swaroopsahoo4908/GTR70E-WYVERN/3D parts/assembly/FIT_REPORT.md

# Fit check report

_Generated by `3D parts/_generator/gen_fit_assembly.py`. Assembly: `GTR70E_WYVERN_fit_assembly.step`. Render: `Documentation/diagrams/D6_fit_check.png`._

50 components: every printed part, plus vendor STEP models where a public one exists and datasheet-built models where it does not.

## Interference

No interference faults.

Designed contacts (glands, seats): none

## Tightest radial clearance to the bore (radius 27.4 mm)

| part | outermost radius (mm) | clearance (mm) |
|---|---|---|
| arm_button_6mm | 28.75 | -1.35 |
| arm_led_3mm | 28.54 | -1.14 |
| pololu_2810_switch | 27.30 | 0.10 |
| lipo_2S_450 | 26.22 | 1.18 |
| servo_horn_az0 | 25.87 | 1.53 |
| servo_horn_az90 | 25.87 | 1.53 |
| servo_horn_az180 | 25.87 | 1.53 |
| servo_horn_az270 | 25.87 | 1.53 |
| EMAX_ES9251II_az0 | 24.93 | 2.47 |
| EMAX_ES9251II_az90 | 24.93 | 2.47 |

## Control fins swept about the hinge

| deflection | overlap with tube / stabilizers |
|---|---|
| -15° | 0.0 mm³ |
| -10° | 0.0 mm³ |
| -5° | 0.0 mm³ |
| +5° | 0.0 mm³ |
| +10° | 0.0 mm³ |
| +15° | 0.0 mm³ |

## Print bed (256 x 256 x 256 mm)

| part | bounding box (mm) | fits |
|---|---|---|
| 01_nose_tangent_ogive_150_ASAAero | 185.0 x 58.0 x 58.0 | yes |
| 02_recovery_bay_tube_ASAAero | 250.0 x 58.0 x 58.0 | yes |
| 03_rb_floor_coupler_PCFR | 54.4 x 54.4 x 40.0 | yes |
| 04_control_tube_servo_ring_ASAAero | 174.0 x 58.0 x 58.0 | yes |
| 05_spine_deck_PETGCF | 54.4 x 54.4 x 5.5 | yes |
| 05b_avionics_spine_PETGCF | 97.0 x 54.4 x 54.4 | yes |
| 06_servo_hub_PETGCF_x4 | 13.0 x 13.0 x 10.2 | yes |
| 07_motor_bay_tube_ASAAero | 139.0 x 58.0 x 58.0 | yes |
| 08_plenum_bulkhead_PCFR | 54.4 x 54.4 x 26.0 | yes |
| 09_motor_mount_tube_aft_ring_PCFR | 87.0 x 54.4 x 54.4 | yes |
| 10_motor_retainer_cap_PCFR | 62.4 x 62.4 x 11.0 | yes |
| 12_rect_fin_PETGCF_x4 | 81.0 x 24.5 x 24.5 | yes |
| 13_rail_button_1010_printed_PETGCF_x2 | 14.9 x 14.0 x 12.7 | yes |
| 14_bypass_tube_PCFR | 200.0 x 9.5 x 9.5 | yes |
| WTA_calibration_pulley_bracket_PETG | 70.0 x 40.0 x 30.0 | yes |
| WTA_calibration_pulley_wheel_PETG | 30.0 x 30.0 x 6.0 | yes |
| WTA_diffuser_100sq_to_6in_round_PETG | 190.0 x 158.4 x 158.4 | yes |
| WTA_hub_gear40_m1_PETGCF | 42.0 x 42.0 x 22.6 | yes |
| WTA_inclined_manometer_lid_PETG | 44.0 x 44.0 x 16.0 | yes |
| WTA_inclined_manometer_ramp_PETG | 242.0 x 44.0 x 32.0 | yes |
| WTA_reflection_plane_wall_panel_PETG | 175.0 x 100.0 x 4.0 | yes |
| WTA_sensor_gear20_m1_PETGCF | 21.8 x 21.8 x 9.0 | yes |
| WTA_servo_balance_cradle_PETG | 90.0 x 59.1 x 33.3 | yes |
| WTB_slot_plug_x8_PETG | 30.0 x 5.6 x 2.4 | yes |
| WTB_stabilizer_blade_span20_PETGCF_x4 | 81.0 x 22.0 x 2.4 | yes |
| WTB_stabilizer_blade_span30_PETGCF_x4 | 81.0 x 32.0 x 2.4 | yes |
| WTB_stabilizer_blade_span40_PETGCF_x4 | 81.0 x 42.0 x 2.4 | yes |
| WTB_stabilizer_tail_section_ASA | 142.0 x 58.0 x 58.0 | yes |
| WT_adapter_228sq_to_200sq_x2_PETG | 228.0 x 228.0 x 12.0 | yes |
| WT_diffuser_200sq_to_8in_round_PETG | 213.0 x 213.0 x 150.0 | yes |
| WT_nose_fairing_ogive100_ASA | 120.0 x 58.0 x 58.0 | yes |
| WT_strut_fairing_ASA | 110.0 x 40.0 x 7.4 | yes |
| WT_tail_fairing_sting_socket_ASA | 100.0 x 58.0 x 58.0 | yes |
| cfin_NACA0006_H20_PETGCF | 60.0 x 18.6 x 10.0 | yes |
| cfin_NACA0006_H25_PETGCF | 60.0 x 23.3 x 10.0 | yes |
| cfin_NACA0006_H30_PETGCF | 60.0 x 27.9 x 10.0 | yes |
| cfin_NACA0006_H35_PETGCF | 60.0 x 32.6 x 10.0 | yes |
| cfin_NACA0006_H40_PETGCF | 60.0 x 37.2 x 10.0 | yes |
| cfin_NACA0006_H45_PETGCF | 60.0 x 41.9 x 10.0 | yes |

## Where each bought-part model came from

| component | source |
|---|---|
| control_fin_az0 | printed |
| control_fin_az90 | printed |
| control_fin_az180 | printed |
| control_fin_az270 | printed |
| EMAX_ES9251II_az0 | datasheet-built (18.02 x 7.91 x 16.8, ears 25.4, VERIFY) |
| servo_horn_az0 | datasheet-built (single-arm horn, in hub pocket) |
| EMAX_ES9251II_az90 | datasheet-built (18.02 x 7.91 x 16.8, ears 25.4, VERIFY) |
| servo_horn_az90 | datasheet-built (single-arm horn, in hub pocket) |
| EMAX_ES9251II_az180 | datasheet-built (18.02 x 7.91 x 16.8, ears 25.4, VERIFY) |
| servo_horn_az180 | datasheet-built (single-arm horn, in hub pocket) |
| EMAX_ES9251II_az270 | datasheet-built (18.02 x 7.91 x 16.8, ears 25.4, VERIFY) |
| servo_horn_az270 | datasheet-built (single-arm horn, in hub pocket) |
| bno085 | vendor STEP adafruit_4754_bno085.step |
| pico2w | datasheet-built 51 x 21 mm Pico 2 W (Raspberry Pi datasheet) |
| bme688 | vendor STEP adafruit_5046_bme688.step |
| bmp388 | vendor STEP adafruit_5046_bme688.step (same outline as the 3966) |
| microsd | vendor STEP adafruit_4682_microsd.step |
| lipo_2S_450 | datasheet-built 57 x 30 x 14 (VERIFY on the owned pack) |
| perfboard_16x62 | datasheet-built FR4 0.1 in perf |
| adafruit_MPM3610_buck | vendor STEP adafruit_4739 (Adafruit_CAD_Parts), logic rail |
| adafruit_MPM3610_buck_servo | vendor STEP adafruit_4739, servo rail (rev 3f) |
| cap_470uF_under_board | datasheet-built 6.3 x 11 mm, under the perfboard |
| pololu_2810_switch | vendor STEP pololu_2810, in the CT wall cradle under the slot |
| arm_button_6mm | datasheet-built 6 x 6 tactile (Adafruit 367), plunger 0.3 mm under the skin |
| arm_led_3mm | datasheet-built 3 mm LED (SparkFun COM-00533) |
| AeroTech_F42-4T | datasheet-built 29 x 83 mm (thrustcurve.org) |
| chute_24in_packed | datasheet-built (Estes 24 in rip-stop, packed 46 x 95, VERIFY) |
| shock_cord_bundle | datasheet-built 19 ft aramid, z-folded |
| nose_ballast_pour | 253 g steel shot + epoxy, fills 66 mm of the tip |

Nose ballast (253 g steel shot + epoxy at ~5 g/cm³) fills the first 66 mm of the tip cavity.
