swaroopsahoo4908/GTR70E-WYVERN/Documentation/CANONICAL_NUMBERS.md

# GTR70E WYVERN fin-control — canonical numbers

_Generated by `Documentation/gen_canonical_md.py` from the simulation outputs. Do not edit by hand; re-run the cascade (root README)._

## Vehicle

| | value |
|---|---|
| Overall length / OD | 693 mm / 58 mm |
| Sections | nose 150 · recovery bay 250 · control tube 174 · motor bay 119 mm |
| Liftoff / burnout (F42-4T) | 785 g / 758 g |
| Printed parts / ballast | 289 g / 253 g |
| CG liftoff / burnout | 338 / 327 mm |
| CP (interference counted) | 422 mm |
| Static margin liftoff / burnout | 1.44 / 1.63 cal (no interference: 1.63) |
| Pitch inertia | 0.0501 kg m² |
| Control hinge A / B (station) | 534 / 534 mm; arm aft of CG 196 / 196 mm |
| Control fins | triangular, root 60 mm, hinge 45 % chord, H* = 45 mm, ±15° |
| Stabilizers (fixed fins) | 4 x 81 x 20 x 2.4 mm at 45° |
| Servo | EMAX ES9251 II, base r = 5.0 mm, spline tip r = 24.8 mm |
| Bypass tube | 9.5 x 7.5 mm printed PC-FR, 200 mm, 6.4 g, on the vehicle centreline |

## Flight (F42-4T, 4 m/s wind + 4 m/s gust)

| | control on | fins locked |
|---|---|---|
| Rail exit speed (6 ft) | 15.0 m/s | 15.0 m/s |
| Burnout speed | 53 m/s | 53 m/s |
| Max q | 1808 Pa | 1824 Pa |
| Apogee | 176 m | 174 m |
| Time to apogee | 6.34 s | 6.32 s |
| RMS tilt rail exit → burnout+2 s | 0.6° | 10.8° |
| Max tilt | 1.3° | 16.0° |
| Drift at apogee | 19 m | -15 m |
| Peak hinge moment | 0.002 N m | 0.004 N m |

T/W 4.68 avg / 8.45 peak · ideal delay 4.87 s → pick 4 s · gains {'kp': 4.5, 'ki': 1.0, 'kd': 0.8, 'q_ref': 1500.0, 'k_min': 0.15, 'k_max': 4.0}

## Motor options (all 29 x 83 mm single-use, no certification)

| motor | impulse (N s) | liftoff (g) | rail exit (m/s) | apogee (m) | RMS tilt on / locked | delay pick | cost note |
|---|---|---|---|---|---|---|---|
| F67-6W | 61.1 | 789 | 17.9 | 232 | 0.7° / 7.9° | 6 s | $49.49 per 2-pack (eRockets, mailable, no hazmat) -> 4 motors $98.98 |
| F42-4T | 52.9 | 785 | 15.0 | 176 | 0.6° / 10.8° | 4 s | New Century $43.99 was sold out) -> 4 motors $98.98 |
| G74-6W | 82.8 | 796 | 17.2 | 370 | 0.8° / 7.3° | 9 s | price not found online (reference only) |

## Control authority (NACA 0006, pessimistic interference)

| H (mm) | interference | Cmδ isolated | Cmδ installed A | Cmδ installed B | RMS tilt (sim) |
|---|---|---|---|---|---|
| 15 | -0.188 | 1.88 | 1.38 | 1.38 | 0.1° |
| 20 | -0.168 | 3.23 | 2.46 | 2.46 | 0.3° |
| 25 | -0.150 | 4.81 | 3.78 | 3.78 | 0.4° |
| 30 | -0.135 | 6.57 | 5.30 | 5.30 | 0.5° |
| 35 | -0.121 | 8.47 | 6.99 | 6.99 | 0.5° |
| 40 | -0.109 | 10.48 | 8.83 | 8.83 | 0.5° |
| 45 | -0.099 | 12.58 | 10.79 | 10.79 | 0.5° |
| 50 | -0.089 | 14.74 | 12.84 | 12.84 | 0.5° |

Selection: {'H_star_open_loop': 40.0, 'H_star_closed_loop': 20.0, 'flight_heights': [35.0, 40.0, 45.0], 'monotonic': True}

## Electronics

| | |
|---|---|
| Pad idle / flight current | 73 mA / 306 mA |
| Mission charge / derated requirement / pack | 35.4 / 65 / 450 mAh (6.9x) |
| Telemetry | none in flight (rev 4): microSD (Adafruit 4682 on the Pico 2 W) is the only record; USB CSV on the pad |

## Ejection (chosen tube)

0.3 g BP: bay 178 kPa → 419 N push vs 235 N release; plenum 1413 kPa, kick-out 933 N

0.5 g BP: bay 337 kPa → 796 N push vs 235 N release; plenum 2443 kPa, kick-out 1613 N

## SQ1: stabilizer span and azimuth (H = 40, F42-4T, pessimistic interference)

| offset | span (mm) | margin liftoff (cal) | interference | installed / isolated | RMS tilt active / locked |
|---|---|---|---|---|---|
| 0° | 20 | 1.10 | -0.245 | 0.65 | 0.5° / 10.8° |
| 22.5° | 20 | 1.34 | -0.144 | 0.79 | 0.5° / 11.2° |
| 45° | 0 | 0.98 | 0.000 | 1.00 | 0.2° / 9.5° |
| 45° | 20 | 1.44 | -0.099 | 0.86 | 0.5° / 11.3° |
| 45° | 30 | 1.88 | -0.176 | 0.74 | 1.0° / 12.9° |
| 45° | 40 | 2.32 | -0.246 | 0.64 | 4.3° / 13.6° |
| 45° | 45 | 2.52 | -0.275 | 0.60 | 6.9° / 13.8° |
| 45° | 50 | 2.69 | -0.299 | 0.56 | 9.1° / 14.2° |
| 45° | 55 | 2.85 | -0.320 | 0.53 | 11.0° / 14.6° |
| 45° | 60 | 2.98 | -0.338 | 0.50 | 12.6° / 15.1° |

Tunnel Phase B prediction (one pair at 10°, 7 m/s): H35 off 37.1 mN, span20 32.6 mN, span30 29.3 mN, span40 26.6 mN; H40 off 45.1 mN, span20 40.1 mN, span30 36.4 mN, span40 33.2 mN; H45 off 53.4 mN, span20 48.1 mN, span30 43.9 mN, span40 40.2 mN
