swaroopsahoo4908/GTR70E-WYVERN/TVC ARCHIVED/Past Iterations/WYVERN-E 1.0/Wind Tunnel/WYVERN_wind_tunnel_spec.html.pdf.md

---
source_file: "WYVERN_wind_tunnel_spec.html.pdf"
source_type: "PDF"
updated_at: 2026-05-26
---
# WYVERN_wind_tunnel_spec.html

*Extracted from [[WYVERN_wind_tunnel_spec.html.pdf]]*

---

S K Y L I G H T I N D U S T R I E S L LC · C O N F I D E N T I A L · P R O P R I E TA RY · N O T F O R D I S T R I B U T I O N

    XRIM-117 WYVERN PTD — Dedicated Aerodynamic Ground Test
    Facility
    Open-return low-speed wind tunnel · Full 3D-printed · Designed for 1:3 scale PTD PDR-002 Rev A test articles

    Programme: PDR-002 Rev A                 Test scale: 1:3 geometric             Fan: AC Infinity Cloudline T8             Contraction: 9:1

    Test section: 150 × 150 × 500 mm                 OAL: 2,468 mm

        Overview             Module specs               Aerodynamics                Contraction profile                Print plan         BOM & cost

    C R ITI C A L D I M E N S I O N S

       Test section (H × W × L)                               Test section area                                       Contraction ratio

       150 × 150 × 500 mm                                     225 cm²                                                 9 : 1

       Settling chamber                                       Test section velocity                                   Dynamic pressure q

       450 × 450 mm                                           7.3 m/s (24 ft/s)                                       33.0 Pa

       Fan                                                    Flow rate (loaded est.)                                 Contraction cone length

       AC Infinity T8 (200 mm)                                350 CFM / 0.165 m³·s⁻¹                                  900 mm

       Diffuser length                                        Full tunnel OAL                                         Wall thickness (all modules)

       220 mm (4° half-angle)                                 2,468 mm (2.47 m)                                       3.0 mm PETG-CF

       Module OD                                              Junction ring OD                                        Honeycomb cell

       156 × 156 mm                                           176 mm                                                  4 mm hex, L/d = 7

       Screen set                                             Smoke ports                                             Bell-mouth lip radius

       20-mesh + 80-mesh                                      3 × 3 grid, 50 mm pitch                                 180 mm
       stainless

       Est. turbulence intensity                              Total print mass                                        Estimated filament cost

       ~0.21 %                                                ~4,109 g (4.1 kg)                                       ~$115 USD

    T U N N E L L AYO U T — S I D E E L EVATI O N

             Bell   Cond.
                        Contraction 900mm Test section 500mm Diff.Fan

                                                                                                                                                     exhaust

          100 mm

Explore our developer-friendly HTML to PDF API                                                                       Printed using PDFCrowd            HTML to PDF

    B LO C K AG E S U M M A RY ( 1 : 3 S C A L E M O D E L , 1 5 0 × 1 5 0 M M T E ST S E C TI O N )

      TEST ARTICLE                                                  FRONTAL AREA                BLOCKAGE         STATUS

      Nose cone on sting (body only)                                4.28 cm²                    1.9 %              No correction

      Single fin panel — half-span wall mount                       5.44 cm²                    2.4 %              No correction

      Ring 2 assembly + body stub                                   6.97 cm²                    3.1 %              No correction

      Ring 1 assembly + body stub                                   15.17 cm²                   6.7 %              Maskell correction

      Full rocket, 0° AoA (both rings)                              17.82 cm²                   7.9 %              Maskell correction

      Full rocket, 45° roll                                         ~23.6 cm²                   ~10.5 %            Visualization only

       The 150 × 150 mm test section resolves the primary limitation of the source STEM tunnel (80 × 130 mm, 37%
       blockage at 1:1). The full-rocket at 0° AoA now sits at 7.9% — within the Maskell-correctable range. At 1:3 scale,
       body OD = 23.3 mm, Ring 1 fin span = 23.3 mm, OAL = 390 mm.

Explore our developer-friendly HTML to PDF API                                                         Printed using PDFCrowd           HTML to PDF
