swaroopsahoo4908/GTR70E-WYVERN/TVC ARCHIVED/Flight Computer/02_RRC3_Telemetry_Logging.md

# GTR70E WYVERN, Recovery Telemetry

Recovery runs entirely on the F15-4 motor's own ejection charge, separating the two body tubes at
the bulkhead joint — see `Documentation/WYVERN_E4_Recovery.md`. There is no altimeter, no e-match,
no black-powder charge of our own, and no CO2 system. The flight computer does not actuate recovery
at all; it only logs baro/IMU through the event and streams WiFi telemetry.

*(This file is retained as a redirect; the storage mount blocks deletion from the tool sandbox.)*
