swaroopsahoo4908/GTR70E-WYVERN/TVC ARCHIVED/Flight Computer/_All Files.md

---
updated_at: 2026-08-02
---
# Flight Computer, All Files

*Auto-generated index, every file and subfolder linked for vault graph connectivity.*

---

## Subfolders

- [[Projects/Skylight/WYVERN/GTR70E WYVERN/WYVERN Project/Flight Computer/BOM/_All Files.md|BOM/]]
- [[Projects/Skylight/WYVERN/GTR70E WYVERN/WYVERN Project/Flight Computer/firmware/_All Files.md|firmware/]]
- [[Projects/Skylight/WYVERN/GTR70E WYVERN/WYVERN Project/Flight Computer/flowcharts/_All Files.md|flowcharts/]]
- [[Projects/Skylight/WYVERN/GTR70E WYVERN/WYVERN Project/Flight Computer/ground_test_rigs/_All Files.md|ground_test_rigs/]]
- [[Projects/Skylight/WYVERN/GTR70E WYVERN/WYVERN Project/Flight Computer/test_code/_All Files.md|test_code/]]
- [[Projects/Skylight/WYVERN/GTR70E WYVERN/WYVERN Project/Flight Computer/wiring/_All Files.md|wiring/]]

## Files

- [[Projects/Skylight/WYVERN/GTR70E WYVERN/WYVERN Project/Flight Computer/01_FlightComputer_Spec.md]]
- [[Projects/Skylight/WYVERN/GTR70E WYVERN/WYVERN Project/Flight Computer/02_RRC3_Telemetry_Logging.md]]
- [[Projects/Skylight/WYVERN/GTR70E WYVERN/WYVERN Project/Flight Computer/README.md]]
