swaroopsahoo4908/GTR70E-WYVERN/TVC ARCHIVED/Flight Computer/flowcharts/_All Files.md

---
updated_at: 2026-08-02
---
# flowcharts, All Files

*Auto-generated index, every file and subfolder linked for vault graph connectivity.*

---

## Files

- [[Projects/Skylight/WYVERN/GTR70E WYVERN/WYVERN Project/Flight Computer/flowcharts/01_flight_state_machine.mermaid]]
- [[Projects/Skylight/WYVERN/GTR70E WYVERN/WYVERN Project/Flight Computer/flowcharts/02_tvc_control_loop.mermaid]]
- [[Projects/Skylight/WYVERN/GTR70E WYVERN/WYVERN Project/Flight Computer/flowcharts/03_recovery_logic.mermaid]]
- [[Projects/Skylight/WYVERN/GTR70E WYVERN/WYVERN Project/Flight Computer/flowcharts/04_power_tree.mermaid]]
