swaroopsahoo4908/GTR70E-WYVERN/TVC ARCHIVED/Past Iterations/WYVERN-E 1.0/_All Files.md

---
updated_at: 2026-07-30
---
# WYVERN-E 1.0 — All Files

*Auto-generated index — every file in this folder linked for vault graph connectivity (re-index pass, 2026-07-30).*

---

## Linked Items (auto-added)

- [[Projects/Skylight/WYVERN/Past Iterations/WYVERN-E 1.0/CAD:Models:PCB/_All Files.md]]
- [[Projects/Skylight/WYVERN/Past Iterations/WYVERN-E 1.0/Docs:Decks/_All Files.md]]
- [[Projects/Skylight/WYVERN/Past Iterations/WYVERN-E 1.0/README.md]]
- [[Projects/Skylight/WYVERN/Past Iterations/WYVERN-E 1.0/Simulations/_All Files.md]]
- [[Projects/Skylight/WYVERN/Past Iterations/WYVERN-E 1.0/Wind Tunnel/_All Files.md]]
- [[Projects/Skylight/WYVERN/Past Iterations/WYVERN-E 1.0/_OLD FILES/_All Files.md]]
