swaroopsahoo4908/GTR70E-WYVERN/TVC ARCHIVED/Past Iterations/WYVERN-E-Old PCB/Info_PCB_PCB1_2026-08-08.txt

Project Title: 		WYVERN-E
Borard Title: 		Board1
PCB Title: 		PCB1
Time: 		2026-08-08 22:19:53

Borard Size: 		90mm x 90mm
Layers: 		Total 24, Copper 4

Devices: 		55
Footprints: 		38
Components: 		Total 107,Top Layer 107,Bottom Layer 0
Pads: 		Total 595, Top Side Table Stick 526,Bottom Side Table Stick 0,Metallized Hole 69, Nonmetallic Hole 0
Nets: 		Total 108, Unrouted 0
Test Point: 		Nets Total 108, Has Testpoint Nets 0, Testpoint Coverage 0%
 		Total 0, Top Side Testpoints 0, Bottom Side Testpoints 0

Slot Region: 		5
Vias: 		Total 260, Through Vias 260, Blind Or Buried Vais 0
CopperAreas: 		0
Length of Tracks: 		5405.554mm
