swaroopsahoo4908/GTR70E-WYVERN/TVC ARCHIVED/Past Iterations/WYVERN-E-Old PCB/Info_PCB_PCB1_2026-08-09.txt

Project Title: 		WYVERN-E 1.0
Borard Title: 		Board1
PCB Title: 		PCB1
Time: 		2026-08-09 11:48:04

Borard Size: 		60mm x 60mm
Layers: 		Total 22, Copper 2

Devices: 		29
Footprints: 		23
Components: 		Total 39,Top Layer 39,Bottom Layer 0
Pads: 		Total 266, Top Side Table Stick 227,Bottom Side Table Stick 0,Metallized Hole 39, Nonmetallic Hole 0
Nets: 		Total 38, Unrouted 0
Test Point: 		Nets Total 38, Has Testpoint Nets 0, Testpoint Coverage 0%
 		Total 0, Top Side Testpoints 0, Bottom Side Testpoints 0

Slot Region: 		4
Vias: 		Total 86, Through Vias 86, Blind Or Buried Vais 0
CopperAreas: 		0
Length of Tracks: 		1452.842mm
