swaroopsahoo4908/GTR70E-WYVERN/TVC ARCHIVED/Past Iterations/WYVERN-E-Old PCB/Info_PCB_PCB1_2026-08-11.txt

Project Title: 		GTR70E WYVERN 1.0
Borard Title: 		Board1
PCB Title: 		PCB1
Time: 		2026-08-11 23:46:51

Borard Size: 		61mm x 61mm
Layers: 		Total 22, Copper 2

Devices: 		33
Footprints: 		26
Components: 		Total 61,Top Layer 61,Bottom Layer 0
Pads: 		Total 315, Top Side Table Stick 277,Bottom Side Table Stick 0,Metallized Hole 38, Nonmetallic Hole 0
Nets: 		Total 49, Unrouted 0
Test Point: 		Nets Total 49, Has Testpoint Nets 0, Testpoint Coverage 0%
 		Total 0, Top Side Testpoints 0, Bottom Side Testpoints 0

Slot Region: 		8
Vias: 		Total 150, Through Vias 150, Blind Or Buried Vais 0
CopperAreas: 		0
Length of Tracks: 		2254.998mm
