swaroopsahoo4908/GTR70E-WYVERN/TVC ARCHIVED/Past Iterations/WYVERN-E 1.0/CAD:Models:PCB/_All Files.md

---
updated_at: 2026-05-27
---
# CAD:Models:PCB — All Files

*Complete index of all files in `Projects/WYVERN-E/CAD:Models:PCB/`. Auto-generated — every file [[wikilinked]] for Obsidian graph connectivity.*

---

**Total files: 11**

## PDF Documents (2)

- [[WYVERN_Engineering_Analysis.pdf]] → [[WYVERN_Engineering_Analysis.pdf.md]]
- [[XRIM117_PCB_Layouts_html.pdf]] → [[XRIM117_PCB_Layouts_html.pdf.md]]

## Markdown Notes (3)

- [[WYVERN_Engineering_Analysis.pdf.md]]
- [[WYVERN_Simulator.md]]
- [[XRIM117_PCB_Layouts_html.pdf.md]]

## HTML Files (1)

- [[XRIM117_PCB_Layouts.html]]

## SVG Images (2)

- [[xrim117_avionics_v4.svg]]
- [[xrim117_jetavane_tvc.svg]]

## ZIP Archives (1)

- [[XRIM117_all_parts.zip]]

## ORK Files (1)

- [[XRIM117_PTD_PDR002_70mm.ork]]

## STL Files (1)

- [[XRIM117_PTD_PDR002_70mm.stl]]

## Linked Items (auto-added)

- [[Projects/Skylight/WYVERN/Past Iterations/WYVERN-E 1.0/CAD:Models:PCB/CCM_KiCAD/_All Files.md]]
- [[Projects/Skylight/WYVERN/Past Iterations/WYVERN-E 1.0/CAD:Models:PCB/XRIM117E_KiCAD_RevC/_All Files.md]]
- [[Projects/Skylight/WYVERN/Past Iterations/WYVERN-E 1.0/CAD:Models:PCB/XRIM117E_PDR003_127mm.ork]]
- [[Projects/Skylight/WYVERN/Past Iterations/WYVERN-E 1.0/CAD:Models:PCB/XRIM117E_PDR003_127mm_F15.ork]]
- [[Projects/Skylight/WYVERN/Past Iterations/WYVERN-E 1.0/CAD:Models:PCB/XRIM117E_PDR003_127mm_FLIGHT.ork]]
- [[Projects/Skylight/WYVERN/Past Iterations/WYVERN-E 1.0/CAD:Models:PCB/XRIM117E_PDR004_FULL.ork]]
- [[Projects/Skylight/WYVERN/Past Iterations/WYVERN-E 1.0/CAD:Models:PCB/XRIM117E_PDR004_TVC_ONLY.ork]]
- [[Projects/Skylight/WYVERN/Past Iterations/WYVERN-E 1.0/CAD:Models:PCB/XRIM117E_booster_cluster_ring_3x29mm.stl]]
- [[Projects/Skylight/WYVERN/Past Iterations/WYVERN-E 1.0/CAD:Models:PCB/XRIM117E_camera_pod_fairing.stl]]
- [[Projects/Skylight/WYVERN/Past Iterations/WYVERN-E 1.0/CAD:Models:PCB/XRIM117_EasyEDA_v3/_All Files.md]]
- [[Projects/Skylight/WYVERN/Past Iterations/WYVERN-E 1.0/CAD:Models:PCB/XRIM117_KiCAD_RevB/_All Files.md]]
- [[Projects/Skylight/WYVERN/Past Iterations/WYVERN-E 1.0/CAD:Models:PCB/XRIM117_PCB_Layouts.html]]
- [[Projects/Skylight/WYVERN/Past Iterations/WYVERN-E 1.0/CAD:Models:PCB/XRIM117_PTD_PDR002_70mm.ork]]
- [[Projects/Skylight/WYVERN/Past Iterations/WYVERN-E 1.0/CAD:Models:PCB/XRIM117_PTD_PDR002_70mm.stl]]
- [[Projects/Skylight/WYVERN/Past Iterations/WYVERN-E 1.0/CAD:Models:PCB/XRIM117_all_parts.zip]]
- [[Projects/Skylight/WYVERN/Past Iterations/WYVERN-E 1.0/CAD:Models:PCB/XRIM117_all_parts/_All Files.md]]
- [[Projects/Skylight/WYVERN/Past Iterations/WYVERN-E 1.0/CAD:Models:PCB/_All Files.md]]
