swaroopsahoo4908/GTR70E-WYVERN/TVC ARCHIVED/Past Iterations/WYVERN-E 1.0/Docs:Decks/XRIM117_PTD_PDR002_RevA_70mm.docx.md

---
source_file: "XRIM117_PTD_PDR002_RevA_70mm.docx"
source_type: "DOCX"
updated_at: 2026-05-26
---
# XRIM117_PTD_PDR002_RevA_70mm

*Extracted from [[XRIM117_PTD_PDR002_RevA_70mm.docx]]*

---

**XRIM-117 WYVERN**

EXTENDED CALIBER PROTOTYPE TECHNOLOGY DEMONSTRATOR

**PDR-002 \| Revision A**

*70mm Rail-Launch Guided Demonstrator*

TVC + Active Mid Fins + Passive Aft Stabilizers + 3-PCB Distributed Avionics + 915MHz Datalink

**Skylight Industries LLC**

**CONFIDENTIAL --- PROPRIETARY --- NOT FOR DISTRIBUTION**

1\. Overview & Design Philosophy

The XRIM-117 WYVERN Extended Caliber Prototype Technology Demonstrator (PDR-002 Rev A) is a 70mm-diameter, rail-launch experimental rocket developed by Skylight Industries LLC to validate the core aeromechanical and guidance architecture of the full-scale XRIM-117 WYVERN interceptor at a scale larger and more capable than the 56mm PDR-001 platform.

The vehicle is designed exclusively for 1010/80-20 aluminum extrusion rail launch in near-vertical orientation. Rail launch provides controlled guidance through the low-speed boost phase and eliminates the complexity of pod integration, keeping the initial development program focused on the avionics, TVC, and active fin control objectives.

In lieu of a warhead section the demonstrator carries a parachute recovery bay in the forward fuselage. The flight profile demonstrates: rail launch, boost, controlled ascent to target altitude, loiter on a sustainer motor, and a powered vertical-descent landing --- guided by TVC and an active mid fin ring, with a passive aft stabilizer ring providing baseline aerodynamic stability.

1.1 Key Demonstrator Specifications
-----------------------------------

  ---------------------------- ---------------------------------------------------------------------------------------------------------------------------------------------
  **Designation**              XRIM-117 PTD PDR-002 Rev A
  **Organization**             Skylight Industries LLC
  **Scale Factor**             1:2.14 from 150mm full-scale (70mm OD body tube)
  **Body Tube**                70mm OD / 68mm ID phenolic or fiberglass, Cesseroni-compatible diameter
  **OAL**                      \~1,170mm
  **Fin Configuration**        2× rings of 4 fins (Ring 2 all-moving, Ring 1 fixed) --- Ring 2 mid active fins (4, all-moving) + Ring 1 aft passive stabilizers (4, fixed)
  **Propulsion**               2-stage: 29mm booster (ejected) + 38mm sustainer (TVC-gimballed)
  **TVC Authority**            [±]{dir="rtl"}8° nozzle deflection, 2-axis cross-flexure gimbal
  **Active Fin Deflection**    [±]{dir="rtl"}25° per Ring 2 mid fin, individually servo-actuated on 7.4V HV (4 active fins). Ring 1 aft fins are passive (0° fixed).
  **Launch Mode**              1010/80-20 aluminum extrusion rail, 1.83m (6ft), near-vertical (85--90°)
  **Primary Structure**        PETG-CF 20% CF FDM printed, 3--4 perimeter walls
  **Avionics**                 3× custom 62mm circular PCBs: CCM (central) + ASAM-1 (mid fins) + ASAM-2 (TVC + sustainer relay; aft fins are passive)
  **Servo Spec (all)**         KST X08 Plus HV --- 7 total (4 mid fins + 2 TVC jetavane axes + 1 ceramic insert slide). Ring 1 aft fins are passive --- no servos.
  **Antenna**                  915MHz quarter-wave monopole on CCM, SMA pigtail, routed through tube wall
  **Recovery**                 Computer-triggered ejection charge, nose cone separation, 24in main chute
  **Datalink**                 915MHz LoRa --- Ebyte E22-900M22S, 22dBm, \~2km LoS
  **Target Altitude**          \~90--150m AGL (field-dependent)
  **Landing Mode**             Powered vertical descent, TVC + active fins
  **Total Mass (est.)**        \~620--680g all-up weight
  **Unit Build Cost (est.)**   \~\$525 USD (incl. PCB fab + SMT assembly; reduced from \$577 after removing 4 aft fin servos)
  ---------------------------- ---------------------------------------------------------------------------------------------------------------------------------------------

1.2 Dimensional Scaling Rationale
---------------------------------

Scale factor k = 150mm / 70mm OD = 2.14. Scaled OAL = 2,500mm / 2.14 = 1,168mm (\~1,170mm with rail button standoffs). Scaled fin root chord aft ring = 200mm / 2.14 = 93mm. Scaled fin span aft ring = 150mm / 2.14 = 70mm. Scaled mid fin root chord = 100mm / 2.14 = 47mm.
-----------------------------------------------------------------------------------------------------------------------------------------------------------------------------------------------------------------------------------------------------------------------------

⚑ *All fin dimensions rounded to nearest 1mm for printability. Airfoil profile is a double-wedge at 4% t/c ratio. The 70mm body tube\'s internal 68mm ID gives 15mm radial clearance around the 38mm sustainer motor mount --- this annular space is the servo and gimbal bay.*
-------------------------------------------------------------------------------------------------------------------------------------------------------------------------------------------------------------------------------------------------------------------------------

2\. Airframe & Structure

2.1 Body Tube
-------------

  ------------------------ ---------------------------------------------------------------------------------------------------------------------------------------------------------------------------------------------------------------------------------------------------------------
  **Body Tube Material**   PETG-CF 20% CF printed outer shell (2.4mm wall, 4 perimeter walls) bonded over 70mm OD / 68mm ID phenolic liner for structural backbone. Fin cans, centering rings, nose cone, TVC frame: all PETG-CF. Avionics sled, nose bay: PLA where heat not a concern.
  **Wall Thickness**       \~1.6mm nominal
  **OD**                   70.0mm
  **OAL (3 sections)**     \~1,170mm total
  **Forward Section**      \~270mm --- Nose cone bay + chute bay
  **Mid Section**          \~490mm --- CCM avionics sled + ASAM-1 + mid fin ring
  **Aft Section**          \~410mm --- ASAM-2 + sustainer motor + TVC gimbal + aft fin ring + booster
  **Section Coupling**     PETG-CF centering rings + 4× M3 nylon-tipped set screws per joint
  **Rail Interface**       2× 1010-profile rail buttons on aft section, 70mm OD compatible
  ------------------------ ---------------------------------------------------------------------------------------------------------------------------------------------------------------------------------------------------------------------------------------------------------------

2.2 Nose Cone
-------------

  ------------------------ --------------------------------------------------------------------
  **Profile**              Von Karman ogive (Haack LV series)
  **Length**               234mm (500mm / 2.14)
  **Base Diameter**        70.0mm (flush with body tube OD)
  **Shoulder Length**      35mm slip-fit into forward section
  **Retention**            2× 3mm HDPE shear pins at 180° --- shear at 55--70N
  **Ejection Interface**   Aft face sealed; ejection charge vents into chute bay
  **Material**             PETG-CF 20% CF, 0.25mm layer height, 40% gyroid infill, 2.4mm wall
  ------------------------ --------------------------------------------------------------------

2.3 Fin Assemblies
------------------

### 2.3.1 Aft Stabilizer Ring --- Ring 1 (Passive, Fixed)

### Four fixed fins at the aft end of the aft section provide baseline aerodynamic stability in the yaw/pitch plane. Each fin is bonded directly into a radial slot in the PETG-CF aft fin can --- no servo, no hinge, no pivot pin. The fin roots are captured at 90° spacing around the motor tube by an epoxy bond line plus mechanical interlock geometry, freeing the annular space that previously held servo pockets for use by the TVC gimbal and wiring harness. Roll and primary pitch/yaw authority move entirely to Ring 2 and the jetavane TVC.

  ------------------------- ----------------------------------------------------------------------------
  **Quantity**              4, equally spaced at 90°
  **Root Chord**            93mm
  **Tip Chord**             47mm (tapered)
  **Span (from body)**      70mm
  **Leading Edge Sweep**    45°
  **Profile**               Double-wedge, 4% t/c, PETG-CF
  **Servo**                 None --- fixed bonded root (no actuator)
  **Servo Supply**          N/A --- fins are passive
  **Pivot Axis**            None --- fin root epoxy-bonded + mechanical interlock into PETG-CF fin can
  **Max Deflection**        0° (fixed)
  **Fin-Servo Clearance**   N/A --- annular bay freed; now used for TVC gimbal + harness routing
  **Thermal Shield**        0.2mm aluminum foil tape on PETG-CF fin can facing nozzle exit (unchanged)
  ------------------------- ----------------------------------------------------------------------------

### 

### 2.3.2 Mid Control Ring --- Ring 2 (Canard Position)

### Four all-moving fins positioned \~400mm forward of the aft fin ring provide primary pitch/yaw control authority at speed. Clocked 45° to Ring 1. Each fin is individually driven by a KST X08 Plus HV servo in the PETG-CF fin root housing in the mid-section body tube.

  ------------------------ -------------------------------------------------
  **Quantity**             4, equally spaced at 90°, clocked 45° to Ring 1
  **Root Chord**           47mm
  **Tip Chord**            23mm
  **Span (from body)**     35mm
  **Leading Edge Sweep**   40°
  **Servo**                KST X08 Plus HV --- 8g, ≥3.85 kg·cm @ 6V ×4
  **Servo Supply**         7.4V HV rail from ASAM-1 MT3608 boost converter
  **Pivot Axis**           50% chord
  **Max Deflection**       [±]{dir="rtl"}25°
  ------------------------ -------------------------------------------------

### 

### ⚑ *All 4 Ring 2 fin servos use identical KST X08 Plus HV units on a 7.4V rail. At this supply voltage each servo produces \~4.5 kg·cm stall torque --- well above the estimated 2.5--3.0 kg·cm peak aerodynamic hinge loads during boost transients at Mach 0.25--0.35.*

2.4 Structural Analysis (Simplified)
------------------------------------

  ---------------------------------------- -----------------------------------------------------------------------
  **Tensile Strength (PETG-CF printed)**   \~48 MPa XY plane, \~32 MPa Z
  **Flexural Modulus**                     \~3.8 GPa
  **Max Service Temp**                     75--85°C continuous (adequate for hobby motor plume proximity)
  **Motor Throat Mitigation**              Phenolic/aluminum motor retainer at nozzle exit; foil tape on fin can
  **Factor of Safety (launch shock)**      \>3.0 estimated at 18g peak axial acceleration
  **Fin flutter onset (est.)**             \>Mach 0.7 for Ring 1 full span --- safe in operational envelope
  ---------------------------------------- -----------------------------------------------------------------------

3\. Propulsion System

Two-stage propulsion. Stage 1 (29mm booster) accelerates the vehicle off the rail. At booster burnout, a delay element fires, the ejection ring ejects the booster casing rearward with a streamer, and the flight computer ignites the Stage 2 sustainer. Stage 2 (38mm sustainer) powers altitude hold, loiter, and the landing burn.

3.1 Stage 1 --- Booster Motor (29mm)
------------------------------------

  ------------------------------------ ------------------------------------------------------------------------------------------
  **Candidate Motor (Nominal)**        Cesaroni F39-6T (29mm, F class, \~6s delay, \~57N peak)
  **Candidate Motor (Conservative)**   Cesaroni F36-7T (29mm, F class, \~7s delay, \~40N peak)
  **Candidate Motor (High Alt.)**      AeroTech F52-5T (29mm, F class, \~5s delay)
  **Total Impulse Range**              80--120 N·s
  **Ejection Charge**                  Actuates booster ejection ring --- fractures HDPE shear pins, spring-ejects motor casing
  **Motor Retention**                  38/29mm reducer + friction fit + forward thrust ring --- no aft retainer (eject design)
  **Casing Recovery**                  900mm Kevlar cord + 500mm × 90mm nylon streamer
  ------------------------------------ ------------------------------------------------------------------------------------------

3.2 Stage 2 --- Sustainer Motor (38mm)
--------------------------------------

  ------------------------------ ------------------------------------------------------------------------
  **Motor Diameter**             38mm
  **Candidate (Nominal)**        AeroTech G76-10G (38mm, G class, \~10s burn, avg 76N, 637 N·s total)
  **Candidate (Conservative)**   AeroTech G54-10W (38mm, \~10s, avg 54N) --- lower T/W, easier TVC loop
  **Candidate (High Alt.)**      AeroTech G79-7W or Cesaroni G88-7 --- shorter burn, higher apogee
  **Avg Thrust to Weight**       \~8--11× vehicle weight --- manageable for TVC stabilization loop
  **Burn Time**                  \~7--10s --- covers loiter and landing burn initiation
  **Motor Retention**            Aeropack 38mm retainer ring threaded into aft PETG-CF motor mount
  **Ignition**                   E-match via ASAM-2 sustainer relay MOSFET, 1.5A firing current
  **Fire Timing**                CCM command at booster ejection + 0.2s
  ------------------------------ ------------------------------------------------------------------------

3.3 TVC Mount Design & Servo Integration
----------------------------------------

The TVC gimbal is the mechanical heart of the aft section. It must simultaneously: (1) gimbal the 38mm sustainer motor [±]{dir="rtl"}8° in pitch and yaw, (2) provide structural support for the motor through boost and loiter, and (3) co-exist in the aft section annulus with the fixed Ring 1 fin roots (bonded into the fin can; no servos). The following describes the physical arrangement.
----------------------------------------------------------------------------------------------------------------------------------------------------------------------------------------------------------------------------------------------------------------------------------------------------------------------------------------------------------------------------------------------------

### 3.3.1 Aft Section Annular Layout
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
