swaroopsahoo4908/GTR70E-WYVERN/TVC ARCHIVED/Past Iterations/WYVERN-E 1.0/Docs:Decks/XRIM117_WYVERN_PitchDeck.pptx.md

---
source_file: "XRIM117_WYVERN_PitchDeck.pptx"
source_type: "PPTX"
updated_at: 2026-05-26
---
# XRIM117_WYVERN_PitchDeck

*Extracted from [[XRIM117_WYVERN_PitchDeck.pptx]]*

---

### Slide 1

PROTOTYPE TECHNOLOGY DEMONSTRATOR

XRIM-117 WYVERN

Autonomous Guided Demonstrator Platform

70mm · Active mid fins + passive aft stabilizers · Ceramic jetavane TVC · 3-board distributed avionics · 915MHz datalink

Skylight Industries LLC  ·  PDR-002 Rev A  ·  CONFIDENTIAL

### Slide 2

MISSION

Why WYVERN?

A hardware-first approach to validating guided autonomous flight control in a subscale, recoverable, repeatably-flyable platform.

70mm

OD

body diameter

10

srvs

total actuators

915

MHz

datalink range

3

PCBs

avionics stack

OBJECTIVES

Programme Objectives

Validate hybrid control architecture

Demonstrate coordinated aerodynamic fin + ceramic jetavane TVC authority across boost, loiter, and landing burn phases.

Prove distributed avionics concept

Three-board redundant-sensor architecture with independent power domains and fault detection.

Demonstrate powered vertical recovery

Full-profile autonomous flight: rail launch → guided ascent → altitude loiter → propulsive landing.

Generate quantitative flight data

Log 100Hz sensor fusion data via 915MHz LoRa for post-flight control law validation.

### Slide 3

VEHICLE

Vehicle Configuration

Chute bay

ASAM-1 · mid fins

CCM · avionics · LoRa

ASAM-2 · jetavane · sustainer

Booster · eject ring

SCALE

1:2.14 of full system

DIAMETER

70mm OD

LENGTH

~1,170mm

MASS (EST.)

~640g all-up

STRUCTURE

PETG-CF printed

FIN RINGS

1× active + 1× passive

TVC

Ceramic jetavane

PROPULSION

2-stage solid motor

RECOVERY

Computer-triggered chute

DATALINK

915MHz LoRa · ~2km LoS

### Slide 4

CONTROL

Hybrid Control Architecture

WYVERN employs a cascaded PID control system that blends aerodynamic authority from an active mid fin ring (Ring 2) with thrust-vector control from ceramic jetavanes. Passive aft fins (Ring 1) provide baseline stability. Authority allocation shifts with dynamic pressure.

Outer loop — altitude

PID on altitude error → pitch/yaw setpoint

Inner loop — attitude

PID on quaternion error → fin + jetavane commands

TVC mixing

Pitch: jetavane A  ·  Yaw: jetavane B  ·  decoupled

Fin mixing

Pitch ±: top/bottom  ·  Yaw ±: left/right  ·  Roll: Ring 2 collective cant (45° clocking)

Control authority by phase

Boost

85%

Rail clear

60%

Loiter

30%

Descent

50%

Landing burn

80%

Jetavane TVC

Aerodynamic fins

### Slide 5

AVIONICS

3-Board Distributed Avionics Stack

ASAM-1

Mid Ring Controller

STM32F411 · Cortex-M4 100MHz

ICM-42688-P IMU · MS5611 baro

4× servo PWM · 7.4V HV rail

1S 1000mAh independent LiPo

CCM

Central Command Module

RP2040 · dual-core 133MHz

Primary IMU + barometer

3× pyrotechnic MOSFET channels

LoRa 915MHz · ~2km datalink

ASAM-2

TVC + Sustainer Controller

STM32F411 · Cortex-M4 100MHz

ICM-42688-P IMU · MS5611 baro

3× servo PWM (jetavane + slide)

Sustainer ignition relay

All boards: 62mm circular · 2-layer FR4 · ENIG · EasyEDA design · JLCPCB fabrication + SMT assembly  ·  Power fully independent per board  ·  JST-GH 8-pin inter-board ribbon
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
