swaroopsahoo4908/GTR70E-WYVERN/TVC ARCHIVED/Past Iterations/WYVERN-E 3.0/Documentation/WYVERN_E2_Mathematics.md

# WYVERN-E 2.0 — Mathematics & Performance Calculations

### A Skylight Rocketry Venture
##### 84 mm 2-Stage Magnetic-TVC 3D-Printed Research Vehicle
##### Companion to *WYVERN-E 2.0 Technical Document*. Figures reproduced by `Sims/run_sims.py`.

## 1. Propulsion Data (manufacturer / ThrustCurve)
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
