swaroopsahoo4908/GTR70E-WYVERN/_to_delete/stale_rev4/Simulations_plots_link/link_budget.png

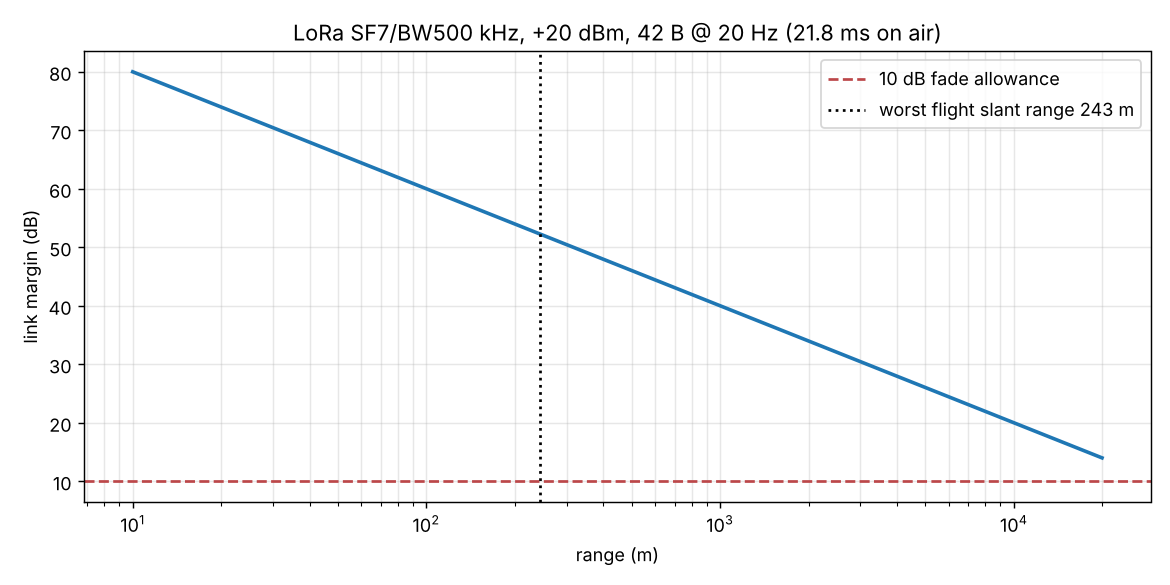
_to_delete/stale_rev4/Simulations_plots_link/link_budget.png
