swaroopsahoo4908/GTR70E-WYVERN/Documentation/diagrams/D1_vehicle_layout.png

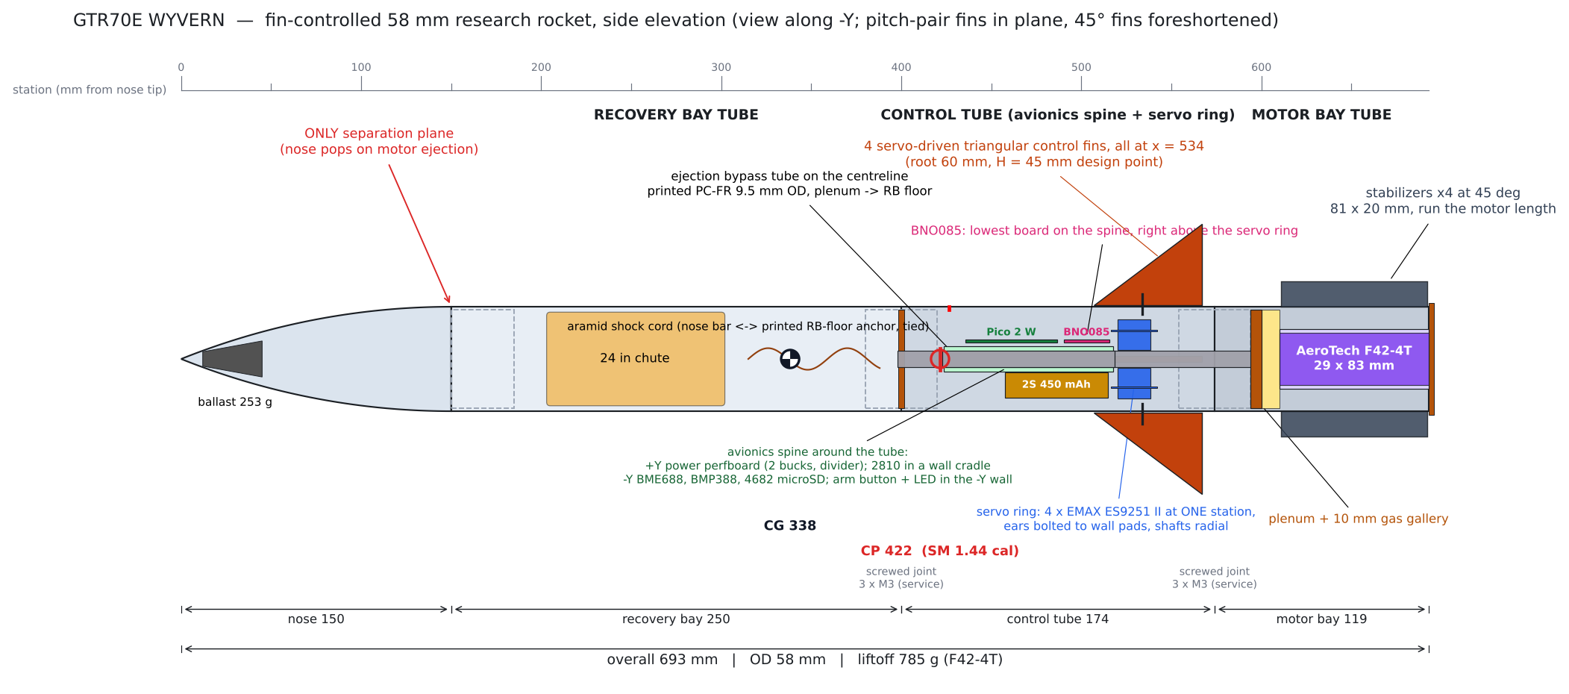
Documentation/diagrams/D1_vehicle_layout.png
