swaroopsahoo4908/GTR70E-WYVERN/Documentation/diagrams/D2_cross_sections.png

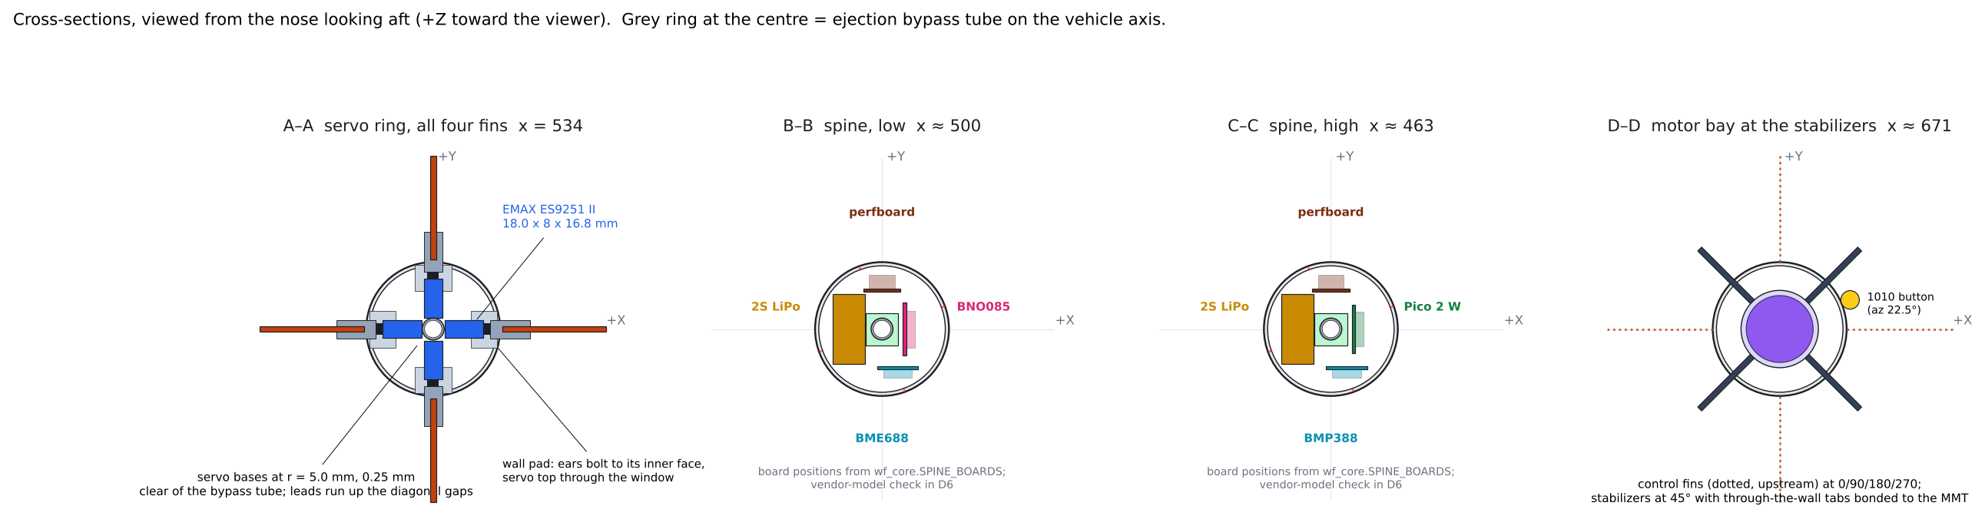
Documentation/diagrams/D2_cross_sections.png
