swaroopsahoo4908/GTR70E-WYVERN/Documentation/diagrams/D4_wind_tunnel_adaptation.png

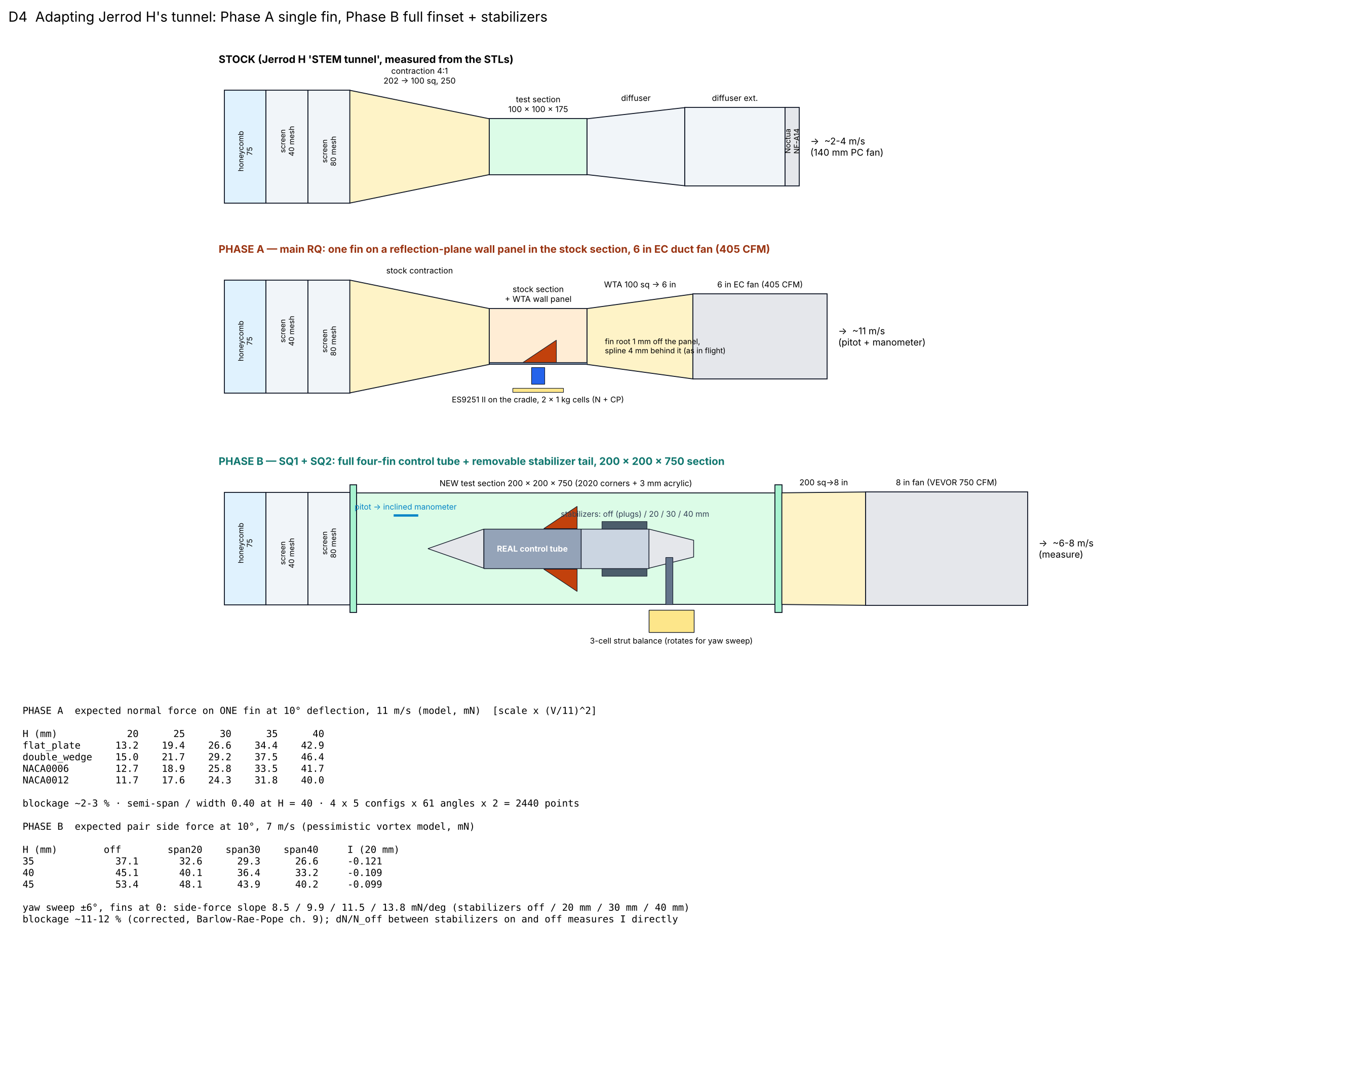
Documentation/diagrams/D4_wind_tunnel_adaptation.png
