swaroopsahoo4908/GTR70E-WYVERN/Documentation/diagrams/D5_research_plan.png

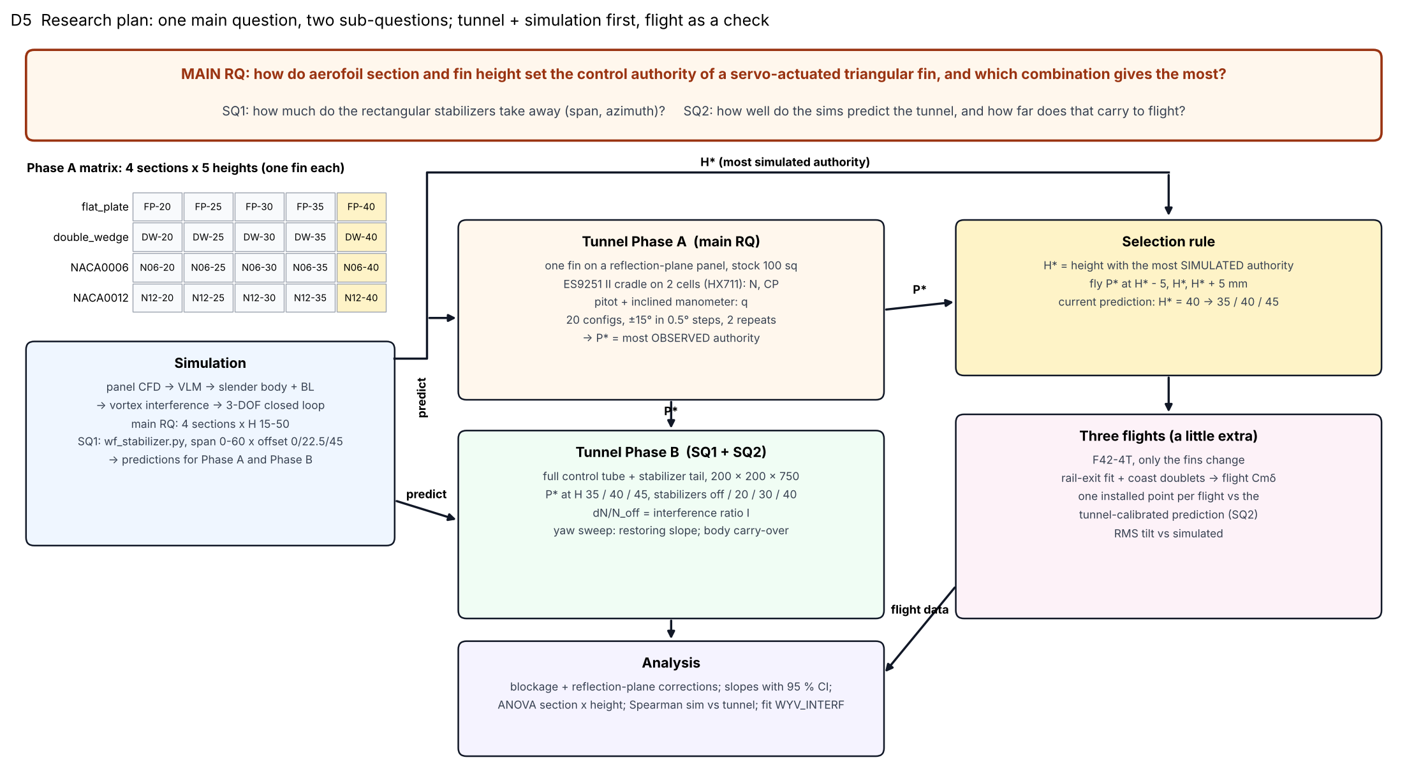
Documentation/diagrams/D5_research_plan.png
