swaroopsahoo4908/GTR70E-WYVERN/Documentation/diagrams/D6_fit_check.png

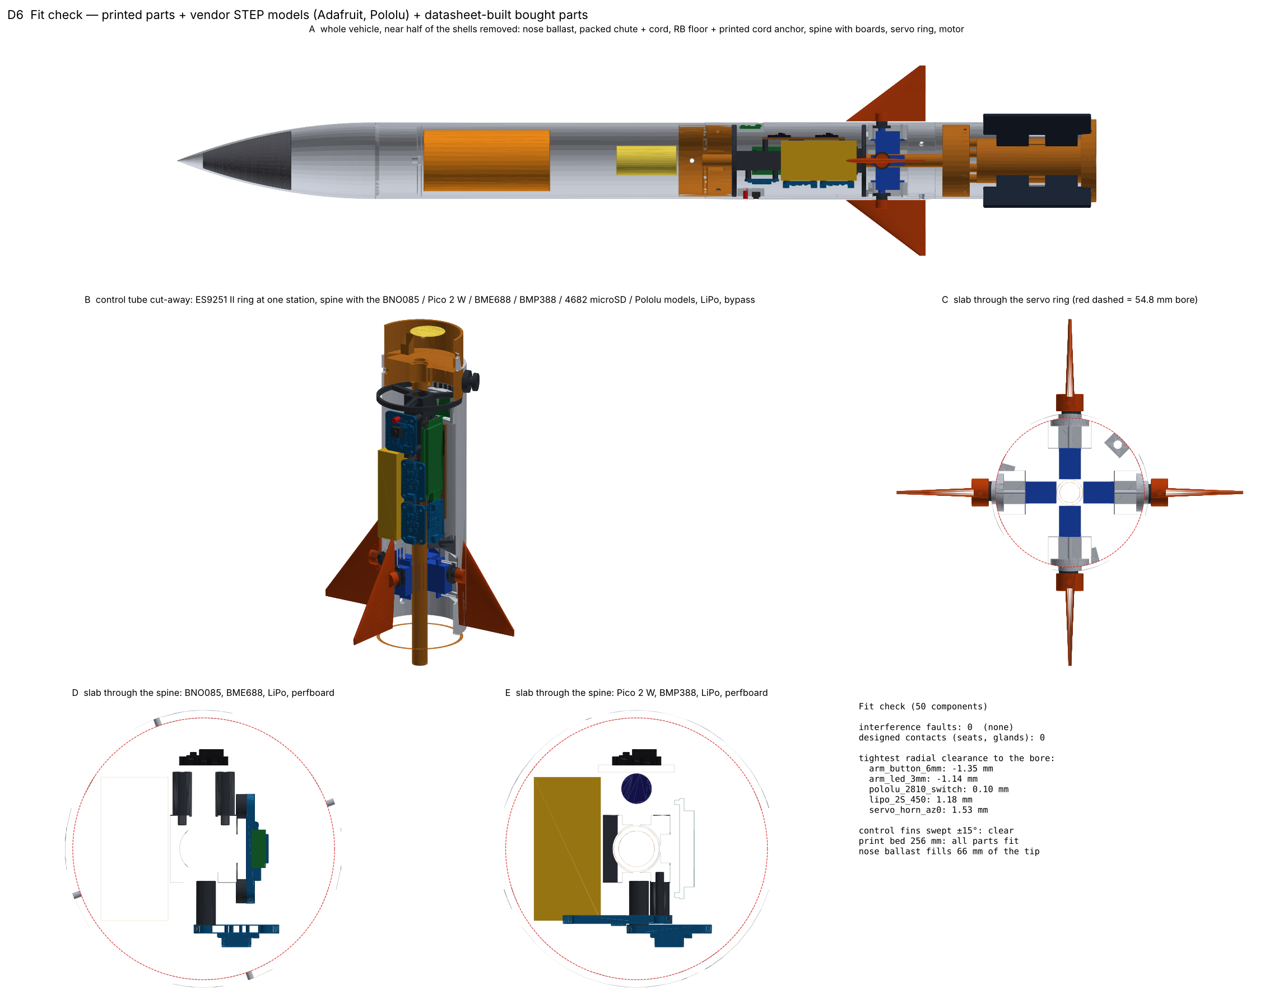
Documentation/diagrams/D6_fit_check.png
