swaroopsahoo4908/GTR70E-WYVERN/Documentation/diagrams/D10_wt_angle_sensor.png

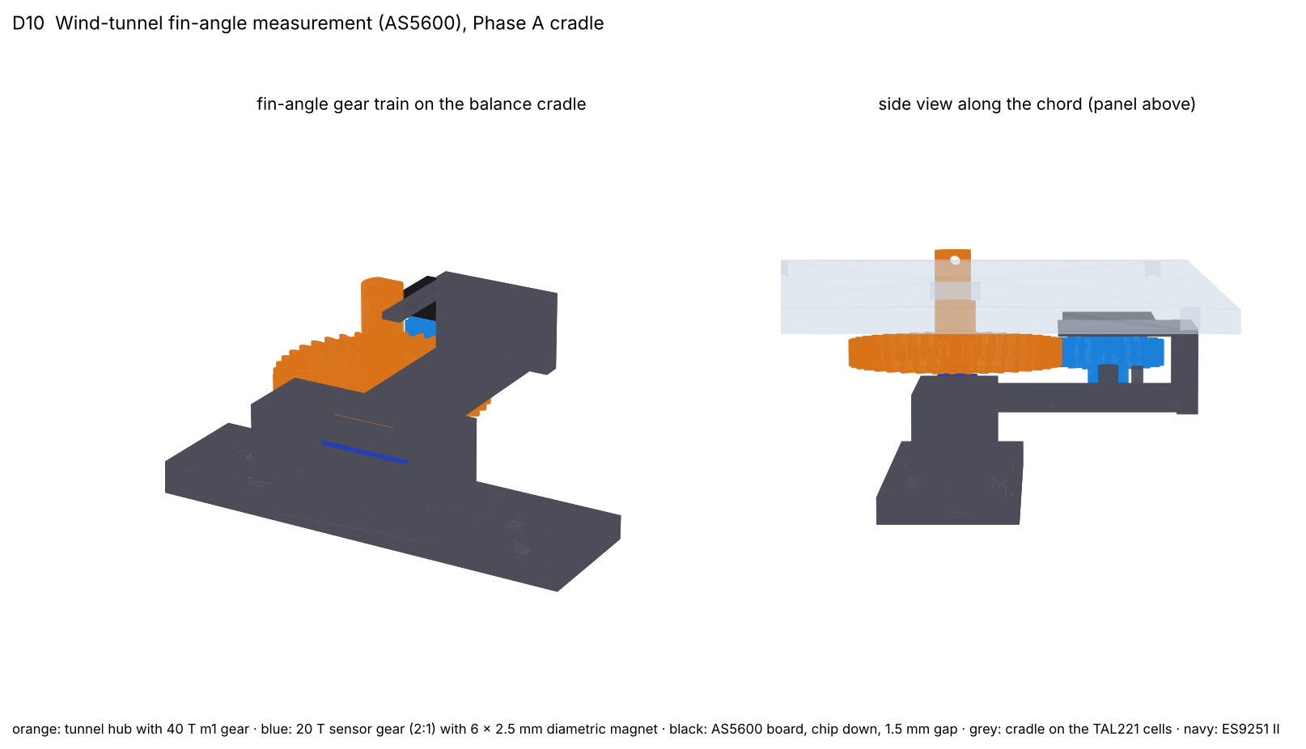
Documentation/diagrams/D10_wt_angle_sensor.png
