swaroopsahoo4908/GTR70E-WYVERN/Past Iterations/WYVERN-E KiCad/FC70/renders/WYVERN-E_FC70_3d_bottom.png

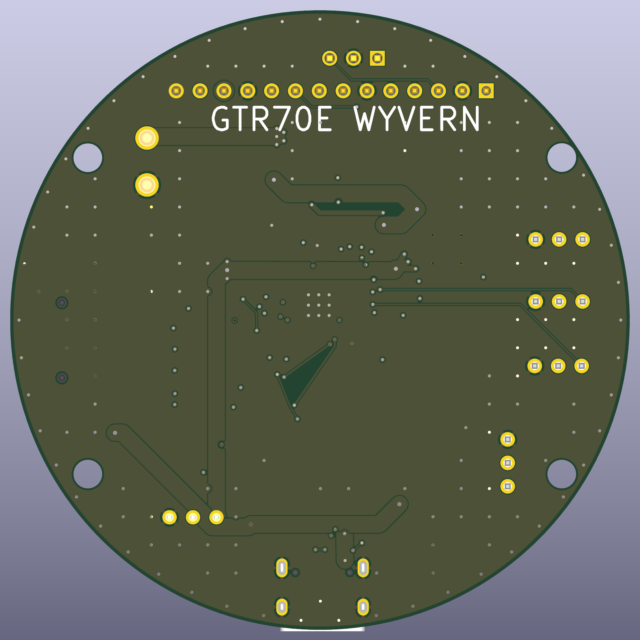
Past Iterations/WYVERN-E KiCad/FC70/renders/WYVERN-E_FC70_3d_bottom.png
