swaroopsahoo4908/GTR70E-WYVERN/Past Iterations/WYVERN-E KiCad/FC100/renders/WYVERN-E_FC100_3d_top.png

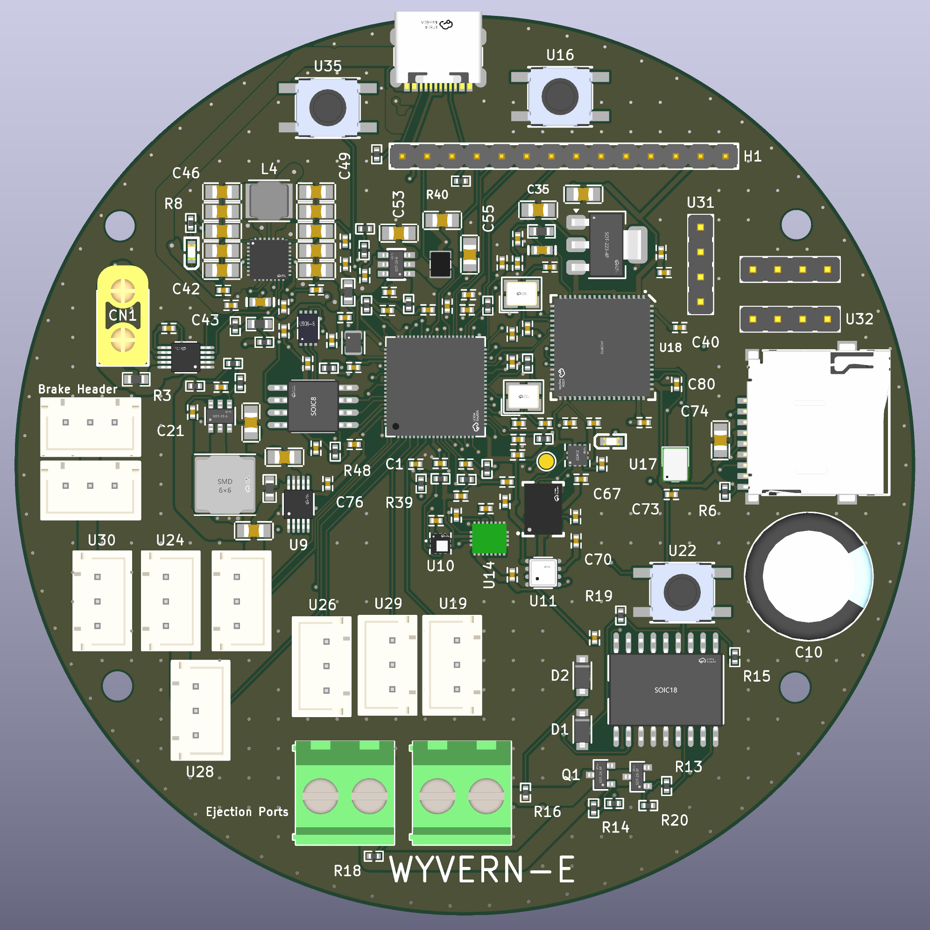
Past Iterations/WYVERN-E KiCad/FC100/renders/WYVERN-E_FC100_3d_top.png
