swaroopsahoo4908/GTR70E-WYVERN/Simulations/CFD/cl_alpha.png

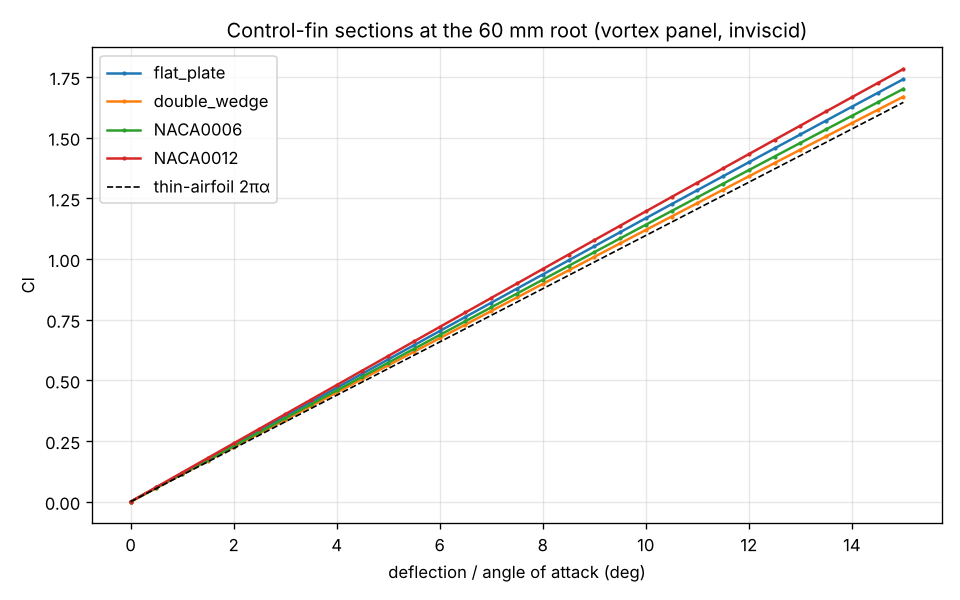
Simulations/CFD/cl_alpha.png
