swaroopsahoo4908/GTR70E-WYVERN/Simulations/CFD/cp_distribution.png

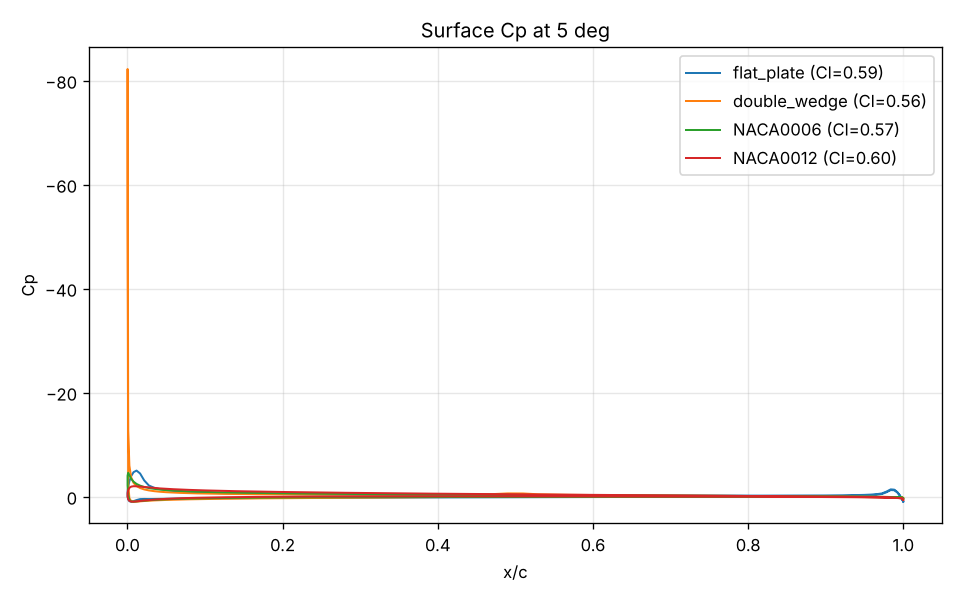
Simulations/CFD/cp_distribution.png
