swaroopsahoo4908/GTR70E-WYVERN/Simulations/plots_authority/A_isolated_vs_H.png

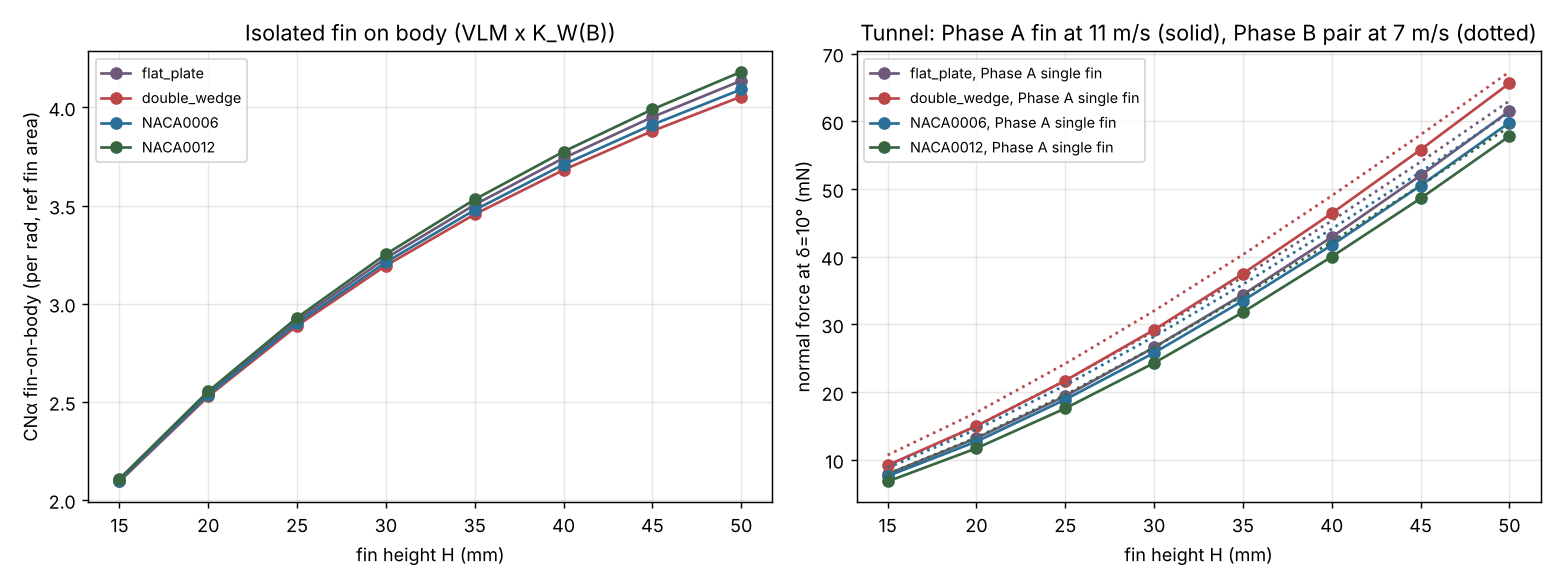
Simulations/plots_authority/A_isolated_vs_H.png
