swaroopsahoo4908/GTR70E-WYVERN/Simulations/plots_authority/B_net_authority_vs_H.png

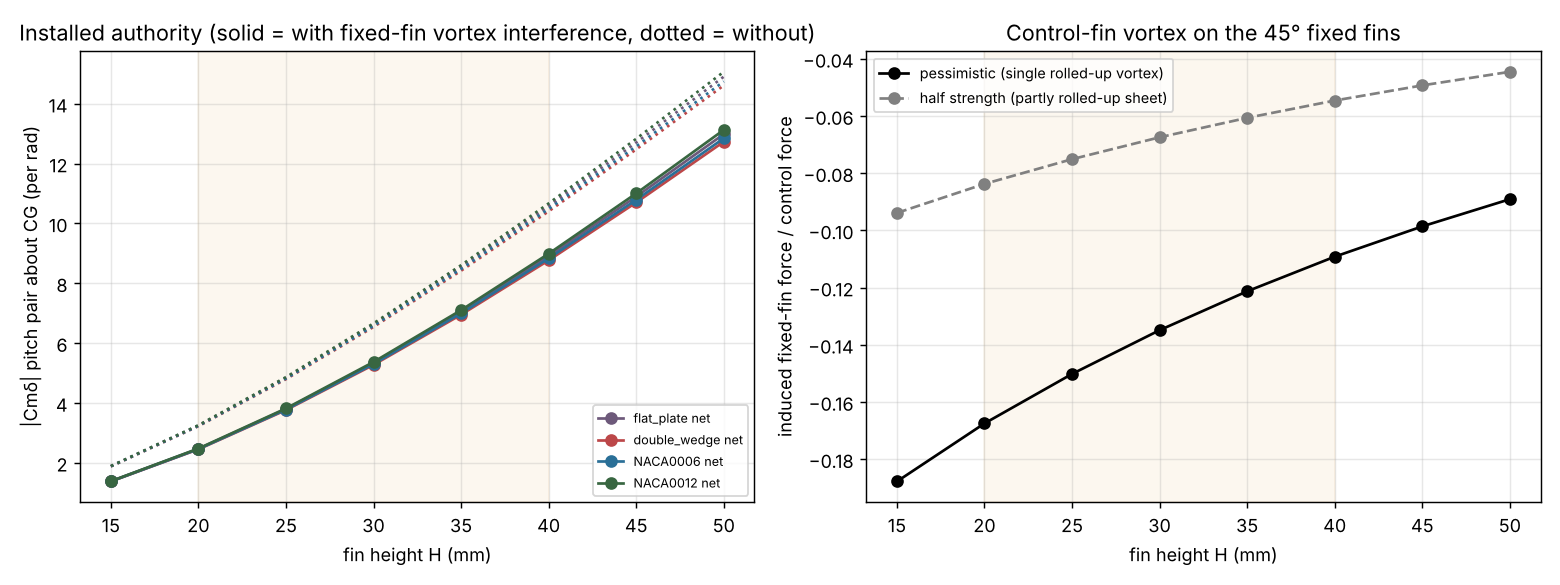
Simulations/plots_authority/B_net_authority_vs_H.png
