swaroopsahoo4908/GTR70E-WYVERN/Simulations/plots_authority/C_closed_loop_vs_H.png

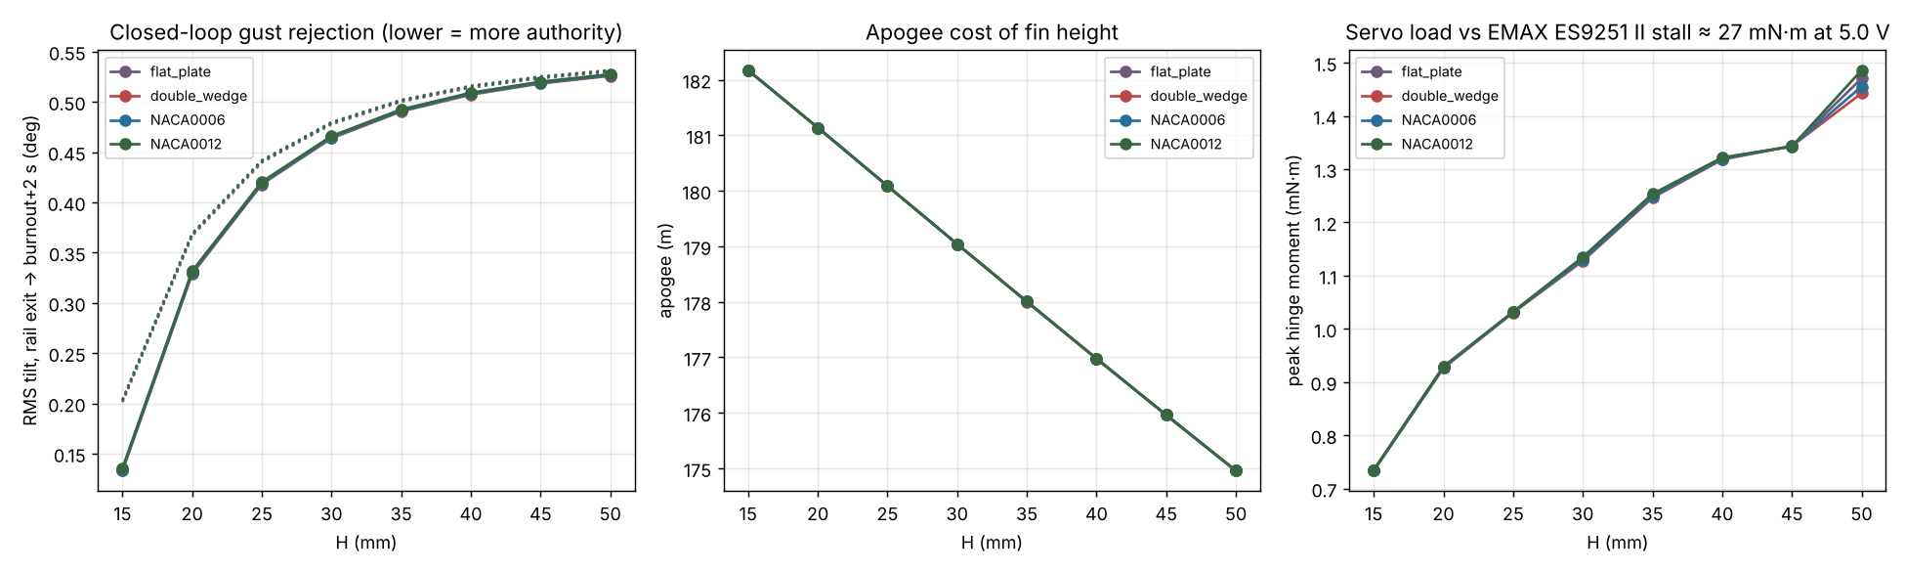
Simulations/plots_authority/C_closed_loop_vs_H.png
