swaroopsahoo4908/GTR70E-WYVERN/Simulations/plots_bypass/A_bay_pressure_vs_d.png

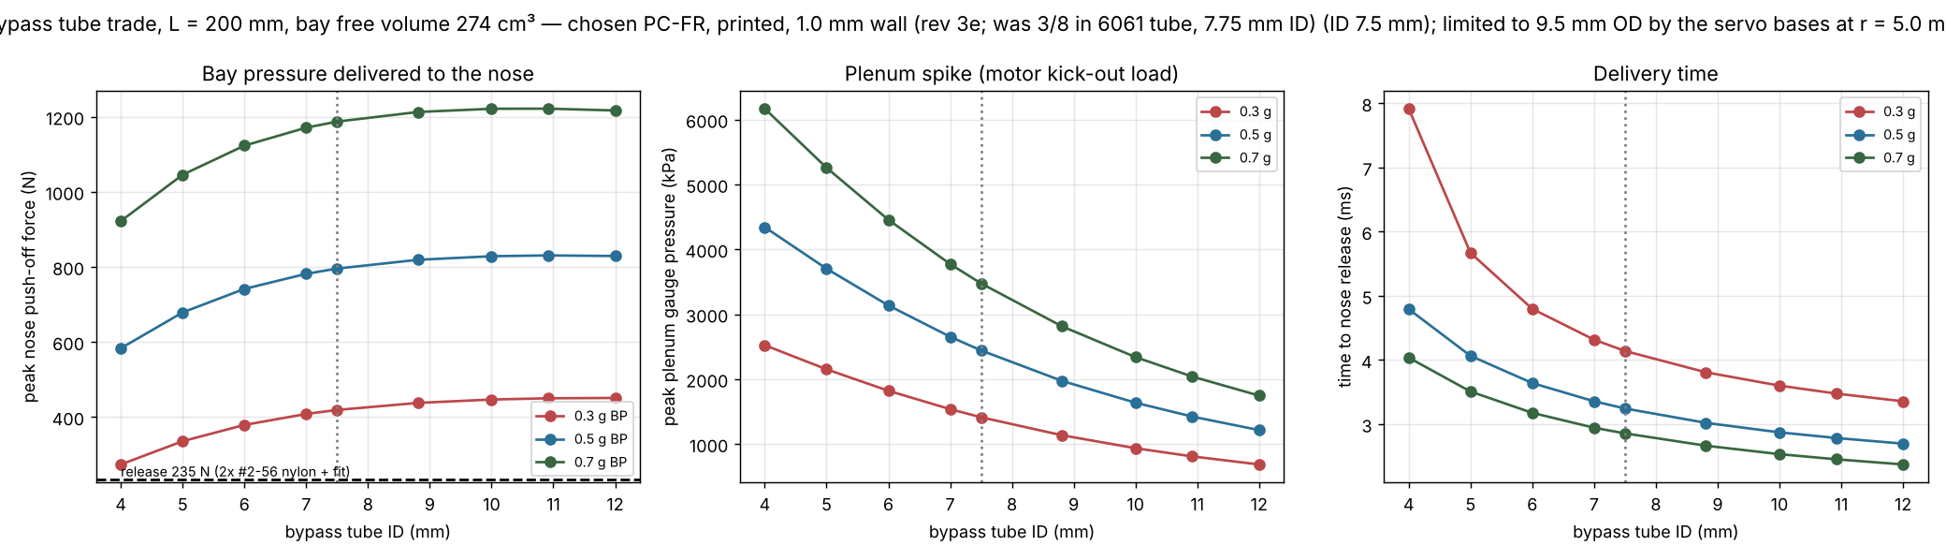
Simulations/plots_bypass/A_bay_pressure_vs_d.png
