swaroopsahoo4908/GTR70E-WYVERN/Simulations/plots_bypass/B_traces.png

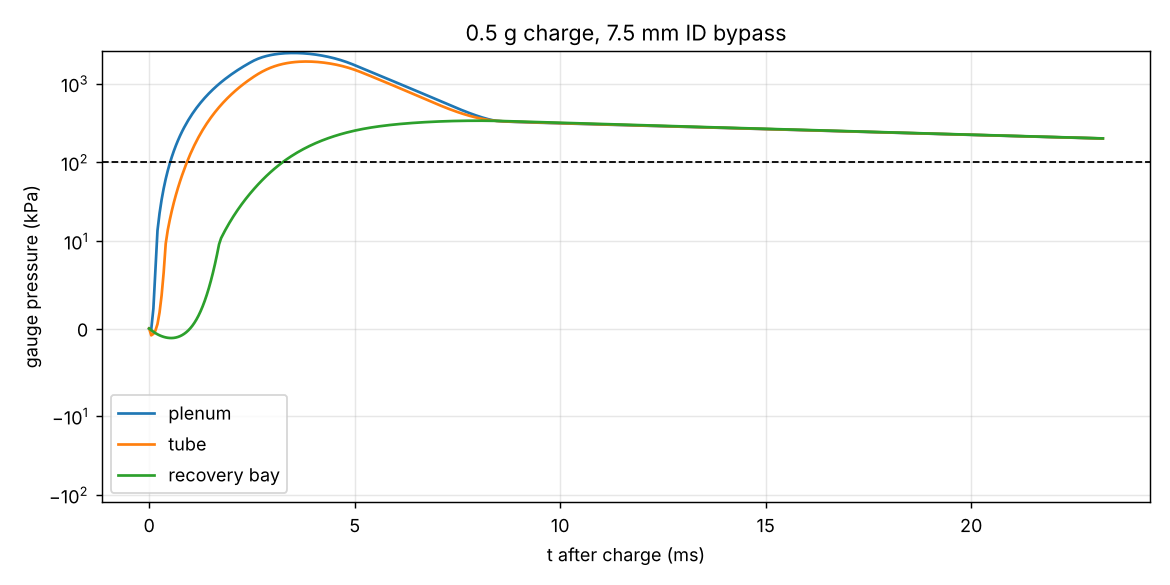
Simulations/plots_bypass/B_traces.png
