swaroopsahoo4908/GTR70E-WYVERN/Simulations/plots_flight/A_motor_trade.png

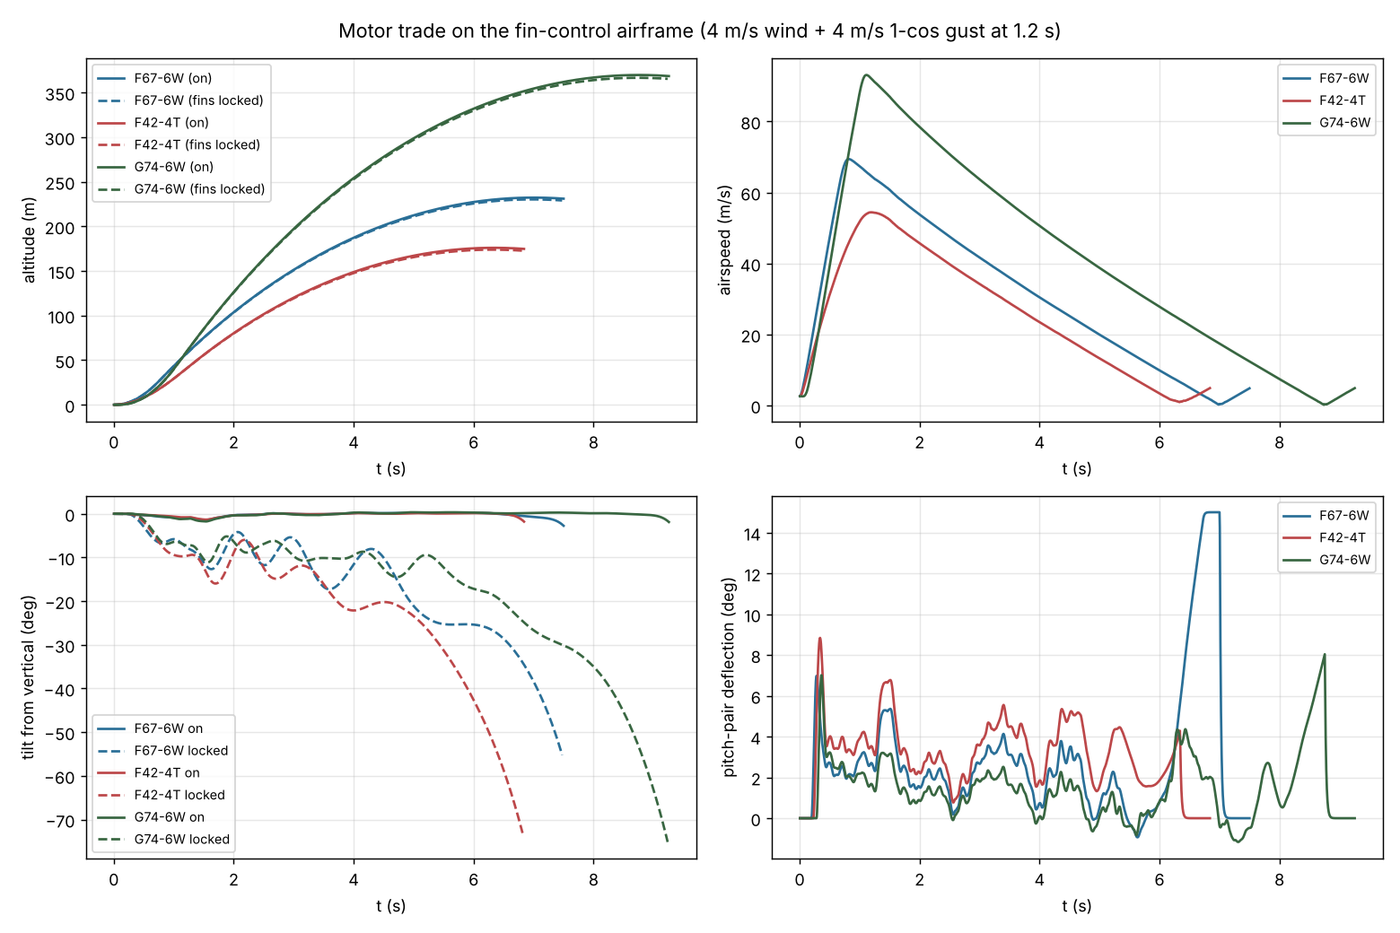
Simulations/plots_flight/A_motor_trade.png
