swaroopsahoo4908/GTR70E-WYVERN/Simulations/plots_flight/B_authority_maneuver.png

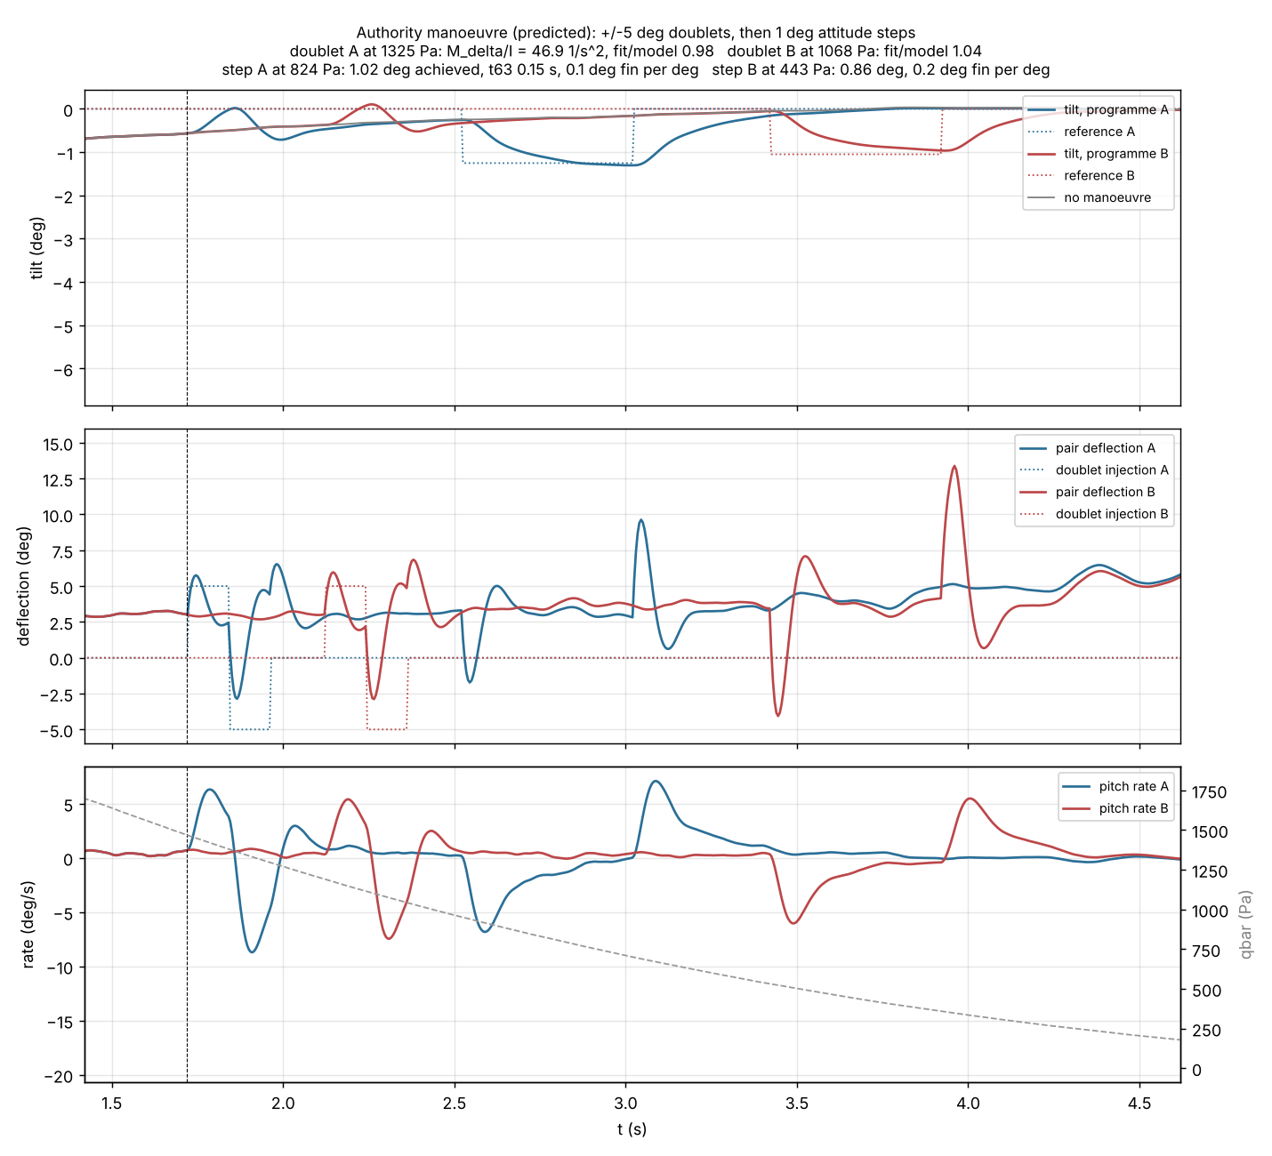
Simulations/plots_flight/B_authority_maneuver.png
