swaroopsahoo4908/GTR70E-WYVERN/Simulations/plots_flight/C_apogee_cap_trade.png

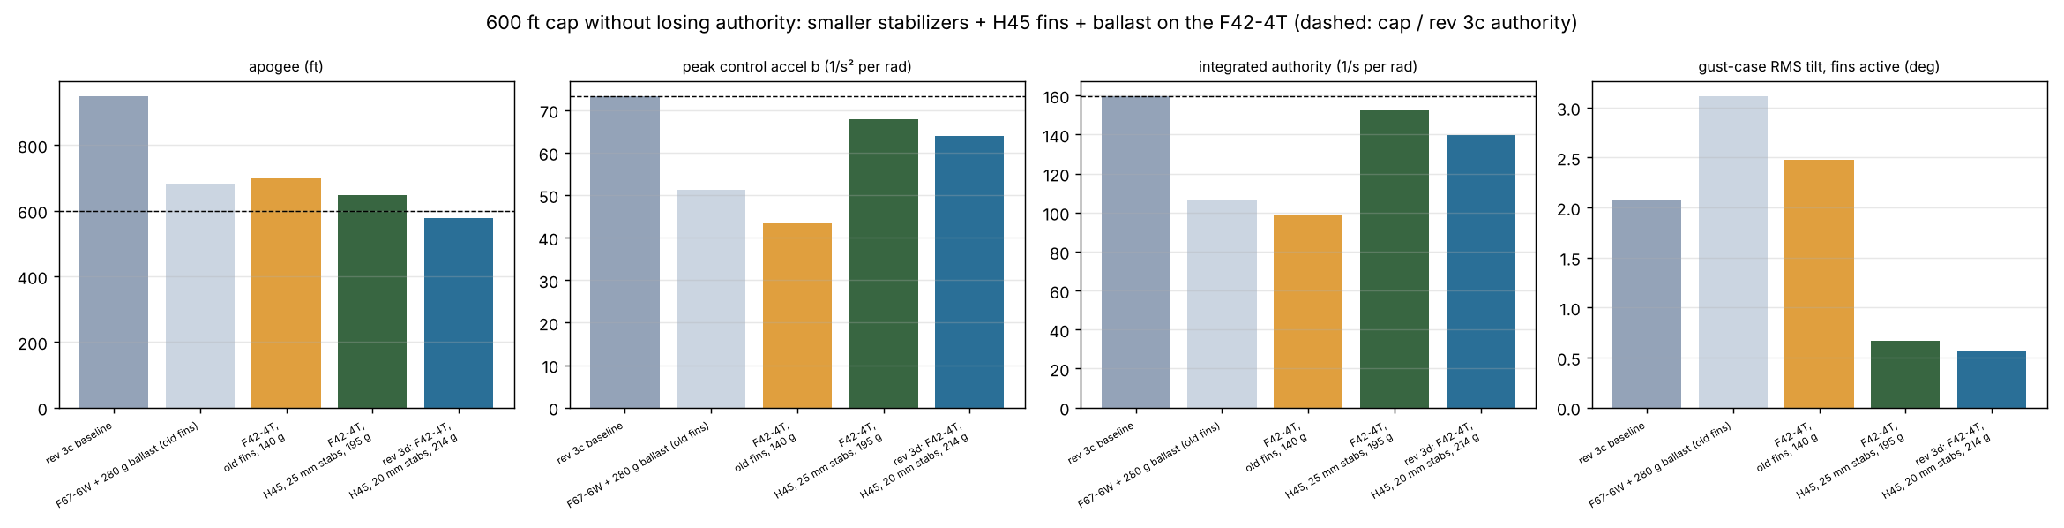
Simulations/plots_flight/C_apogee_cap_trade.png
