swaroopsahoo4908/GTR70E-WYVERN/Simulations/plots_flight/D_motor_study.png

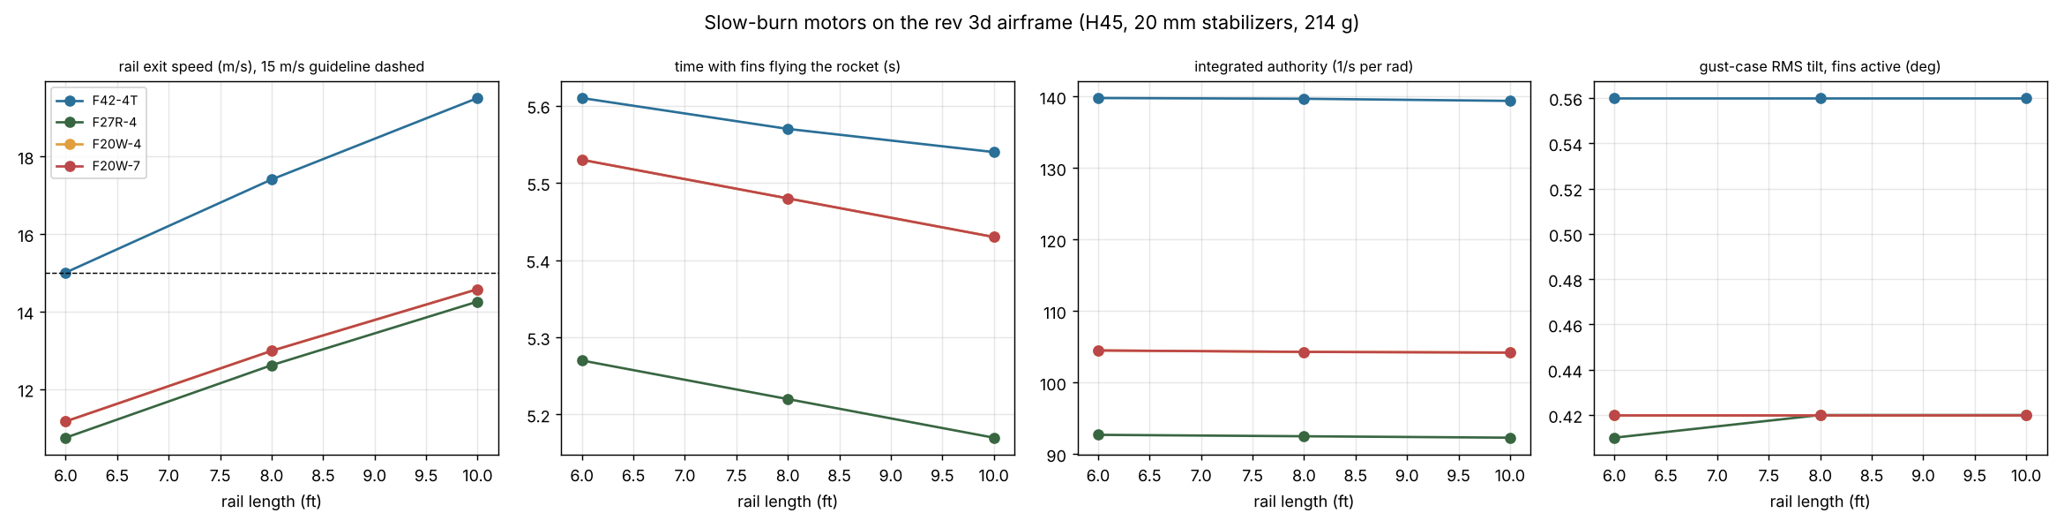
Simulations/plots_flight/D_motor_study.png
