swaroopsahoo4908/GTR70E-WYVERN/Simulations/plots_power/battery_budget.png

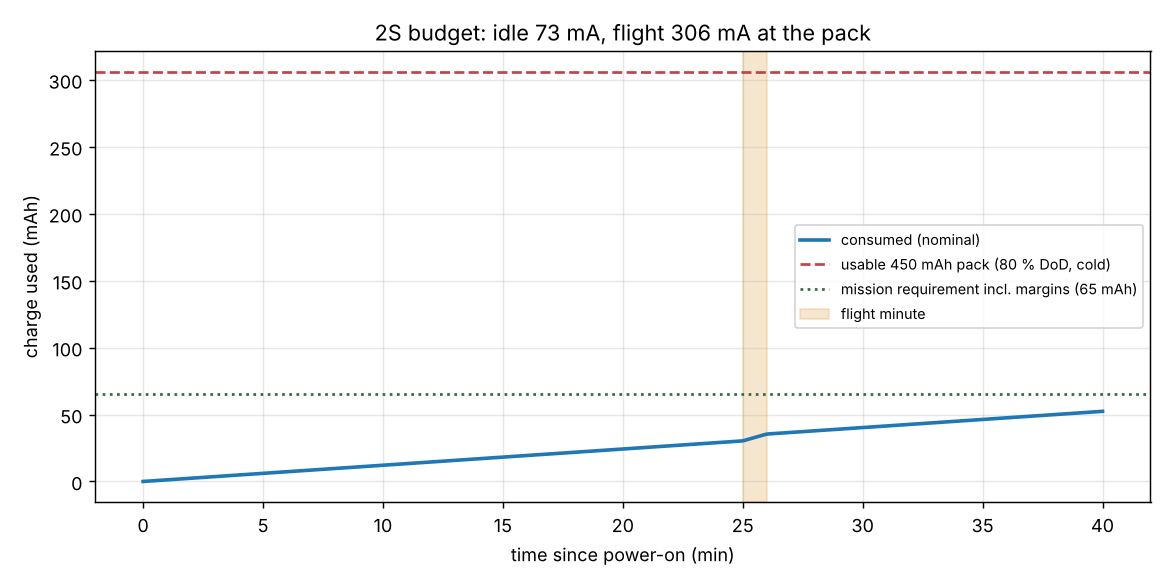
Simulations/plots_power/battery_budget.png
