swaroopsahoo4908/GTR70E-WYVERN/Simulations/plots_stabilizer/S1_margin_interference.png

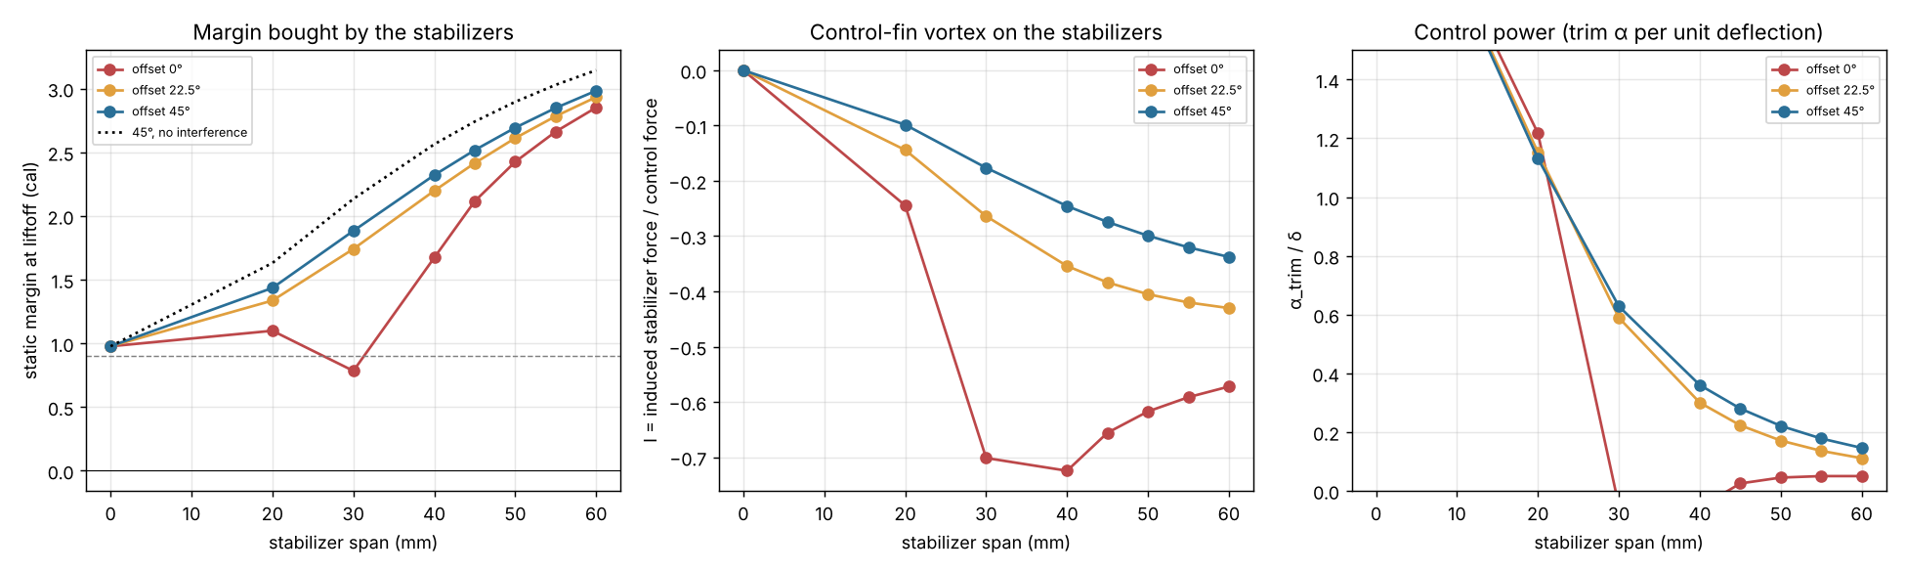
Simulations/plots_stabilizer/S1_margin_interference.png
