swaroopsahoo4908/GTR70E-WYVERN/Simulations/plots_stabilizer/S2_closed_loop.png

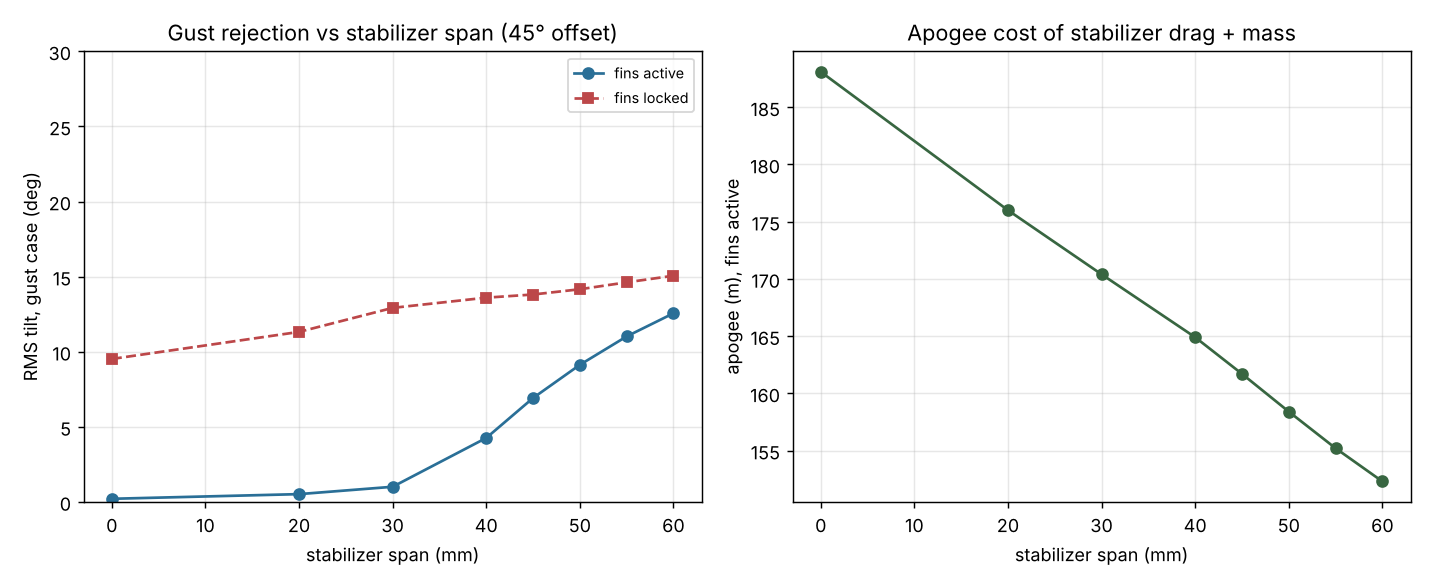
Simulations/plots_stabilizer/S2_closed_loop.png
