swaroopsahoo4908/GTR70E-WYVERN/Simulations/plots_stabilizer/S3_tunnel_phaseB.png

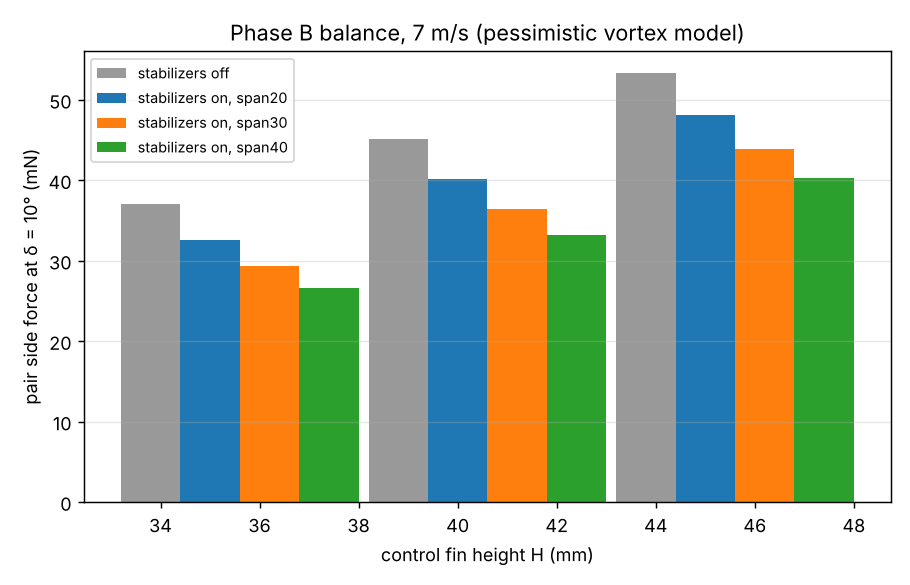
Simulations/plots_stabilizer/S3_tunnel_phaseB.png
