swaroopsahoo4908/GTR70E-WYVERN/Simulations/plots_stabilizer/S4_planform_trade.png

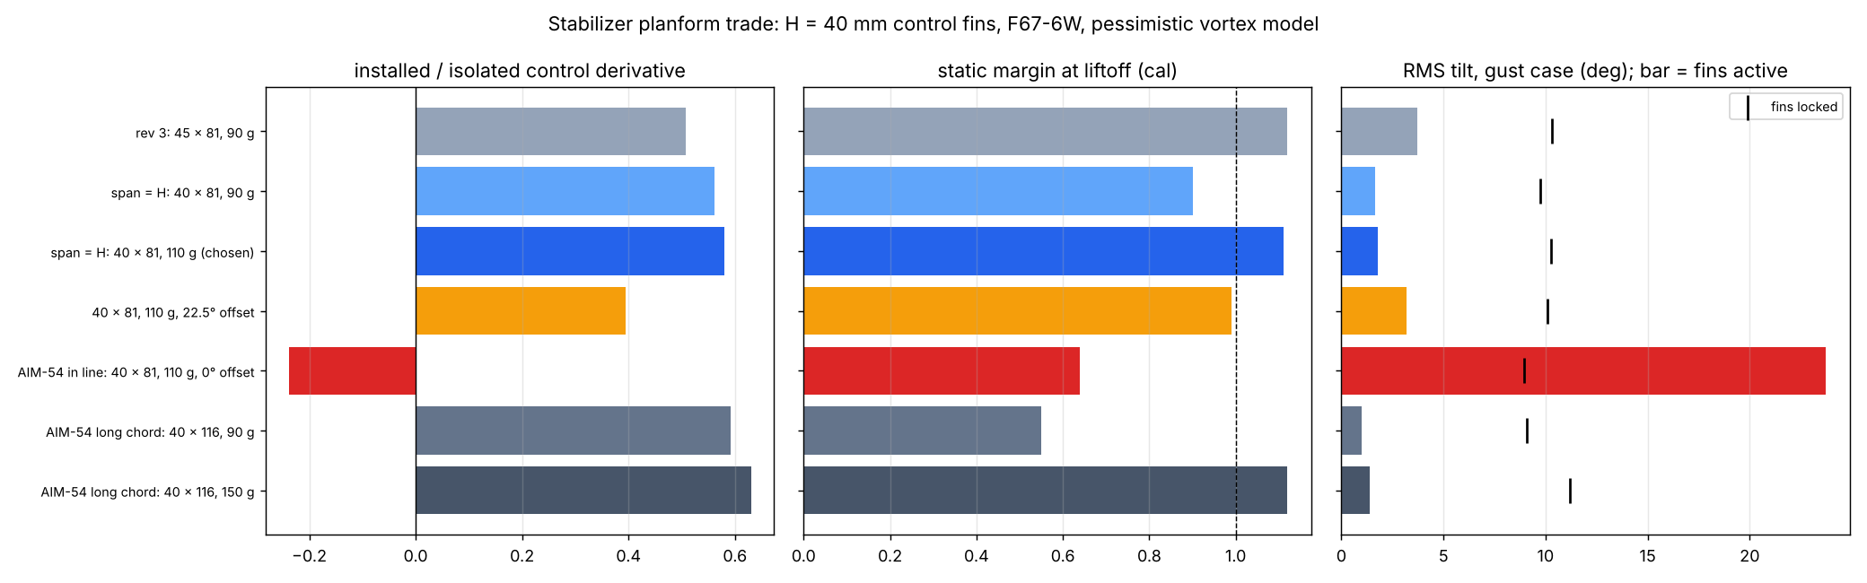
Simulations/plots_stabilizer/S4_planform_trade.png
