swaroopsahoo4908/GTR70E-WYVERN/_to_delete/stale_bom/WYVERN_FIN_BOM.xlsx

Sheet: Summary
Spend summary
Flight vehicle (to buy) | $320.18
Wind tunnel, Phase A (to buy) | $220.70
TOTAL new spend | $540.88
Optional smoke / laser visualisation (not in the total) | $229.48
Stores: Adafruit, SparkFun and Amazon except the 2810 switch (Pololu) and the motors (eRockets). Links and prices checked 2026-10-22 (tunnel, XT30, servo and buck rows 2026-11-01/02). Nose ballast (239 g) comes from whatever dense material you have; it is no longer on the list.

Sheet: To Buy - Flight
GTR70E WYVERN fin-control — flight vehicle, to buy
Built by Documentation/build_bom.py · numbers trace to Simulations/canonical_numbers.json
Item | Vendor | Part # / Spec | Link | Why / where used | Qty | Unit ($) | Line ($) | Price source
Avionics
Teensy 4.1 (no headers) | SparkFun | DEV-16771 | https://www.sparkfun.com/teensy-4-1.html | Rev 4 flight computer: 600 MHz M7, built-in microSD socket = flight log, ~100 mA. Leads soldered straight in (no header kit). 1 flight + 1 spare | 2 | $31.50 | $63.00 | vendor 2026-11-02, in stock
Adafruit BMP388 barometric pressure / altimeter, STEMMA QT | Adafruit | PID 3966 | https://www.adafruit.com/product/3966 | Rev 4 primary altimeter (50 Hz, Wire1) on the spine's -Y face; the owned BME688 stays for temperature / humidity | 1 | $9.95 | $9.95 | vendor 2026-11-02, in stock
STEMMA QT to male header cable 150 mm | Adafruit | PID 4209 | https://www.adafruit.com/product/4209 | BNO085, BMP388 and BME688 each onto their own Teensy I2C bus (header pins soldered into the board) + 1 spare | 4 | $0.95 | $3.80 | vendor 2026-10-16, in stock
Tactile button switch 6 mm, 20-pack | Adafruit | PID 367 | https://www.adafruit.com/product/367 | Rev 4 arm button in the -Y wall cradle (hold 2 s); the rest are spares | 1 | $2.50 | $2.50 | vendor 2026-11-02, in stock
LED - Basic Red 3 mm | SparkFun | COM-00533 | https://www.sparkfun.com/led-basic-red-3mm.html | Arm / state LED next to the button, through a 3.2 mm wall hole (220 ohm from your resistor stock); 1 + spare | 2 | $0.50 | $1.00 | vendor 2026-11-02, in stock
SparkFun Solder-able Breadboard (full) | SparkFun | PRT-12070 | https://www.sparkfun.com/sparkfun-solder-able-breadboard.html | Power board cut to 16 x 62 mm on the spine's +Y face (buck, divider, 470 uF) | 1 | $6.95 | $6.95 | vendor 2026-10-16, in stock
 |  |  |  |  |  | Subtotal | $87.20
Actuation
EMAX ES9251 II digital micro servo, 4-pack | Amazon | B0DLKJ3MJJ | https://www.amazon.com/dp/B0DLKJ3MJJ | Rev 3f: 18.0 x 7.9 x 16.8 mm, 4 g, 4.5-6.0 V on its own 5 V rail. 4 control fins + 1 for the tunnel cradle + 3 spares (plastic gears: expect to replace after a hard landing). Was the KST X08 Plus at $45 each | 2 | $28.60 | $57.20 | vendor 2026-11-02, only 5 left
GemRed DAG-V1 digital angle gauge | Amazon | B00WQLHG2G | https://www.amazon.com/dp/B00WQLHG2G | Servo trim + us/deg calibration (t2) and tunnel deflection check; +/-0.2 deg accuracy, 0.1 deg resolution, magnetic base | 1 | $19.99 | $19.99 | vendor 2026-10-22, in stock
 |  |  |  |  |  | Subtotal | $77.19
Power
Adafruit MPM3610 5 V buck, 6-21 V in, 1.2 A | Adafruit | PID 4739 | https://www.adafruit.com/product/4739 | 2S -> 5 V: one for the Teensy VIN, one for the servo rail (rev 3f), + 1 spare; 10.2 x 17.1 mm, vendor model in the fit check | 3 | $6.95 | $20.85 | vendor 2026-10-22, in stock
Pololu Mini MOSFET slide switch LV | Pololu | #2810 | https://www.pololu.com/product/2810 | Main power switch in the CT-wall cradle, slide flipped through a 4 x 12 mm slot. 1 + spare. Pololu only: no Adafruit / SparkFun part carries the 3 A servo current with reverse protection in this size | 2 | $4.49 | $8.98 | vendor 2026-10-16
Amass XT30 male + female pigtails, 16 AWG, 100 mm | Amazon | B0F44KMCWT | https://www.amazon.com/dp/B0F44KMCWT | Battery lead to the 2810; spares power the tunnel servo from the owned 2S pack. 470 uF cap is owned | 1 | $8.99 | $8.99 | vendor 2026-11-01, in stock
 |  |  |  |  |  | Subtotal | $38.82
Propulsion
AeroTech Econojet F42-4T single-use 29 x 83 mm Blue Thunder, 2-pack | eRockets | AER 64204, 4 s delay | https://www.erockets.biz/aerotech-29mm-composite-model-rocket-motor-single-use-f42-4t-2pk-aer-64204-required-to-pay-for-ups-ground-shipping/ | 3 research flights + 1 spare. Motors are not sold by Adafruit / SparkFun / Amazon. UPS ground, continental US only | 2 | $49.49 | $98.98 | vendor 2026-10-16, stock 4
 |  |  |  |  |  | Subtotal | $98.98
Hardware + material
Mywish M2-M5 304 stainless screw kit, 1290 pcs (button + socket head, nuts, washers) | Amazon | B0CQWYFTXC | https://www.amazon.com/dp/B0CQWYFTXC | Board screws into the owned M2 heat-set inserts, servo ears, joints, retainer, hubs, M4 rail-button screws; M5 for the tunnel junction rings | 1 | $17.99 | $17.99 | vendor 2026-10-22, in stock
Bambu Lab ASA-Aero 1.75 mm 1 kg (only if your roll runs low) | Amazon | B0HD6ZT4HZ | https://www.amazon.com/dp/B0HD6ZT4HZ | Tubes + nose (~200 g). Qty 0: you have a roll; buy only if it runs out (third-party seller on Amazon) | 0 | $58.99 | $0.00 | vendor 2026-10-22, in stock
 |  |  |  |  |  | Subtotal | $17.99
 |  |  |  |  |  | TOTAL | $320.18
Blue = inputs (qty, unit price). Line and totals are formulas. 'est.' prices: confirm at checkout.

Sheet: To Buy - Wind Tunnel
Wind tunnel, Phase A — to buy (nothing bought yet)
Fin force + airspeed + flow quality for the main RQ. See Documentation/Wind_Tunnel_Adaptation.md
Item | Vendor | Part # / Spec | Link | Why / where used | Qty | Unit ($) | Line ($) | Price source
Airflow
6 in inline duct fan, 405 CFM, EC motor, 0-100 % speed controller | Amazon | B08JZM1KHX | https://www.amazon.com/dp/B08JZM1KHX | Tunnel drive on the printed 100 sq -> 6 in transition (rev 3f; replaces the 8 in VEVOR). Standalone tunnel list: WYVERN_WindTunnel_BOM.xlsx | 1 | $64.99 | $64.99 | vendor 2026-11-01, only 3 left
AC Infinity stainless duct clamps 6 in (2 pack) | Amazon | B07L4S62Q6 | https://www.amazon.com/dp/B07L4S62Q6 | Clamps the printed transition socket onto the fan collar | 1 | $7.99 | $7.99 | vendor 2026-11-01
40 mesh 304 stainless mesh, 2 rolls 31 x 115 cm | Amazon | B0BBMTDK88 | https://www.amazon.com/dp/B0BBMTDK88 | Coarse turbulence screen (Jerrod's screen module) | 1 | $15.99 | $15.99 | vendor 2026-10-22
80 mesh 304 stainless mesh, 5 sheets 20 x 30 cm | Amazon | B09VNKDS9R | https://www.amazon.com/dp/B09VNKDS9R | Fine turbulence screen | 1 | $7.99 | $7.99 | vendor 2026-10-22, in stock
 |  |  |  |  |  | Subtotal | $96.96
Balance (fin force)
Mini load cell 100 g, straight bar (TAL221) | SparkFun | SEN-14727 | https://www.sparkfun.com/mini-load-cell-100g-straight-bar-tal221.html | Two under the servo cradle, 60 mm apart along the chord: normal force (sum) and chordwise CP (difference). Read by two of your owned HX711 boards | 2 | $14.50 | $29.00 | vendor 2026-10-22, in stock
 |  |  |  |  |  | Subtotal | $29.00
Controller and wiring
Adafruit Metro M4 feat. Microchip ATSAMD51 | Adafruit | PID 3382 | https://www.adafruit.com/product/3382 | The one tunnel controller (wt_balance_daq v3.0, Arduino IDE): servo, both HX711s, BME688 | 1 | $27.50 | $27.50 | vendor 2026-11-01, 17 in stock
STEMMA QT to male header cable 150 mm | Adafruit | PID 4209 | https://www.adafruit.com/product/4209 | BME688 to the Metro's SDA/SCL header | 1 | $0.95 | $0.95 | vendor 2026-10-16, in stock
JR servo extension leads 30 cm (10 pack) | Amazon | B07NJB58XC | https://www.amazon.com/dp/B07NJB58XC | Cradle servo to the Metro; one cut to break out servo power to the XT30 | 1 | $8.99 | $8.99 | vendor 2026-11-01
ELEGOO Dupont jumper wires (120) | Amazon | B01EV70C78 | https://www.amazon.com/dp/B01EV70C78 | HX711s and BME688 to the Metro headers | 1 | $6.98 | $6.98 | vendor 2026-11-01
5 V 3 A wall power supply, 5.5 x 2.1 mm plug, UL listed | Amazon | B09JW38H3X | https://www.amazon.com/dp/B09JW38H3X | Tunnel servo power (rev 3f: the ES9251 II is a 4.5-6 V servo, so no 2S pack in the tunnel) | 1 | $8.95 | $8.95 | vendor 2026-11-02
Female DC power adapter, 2.1 mm jack to screw terminal | Adafruit | PID 368 | https://www.adafruit.com/product/368 | Breaks the 5 V supply out to the servo lead and the Metro GND | 1 | $2.00 | $2.00 | vendor 2026-11-02, in stock
 |  |  |  |  |  | Subtotal | $55.37
Airspeed (pitot + inclined manometer)
Differential (pitot-static) tube with silicone hose | Amazon | B07Q6126B6 | https://www.amazon.com/dp/B07Q6126B6 | Total + static ports upstream of the fin, at the section centre | 1 | $10.39 | $10.39 | vendor 2026-10-22, 14 left
Clear PVC tubing 1/8 in ID x 1/4 in OD, 25 ft | Amazon | B0D2CR3322 | https://www.amazon.com/dp/B0D2CR3322 | Inclined water manometer leg on the printed 1:10 ramp (WTA_inclined_manometer) + pitot lines | 1 | $9.99 | $9.99 | vendor 2026-10-22, in stock
 |  |  |  |  |  | Subtotal | $20.38
Test section
Clear acrylic sheet 3 mm, 12 x 12 in (5 pack) | Amazon | B0GY1GB12W | https://www.amazon.com/dp/B0GY1GB12W | Top-wall window (80 x 130 mm) to film the fin and its tufts; spares for the other walls. A picture-frame pane works too | 1 | $18.99 | $18.99 | vendor 2026-10-22, in stock
 |  |  |  |  |  | Subtotal | $18.99
 |  |  |  |  |  | TOTAL | $220.70
Blue = inputs (qty, unit price). Line and totals are formulas. 'est.' prices: confirm at checkout.

Sheet: Wind Tunnel - Full List
Wind tunnel, Phase A — full materials list
To buy + owned. Printed parts: Jerrod's STLs (less the Noctua diffuser, extension and guard) + 3D parts/wind_tunnel/WTA_*
Item | Vendor | Part # / Spec | Link | Why / where used | Qty | Unit ($) | Line ($) | Price source
Airflow
6 in inline duct fan, 405 CFM, EC motor, 0-100 % speed controller | Amazon | B08JZM1KHX | https://www.amazon.com/dp/B08JZM1KHX | Tunnel drive on the printed 100 sq -> 6 in transition (rev 3f; replaces the 8 in VEVOR). Standalone tunnel list: WYVERN_WindTunnel_BOM.xlsx | 1 | $64.99 | $64.99 | vendor 2026-11-01, only 3 left
AC Infinity stainless duct clamps 6 in (2 pack) | Amazon | B07L4S62Q6 | https://www.amazon.com/dp/B07L4S62Q6 | Clamps the printed transition socket onto the fan collar | 1 | $7.99 | $7.99 | vendor 2026-11-01
40 mesh 304 stainless mesh, 2 rolls 31 x 115 cm | Amazon | B0BBMTDK88 | https://www.amazon.com/dp/B0BBMTDK88 | Coarse turbulence screen (Jerrod's screen module) | 1 | $15.99 | $15.99 | vendor 2026-10-22
80 mesh 304 stainless mesh, 5 sheets 20 x 30 cm | Amazon | B09VNKDS9R | https://www.amazon.com/dp/B09VNKDS9R | Fine turbulence screen | 1 | $7.99 | $7.99 | vendor 2026-10-22, in stock
 |  |  |  |  |  | Subtotal | $96.96
Balance (fin force)
Mini load cell 100 g, straight bar (TAL221) | SparkFun | SEN-14727 | https://www.sparkfun.com/mini-load-cell-100g-straight-bar-tal221.html | Two under the servo cradle, 60 mm apart along the chord: normal force (sum) and chordwise CP (difference). Read by two of your owned HX711 boards | 2 | $14.50 | $29.00 | vendor 2026-10-22, in stock
 |  |  |  |  |  | Subtotal | $29.00
Controller and wiring
Adafruit Metro M4 feat. Microchip ATSAMD51 | Adafruit | PID 3382 | https://www.adafruit.com/product/3382 | The one tunnel controller (wt_balance_daq v3.0, Arduino IDE): servo, both HX711s, BME688 | 1 | $27.50 | $27.50 | vendor 2026-11-01, 17 in stock
STEMMA QT to male header cable 150 mm | Adafruit | PID 4209 | https://www.adafruit.com/product/4209 | BME688 to the Metro's SDA/SCL header | 1 | $0.95 | $0.95 | vendor 2026-10-16, in stock
JR servo extension leads 30 cm (10 pack) | Amazon | B07NJB58XC | https://www.amazon.com/dp/B07NJB58XC | Cradle servo to the Metro; one cut to break out servo power to the XT30 | 1 | $8.99 | $8.99 | vendor 2026-11-01
ELEGOO Dupont jumper wires (120) | Amazon | B01EV70C78 | https://www.amazon.com/dp/B01EV70C78 | HX711s and BME688 to the Metro headers | 1 | $6.98 | $6.98 | vendor 2026-11-01
5 V 3 A wall power supply, 5.5 x 2.1 mm plug, UL listed | Amazon | B09JW38H3X | https://www.amazon.com/dp/B09JW38H3X | Tunnel servo power (rev 3f: the ES9251 II is a 4.5-6 V servo, so no 2S pack in the tunnel) | 1 | $8.95 | $8.95 | vendor 2026-11-02
Female DC power adapter, 2.1 mm jack to screw terminal | Adafruit | PID 368 | https://www.adafruit.com/product/368 | Breaks the 5 V supply out to the servo lead and the Metro GND | 1 | $2.00 | $2.00 | vendor 2026-11-02, in stock
 |  |  |  |  |  | Subtotal | $55.37
Airspeed (pitot + inclined manometer)
Differential (pitot-static) tube with silicone hose | Amazon | B07Q6126B6 | https://www.amazon.com/dp/B07Q6126B6 | Total + static ports upstream of the fin, at the section centre | 1 | $10.39 | $10.39 | vendor 2026-10-22, 14 left
Clear PVC tubing 1/8 in ID x 1/4 in OD, 25 ft | Amazon | B0D2CR3322 | https://www.amazon.com/dp/B0D2CR3322 | Inclined water manometer leg on the printed 1:10 ramp (WTA_inclined_manometer) + pitot lines | 1 | $9.99 | $9.99 | vendor 2026-10-22, in stock
 |  |  |  |  |  | Subtotal | $20.38
Test section
Clear acrylic sheet 3 mm, 12 x 12 in (5 pack) | Amazon | B0GY1GB12W | https://www.amazon.com/dp/B0GY1GB12W | Top-wall window (80 x 130 mm) to film the fin and its tufts; spares for the other walls. A picture-frame pane works too | 1 | $18.99 | $18.99 | vendor 2026-10-22, in stock
 |  |  |  |  |  | Subtotal | $18.99
Owned or already on the flight list (no spend)
HX711 load-cell ADC boards (2 of your 4) | owned |  |  | One per TAL221; run at 3.3 V from the Metro | 2 | $0.00 | $0.00 | owned
Adafruit BME688 (the spare) | owned |  |  | Room temperature / pressure / humidity -> air density for q | 1 | $0.00 | $0.00 | owned
EMAX ES9251 II (one from the flight 4-packs) | flight list |  |  | Drives the half-model fin in the cradle, so the flight hub and fins fit unchanged | 1 | $0.00 | $0.00 | flight list
Calibration weights, MR105 bearing, thread | owned |  |  | Thread-and-pulley calibration of the balance; printed pulley WTA_calibration_pulley_wheel + bracket | 1 | $0.00 | $0.00 | owned
Heat-set insert kit M2-M6 + the flight screw kit | owned / flight list |  |  | M5 junction rings, M2.5 window tabs, M3 panel / cradle / cells | 1 | $0.00 | $0.00 | owned
Filament (PETG / PLA) | owned |  |  | Jerrod's tunnel (~5 kg) + WTA parts (~0.5 kg); off the buy list per your call | 1 | $0.00 | $0.00 | owned
Sewing thread | owned |  |  | 20-30 mm tufts taped on the fin: shows attached / separated flow (hypothesis H2) without smoke | 1 | $0.00 | $0.00 | owned
 |  |  |  |  |  | Subtotal | $0.00
 |  |  |  |  |  | TOTAL | $220.70
Blue = inputs (qty, unit price). Line and totals are formulas. 'est.' prices: confirm at checkout.

Sheet: Optional - Flow Vis
Optional: smoke and laser-sheet flow visualisation
Not needed for the RQ data (tufts cover hypothesis H2). Buy only if you want the smoke pictures
Item | Vendor | Part # / Spec | Link | Why / where used | Qty | Unit ($) | Line ($) | Price source
Smoke + laser-sheet visualisation (not needed for the RQ data)
COLBOR CF3 30 W portable fog machine | Amazon | B0FW4VQ72H | https://www.amazon.com/dp/B0FW4VQ72H | Smoke source for Jerrod's rake | 1 | $89.00 | $89.00 | your link, 2026-10-21
COLBOR fog fluid for CF3 / CF5 (2 fl oz x 4) | Arts Cameras | COLBOR CF fluid | https://artscameras.com/products/colbor-fluid-for-cf3-cf5-fog-machine-2-fl-oz-4-pack | Only if the CF3 box has none | 1 | $25.90 | $25.90 | vendor 2026-10-21
520 nm focusable green line laser module | Amazon | B0CKP4SYL7 | https://www.amazon.com/dp/B0CKP4SYL7 | Laser sheet on the X/Y gantry | 1 | $39.00 | $39.00 | your link
SmallRig P96L RGB video light | Amazon | B09G98NRQZ | https://www.amazon.com/dp/B09G98NRQZ | LED ceiling module; any lamp works for tufts | 1 | $30.60 | $30.60 | your link
Loc-Line 40413 hose sample kit (1/4 in) | Amazon | B0GZL8N636 | https://www.amazon.com/dp/B0GZL8N636 | Smoke wand plumbing | 1 | $25.00 | $25.00 | your link
Magnets 6 x 2 mm (250) and 10 x 3 mm (50) | Amazon | B0DBVJF1G2 / B0BVY5VYQY | https://www.amazon.com/dp/B0DBVJF1G2 | Only Jerrod's smoke-rake ports and Gridfinity floor use them; Phase A uses the wall panel | 2 | $9.99 | $19.98 | your links
 |  |  |  |  |  | Subtotal | $229.48
 |  |  |  |  |  | TOTAL | $229.48
Blue = inputs (qty, unit price). Line and totals are formulas. 'est.' prices: confirm at checkout.

Sheet: On Hand (reuse)
Already owned and reused (verify counts on the shelf)
Item | Qty | Role in the fin-control build
Raspberry Pi Pico 2 W | 2 | Spares (the tunnel now runs on a Metro M4)
Adafruit BNO085 (4754) | 4 | 1 flight IMU on the spine's +X face; spares
Adafruit BME688 (5046) | 2 | Flight baro + the spare logs air density in the tunnel
microSD 32 GB cards (+ the 254 breakout, now spare) | 1 | Rev 4: the card goes in the Teensy 4.1's own socket; soak-test it with t3_arm_log before flying
OVONIC 2S 450 mAh LiPo (XT30) | 2 | Flight battery (4.2x margin on the 26-min mission with the Teensy, rev 4; 2.3 h pad hold)
2S/3S balance charger | 1 | Charging
470 uF low-ESR + 100 nF; 100k/47k 1 % and 220 ohm resistors | 1 | Servo bulk cap, Vbat divider, arm-LED resistor
Adafruit PCA9548 I2C mux (5626) | 1 | Spare (the tunnel now reads HX711s, which need no mux)
STEMMA QT 300 mm cables (5384) | 6 | Spares (rev 4 has no QT-to-QT runs)
Estes Pro Series II launch rail (6 ft) + controller | 1 | Launch system (stated on hand)
Adafruit load cells 1 kg x2, 5 kg x2; HX711 x4; calibration weights | 1 | 2 HX711 + the weights run the tunnel balance (with 2 new 100 g TAL221s; the 1 kg cells are too coarse for 1-5 g fin loads)
Filament: PC-FR, PETG-CF, ASA (black), ASA-Aero, PLA | 1 | Plenum/MMT/retainer (PC-FR), fins/hubs/deck (PETG-CF), tubes (ASA-Aero)
Heat-set insert kit M2-M6, J-B Weld, Kapton, 24 AWG silicone wire, heat-shrink, headers | 1 | Assembly
Nomex chute protector 12x12 in | 1 | Recovery bay
Estes 24 in rip-stop chute, aramid shock cord 19 ft | 1 | VERIFY these arrived (they were on the TVC cart)
Jerrod H tunnel STLs (Wind Tunnel/STEM+Tunnel+Promo+-+0.4n_stls) | 1 | Tunnel hardware is listed on the Wind Tunnel sheets
Mechatronics MS1238 120 mm fan | 1 | Spare; not used (the 8 in duct fan replaces it)

Sheet: Retired TVC stock
Owned but not used by the fin-control vehicle (resell / keep for other projects)
Item | Was used for
Feather RP2040 RFM95 x3, ADXL375, ground-station Feather, 915 MHz whips | Rev 3 avionics; rev 4 runs on a Teensy 4.1 with no radio and no high-g accelerometer (never bought)
EMAX ES08MA II servos | TVC gimbal; too tall for the single servo ring (needs <= 17 mm body height around the central bypass)
MR105-2RS bearings, M2 rod-end ball links | TVC gimbal linkage
Electromagnets (TOMSHIELE, AIRTAK), N52 magnets, IRF520, 1N4007, 12 V PSU | Magnetic TVC stand
TMAG5273 Hall sensor, Arduino Nano | Magnetic-gimbal sensing / solenoid DAQ
VL53L4CD ToF x6 | Unused in both revisions
301 SS foil | TVC balance flexures
