swaroopsahoo4908/GTR70E-WYVERN/_to_delete/wyv_md5_bom2.txt

6b4559ddfe0b692eb47dad66345bab88  ./Documentation/WYVERN_BOM.xlsx
b8b9cc1de2500d8ead7d304c94207598  ./Documentation/build_bom.py
72bc75662bb15ea529b56fc2a3cb0a28  ./Documentation/Wind_Tunnel_Adaptation.md
a3a385e114749217a3ef025b8282c329  ./Documentation/Electronics_Telemetry.md
f0bd5499fa46fa77c54c393be90a1c1e  ./Documentation/Design_Overview.md
