swaroopsahoo4908/GTR70E-WYVERN/Past Iterations/WYVERN-E KiCad/FC100/jlcpcb/WYVERN-E_FC100_BOM.csv

Comment | Designator | Footprint | LCSC Part # | Manufacturer Part | Quantity
100nF | C1,C11,C12,C13,C14,C16,C19,C20,C21,C22,C24,C25,C26,C27,C28,C29,C30,C31,C32,C33,C37,C38,C39,C40,C43,C50,C63,C64,C65,C66,C67,C68,C69,C70,C71,C72,C73,C75,C76,C77,C78,C79,C80,C81,C82 | C0402 | C1525 | CL05B104KO5NNNC | 45
15pF | C2,C3 | C0402 | C1548 | 0402CG150J500NT | 2
18pF | C4,C5 | C0402 | C1549 | 0402CG180J500NT | 2
1nF 50V | C6 | C0402 | C1523 | 0402B102K500NT | 1
4.7uF 16V | C7 | C0603 | C19666 | CL10A475KO8NNNC | 1
150pF NP0 | C8 | C0603 | C107038 | CC0603JRNPO9BN151 | 1
5.6nF | C9 | C0402 | C281760 | CC0402KRX7R9BB562 | 1
2200uF 25V | C10 | CAP-TH_BD13.0-P5.00-D1.2-FD | C44598 | KM228M025J20RR0VH2FP0 | 1
47nF 50V | C17,C18 | C0402 | C82219 | 0402B473K500NT | 2
10nF | C23 | C0402 | C15195 | CL05B103KB5NNNC | 1
22uF | C35,C55,C56,C57,C58 | C0805 | C45783 | CL21A226MAQNNNE | 5
10uF | C36,C41,C42,C44,C45,C46,C47,C48,C49,C51,C52,C53,C54,C74 | C0805 | C15850 | CL21A106KAYNNNE | 14
75pF | C59 | C0402 | C107010 | CC0402JRNPO9BN750 | 1
4.7uF | C60,C61,C62 | C0402 | C23733 | CL05A475MP5NRNC | 3
TF-01A | CARD1 | TF-SMD_TF-01A | C91145 | TF-01A | 1
XT30UPB-M | CN1 | CONN-TH_XT30UPB-M | C428721 | XT30UPB-M | 1
BZT52C3V3 | D1,D2 | SOD-123_L2.7-W1.6-LS3.7-RD | C173413 | BZT52C3V3 | 2
2011-1X14G00SB | H1 | HDR-TH_14P-P2.54-V-M_4 | C49569637 | 2011-1X14G00SB | 1
3.3uH | L1 | L_Wuerth_PMFI-201610 | C42411119 | AOTA-B201610S3R3-101-T | 1
2.2uH | L2 | IND-SMD_L2.5-W2.0_MHCHL2520 | C5832372 | FTC252012S2R2MBCA | 1
10uH | L3 | L_Sunlord_SWPA6045S | C79272 | SWPA6045S100MT | 1
2.2uH | L4 | IND-SMD_L4.0-W4.0 | C602029 | FHD4020S-2R2MT | 1
KT-0603R | LED1,LED2 | LED-SMD_L1.6-W0.8-R-RD | C2286 | KT-0603R | 2
AO3400A | Q1,Q2 | SOT-23-3_L2.9-W1.3-P1.90-LS2.4-BR | C20917 | AO3400A | 2
10k NTC | R1 | R0603 | C13564 | NCP18XH103F03RB | 1
33k | R2,R16,R18 | R0402 | C25779 | 0402WGF3302TCE | 3
10mΩ | R3,R7 | R0603 | C158899 | RTT03R010FTP | 2
47k | R4 | R0402 | C25792 | 0402WGF4702TCE | 1
27k | R5 | R0402 | C25771 | 0402WGF2702TCE | 1
20k | R6 | R0402 | C25765 | 0402WGF2002TCE | 1
2.2k | R8 | R0402 | C25879 | 0402WGF2201TCE | 1
330 | R9 | R0402 | C25104 | 0402WGF3300TCE | 1
4.3k | R10 | R0603 | C23159 | 0603WAF4301T5E | 1
1k | R11,R13,R47,R48 | R0402 | C11702 | 0402WGF1001TCE | 4
8.2k | R12 | R0603 | C25981 | 0603WAF8201T5E | 1
10k | R14,R15,R17,R19,R20,R31,R32 | R0402 | C25744 | 0402WGF1002TCE | 7
4.7k | R36,R37,R38,R39 | R0402 | C25900 | 0402WGF4701TCE | 4
5.1k | R40,R41,R44 | R0402 | C25905 | 0402WGF5101TCE | 3
27 | R42,R43 | R0402 | C25156 | 0402WGJ0270TCE | 2
30k | R45 | R0402 | C138008 | RC0402FR-0730KL | 1
33 | R46 | R0402 | C25105 | 0402WGF330JTCE | 1
RP2350B | U1 | QFN-80_L10.0-W10.0-P0.40-TL-EP3.4 | C42415655 | RP2350B | 1
BQ25798RQMR | U3 | QFN-29_L4.0-W4.0-P0.40-TL-BQ25792RQMR | C2876593 | BQ25798RQMR | 1
TPS563201DDCR | U4 | SOT-23-6_L2.9-W1.6-P0.95-LS2.8-BR | C116592 | TPS563201DDCR | 1
TPS54202DDCR | U5 | SOT-23-6_L2.9-W1.6-P0.95-LS2.8-BL | C191884 | TPS54202DDCR | 1
W25Q128JVSIQ | U6 | SOIC-8_L5.3-W5.3-P1.27-LS8.0-BL | C97521 | W25Q128JVSIQ | 1
APS6404L-3SQR-ZR | U7 | USON-8_L3.0-W2.0-P0.50-BL-EP | C3040877 | APS6404L-3SQR-ZR | 1
INA226AIDGSR | U8,U9 | MSOP-10_L3.0-W3.0-P0.50-LS5.0-BL | C49851 | INA226AIDGSR | 2
LPS22HBTR | U10 | HLGA-10L_LPS22HBTR | C94049 | LPS22HBTR | 1
BME680 | U11 | LGA-8_L3.0-W3.0-P0.80-TR | C125972 | BME680 | 1
MCP23008-E/SO | U12 | SOIC-18_L11.6-W7.5-P1.27-LS10.3-BL | C92253 | MCP23008-E/SO | 1
LIS3MDLTR | U13 | LGA-12_L2.0-W2.0-P0.50-BL | C478483 | LIS3MDLTR | 1
LSM9DS1TR | U14 | LGA-24_L3.5-W3.0-P0.43-TL | C2655096 | LSM9DS1TR | 1
BNO055 | U15 | LGA-28_L5.2-W3.8-P0.50-BL | C93216 | BNO055 | 1
EVQ-Q2P02W | U16,U22,U35 | SW-SMD_4P-L6.5-W6.0-P4.00-LS6.6-TL | C2680625 | EVQ-Q2P02W | 3
IM63D135AXTMA1 | U17 | MIC-SMD_5P-L3.5-W2.7_IM66D130AXTMA1 | C41574995 | IM63D135AXTMA1 | 1
ADAU1450WBCPZ-RL | U18 | LFCSP-72_L10.0-W9.8-P0.50-LS10.2-TL-EP5.5 | C654399 | ADAU1450WBCPZ-RL | 1
B3B-XH-A(LF)(SN) | U19,U23,U24,U25,U26,U27,U28,U29,U30 | CONN-TH_3P-P2.50_A2501WV2-3P | C144394 | B3B-XH-A(LF)(SN) | 9
2.54-1*4 | U20,U31,U32 | HDR-TH_4P-P2.54-V-M-1 | C5116483 | 2.54-1*4 | 3
KF128-5.0-2P | U21,U33 | CONN-TH_P5.00_KF128-5.0-2P | C474950 | KF128-5.0-2P | 2
AMS1117-1.2 | U34 | SOT-223-3_TabPin2 | C347218 | AMS1117-1.2 | 1
TYPE-C-31-M-12 | USBC1 | USB-C_SMD-TYPE-C-31-M-12_1 | C165948 | TYPE-C-31-M-12 | 1
12MHz | X1 | CRYSTAL-SMD_4P-L3.2-W2.5-BL | C20625731 | ABM8-272-T3 | 1
12.288MHz | X2 | CRYSTAL-SMD_4P-L3.2-W2.5-BL | C519811 | NX3225GA-12.288MHz-STD-CRG-2 | 1
