swaroopsahoo4908/GTR70E-WYVERN/TVC ARCHIVED/3D parts/_All Files.md

---
updated_at: 2026-08-11
---
# 3D parts, All Files

- [[Projects/Skylight/WYVERN/GTR70E WYVERN/WYVERN Project/3D parts/00_full_assembly.step]]
- [[Projects/Skylight/WYVERN/GTR70E WYVERN/WYVERN Project/3D parts/00_full_assembly.stl]]
- [[Projects/Skylight/WYVERN/GTR70E WYVERN/WYVERN Project/3D parts/01_nose_cone_ellipsoid_ASAAero.step]]
- [[Projects/Skylight/WYVERN/GTR70E WYVERN/WYVERN Project/3D parts/01_nose_cone_ellipsoid_ASAAero.stl]]
- [[Projects/Skylight/WYVERN/GTR70E WYVERN/WYVERN Project/3D parts/02_upper_bt_avionics_ASAAero.step]]
- [[Projects/Skylight/WYVERN/GTR70E WYVERN/WYVERN Project/3D parts/02_upper_bt_avionics_ASAAero.stl]]
- [[Projects/Skylight/WYVERN/GTR70E WYVERN/WYVERN Project/3D parts/03_lower_bt_chute_tvc_PETGCF.step]]
- [[Projects/Skylight/WYVERN/GTR70E WYVERN/WYVERN Project/3D parts/03_lower_bt_chute_tvc_PETGCF.stl]]
- [[Projects/Skylight/WYVERN/GTR70E WYVERN/WYVERN Project/3D parts/04_bulkhead_joint_PETGCF.step]]
- [[Projects/Skylight/WYVERN/GTR70E WYVERN/WYVERN Project/3D parts/04_bulkhead_joint_PETGCF.stl]]
- [[Projects/Skylight/WYVERN/GTR70E WYVERN/WYVERN Project/3D parts/05_motor_mount_29mm_PCFR.step]]
- [[Projects/Skylight/WYVERN/GTR70E WYVERN/WYVERN Project/3D parts/05_motor_mount_29mm_PCFR.stl]]
- [[Projects/Skylight/WYVERN/GTR70E WYVERN/WYVERN Project/3D parts/06_tvc_gimbal_2axis_PCFR.step]]
- [[Projects/Skylight/WYVERN/GTR70E WYVERN/WYVERN Project/3D parts/06_tvc_gimbal_2axis_PCFR.stl]]
- [[Projects/Skylight/WYVERN/GTR70E WYVERN/WYVERN Project/3D parts/07_fin_single_PETGCF.step]]
- [[Projects/Skylight/WYVERN/GTR70E WYVERN/WYVERN Project/3D parts/07_fin_single_PETGCF.stl]]
- [[Projects/Skylight/WYVERN/GTR70E WYVERN/WYVERN Project/3D parts/08_rail_button_1010_x2.step]]
- [[Projects/Skylight/WYVERN/GTR70E WYVERN/WYVERN Project/3D parts/08_rail_button_1010_x2.stl]]
