swaroopsahoo4908/GTR70E-WYVERN/TVC ARCHIVED/3D parts/_superseded/_All Files.md

---
updated_at: 2026-08-02
---
# _superseded, All Files

*Auto-generated index, every file and subfolder linked for vault graph connectivity.*

---

## Files

- [[Projects/Skylight/WYVERN/GTR70E WYVERN/WYVERN Project/3D parts/_superseded/01_nose_cone_PCFR.step]]
- [[Projects/Skylight/WYVERN/GTR70E WYVERN/WYVERN Project/3D parts/_superseded/01_nose_cone_PCFR.stl]]
- [[Projects/Skylight/WYVERN/GTR70E WYVERN/WYVERN Project/3D parts/_superseded/01_nose_cone_ellipsoid_PCFR.step]]
- [[Projects/Skylight/WYVERN/GTR70E WYVERN/WYVERN Project/3D parts/_superseded/01_nose_cone_ellipsoid_PCFR.stl]]
- [[Projects/Skylight/WYVERN/GTR70E WYVERN/WYVERN Project/3D parts/_superseded/05b_bulkhead_B_ASA.step]]
- [[Projects/Skylight/WYVERN/GTR70E WYVERN/WYVERN Project/3D parts/_superseded/05b_bulkhead_B_ASA.stl]]
- [[Projects/Skylight/WYVERN/GTR70E WYVERN/WYVERN Project/3D parts/_superseded/08b_fin_single_PCFR.step]]
- [[Projects/Skylight/WYVERN/GTR70E WYVERN/WYVERN Project/3D parts/_superseded/08b_fin_single_PCFR.stl]]
- [[Projects/Skylight/WYVERN/GTR70E WYVERN/WYVERN Project/3D parts/_superseded/README.md]]
