swaroopsahoo4908/GTR70E-WYVERN/TVC ARCHIVED/3D parts/MTVC/_All Files.md

---
updated_at: 2026-08-02
---
# MTVC, All Files

*Auto-generated index, every file and subfolder linked for vault graph connectivity.*

---

## Files

- [[Projects/Skylight/WYVERN/GTR70E WYVERN/WYVERN Project/3D parts/MTVC/MTVC Assembly - Casing V2 WHITE.gcode.3mf]]
- [[Projects/Skylight/WYVERN/GTR70E WYVERN/WYVERN Project/3D parts/MTVC/MTVC Assembly - Casing V3.stl]]
- [[Projects/Skylight/WYVERN/GTR70E WYVERN/WYVERN Project/3D parts/MTVC/MTVC Assembly - Casing.gcode.3mf]]
- [[Projects/Skylight/WYVERN/GTR70E WYVERN/WYVERN Project/3D parts/MTVC/MTVC Assembly - Solenoid Frame V3.stl]]
- [[Projects/Skylight/WYVERN/GTR70E WYVERN/WYVERN Project/3D parts/MTVC/MTVC Assembly - Solenoid Frame V4.stl]]
- [[Projects/Skylight/WYVERN/GTR70E WYVERN/WYVERN Project/3D parts/MTVC/MTVC Assembly - Testing Stand V3.stl]]
- [[Projects/Skylight/WYVERN/GTR70E WYVERN/WYVERN Project/3D parts/MTVC/MTVC Assembly - Tube.gcode.3mf]]
- [[Projects/Skylight/WYVERN/GTR70E WYVERN/WYVERN Project/3D parts/MTVC/MTVC Assembly - Upper V3.stl]]
- [[Projects/Skylight/WYVERN/GTR70E WYVERN/WYVERN Project/3D parts/MTVC/MTVC Assembly V2 BLACK.gcode.3mf]]
