swaroopsahoo4908/GTR70E-WYVERN/TVC ARCHIVED/Past Iterations/WYVERN-E 3.0/3D parts/_All Files.md

---
updated_at: 2026-07-30
---
# 3D parts — All Files

*Auto-generated index — every file in this folder linked for vault graph connectivity (re-index pass, 2026-07-30).*

---

## Linked Items (auto-added)

- [[Projects/Skylight/WYVERN/Past Iterations/WYVERN-E 3.0/3D parts/00_full_assembly.step]]
- [[Projects/Skylight/WYVERN/Past Iterations/WYVERN-E 3.0/3D parts/00_full_assembly.stl]]
- [[Projects/Skylight/WYVERN/Past Iterations/WYVERN-E 3.0/3D parts/01_nose_cone.step]]
- [[Projects/Skylight/WYVERN/Past Iterations/WYVERN-E 3.0/3D parts/01_nose_cone.stl]]
- [[Projects/Skylight/WYVERN/Past Iterations/WYVERN-E 3.0/3D parts/02_recovery_bay.step]]
- [[Projects/Skylight/WYVERN/Past Iterations/WYVERN-E 3.0/3D parts/02_recovery_bay.stl]]
- [[Projects/Skylight/WYVERN/Past Iterations/WYVERN-E 3.0/3D parts/03_avionics_bay.step]]
- [[Projects/Skylight/WYVERN/Past Iterations/WYVERN-E 3.0/3D parts/03_avionics_bay.stl]]
- [[Projects/Skylight/WYVERN/Past Iterations/WYVERN-E 3.0/3D parts/04_fc_pi5_mount.step]]
- [[Projects/Skylight/WYVERN/Past Iterations/WYVERN-E 3.0/3D parts/04_fc_pi5_mount.stl]]
- [[Projects/Skylight/WYVERN/Past Iterations/WYVERN-E 3.0/3D parts/04_pcb_internal_mount.step]]
- [[Projects/Skylight/WYVERN/Past Iterations/WYVERN-E 3.0/3D parts/04_pcb_internal_mount.stl]]
- [[Projects/Skylight/WYVERN/Past Iterations/WYVERN-E 3.0/3D parts/04b_fc_tvc_bulkhead.step]]
- [[Projects/Skylight/WYVERN/Past Iterations/WYVERN-E 3.0/3D parts/04b_fc_tvc_bulkhead.stl]]
- [[Projects/Skylight/WYVERN/Past Iterations/WYVERN-E 3.0/3D parts/05_stage2_tvc_bay.step]]
- [[Projects/Skylight/WYVERN/Past Iterations/WYVERN-E 3.0/3D parts/05_stage2_tvc_bay.stl]]
- [[Projects/Skylight/WYVERN/Past Iterations/WYVERN-E 3.0/3D parts/06_tvc_gimbal_mech.step]]
- [[Projects/Skylight/WYVERN/Past Iterations/WYVERN-E 3.0/3D parts/06_tvc_gimbal_mech.stl]]
- [[Projects/Skylight/WYVERN/Past Iterations/WYVERN-E 3.0/3D parts/07_interstage_coupler.step]]
- [[Projects/Skylight/WYVERN/Past Iterations/WYVERN-E 3.0/3D parts/07_interstage_coupler.stl]]
- [[Projects/Skylight/WYVERN/Past Iterations/WYVERN-E 3.0/3D parts/08_fin_single.step]]
- [[Projects/Skylight/WYVERN/Past Iterations/WYVERN-E 3.0/3D parts/08_fin_single.stl]]
- [[Projects/Skylight/WYVERN/Past Iterations/WYVERN-E 3.0/3D parts/09_stage1_booster_body.step]]
- [[Projects/Skylight/WYVERN/Past Iterations/WYVERN-E 3.0/3D parts/09_stage1_booster_body.stl]]
- [[Projects/Skylight/WYVERN/Past Iterations/WYVERN-E 3.0/3D parts/10_camera_pod_fairing.step]]
- [[Projects/Skylight/WYVERN/Past Iterations/WYVERN-E 3.0/3D parts/10_camera_pod_fairing.stl]]
- [[Projects/Skylight/WYVERN/Past Iterations/WYVERN-E 3.0/3D parts/11_outer_shell_full.step]]
- [[Projects/Skylight/WYVERN/Past Iterations/WYVERN-E 3.0/3D parts/11_outer_shell_full.stl]]
- [[Projects/Skylight/WYVERN/Past Iterations/WYVERN-E 3.0/3D parts/README.md]]
- [[Projects/Skylight/WYVERN/Past Iterations/WYVERN-E 3.0/3D parts/_generator/_All Files.md]]
