swaroopsahoo4908/GTR70E-WYVERN/TVC ARCHIVED/Past Iterations/WYVERN-E 1.0/CAD:Models:PCB/XRIM117_all_parts/_All Files.md

---
updated_at: 2026-05-27
---
# XRIM117_all_parts — All Files

*Complete index of all files in `Projects/WYVERN-E/CAD:Models:PCB/XRIM117_all_parts/`. Auto-generated — every file [[wikilinked]] for Obsidian graph connectivity.*

---

**Total files: 19**

## STL Files (19)

- [[01_nose_cone.stl]]
- [[02_bt1_chute_bay.stl]]
- [[03_bt2_mid_section.stl]]
- [[04_bt3_aft_section.stl]]
- [[05_bt4_booster_bay.stl]]
- [[06_fin_ring1_aft.stl]]
- [[07_fin_ring2_mid.stl]]
- [[08_motor_tube_38mm.stl]]
- [[09_motor_tube_29mm.stl]]
- [[10_cr_bt3_fwd.stl]]
- [[11_cr_bt3_mid.stl]]
- [[12_cr_bt3_aft.stl]]
- [[13_cr_bt4_fwd.stl]]
- [[14_cr_bt4_aft.stl]]
- [[15_tvc_outer_ring.stl]]
- [[16_tvc_inner_cradle.stl]]
- [[17_pcb_ccm.stl]]
- [[18_pcb_asam1.stl]]
- [[19_pcb_asam2.stl]]

## Linked Items (auto-added)

- [[Projects/Skylight/WYVERN/Past Iterations/WYVERN-E 1.0/CAD:Models:PCB/XRIM117_all_parts/01_nose_cone.stl]]
- [[Projects/Skylight/WYVERN/Past Iterations/WYVERN-E 1.0/CAD:Models:PCB/XRIM117_all_parts/02_bt1_chute_bay.stl]]
- [[Projects/Skylight/WYVERN/Past Iterations/WYVERN-E 1.0/CAD:Models:PCB/XRIM117_all_parts/03_bt2_mid_section.stl]]
- [[Projects/Skylight/WYVERN/Past Iterations/WYVERN-E 1.0/CAD:Models:PCB/XRIM117_all_parts/04_bt3_aft_section.stl]]
- [[Projects/Skylight/WYVERN/Past Iterations/WYVERN-E 1.0/CAD:Models:PCB/XRIM117_all_parts/05_bt4_booster_bay.stl]]
- [[Projects/Skylight/WYVERN/Past Iterations/WYVERN-E 1.0/CAD:Models:PCB/XRIM117_all_parts/06_fin_ring1_aft.stl]]
- [[Projects/Skylight/WYVERN/Past Iterations/WYVERN-E 1.0/CAD:Models:PCB/XRIM117_all_parts/07_fin_ring2_mid.stl]]
- [[Projects/Skylight/WYVERN/Past Iterations/WYVERN-E 1.0/CAD:Models:PCB/XRIM117_all_parts/08_motor_tube_38mm.stl]]
- [[Projects/Skylight/WYVERN/Past Iterations/WYVERN-E 1.0/CAD:Models:PCB/XRIM117_all_parts/09_motor_tube_29mm.stl]]
- [[Projects/Skylight/WYVERN/Past Iterations/WYVERN-E 1.0/CAD:Models:PCB/XRIM117_all_parts/10_cr_bt3_fwd.stl]]
- [[Projects/Skylight/WYVERN/Past Iterations/WYVERN-E 1.0/CAD:Models:PCB/XRIM117_all_parts/11_cr_bt3_mid.stl]]
- [[Projects/Skylight/WYVERN/Past Iterations/WYVERN-E 1.0/CAD:Models:PCB/XRIM117_all_parts/12_cr_bt3_aft.stl]]
- [[Projects/Skylight/WYVERN/Past Iterations/WYVERN-E 1.0/CAD:Models:PCB/XRIM117_all_parts/13_cr_bt4_fwd.stl]]
- [[Projects/Skylight/WYVERN/Past Iterations/WYVERN-E 1.0/CAD:Models:PCB/XRIM117_all_parts/14_cr_bt4_aft.stl]]
- [[Projects/Skylight/WYVERN/Past Iterations/WYVERN-E 1.0/CAD:Models:PCB/XRIM117_all_parts/15_tvc_outer_ring.stl]]
- [[Projects/Skylight/WYVERN/Past Iterations/WYVERN-E 1.0/CAD:Models:PCB/XRIM117_all_parts/16_tvc_inner_cradle.stl]]
- [[Projects/Skylight/WYVERN/Past Iterations/WYVERN-E 1.0/CAD:Models:PCB/XRIM117_all_parts/17_pcb_ccm.stl]]
- [[Projects/Skylight/WYVERN/Past Iterations/WYVERN-E 1.0/CAD:Models:PCB/XRIM117_all_parts/18_pcb_asam1.stl]]
- [[Projects/Skylight/WYVERN/Past Iterations/WYVERN-E 1.0/CAD:Models:PCB/XRIM117_all_parts/19_pcb_asam2.stl]]
- [[Projects/Skylight/WYVERN/Past Iterations/WYVERN-E 1.0/CAD:Models:PCB/XRIM117_all_parts/_All Files.md]]
- [[Projects/Skylight/WYVERN/Past Iterations/WYVERN-E 1.0/CAD:Models:PCB/XRIM117_all_parts/_RevC_RETIRED_FINS.md]]
