swaroopsahoo4908/GTR70E-WYVERN/TVC ARCHIVED/Past Iterations/WYVERN-E 1.0/Wind Tunnel/WindTunnel_all_parts/_All Files.md

---
updated_at: 2026-05-27
---
# WindTunnel_all_parts — All Files

*Complete index of all files in `Projects/WYVERN-E/Wind Tunnel/WindTunnel_all_parts/`. Auto-generated — every file [[wikilinked]] for Obsidian graph connectivity.*

---

**Total files: 23**

## Text Files (1)

- [[README.txt]]

## STL Files (22)

- [[01_bellmouth_inlet_120mm.stl]]
- [[02_settling_chamber_150mm.stl]]
- [[03_honeycomb_frame_50mm.stl]]
- [[04_screen_frame_40mm.stl]]
- [[05_smoke_strut_section_100mm.stl]]
- [[06A_contraction_cone_seg1_z0-150mm.stl]]
- [[06B_contraction_cone_seg2_z150-300mm.stl]]
- [[06C_contraction_cone_seg3_z300-450mm.stl]]
- [[06D_contraction_cone_seg4_z450-600mm.stl]]
- [[06E_contraction_cone_seg5_z600-750mm.stl]]
- [[06F_contraction_cone_seg6_z750-900mm.stl]]
- [[07A_test_section_167mm.stl]]
- [[07B_test_section_167mm.stl]]
- [[07C_test_section_166mm.stl]]
- [[08_diffuser_sq_to_circle_220mm.stl]]
- [[09_fan_housing_200mm_dia.stl]]
- [[10_fan_assembly_7blade.stl]]
- [[11_junction_ring_large_156sq_30mm.stl]]
- [[12_junction_ring_small_156sq_20mm.stl]]
- [[13_sting_mount_aoa_bracket.stl]]
- [[14_fin_module_clamp_half.stl]]
- [[WYVERN_WindTunnel_FullAssembly.stl]]

## Linked Items (auto-added)

- [[Projects/Skylight/WYVERN/Past Iterations/WYVERN-E 1.0/Wind Tunnel/WindTunnel_all_parts/01_bellmouth_inlet_120mm.stl]]
- [[Projects/Skylight/WYVERN/Past Iterations/WYVERN-E 1.0/Wind Tunnel/WindTunnel_all_parts/02_settling_chamber_150mm.stl]]
- [[Projects/Skylight/WYVERN/Past Iterations/WYVERN-E 1.0/Wind Tunnel/WindTunnel_all_parts/03_honeycomb_frame_50mm.stl]]
- [[Projects/Skylight/WYVERN/Past Iterations/WYVERN-E 1.0/Wind Tunnel/WindTunnel_all_parts/04_screen_frame_40mm.stl]]
- [[Projects/Skylight/WYVERN/Past Iterations/WYVERN-E 1.0/Wind Tunnel/WindTunnel_all_parts/05_smoke_strut_section_100mm.stl]]
- [[Projects/Skylight/WYVERN/Past Iterations/WYVERN-E 1.0/Wind Tunnel/WindTunnel_all_parts/06A_contraction_cone_seg1_z0-150mm.stl]]
- [[Projects/Skylight/WYVERN/Past Iterations/WYVERN-E 1.0/Wind Tunnel/WindTunnel_all_parts/06B_contraction_cone_seg2_z150-300mm.stl]]
- [[Projects/Skylight/WYVERN/Past Iterations/WYVERN-E 1.0/Wind Tunnel/WindTunnel_all_parts/06C_contraction_cone_seg3_z300-450mm.stl]]
- [[Projects/Skylight/WYVERN/Past Iterations/WYVERN-E 1.0/Wind Tunnel/WindTunnel_all_parts/06D_contraction_cone_seg4_z450-600mm.stl]]
- [[Projects/Skylight/WYVERN/Past Iterations/WYVERN-E 1.0/Wind Tunnel/WindTunnel_all_parts/06E_contraction_cone_seg5_z600-750mm.stl]]
- [[Projects/Skylight/WYVERN/Past Iterations/WYVERN-E 1.0/Wind Tunnel/WindTunnel_all_parts/06F_contraction_cone_seg6_z750-900mm.stl]]
- [[Projects/Skylight/WYVERN/Past Iterations/WYVERN-E 1.0/Wind Tunnel/WindTunnel_all_parts/07A_test_section_167mm.stl]]
- [[Projects/Skylight/WYVERN/Past Iterations/WYVERN-E 1.0/Wind Tunnel/WindTunnel_all_parts/07B_test_section_167mm.stl]]
- [[Projects/Skylight/WYVERN/Past Iterations/WYVERN-E 1.0/Wind Tunnel/WindTunnel_all_parts/07C_test_section_166mm.stl]]
- [[Projects/Skylight/WYVERN/Past Iterations/WYVERN-E 1.0/Wind Tunnel/WindTunnel_all_parts/08_diffuser_sq_to_circle_220mm.stl]]
- [[Projects/Skylight/WYVERN/Past Iterations/WYVERN-E 1.0/Wind Tunnel/WindTunnel_all_parts/09_fan_housing_200mm_dia.stl]]
- [[Projects/Skylight/WYVERN/Past Iterations/WYVERN-E 1.0/Wind Tunnel/WindTunnel_all_parts/10_fan_assembly_7blade.stl]]
- [[Projects/Skylight/WYVERN/Past Iterations/WYVERN-E 1.0/Wind Tunnel/WindTunnel_all_parts/11_junction_ring_large_156sq_30mm.stl]]
- [[Projects/Skylight/WYVERN/Past Iterations/WYVERN-E 1.0/Wind Tunnel/WindTunnel_all_parts/12_junction_ring_small_156sq_20mm.stl]]
- [[Projects/Skylight/WYVERN/Past Iterations/WYVERN-E 1.0/Wind Tunnel/WindTunnel_all_parts/13_sting_mount_aoa_bracket.stl]]
- [[Projects/Skylight/WYVERN/Past Iterations/WYVERN-E 1.0/Wind Tunnel/WindTunnel_all_parts/14_fin_module_clamp_half.stl]]
- [[Projects/Skylight/WYVERN/Past Iterations/WYVERN-E 1.0/Wind Tunnel/WindTunnel_all_parts/README.txt]]
- [[Projects/Skylight/WYVERN/Past Iterations/WYVERN-E 1.0/Wind Tunnel/WindTunnel_all_parts/WYVERN_WindTunnel_FullAssembly.stl]]
- [[Projects/Skylight/WYVERN/Past Iterations/WYVERN-E 1.0/Wind Tunnel/WindTunnel_all_parts/_All Files.md]]
- [[Projects/Skylight/WYVERN/Past Iterations/WYVERN-E 1.0/Wind Tunnel/WindTunnel_all_parts/_All Files.md.edtz]]
