swaroopsahoo4908/GTR70E-WYVERN/TVC ARCHIVED/Past Iterations/WYVERN-E 3.0/Wind Tunnel/modular-wind-tunnel-for-stem-education-model_files/Test Section Components/_All Files.md

---
updated_at: 2026-07-30
---
# Test Section Components — All Files

*Auto-generated index — every file in this folder linked for vault graph connectivity (re-index pass, 2026-07-30).*

---

## Linked Items (auto-added)

- [[Projects/Skylight/WYVERN/Past Iterations/WYVERN-E 3.0/Wind Tunnel/modular-wind-tunnel-for-stem-education-model_files/Test Section Components/debris-catcher-2-objects-as-for-honeycomb.stl]]
- [[Projects/Skylight/WYVERN/Past Iterations/WYVERN-E 3.0/Wind Tunnel/modular-wind-tunnel-for-stem-education-model_files/Test Section Components/laser-sheet-module-dovetail-ceiling-frame.stl]]
- [[Projects/Skylight/WYVERN/Past Iterations/WYVERN-E 3.0/Wind Tunnel/modular-wind-tunnel-for-stem-education-model_files/Test Section Components/laser-sheet-module-gantry.stl]]
- [[Projects/Skylight/WYVERN/Past Iterations/WYVERN-E 3.0/Wind Tunnel/modular-wind-tunnel-for-stem-education-model_files/Test Section Components/led-module-dovetail-ceiling.stl]]
- [[Projects/Skylight/WYVERN/Past Iterations/WYVERN-E 3.0/Wind Tunnel/modular-wind-tunnel-for-stem-education-model_files/Test Section Components/led-module-dovetail-power-switch-extension.stl]]
- [[Projects/Skylight/WYVERN/Past Iterations/WYVERN-E 3.0/Wind Tunnel/modular-wind-tunnel-for-stem-education-model_files/Test Section Components/led-module-dovetail-retainer-for-aputure-mc.stl]]
- [[Projects/Skylight/WYVERN/Past Iterations/WYVERN-E 3.0/Wind Tunnel/modular-wind-tunnel-for-stem-education-model_files/Test Section Components/test-section-acrylic-window-or-blank-wall.stl]]
- [[Projects/Skylight/WYVERN/Past Iterations/WYVERN-E 3.0/Wind Tunnel/modular-wind-tunnel-for-stem-education-model_files/Test Section Components/test-section-floor-with-gridfinity-model-support.stl]]
- [[Projects/Skylight/WYVERN/Past Iterations/WYVERN-E 3.0/Wind Tunnel/modular-wind-tunnel-for-stem-education-model_files/Test Section Components/test-section-quick-release-latch.stl]]
