swaroopsahoo4908/GTR70E-WYVERN/TVC ARCHIVED/3D parts/_generator/_All Files.md

---
updated_at: 2026-08-02
---
# _generator, All Files

*Auto-generated index, every file and subfolder linked for vault graph connectivity.*

---

## Files

- [[Projects/Skylight/WYVERN/GTR70E WYVERN/WYVERN Project/3D parts/_generator/gen_rocket4.py]]
- [[Projects/Skylight/WYVERN/GTR70E WYVERN/WYVERN Project/3D parts/_generator/mass_report.json]]
- [[Projects/Skylight/WYVERN/GTR70E WYVERN/WYVERN Project/3D parts/_generator/wcad.py]]
