swaroopsahoo4908/GTR70E-WYVERN/Documentation/diagrams/D7_wind_tunnel_parts.png

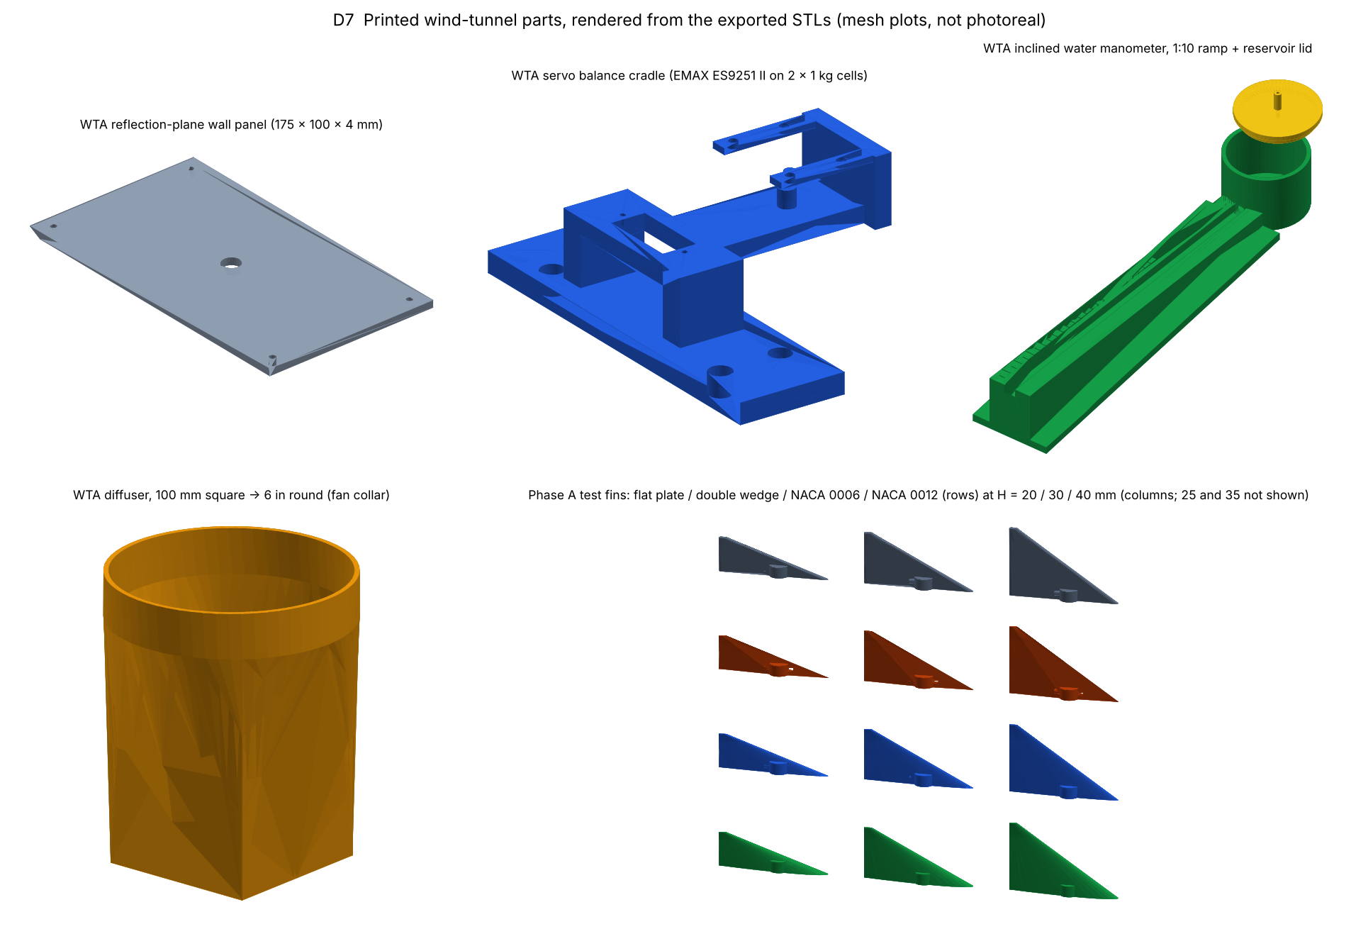
Documentation/diagrams/D7_wind_tunnel_parts.png
