swaroopsahoo4908/GTR70E-WYVERN/3D parts/assembly/GTR70E_WYVERN_fin_assembly.step

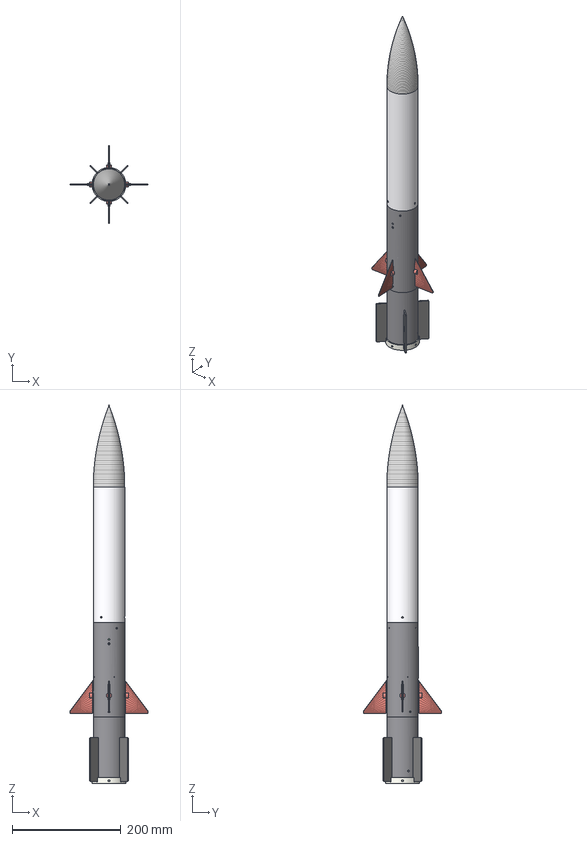
[picture p43: CAD file, 2026-11-10]
3D parts/assembly/GTR70E_WYVERN_fin_assembly.step
143.7 x 143.7 x 696.0 mm
nose
rb
rbc
ct
imu
spine
mb
plenum
mmt
ret
hub0
hub1
hub2
hub3
rfin0
rfin1
rfin2
rfin3
cfin0
cfin1
cfin2
cfin3
bypass_tube_PCFR
servo_0
servo_90
servo_180
servo_270
