swaroopsahoo4908/GTR70E-WYVERN/3D parts/assembly/GTR70E_WYVERN_fit_assembly.step

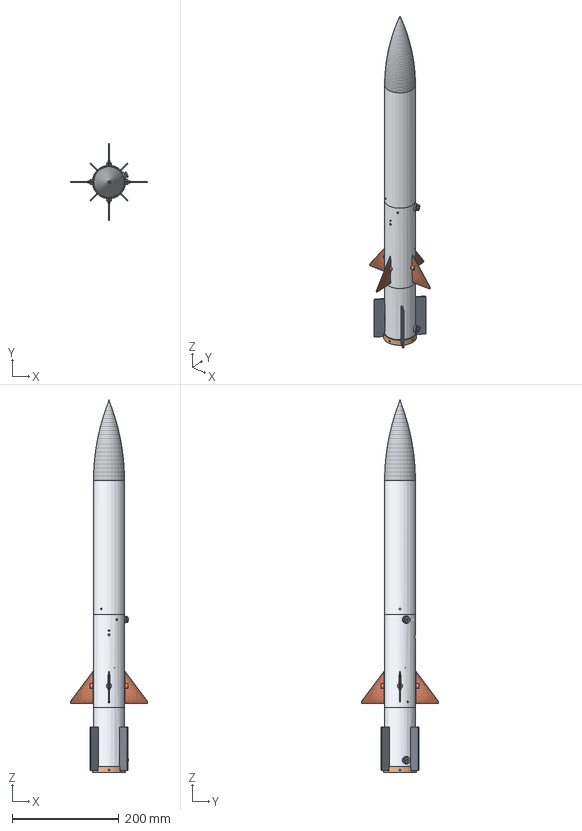
[picture p44: CAD file, 2026-11-10]
3D parts/assembly/GTR70E_WYVERN_fit_assembly.step
143.7 x 143.7 x 696.0 mm
01_nose_tangent_ogive_150_ASAAero
02_recovery_bay_tube_ASAAero
03_rb_floor_coupler_PCFR
04_control_tube_servo_ring_ASAAero
05_spine_deck_PETGCF
05b_avionics_spine_PETGCF
07_motor_bay_tube_ASAAero
08_plenum_bulkhead_PCFR
09_motor_mount_tube_aft_ring_PCFR
10_motor_retainer_cap_PCFR
14_bypass_tube_PCFR
servo_hub_az0
control_fin_az0
servo_hub_az90
control_fin_az90
servo_hub_az180
control_fin_az180
servo_hub_az270
control_fin_az270
stabilizer_0
stabilizer_1
stabilizer_2
stabilizer_3
rail_button_printed_lower
rail_button_printed_upper
EMAX_ES9251II_az0
servo_horn_az0
EMAX_ES9251II_az90
servo_horn_az90
EMAX_ES9251II_az180
servo_horn_az180
EMAX_ES9251II_az270
servo_horn_az270
bno085
pico2w
bme688
bmp388
microsd
lipo_2S_450
perfboard_16x62
adafruit_MPM3610_buck
adafruit_MPM3610_buck_servo
cap_470uF_under_board
pololu_2810_switch
arm_button_6mm
arm_led_3mm
AeroTech_F42-4T
chute_24in_packed
shock_cord_bundle
nose_ballast_pour
