swaroopsahoo4908/GTR70E-WYVERN/3D parts/assembly/fit_meshes/control_fin_az180.stl

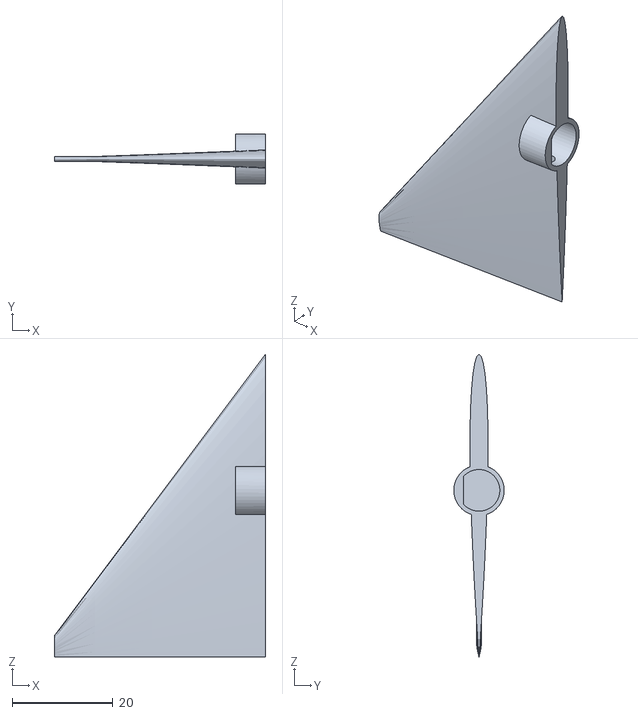
[picture p45: CAD file, 2026-11-10]
3D parts/assembly/fit_meshes/control_fin_az180.stl
41.8 x 9.99 x 60.0
