swaroopsahoo4908/GTR70E-WYVERN/3D parts/flight/12_rect_fin_PETGCF_x4.step

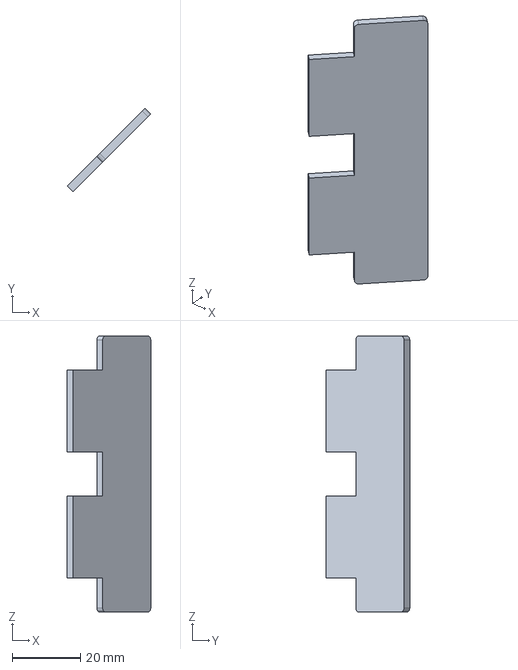
[picture p49: CAD file, 2026-11-10]
3D parts/flight/12_rect_fin_PETGCF_x4.step
24.5 x 24.5 x 81.0 mm
