swaroopsahoo4908/GTR70E-WYVERN/3D parts/wind_tunnel/WTB_slot_plug_x8_PETG.step

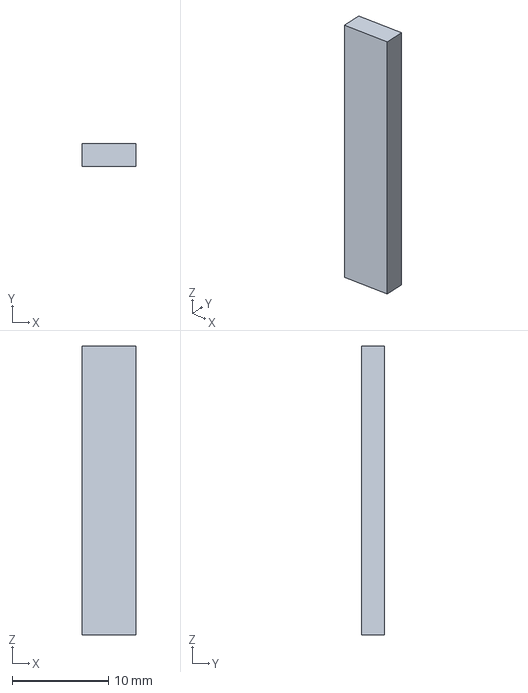
[picture p50: CAD file, 2026-11-10]
3D parts/wind_tunnel/WTB_slot_plug_x8_PETG.step
5.60 x 2.40 x 30.0 mm
