swaroopsahoo4908/GTR70E-WYVERN/_to_delete/13_rail_button_spacer_PETGCF_x2.step

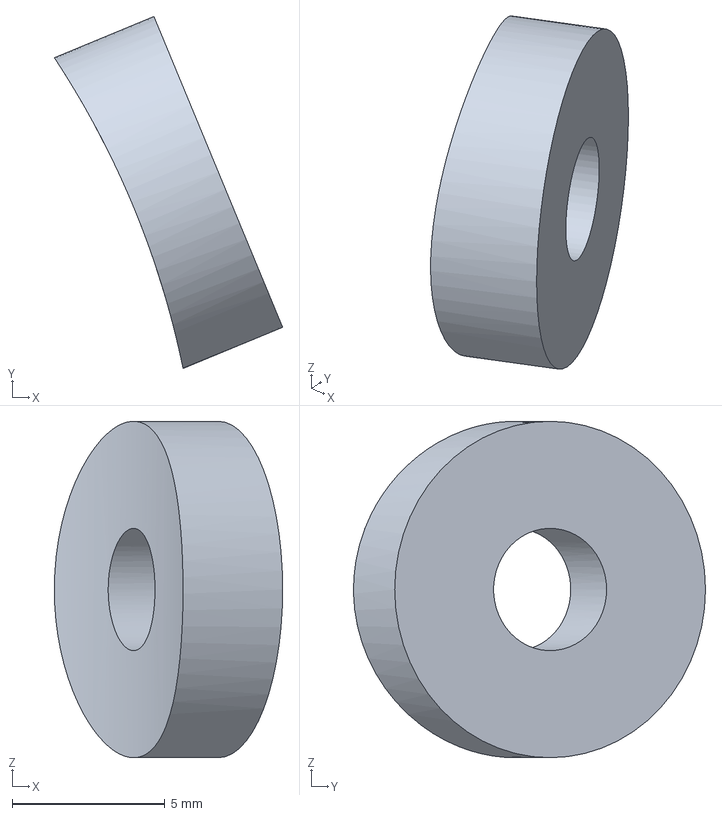
[picture p51: CAD file, 2026-11-10]
_to_delete/13_rail_button_spacer_PETGCF_x2.step
7.47 x 11.5 x 11.0 mm
