swaroopsahoo4908/GTR70E-WYVERN/_to_delete/stale/WTA_diffuser_100sq_to_8in_round_PETG.step

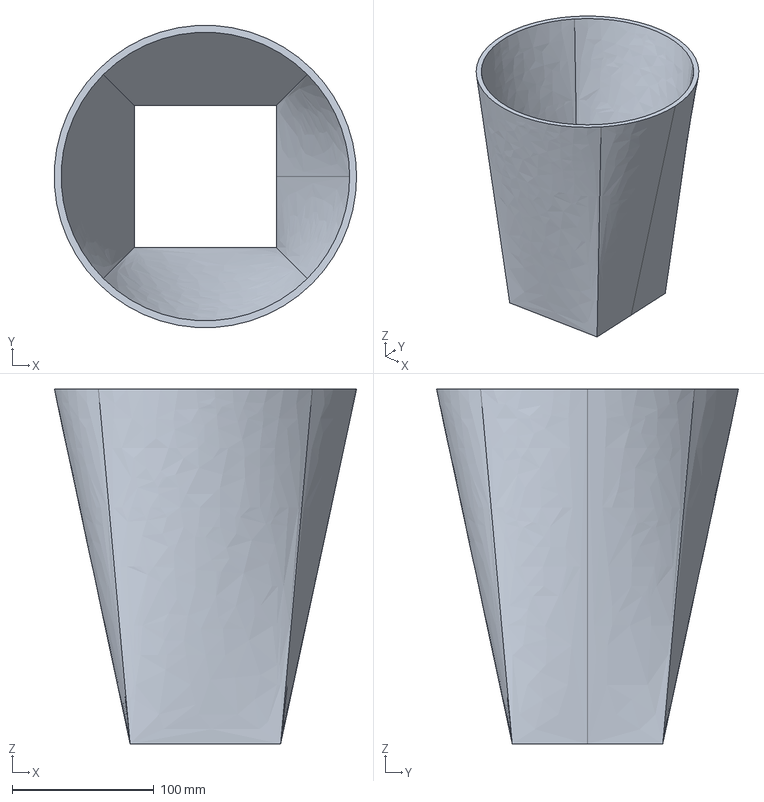
[picture p52: CAD file, 2026-11-10]
_to_delete/stale/WTA_diffuser_100sq_to_8in_round_PETG.step
212.8 x 212.6 x 250.0 mm
