swaroopsahoo4908/GTR70E-WYVERN/Past Iterations/WYVERN-E KiCad/FC100/3dmodels/USON-8_L2-W3-H0.6X0.5P.step

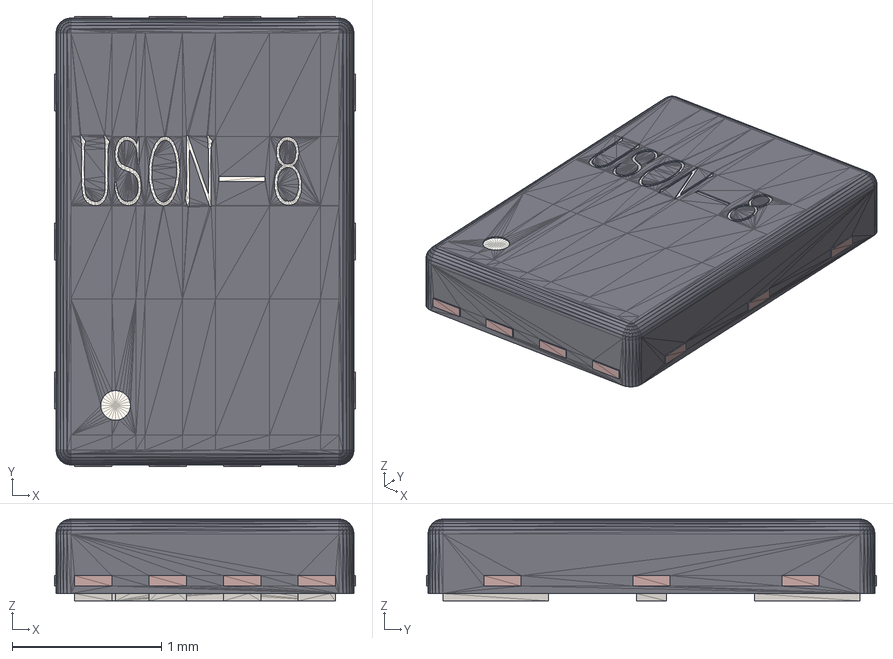
[picture p53: CAD file, 2026-10-14]
Past Iterations/WYVERN-E KiCad/FC100/3dmodels/USON-8_L2-W3-H0.6X0.5P.step
2.02 x 3.02 x 0.55 mm
s0
s1
s2
s3
s4
s5
s6
s7
s8
s9
