swaroopsahoo4908/GTR70E-WYVERN/Past Iterations/WYVERN-E KiCad/FC70/3dmodels/IND-SMD_L5.7-W5.1.step

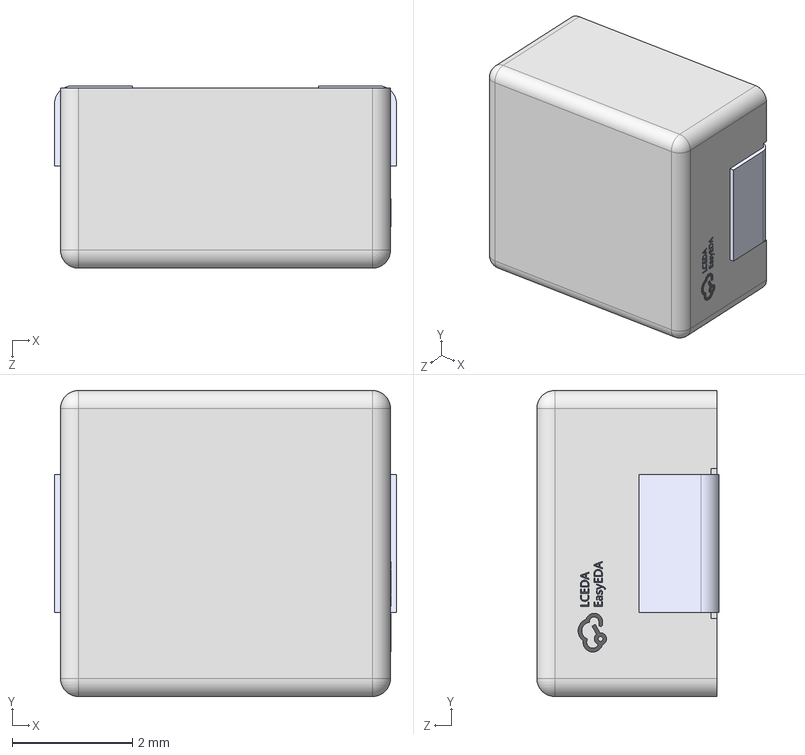
[picture p54: CAD file, 2026-10-14]
Past Iterations/WYVERN-E KiCad/FC70/3dmodels/IND-SMD_L5.7-W5.1.step
5.70 x 5.10 x 3.04 mm
