swaroopsahoo4908/GTR70E-WYVERN/Past Iterations/WYVERN-E KiCad/FC70/WYVERN-E_FC70.step

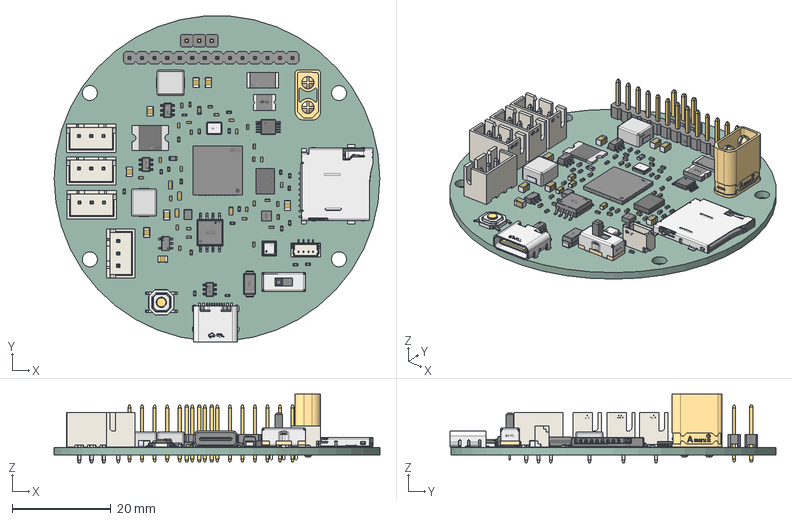
[picture p55: CAD file, 2026-10-14]
Past Iterations/WYVERN-E KiCad/FC70/WYVERN-E_FC70.step
66.0 x 66.1 x 13.9 mm
R0402_L1.0-W0.5-H0.4 x 21
CONN-TH_3P-P2.50_A2501WV2-3P x 4
R2512_L6.3-W3.2-H0.6
C0402_L1.0-W0.5-H0.5 x 30
C0805_L2.0-W1.3-H1.3 x 8
IND-SMD_L2.0-W1.6_AOTA-B201610S3R3-101-T
SOT-23-5_L2.9-W1.6-P0.95-LS2.8-BR
MSOP-10_L3.0-W3.0-H1.1-LS5.0-P0.50
LGA-28_L5.2-W3.8-H1.2-P0.50-BL
SOT-23-6_L2.9-W1.6-H1.5-LS2.8-P0.95 x 3
USB-C_SMD-TYPE-C-31-M-12
HDR-M-2.54_1X3
F1812_L4.5-W3.2-H1.0
HDR-TH_14P-P2.54-V-M_4
C0603_L1.6-W0.8-H0.8 x 4
SMA_L4.4-W2.6-LS5.0-RD
SW-SMD_4P-L5.1-W5.1-P3.70-LS6.5-TL_H1.5
OSC-SMD_L3.2-W1.5-H0.8
LGA-12_L2.0-W2.0-H1.0-P0.50
SOIC-8_L5.3-W5.3-H1.9-LS7.9-P1.27
R0603 x 2
零件3
IND-SMD_L5.7-W5.1 x 2
零件6
CONN-TH_XT30UPB-M
CONN-SMD_4P-L6.0-W2.9-H4.3-P1.0
F2920-1
QFN-80_L10.0-W10.0-P0.40-TL-EP3.4
TF-SMD_TF-01A
WYVERN-E_FC70_PCB
