swaroopsahoo4908/GTR70E-WYVERN/Simulations/CFD/simscale/geometry/R1_part_cfin_az270.stl

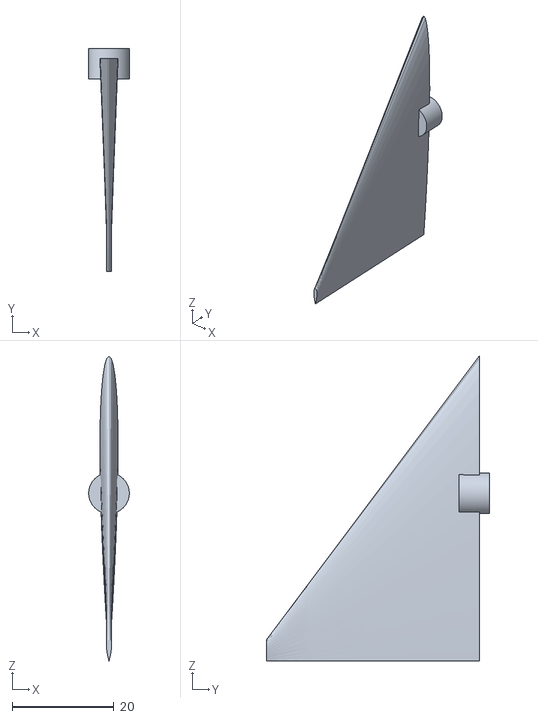
[picture p56: CAD file, 2026-11-10]
Simulations/CFD/simscale/geometry/R1_part_cfin_az270.stl
8.00 x 43.8 x 60.0
