swaroopsahoo4908/GTR70E-WYVERN/3D parts/assembly/fit_meshes/teensy41.stl

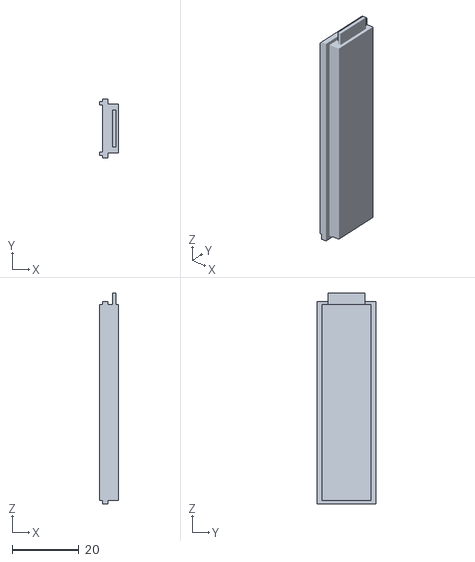
[picture p57: CAD file, 2026-11-10]
3D parts/assembly/fit_meshes/teensy41.stl
5.80 x 17.8 x 63.5
