swaroopsahoo4908/GTR70E-WYVERN/3D parts/control_fins/flat_plate/cfin_flat_plate_H35_PETGCF.step

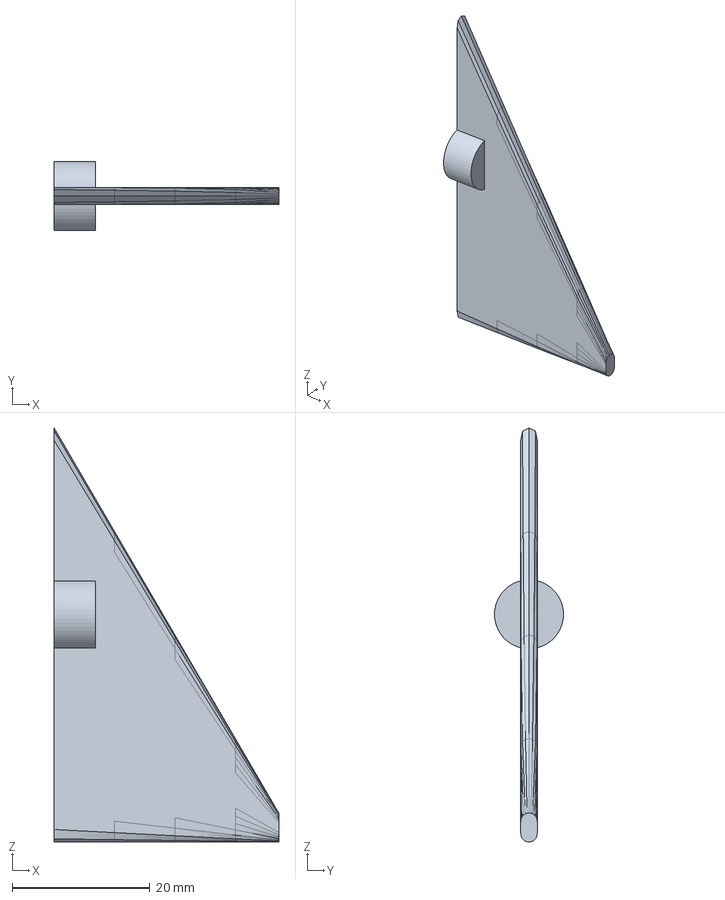
[picture p59: CAD file, 2026-11-10]
3D parts/control_fins/flat_plate/cfin_flat_plate_H35_PETGCF.step
32.5 x 10.0 x 60.0 mm
