swaroopsahoo4908/GTR70E-WYVERN/3D parts/flight/14_bypass_tube_PCFR.step

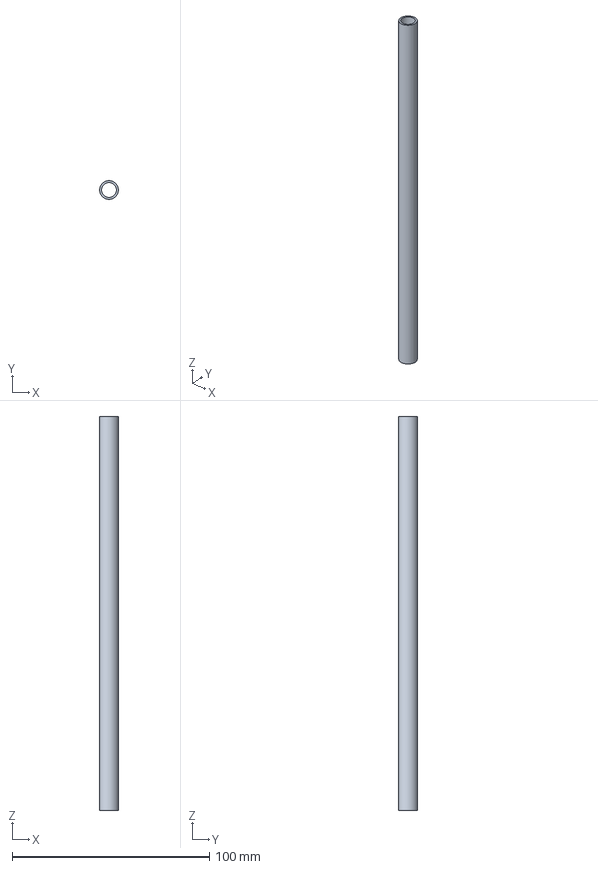
[picture p61: CAD file, 2026-11-10]
3D parts/flight/14_bypass_tube_PCFR.step
9.49 x 9.50 x 200.0 mm
