swaroopsahoo4908/GTR70E-WYVERN/3D parts/wind_tunnel/WTA_calibration_pulley_wheel_PETG.step

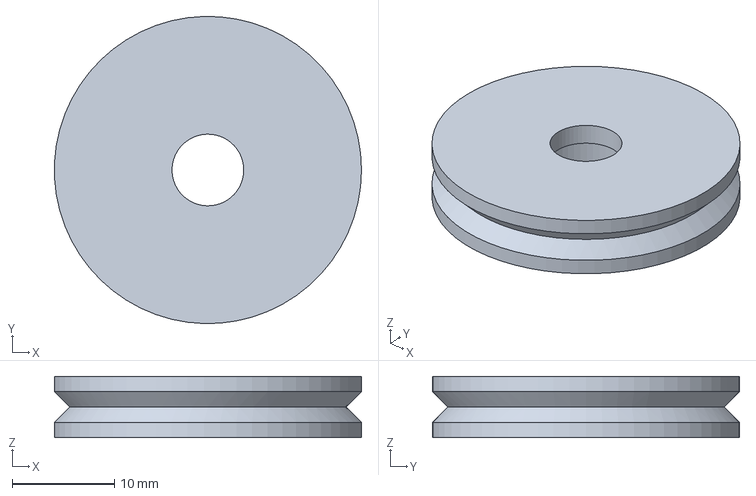
[picture p62: CAD file, 2026-11-10]
3D parts/wind_tunnel/WTA_calibration_pulley_wheel_PETG.step
30.0 x 30.0 x 6.00 mm
