swaroopsahoo4908/GTR70E-WYVERN/Past Iterations/WYVERN-E KiCad/FC100/3dmodels/SW-SMD_4P-L6.5-W6.0-P4.00-LS6.6-TL.step

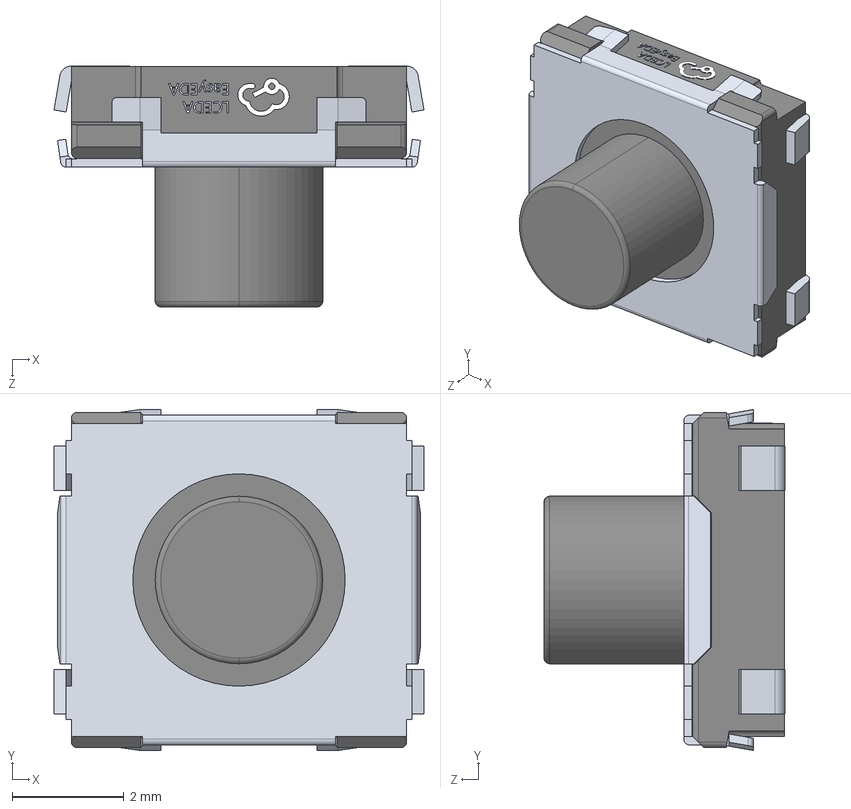
[picture p63: CAD file, 2026-10-14]
Past Iterations/WYVERN-E KiCad/FC100/3dmodels/SW-SMD_4P-L6.5-W6.0-P4.00-LS6.6-TL.step
6.62 x 6.10 x 4.31 mm
