swaroopsahoo4908/GTR70E-WYVERN/Past Iterations/WYVERN-E KiCad/FC70/3dmodels/LGA-8_L3.0-W3.0-H0.9-P0.80-TR.step

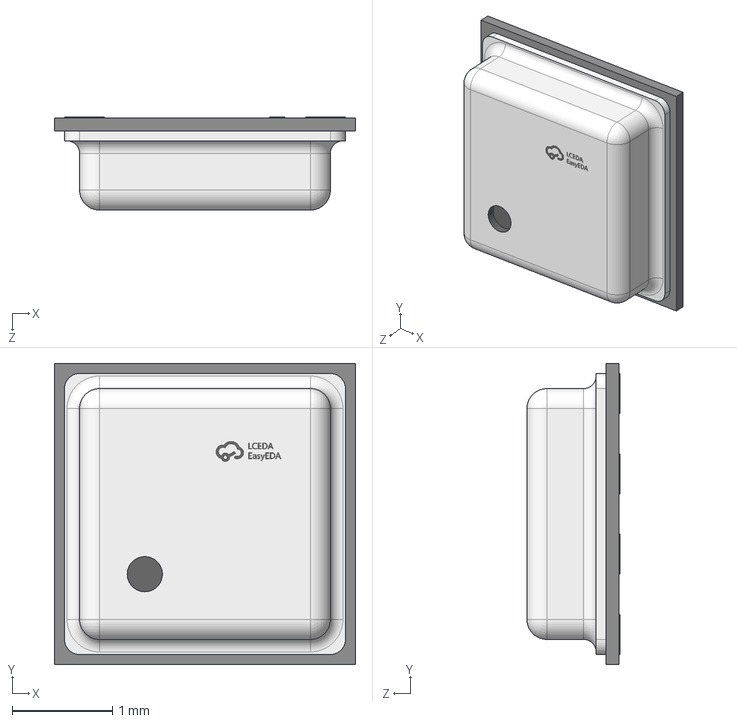
[picture p64: CAD file, 2026-10-14]
Past Iterations/WYVERN-E KiCad/FC70/3dmodels/LGA-8_L3.0-W3.0-H0.9-P0.80-TR.step
3.00 x 3.00 x 0.93 mm
