swaroopsahoo4908/GTR70E-WYVERN/Simulations/CFD/simscale/geometry/R3_part_cfin_az90.stl

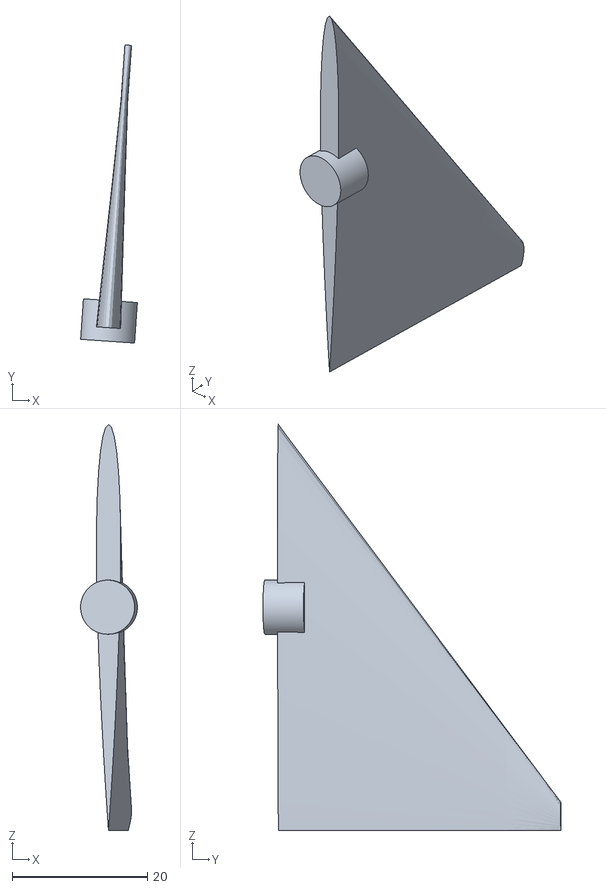
[picture p65: CAD file, 2026-11-10]
Simulations/CFD/simscale/geometry/R3_part_cfin_az90.stl
8.40 x 44.1 x 60.0
