swaroopsahoo4908/GTR70E-WYVERN/3D parts/assembly/fit_meshes/whip_915MHz_78mm.stl

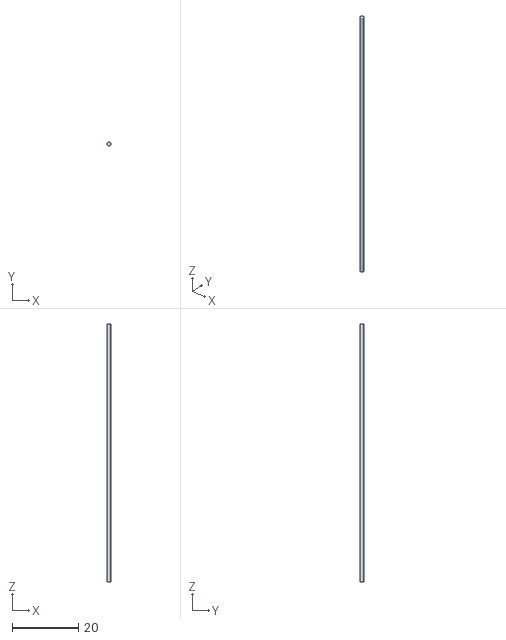
[picture p66: CAD file, 2026-11-10]
3D parts/assembly/fit_meshes/whip_915MHz_78mm.stl
1.20 x 1.20 x 78.0
