swaroopsahoo4908/GTR70E-WYVERN/3D parts/control_fins/flat_plate/cfin_flat_plate_H20_PETGCF.step

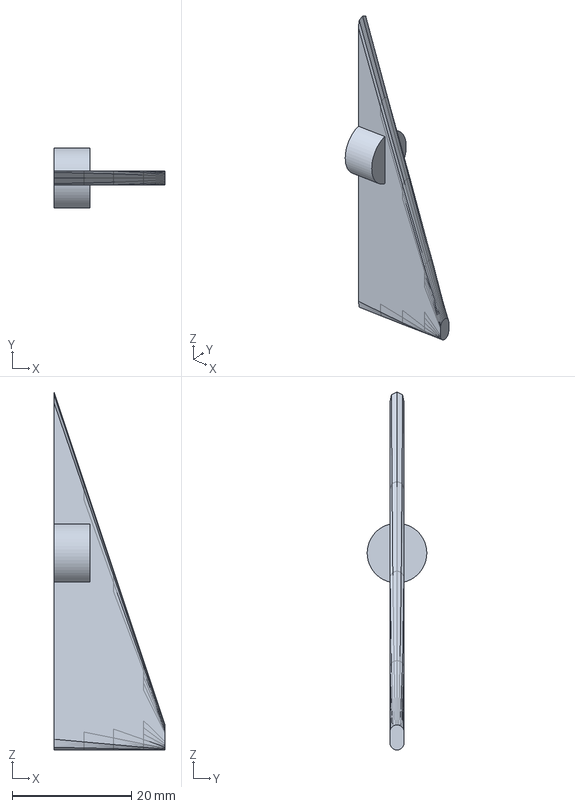
[picture p68: CAD file, 2026-11-10]
3D parts/control_fins/flat_plate/cfin_flat_plate_H20_PETGCF.step
18.6 x 10.0 x 60.0 mm
