swaroopsahoo4908/GTR70E-WYVERN/3D parts/control_fins/NACA0012/cfin_NACA0012_H45_PETGCF.step

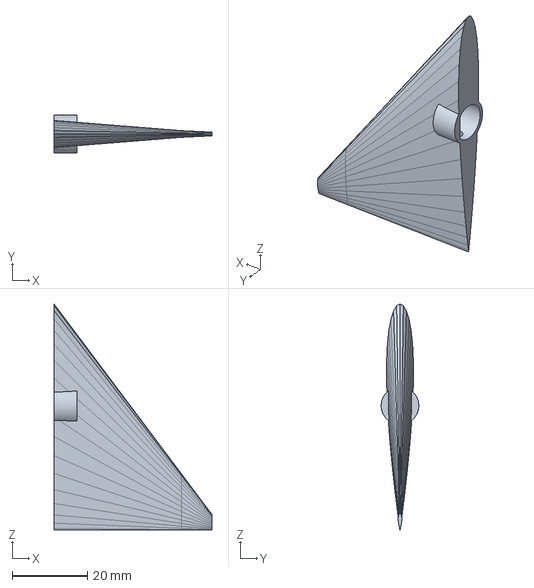
[picture p70: CAD file, 2026-11-10]
3D parts/control_fins/NACA0012/cfin_NACA0012_H45_PETGCF.step
41.8 x 9.99 x 60.0 mm
