swaroopsahoo4908/GTR70E-WYVERN/3D parts/flight/02_recovery_bay_tube_ASAAero.step

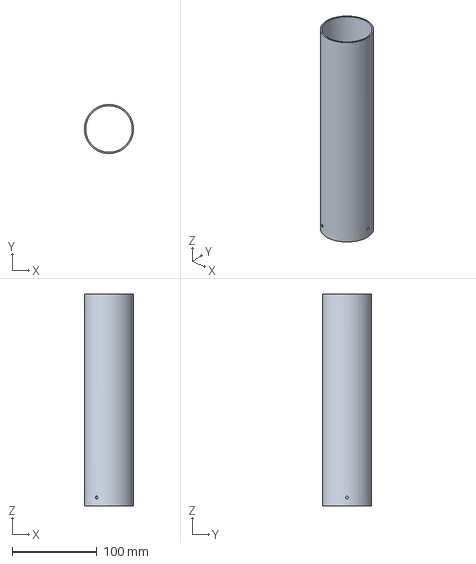
[picture p71: CAD file, 2026-11-10]
3D parts/flight/02_recovery_bay_tube_ASAAero.step
57.9 x 58.0 x 250.0 mm
