swaroopsahoo4908/GTR70E-WYVERN/3D parts/wind_tunnel/WTA_servo_balance_cradle_PETG.step

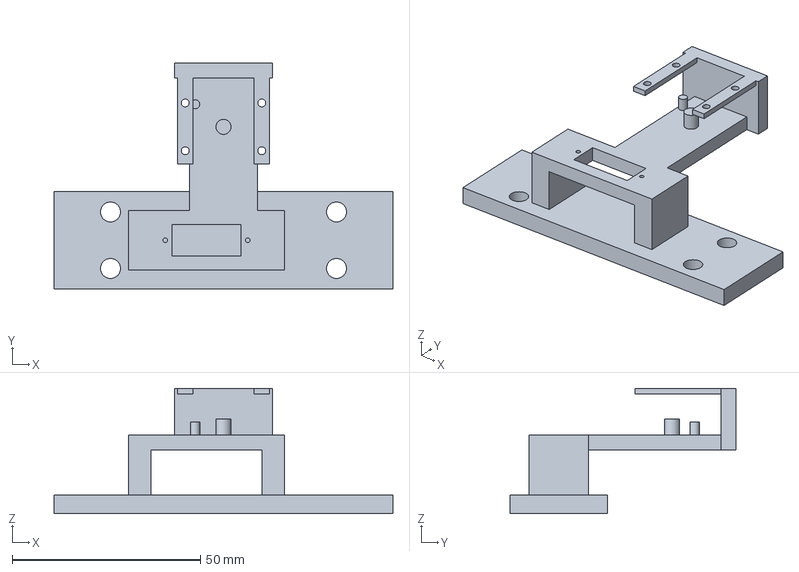
[picture p72: CAD file, 2026-11-10]
3D parts/wind_tunnel/WTA_servo_balance_cradle_PETG.step
90.0 x 60.1 x 33.3 mm
