swaroopsahoo4908/GTR70E-WYVERN/Past Iterations/WYVERN-E KiCad/FC100/3dmodels/MIC-SMD_5P-L3.5-W2.7_IM66D130AXTMA1.step

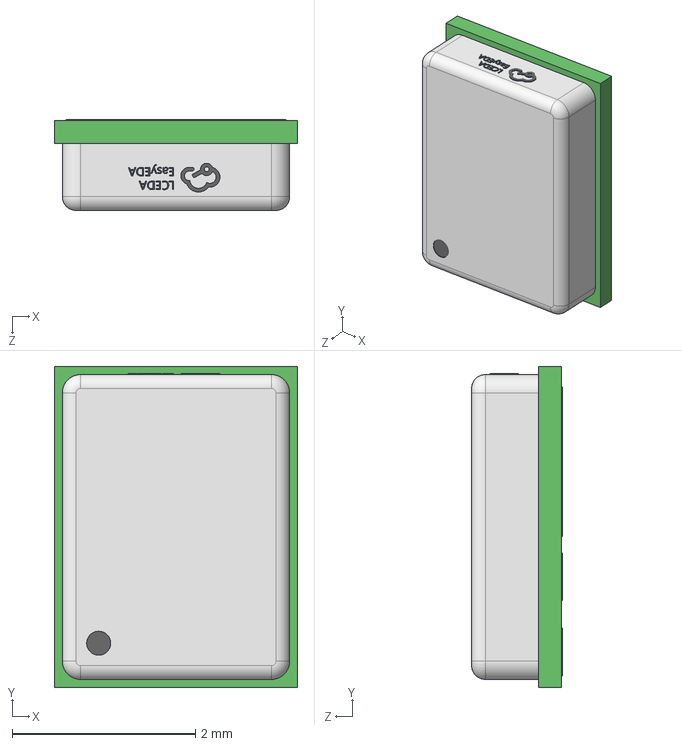
[picture p73: CAD file, 2026-10-14]
Past Iterations/WYVERN-E KiCad/FC100/3dmodels/MIC-SMD_5P-L3.5-W2.7_IM66D130AXTMA1.step
2.65 x 3.50 x 0.99 mm
