swaroopsahoo4908/GTR70E-WYVERN/Simulations/CFD/simscale/geometry/R1_solids.step

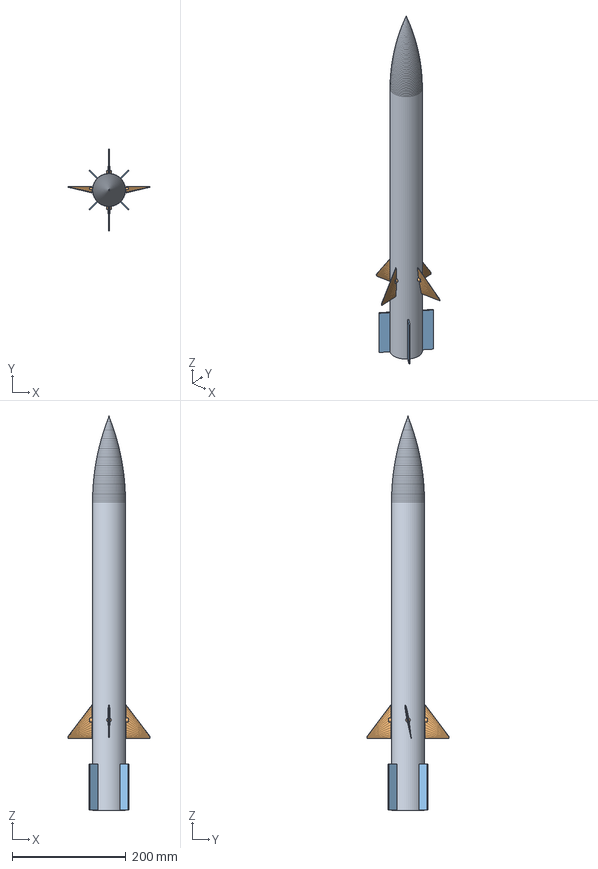
[picture p74: CAD file, 2026-11-10]
Simulations/CFD/simscale/geometry/R1_solids.step
143.7 x 143.7 x 693.0 mm
cfin_az0
cfin_az90
cfin_az180
cfin_az270
stab_az45
stab_az135
stab_az225
stab_az315
