swaroopsahoo4908/GTR70E-WYVERN/3D parts/assembly/fit_meshes/adxl375.stl

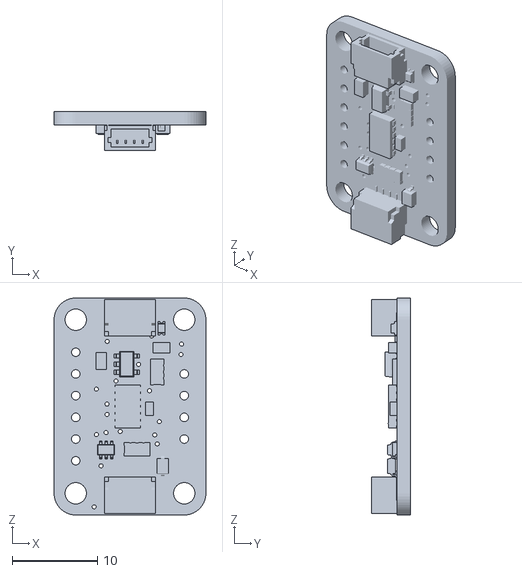
[picture p75: CAD file, 2026-11-10]
3D parts/assembly/fit_meshes/adxl375.stl
17.8 x 4.53 x 25.4
