swaroopsahoo4908/GTR70E-WYVERN/3D parts/control_fins/flat_plate/cfin_flat_plate_H30_PETGCF.step

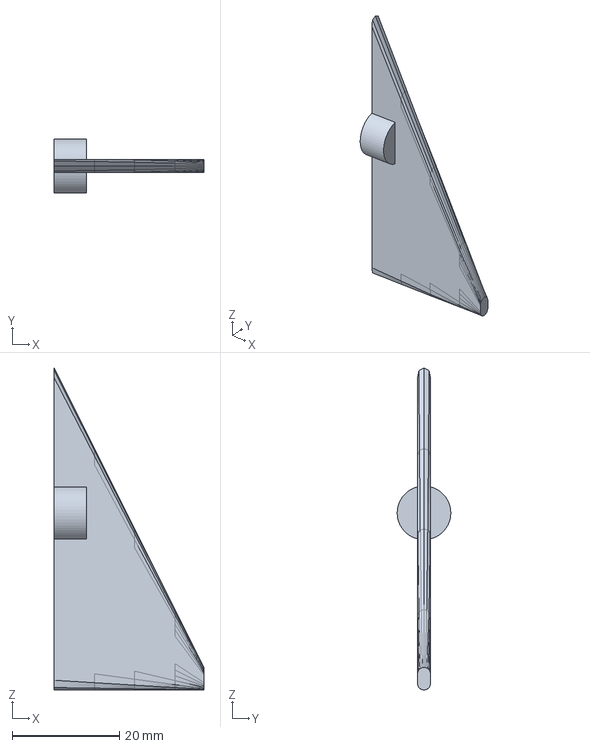
[picture p77: CAD file, 2026-11-10]
3D parts/control_fins/flat_plate/cfin_flat_plate_H30_PETGCF.step
27.9 x 10.0 x 60.0 mm
