swaroopsahoo4908/GTR70E-WYVERN/3D parts/flight/08_plenum_bulkhead_PCFR.step

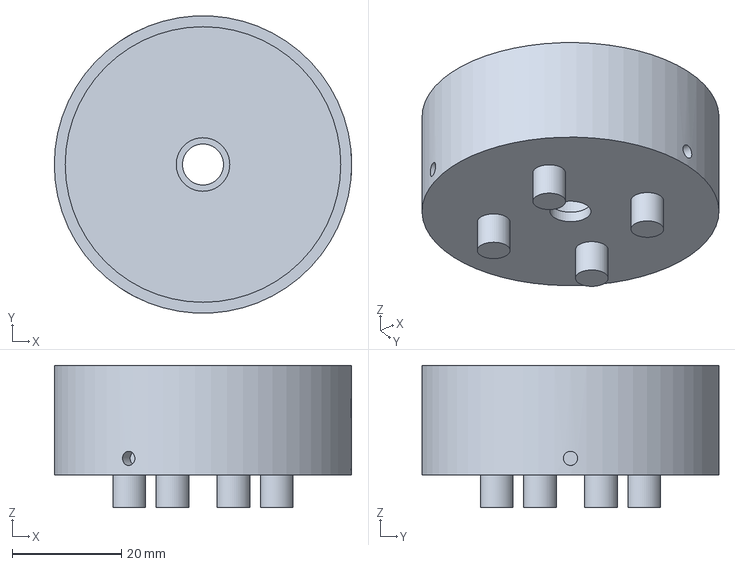
[picture p79: CAD file, 2026-11-10]
3D parts/flight/08_plenum_bulkhead_PCFR.step
54.4 x 54.3 x 26.0 mm
