swaroopsahoo4908/GTR70E-WYVERN/3D parts/wind_tunnel/WTA_sensor_gear20_m1_PETGCF.step

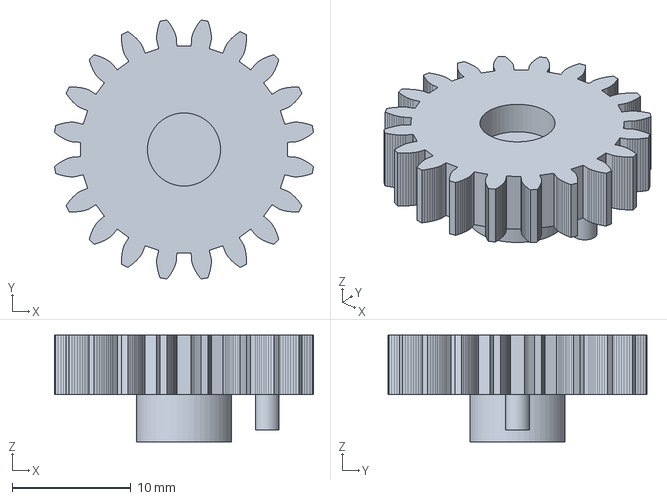
[picture p80: CAD file, 2026-11-10]
3D parts/wind_tunnel/WTA_sensor_gear20_m1_PETGCF.step
21.8 x 21.8 x 9.00 mm
