swaroopsahoo4908/GTR70E-WYVERN/Past Iterations/WYVERN-E KiCad/FC100/3dmodels/CAP-TH_BD13.0-P5.00-D1.2-FD.step

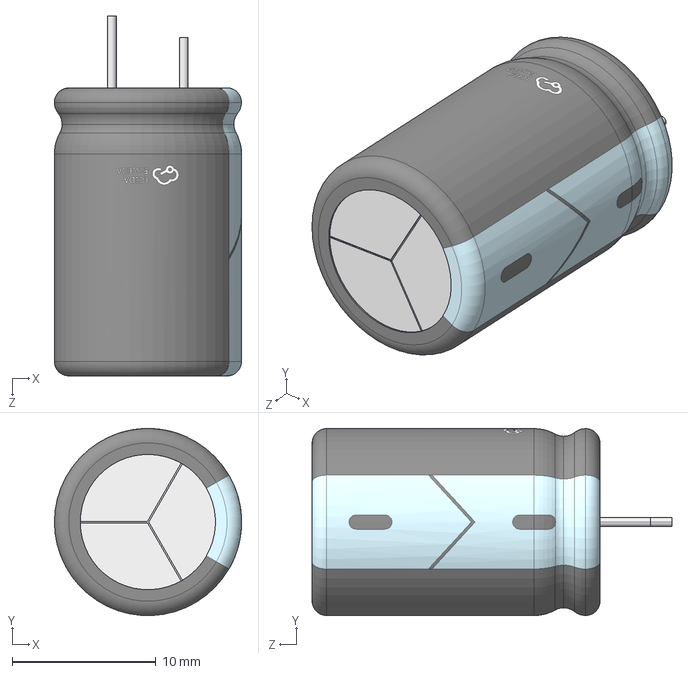
[picture p81: CAD file, 2026-10-14]
Past Iterations/WYVERN-E KiCad/FC100/3dmodels/CAP-TH_BD13.0-P5.00-D1.2-FD.step
13.0 x 13.0 x 25.0 mm
