swaroopsahoo4908/GTR70E-WYVERN/Simulations/CFD/simscale/geometry/A4_fluid.step

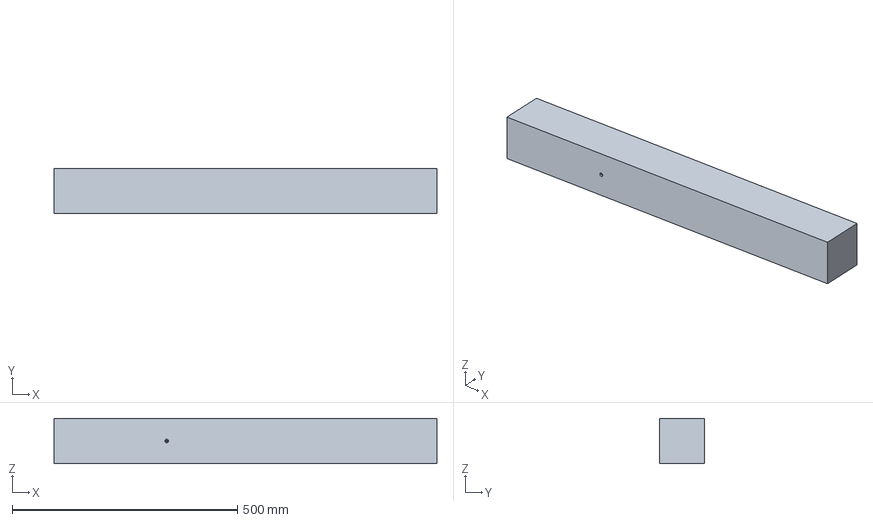
[picture p82: CAD file, 2026-11-10]
Simulations/CFD/simscale/geometry/A4_fluid.step
850.0 x 100.0 x 100.0 mm
