swaroopsahoo4908/GTR70E-WYVERN/3D parts/assembly/fit_meshes/05b_avionics_spine_PETGCF.stl

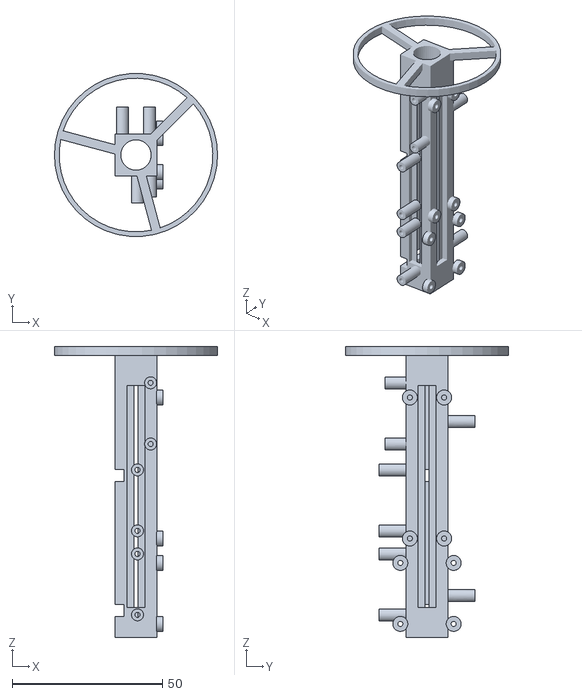
[picture p83: CAD file, 2026-11-10]
3D parts/assembly/fit_meshes/05b_avionics_spine_PETGCF.stl
54.4 x 54.2 x 97.0
