swaroopsahoo4908/GTR70E-WYVERN/3D parts/flight/10_motor_retainer_cap_PCFR.step

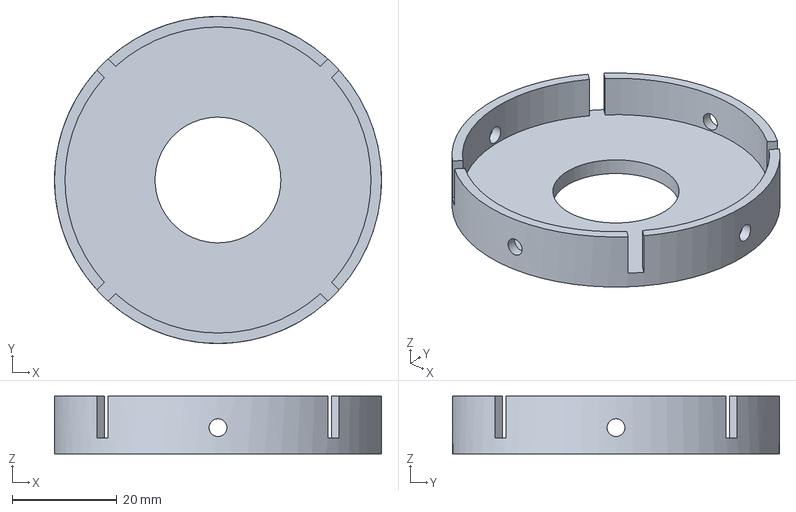
[picture p87: CAD file, 2026-11-10]
3D parts/flight/10_motor_retainer_cap_PCFR.step
62.4 x 62.4 x 11.0 mm
