swaroopsahoo4908/GTR70E-WYVERN/3D parts/wind_tunnel/WT_diffuser_200sq_to_8in_round_PETG.step

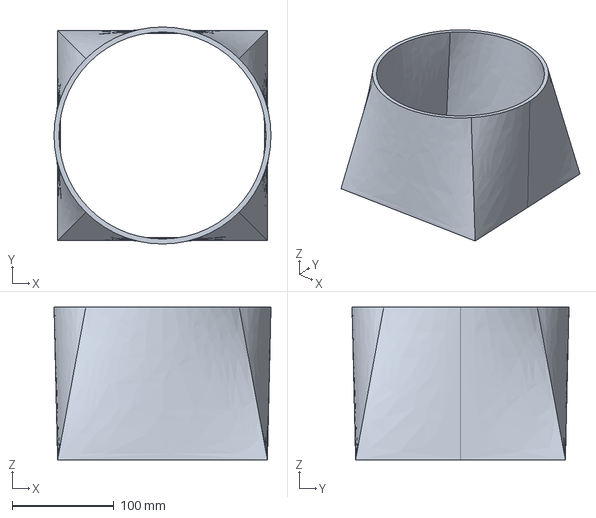
[picture p88: CAD file, 2026-11-10]
3D parts/wind_tunnel/WT_diffuser_200sq_to_8in_round_PETG.step
213.0 x 213.0 x 150.0 mm
