swaroopsahoo4908/GTR70E-WYVERN/Past Iterations/WYVERN-E KiCad/FC100/3dmodels/LFCSP-72_L10.0-W9.8-H1.0-P0.50.step

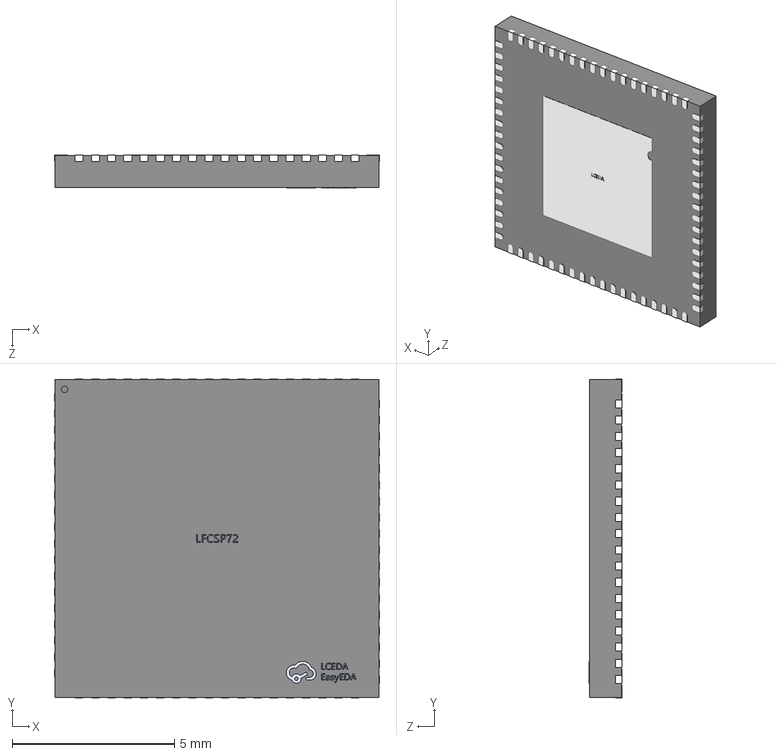
[picture p89: CAD file, 2026-10-14]
Past Iterations/WYVERN-E KiCad/FC100/3dmodels/LFCSP-72_L10.0-W9.8-H1.0-P0.50.step
10.0 x 9.82 x 1.02 mm
