swaroopsahoo4908/GTR70E-WYVERN/Simulations/CFD/simscale/geometry/R3_part_stab_az315.stl

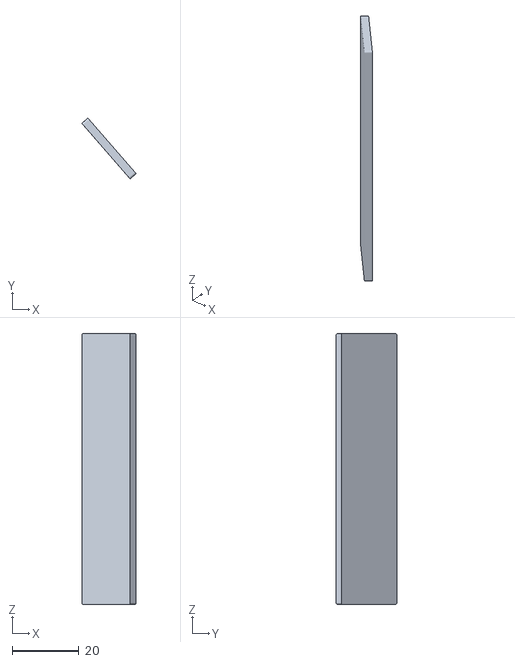
[picture p90: CAD file, 2026-11-10]
Simulations/CFD/simscale/geometry/R3_part_stab_az315.stl
16.3 x 18.2 x 81.0
