swaroopsahoo4908/GTR70E-WYVERN/3D parts/assembly/fit_meshes/servo_horn_az90.stl

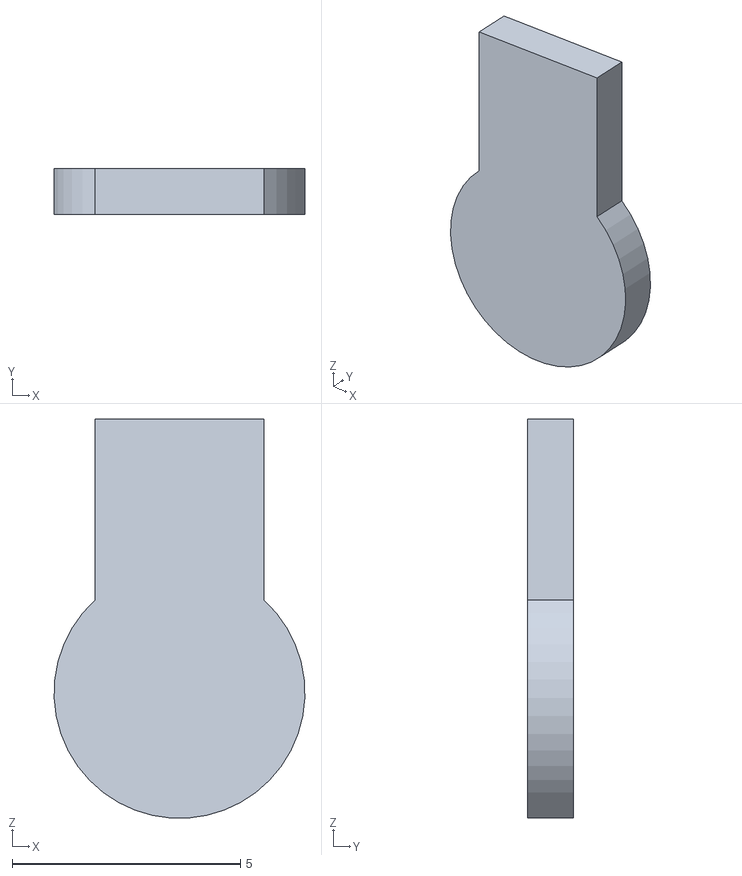
[picture p91: CAD file, 2026-11-10]
3D parts/assembly/fit_meshes/servo_horn_az90.stl
5.50 x 1.00 x 8.74
