swaroopsahoo4908/GTR70E-WYVERN/3D parts/control_fins/double_wedge/cfin_double_wedge_H35_PETGCF.step

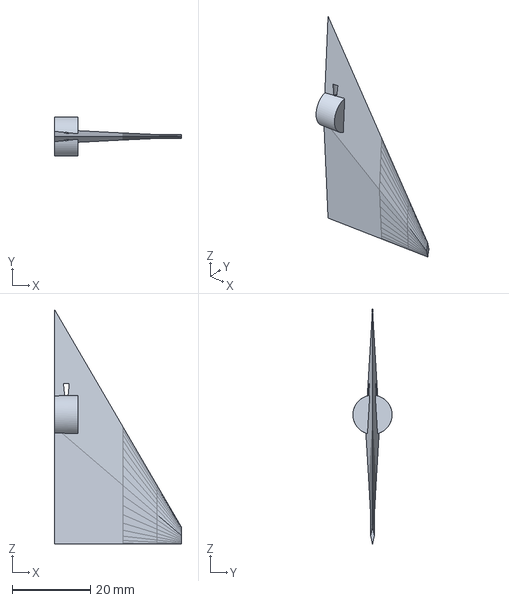
[picture p92: CAD file, 2026-11-10]
3D parts/control_fins/double_wedge/cfin_double_wedge_H35_PETGCF.step
32.5 x 10.00 x 60.0 mm
