swaroopsahoo4908/GTR70E-WYVERN/3D parts/control_fins/NACA0012/cfin_NACA0012_H20_PETGCF.step

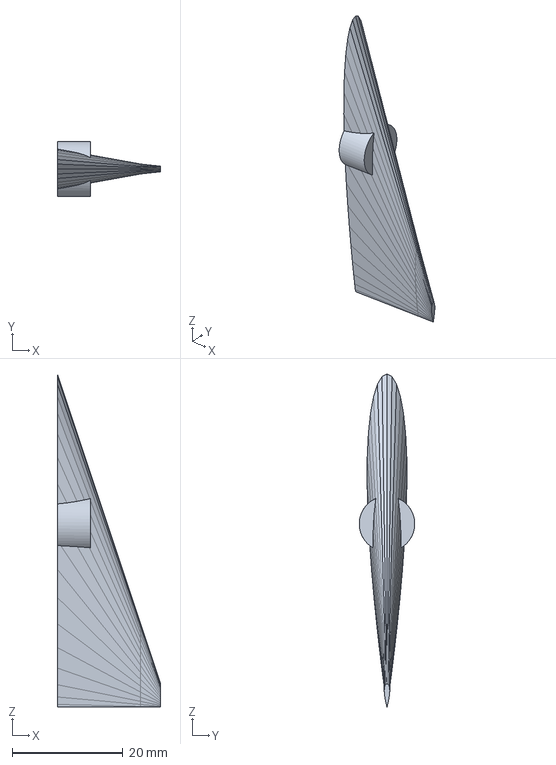
[picture p94: CAD file, 2026-11-10]
3D parts/control_fins/NACA0012/cfin_NACA0012_H20_PETGCF.step
18.6 x 9.99 x 60.0 mm
