swaroopsahoo4908/GTR70E-WYVERN/3D parts/flight/07_motor_bay_tube_ASAAero.step

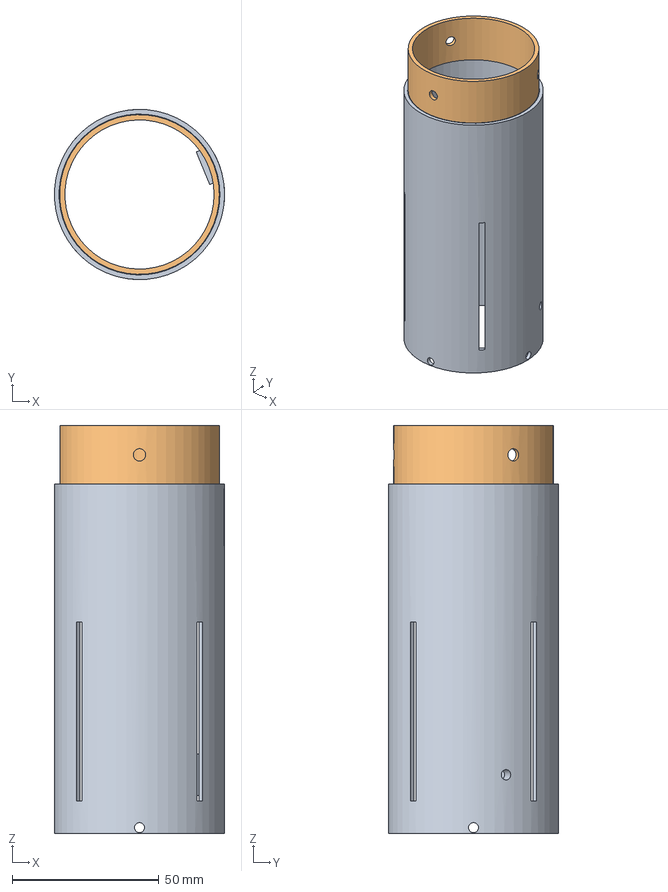
[picture p95: CAD file, 2026-11-10]
3D parts/flight/07_motor_bay_tube_ASAAero.step
58.0 x 58.0 x 139.0 mm
