swaroopsahoo4908/GTR70E-WYVERN/3D parts/wind_tunnel/WTA_reflection_plane_wall_panel_PETG.step

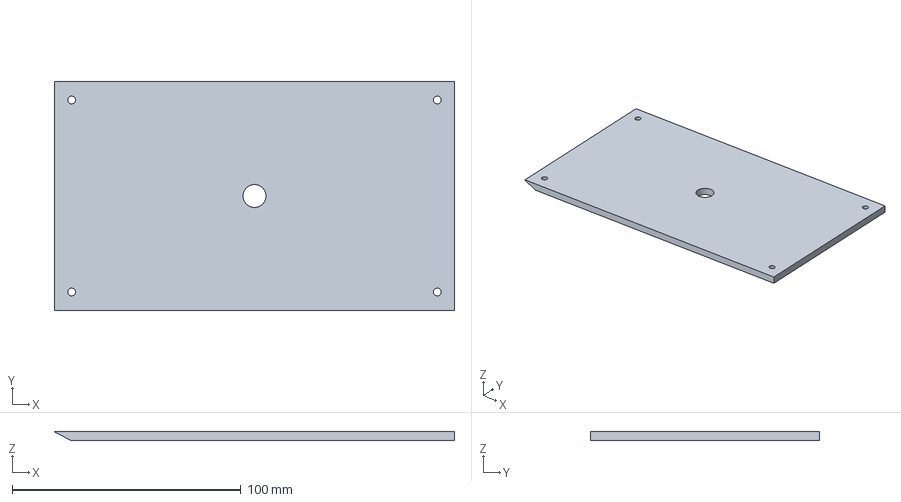
[picture p96: CAD file, 2026-11-10]
3D parts/wind_tunnel/WTA_reflection_plane_wall_panel_PETG.step
175.0 x 100.0 x 4.00 mm
