swaroopsahoo4908/GTR70E-WYVERN/3D parts/assembly/fit_meshes/EMAX_ES9251II_az0.stl

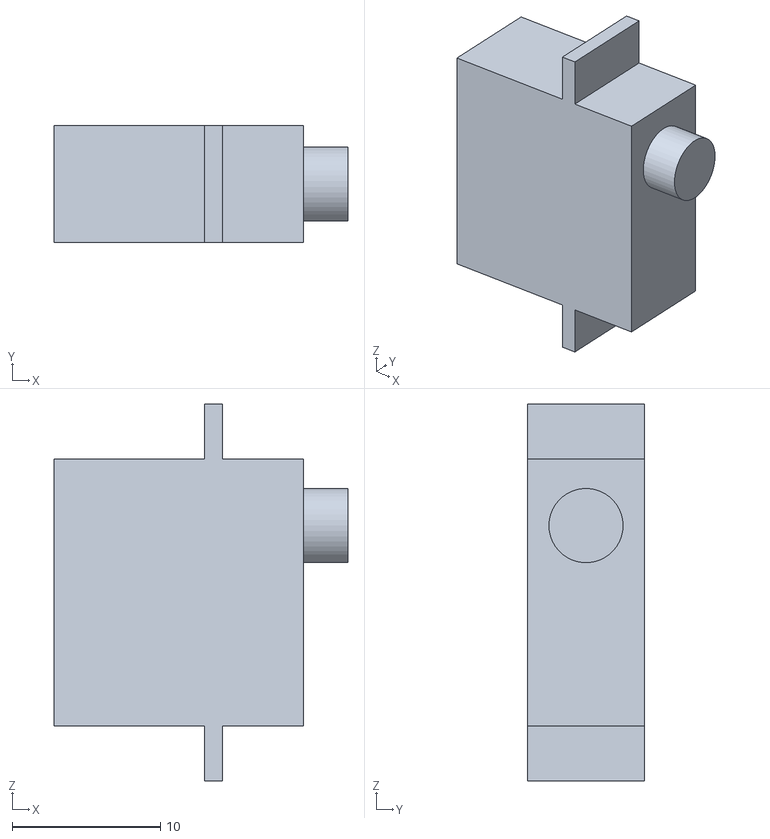
[picture p97: CAD file, 2026-11-10]
3D parts/assembly/fit_meshes/EMAX_ES9251II_az0.stl
19.8 x 7.91 x 25.4
