swaroopsahoo4908/GTR70E-WYVERN/3D parts/flight/09_motor_mount_tube_aft_ring_PCFR.step

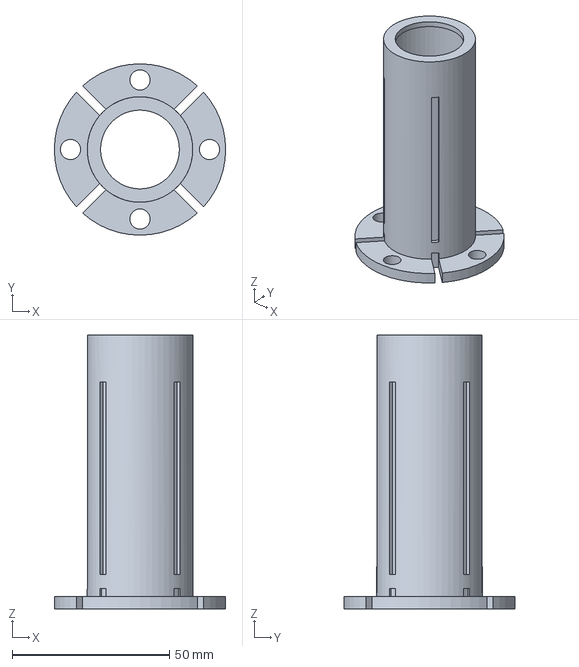
[picture p98: CAD file, 2026-11-10]
3D parts/flight/09_motor_mount_tube_aft_ring_PCFR.step
54.4 x 54.4 x 87.0 mm
