swaroopsahoo4908/GTR70E-WYVERN/3D parts/assembly/fit_meshes/03_rb_floor_coupler_PCFR.stl

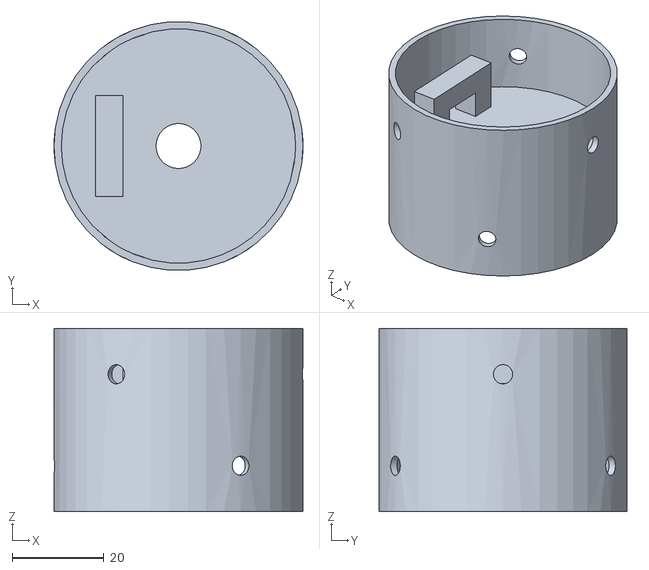
[picture p101: CAD file, 2026-11-10]
3D parts/assembly/fit_meshes/03_rb_floor_coupler_PCFR.stl
54.4 x 54.2 x 40.0
