swaroopsahoo4908/GTR70E-WYVERN/3D parts/flight/15_fin_zero_jig_PETG.step

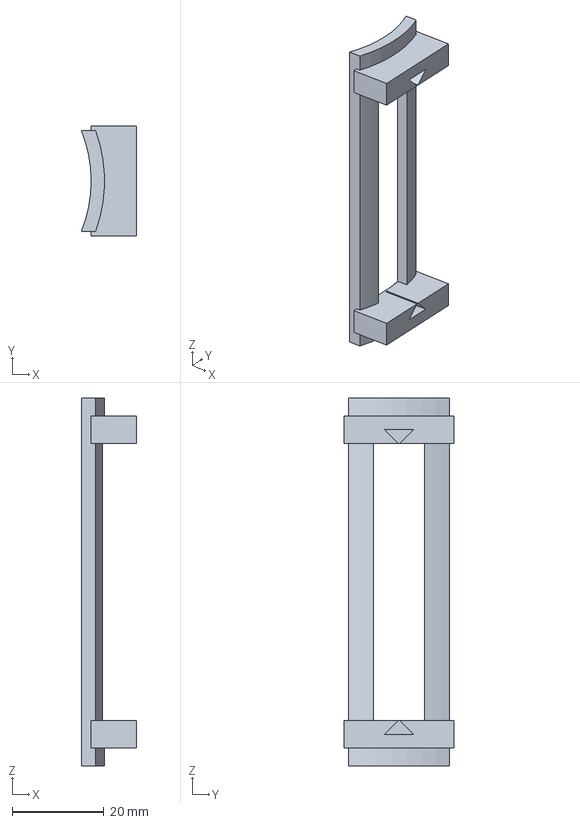
[picture p102: CAD file, 2026-11-10]
3D parts/flight/15_fin_zero_jig_PETG.step
12.0 x 24.0 x 80.0 mm
