swaroopsahoo4908/GTR70E-WYVERN/3D parts/assembly/fit_meshes/cap_470uF_under_board.stl

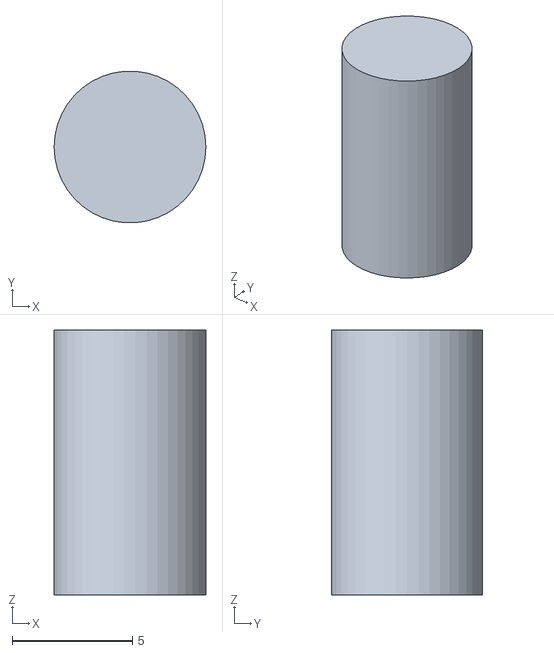
[picture p104: CAD file, 2026-11-10]
3D parts/assembly/fit_meshes/cap_470uF_under_board.stl
6.30 x 6.28 x 11.0
