swaroopsahoo4908/GTR70E-WYVERN/3D parts/wind_tunnel/WTA_calibration_pulley_bracket_PETG.step

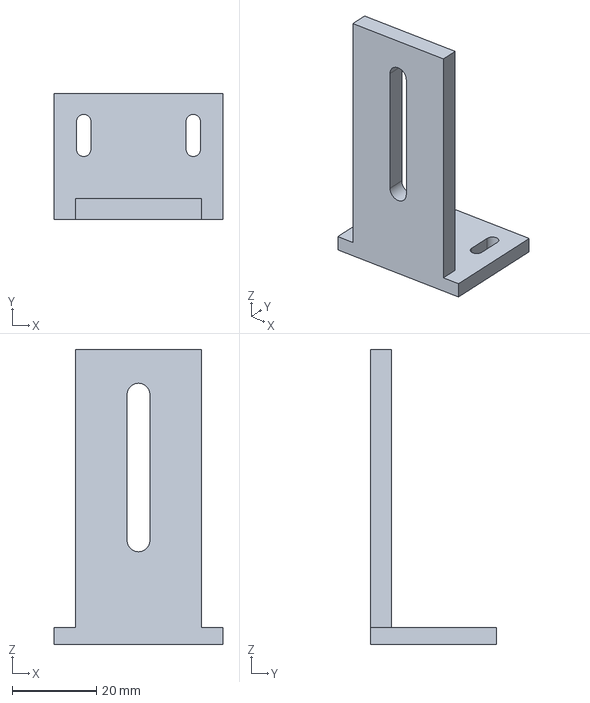
[picture p105: CAD file, 2026-11-10]
3D parts/wind_tunnel/WTA_calibration_pulley_bracket_PETG.step
40.0 x 30.0 x 70.0 mm
