swaroopsahoo4908/GTR70E-WYVERN/3D parts/flight/06_servo_hub_PETGCF_x4.step

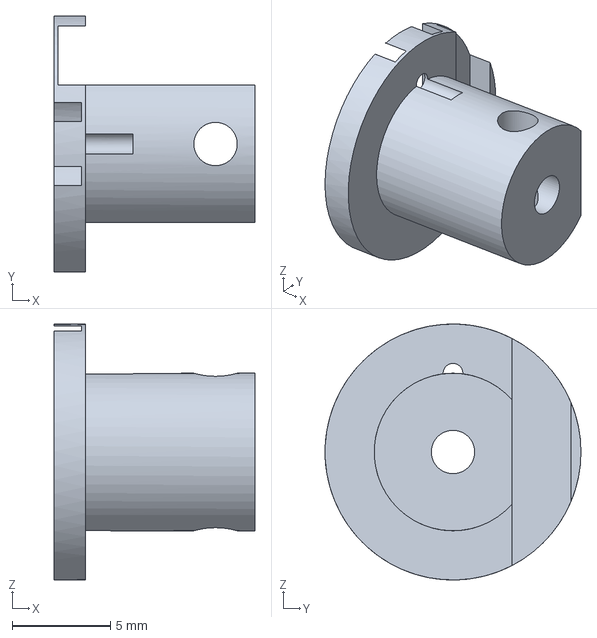
[picture p106: CAD file, 2026-11-10]
3D parts/flight/06_servo_hub_PETGCF_x4.step
10.2 x 13.0 x 13.0 mm
