swaroopsahoo4908/GTR70E-WYVERN/3D parts/wind_tunnel/WTA_inclined_manometer_ramp_PETG.step

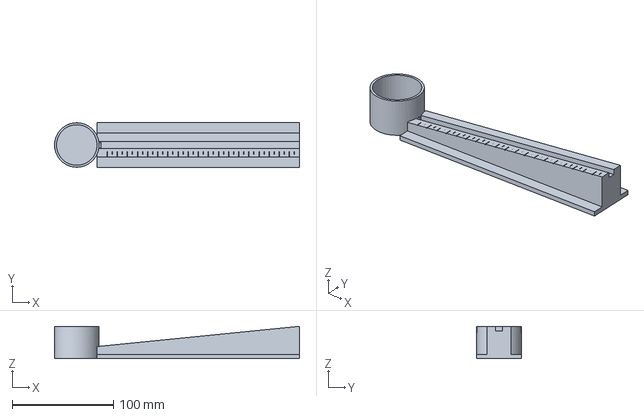
[picture p107: CAD file, 2026-11-10]
3D parts/wind_tunnel/WTA_inclined_manometer_ramp_PETG.step
242.0 x 44.0 x 32.0 mm
