swaroopsahoo4908/GTR70E-WYVERN/Simulations/CFD/simscale/geometry/R3_part_body.stl

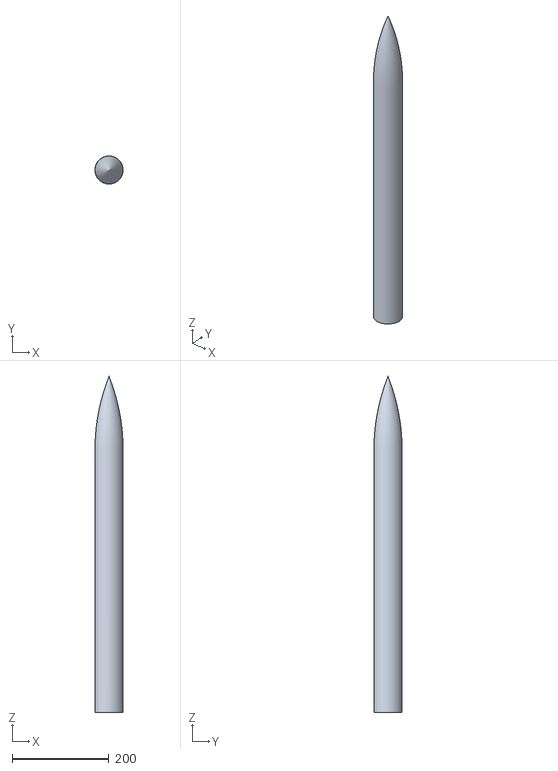
[picture p108: CAD file, 2026-11-10]
Simulations/CFD/simscale/geometry/R3_part_body.stl
58.1 x 58.0 x 693.0
