swaroopsahoo4908/GTR70E-WYVERN/3D parts/wind_tunnel/WTA_hub_gear40_m1_PETGCF.step

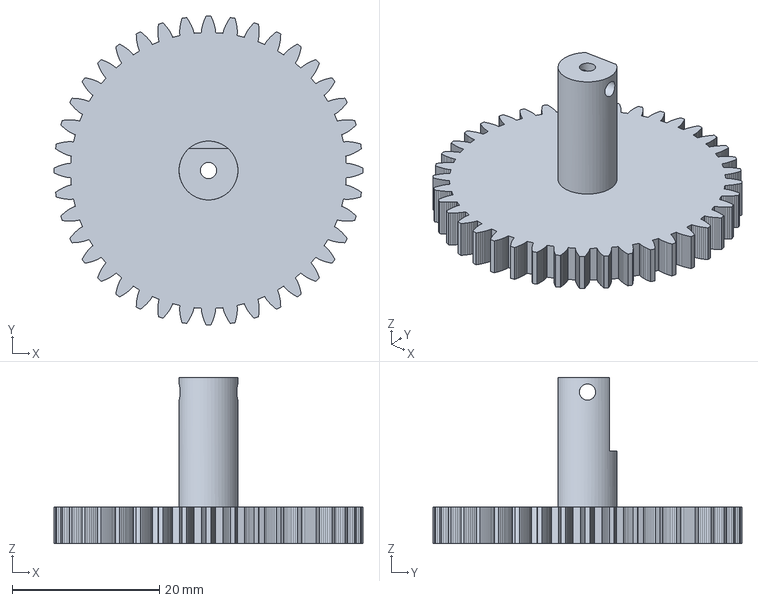
[picture p109: CAD file, 2026-11-10]
3D parts/wind_tunnel/WTA_hub_gear40_m1_PETGCF.step
42.0 x 42.0 x 22.6 mm
