swaroopsahoo4908/GTR70E-WYVERN/Simulations/CFD/simscale/geometry/R3_fluid.step

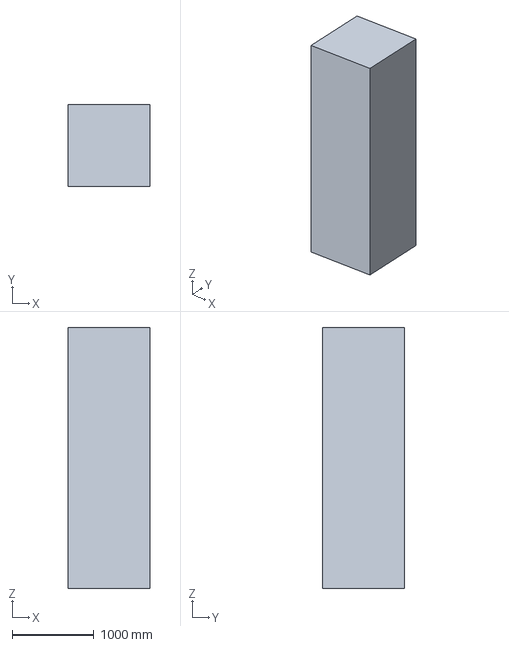
[picture p110: CAD file, 2026-11-10]
Simulations/CFD/simscale/geometry/R3_fluid.step
1000.0 x 1000.0 x 3193.0 mm
