swaroopsahoo4908/GTR70E-WYVERN/3D parts/flight/05_spine_deck_PETGCF.step

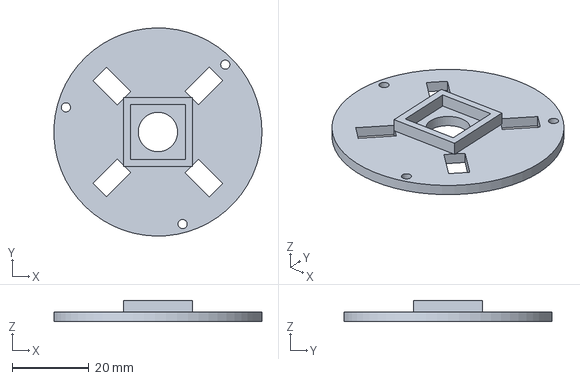
[picture p111: CAD file, 2026-11-10]
3D parts/flight/05_spine_deck_PETGCF.step
54.4 x 54.4 x 5.50 mm
