swaroopsahoo4908/GTR70E-WYVERN/3D parts/wind_tunnel/WT_nose_fairing_ogive100_ASA.step

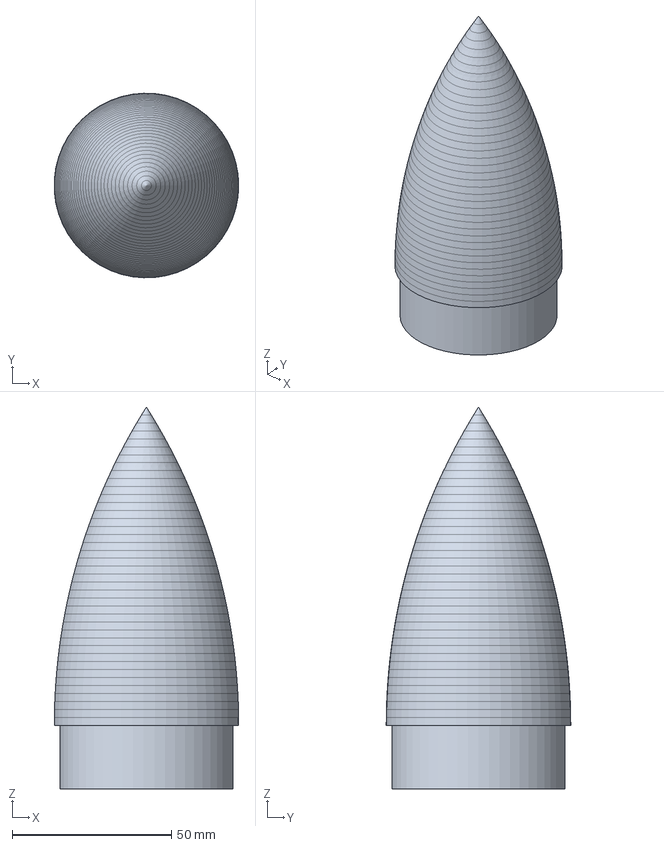
[picture p112: CAD file, 2026-11-10]
3D parts/wind_tunnel/WT_nose_fairing_ogive100_ASA.step
57.9 x 58.0 x 120.0 mm
