swaroopsahoo4908/GTR70E-WYVERN/3D parts/flight/13_rail_button_1010_printed_PETGCF_x2.step

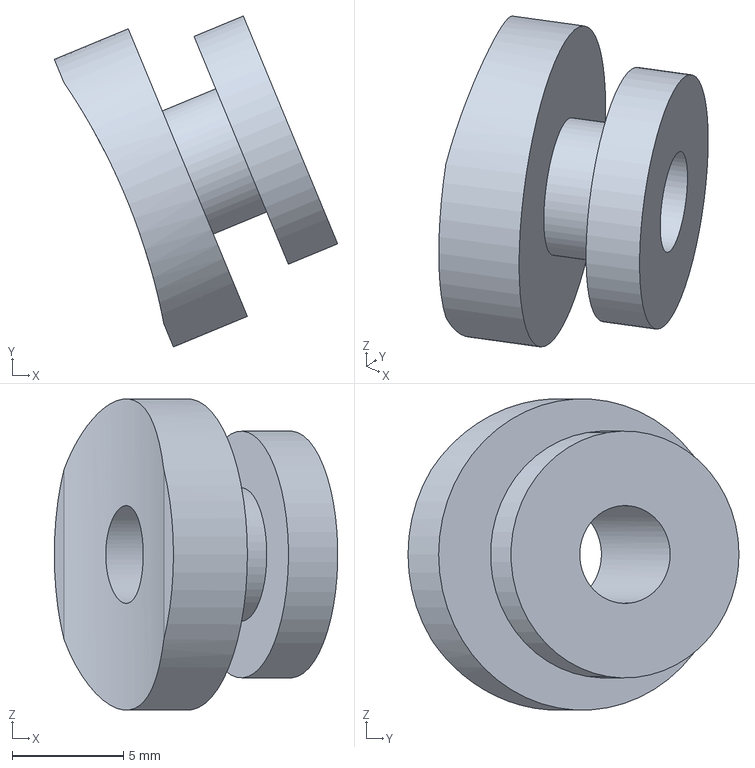
[picture p113: CAD file, 2026-11-10]
3D parts/flight/13_rail_button_1010_printed_PETGCF_x2.step
12.7 x 14.9 x 14.0 mm
