swaroopsahoo4908/GTR70E-WYVERN/3D parts/wind_tunnel/WTA_inclined_manometer_lid_PETG.step

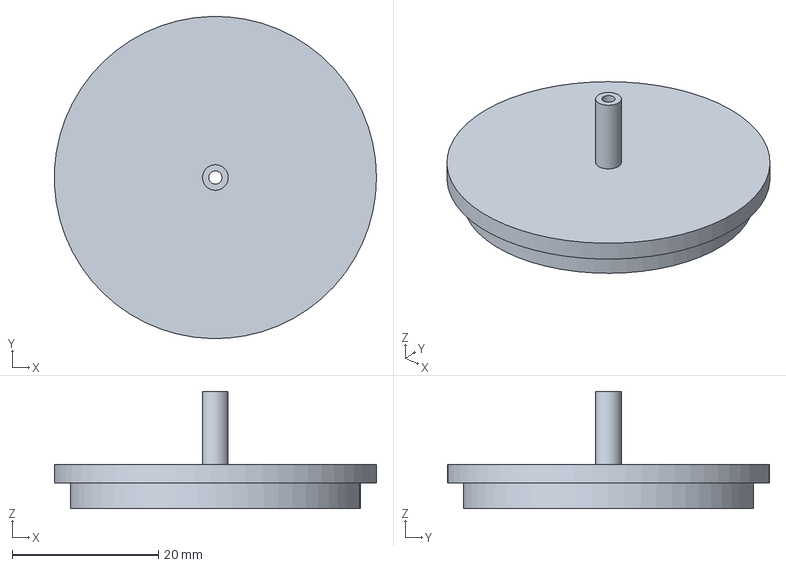
[picture p114: CAD file, 2026-11-10]
3D parts/wind_tunnel/WTA_inclined_manometer_lid_PETG.step
44.0 x 44.0 x 16.0 mm
