swaroopsahoo4908/GTR70E-WYVERN/Simulations/CFD/simscale/geometry/R2_solids.step

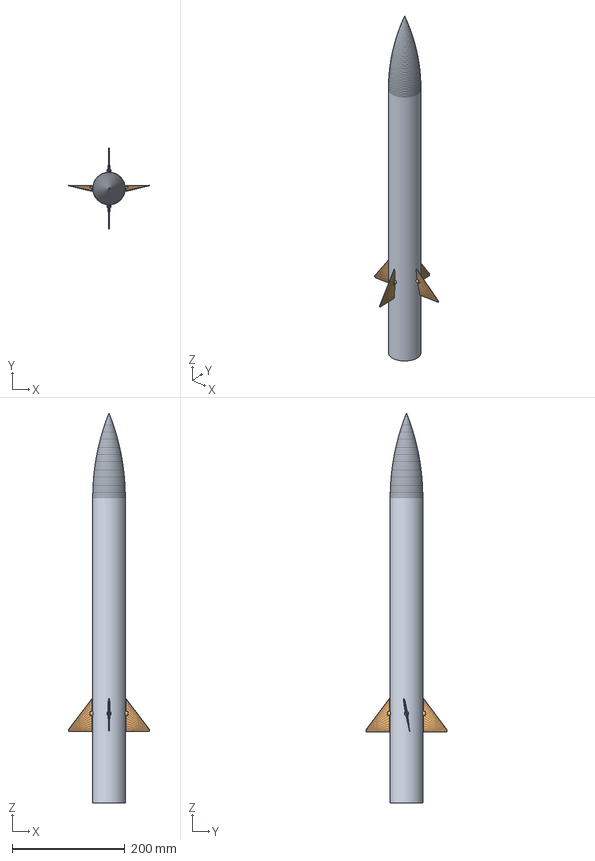
[picture p115: CAD file, 2026-11-10]
Simulations/CFD/simscale/geometry/R2_solids.step
143.7 x 143.7 x 693.0 mm
cfin_az0
cfin_az90
cfin_az180
cfin_az270
