swaroopsahoo4908/GTR70E-WYVERN/3D parts/assembly/fit_meshes/pico2w.stl

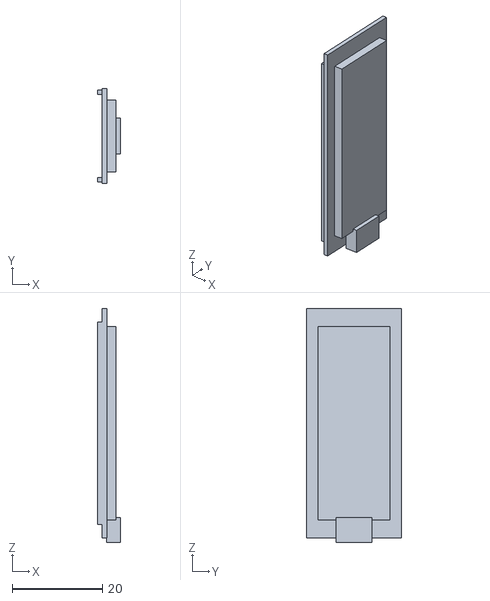
[picture p116: CAD file, 2026-11-10]
3D parts/assembly/fit_meshes/pico2w.stl
5.00 x 21.0 x 52.0
