swaroopsahoo4908/GTR70E-WYVERN/3D parts/flight/01_nose_tangent_ogive_150_ASAAero.step

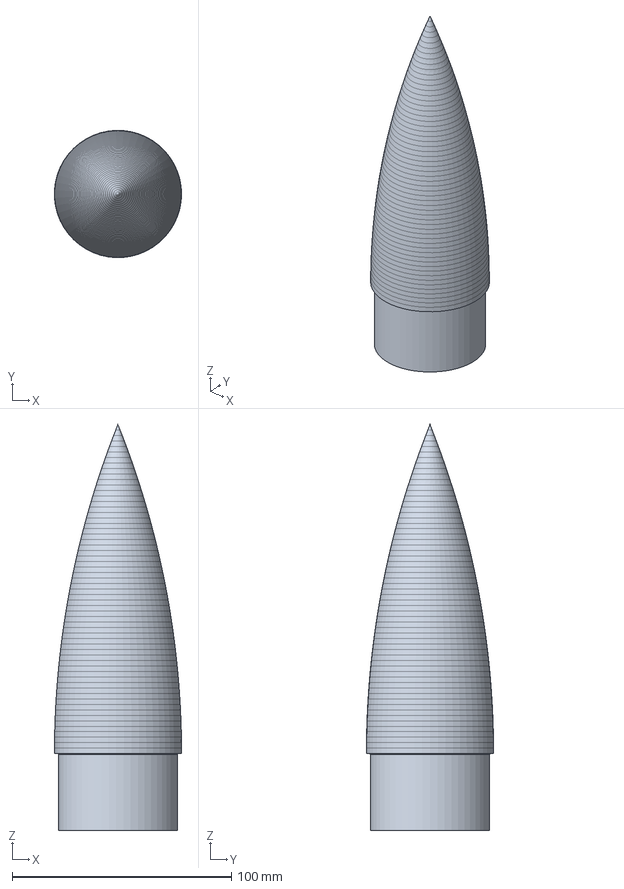
[picture p117: CAD file, 2026-11-10]
3D parts/flight/01_nose_tangent_ogive_150_ASAAero.step
57.9 x 58.0 x 185.0 mm
