swaroopsahoo4908/GTR70E-WYVERN/3D parts/wind_tunnel/WTA_fin_zero_jig_PETG.step

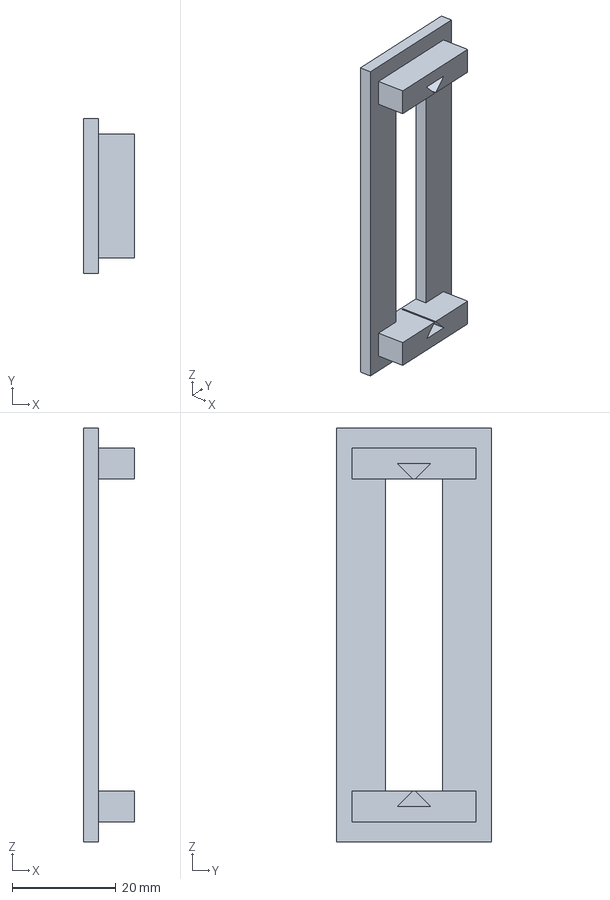
[picture p118: CAD file, 2026-11-10]
3D parts/wind_tunnel/WTA_fin_zero_jig_PETG.step
9.90 x 30.0 x 80.0 mm
