swaroopsahoo4908/GTR70E-WYVERN/3D parts/assembly/fit_meshes/04_control_tube_servo_ring_ASAAero.stl

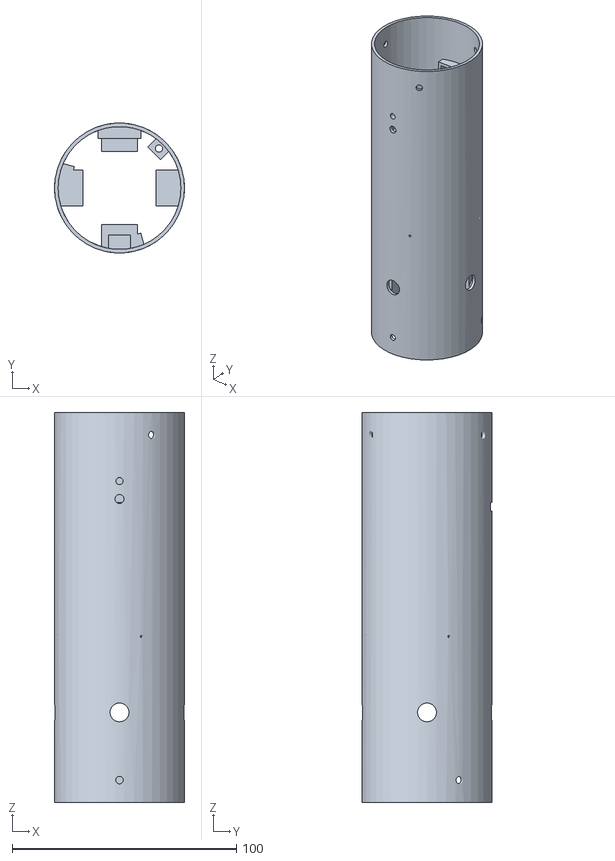
[picture p119: CAD file, 2026-11-10]
3D parts/assembly/fit_meshes/04_control_tube_servo_ring_ASAAero.stl
58.0 x 58.0 x 174.0
