swaroopsahoo4908/GTR70E-WYVERN/3D parts/wind_tunnel/WTB_stabilizer_tail_section_ASA.step

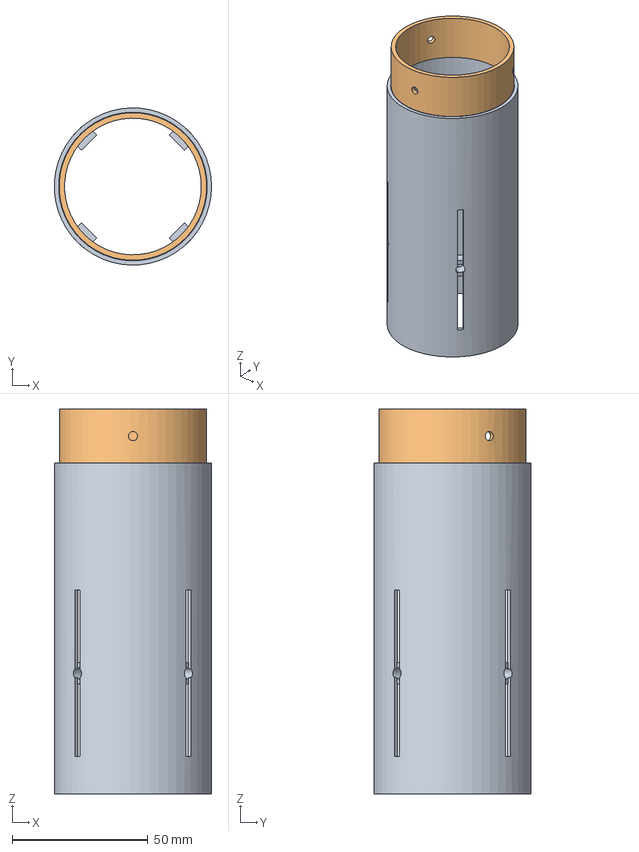
[picture p120: CAD file, 2026-11-10]
3D parts/wind_tunnel/WTB_stabilizer_tail_section_ASA.step
57.9 x 58.0 x 142.0 mm
