swaroopsahoo4908/GTR70E-WYVERN/Simulations/CFD/simscale/geometry/A6_solids.step

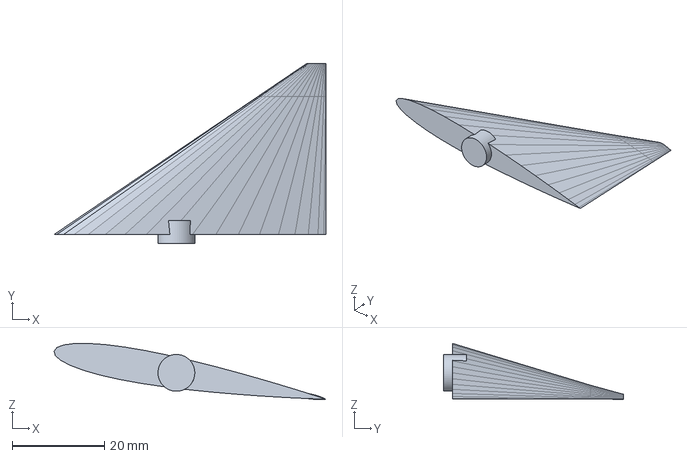
[picture p121: CAD file, 2026-11-10]
Simulations/CFD/simscale/geometry/A6_solids.step
59.1 x 39.2 x 12.2 mm
