swaroopsahoo4908/GTR70E-WYVERN/3D parts/assembly/fit_meshes/nose_ballast_pour.stl

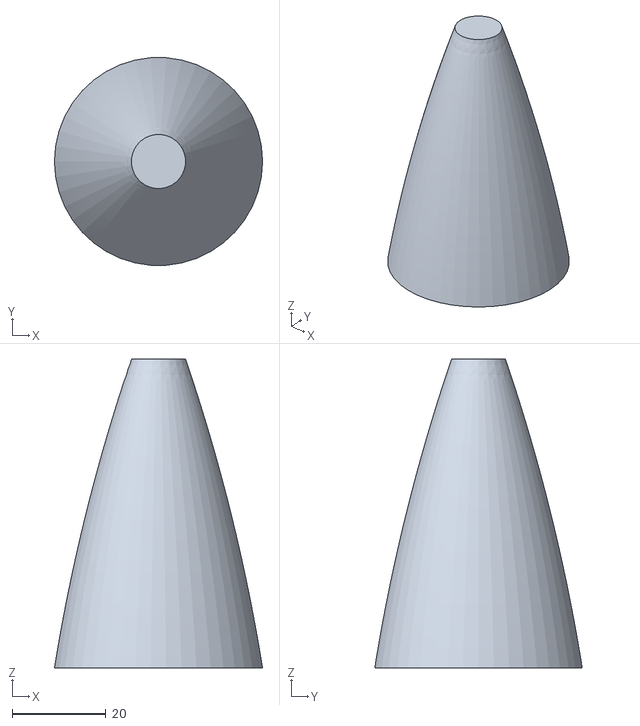
[picture p122: CAD file, 2026-11-10]
3D parts/assembly/fit_meshes/nose_ballast_pour.stl
44.5 x 44.3 x 66.0
