swaroopsahoo4908/GTR70E-WYVERN/3D parts/wind_tunnel/WTA_diffuser_100sq_to_6in_round_PETG.step

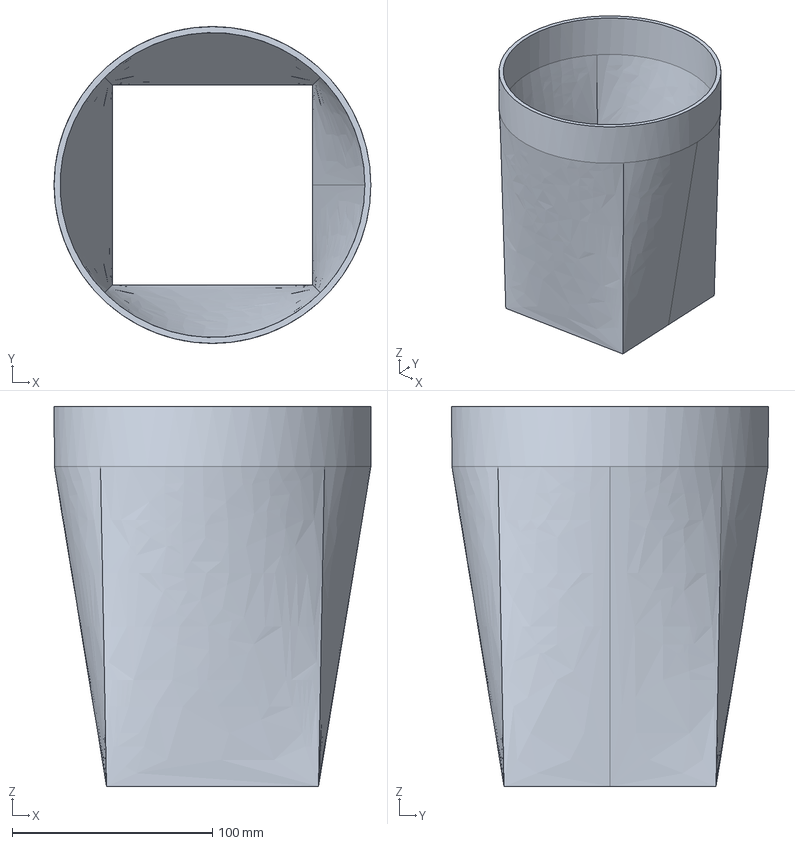
[picture p123: CAD file, 2026-11-10]
3D parts/wind_tunnel/WTA_diffuser_100sq_to_6in_round_PETG.step
158.4 x 158.4 x 190.0 mm
