swaroopsahoo4908/GTR70E-WYVERN/3D parts/wind_tunnel/WT_tail_fairing_sting_socket_ASA.step

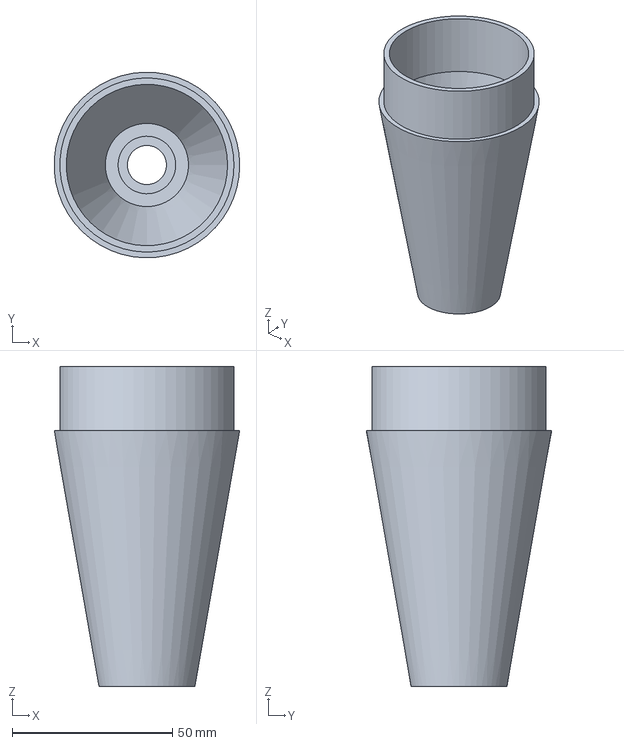
[picture p124: CAD file, 2026-11-10]
3D parts/wind_tunnel/WT_tail_fairing_sting_socket_ASA.step
57.9 x 58.0 x 100.0 mm
