swaroopsahoo4908/GTR70E-WYVERN/3D parts/assembly/fit_meshes/chute_24in_packed.stl

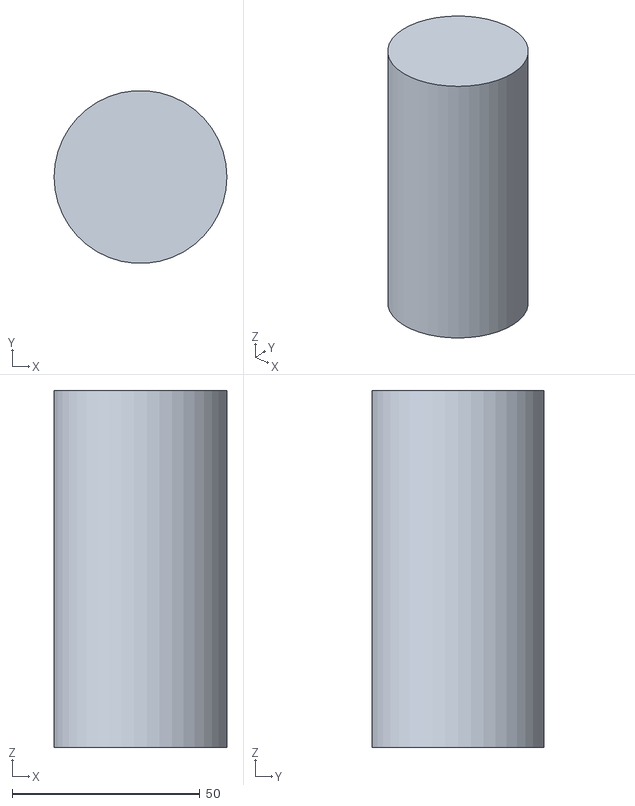
[picture p125: CAD file, 2026-11-10]
3D parts/assembly/fit_meshes/chute_24in_packed.stl
46.0 x 45.9 x 95.0
