swaroopsahoo4908/GTR70E-WYVERN/3D parts/wind_tunnel/WTB_stabilizer_blade_span30_PETGCF_x4.step

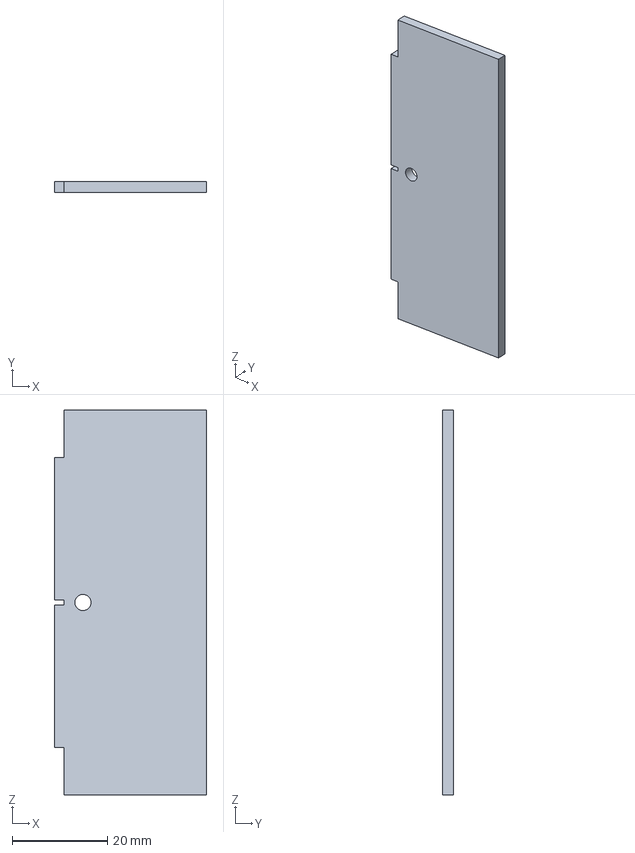
[picture p126: CAD file, 2026-11-10]
3D parts/wind_tunnel/WTB_stabilizer_blade_span30_PETGCF_x4.step
32.0 x 2.40 x 81.0 mm
