swaroopsahoo4908/GTR70E-WYVERN/Simulations/CFD/simscale/geometry/A5_solids.step

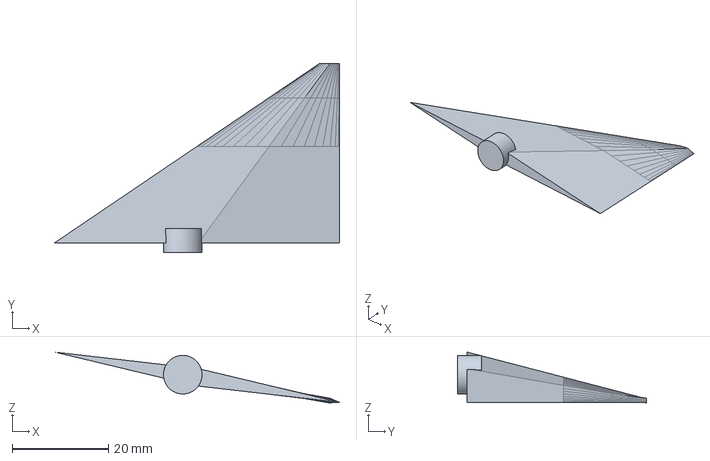
[picture p127: CAD file, 2026-11-10]
Simulations/CFD/simscale/geometry/A5_solids.step
59.1 x 39.2 x 10.5 mm
