swaroopsahoo4908/GTR70E-WYVERN/3D parts/assembly/fit_meshes/arm_led_3mm.stl

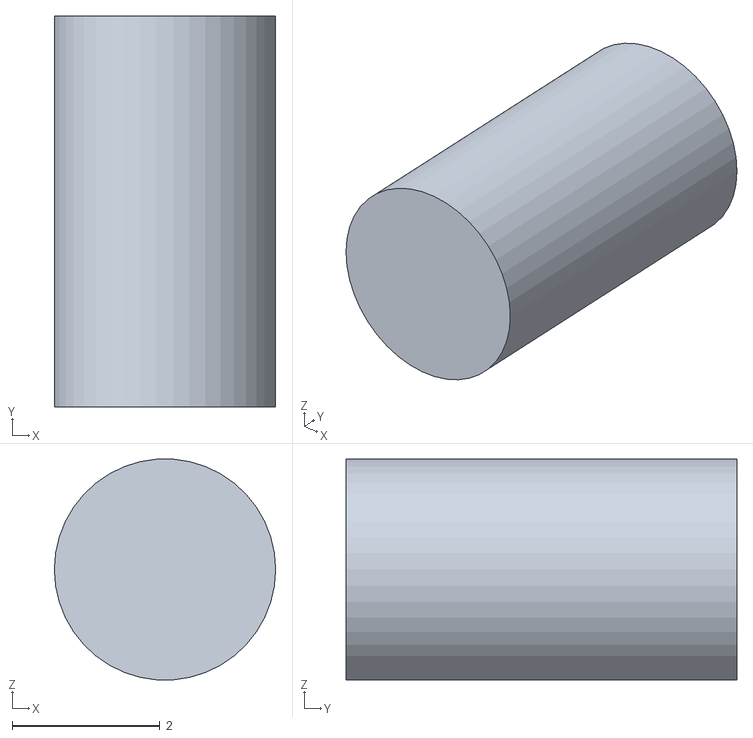
[picture p128: CAD file, 2026-11-10]
3D parts/assembly/fit_meshes/arm_led_3mm.stl
3.00 x 5.30 x 2.99
