swaroopsahoo4908/GTR70E-WYVERN/3D parts/wind_tunnel/WT_adapter_228sq_to_200sq_x2_PETG.step

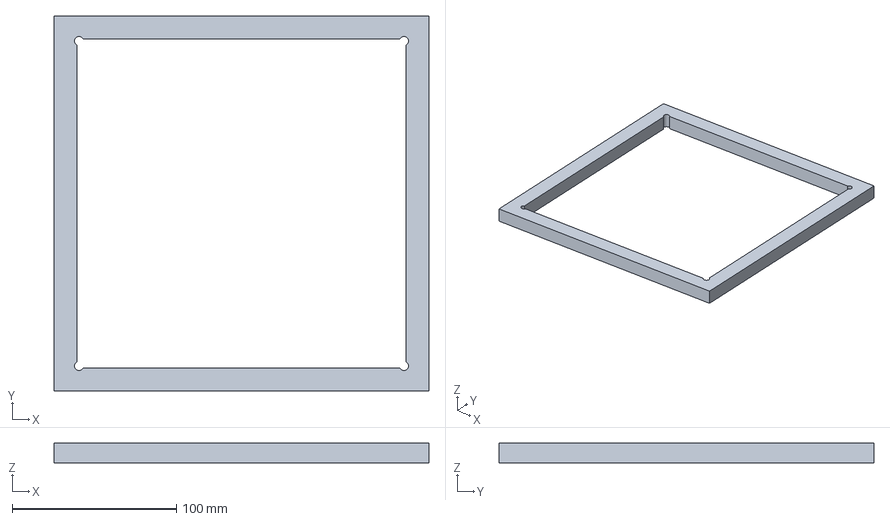
[picture p129: CAD file, 2026-11-10]
3D parts/wind_tunnel/WT_adapter_228sq_to_200sq_x2_PETG.step
228.0 x 228.0 x 12.0 mm
