swaroopsahoo4908/GTR70E-WYVERN/3D parts/assembly/fit_meshes/shock_cord_bundle.stl

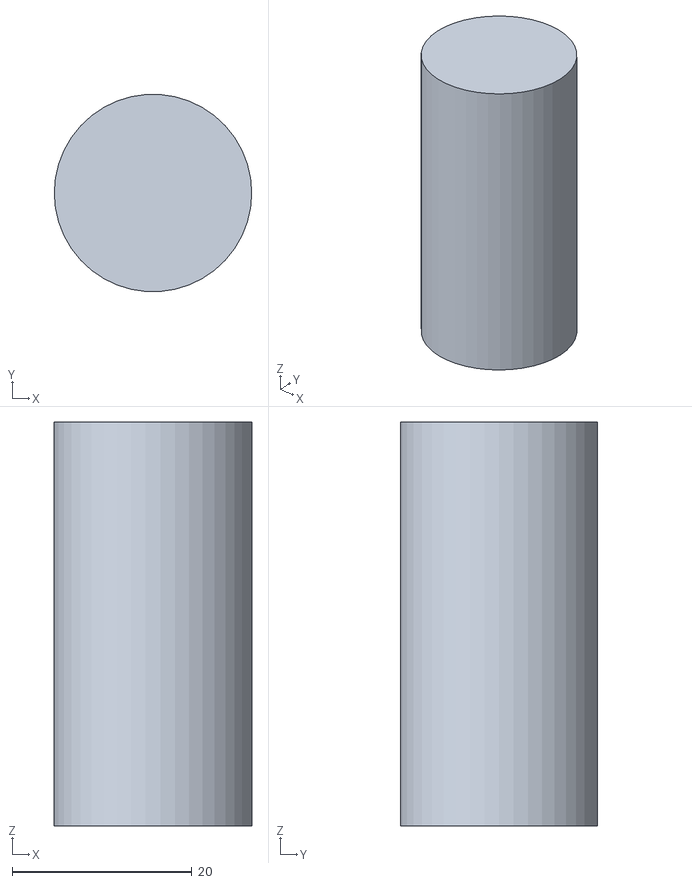
[picture p130: CAD file, 2026-11-10]
3D parts/assembly/fit_meshes/shock_cord_bundle.stl
22.0 x 21.9 x 45.0
