swaroopsahoo4908/GTR70E-WYVERN/3D parts/wind_tunnel/WT_strut_fairing_ASA.step

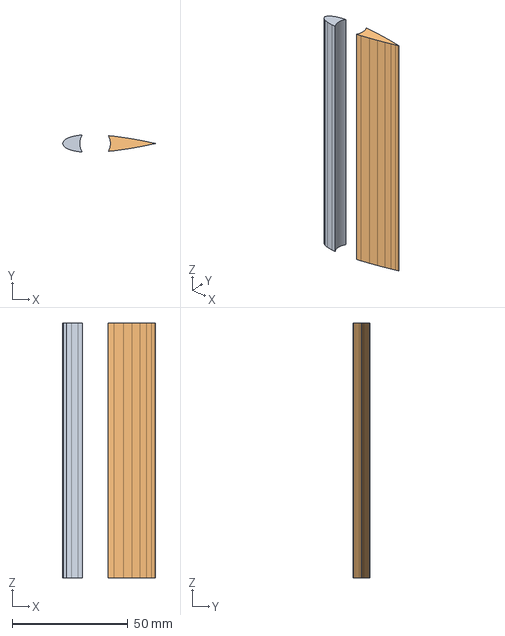
[picture p131: CAD file, 2026-11-10]
3D parts/wind_tunnel/WT_strut_fairing_ASA.step
40.0 x 7.35 x 110.0 mm
