swaroopsahoo4908/GTR70E-WYVERN/Simulations/CFD/simscale/geometry/A3_solids.step

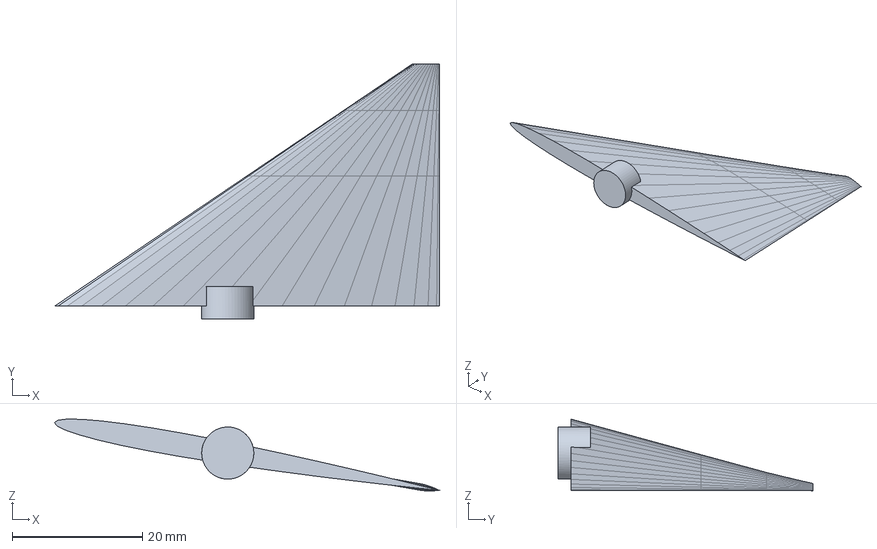
[picture p132: CAD file, 2026-11-10]
Simulations/CFD/simscale/geometry/A3_solids.step
59.1 x 39.2 x 11.0 mm
