swaroopsahoo4908/GTR70E-WYVERN/Simulations/CFD/simscale/geometry/R2_part_cfin_az180.stl

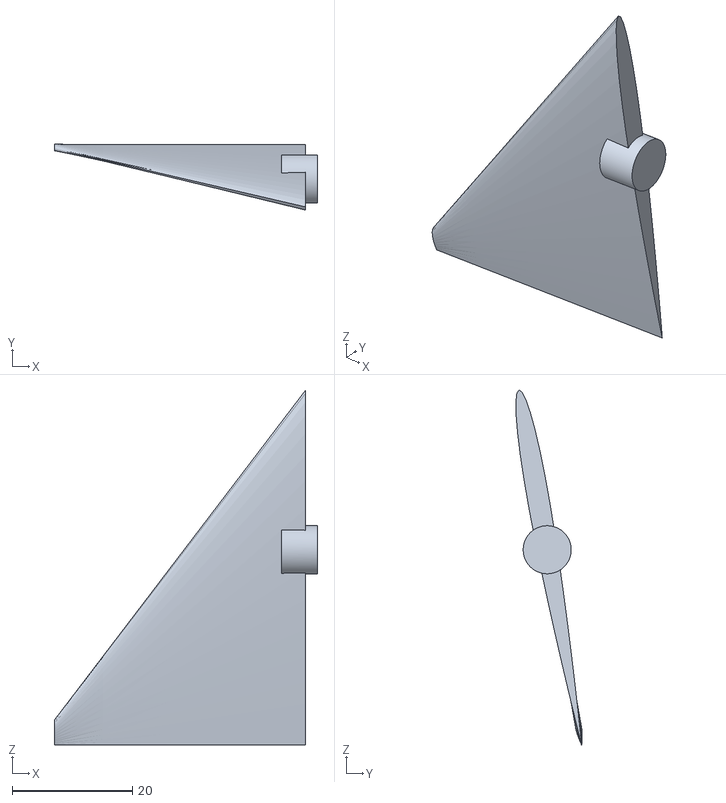
[picture p133: CAD file, 2026-11-10]
Simulations/CFD/simscale/geometry/R2_part_cfin_az180.stl
43.8 x 11.0 x 59.1
