swaroopsahoo4908/GTR70E-WYVERN/Simulations/CFD/simscale/geometry/A4_solids.step

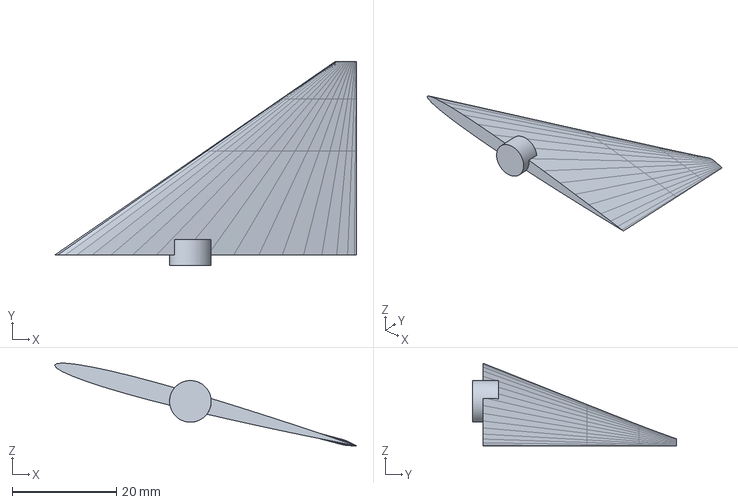
[picture p134: CAD file, 2026-11-10]
Simulations/CFD/simscale/geometry/A4_solids.step
58.0 x 39.2 x 15.9 mm
