swaroopsahoo4908/GTR70E-WYVERN/3D parts/assembly/fit_meshes/nomex_wrap.stl

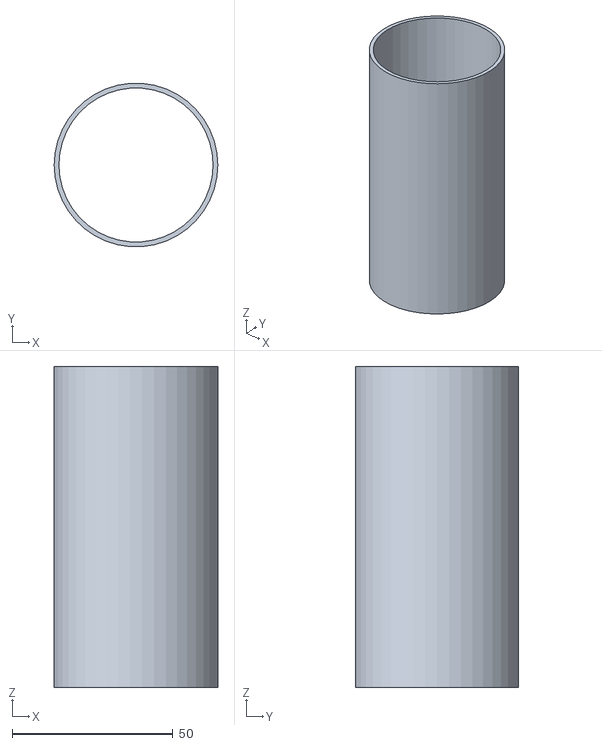
[picture p135: CAD file, 2026-11-10]
3D parts/assembly/fit_meshes/nomex_wrap.stl
51.0 x 50.9 x 100.0
