swaroopsahoo4908/GTR70E-WYVERN/Simulations/CFD/simscale/geometry/A1_solids.step

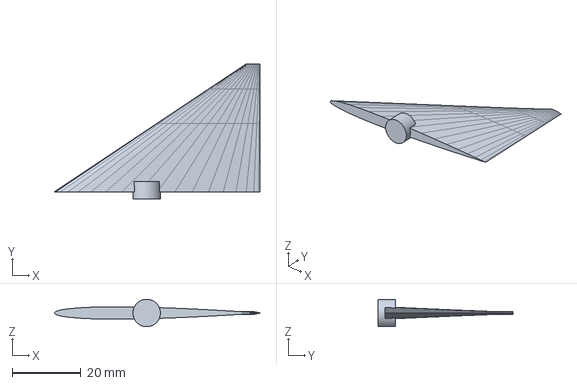
[picture p136: CAD file, 2026-11-10]
Simulations/CFD/simscale/geometry/A1_solids.step
60.0 x 39.2 x 8.00 mm
