swaroopsahoo4908/GTR70E-WYVERN/3D parts/assembly/fit_meshes/pololu_2810_switch.stl

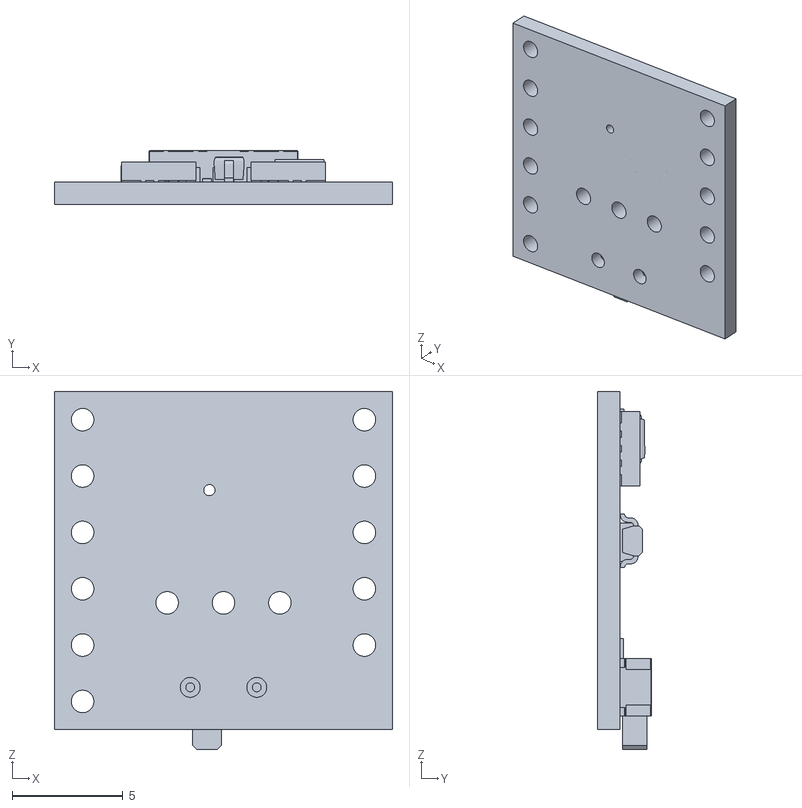
[picture p137: CAD file, 2026-11-10]
3D parts/assembly/fit_meshes/pololu_2810_switch.stl
15.2 x 2.42 x 16.1
