swaroopsahoo4908/GTR70E-WYVERN/3D parts/assembly/fit_meshes/perfboard_16x62.stl

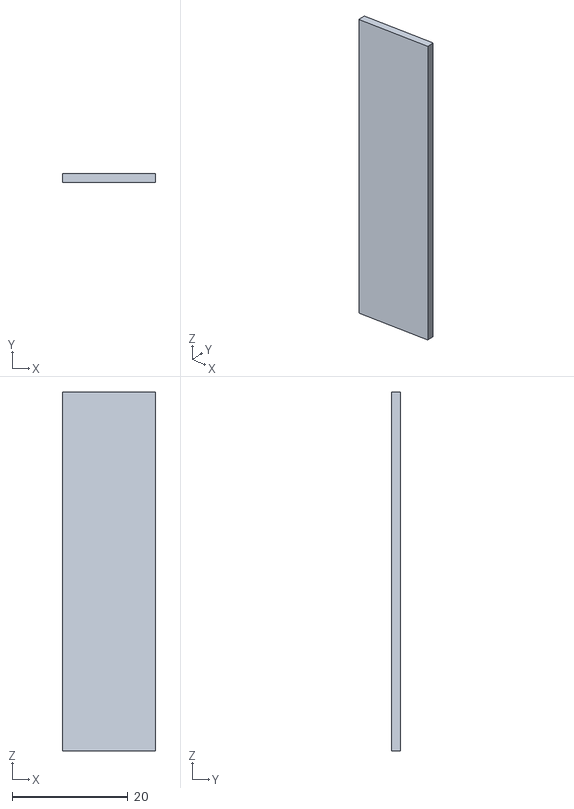
[picture p138: CAD file, 2026-11-10]
3D parts/assembly/fit_meshes/perfboard_16x62.stl
16.0 x 1.60 x 62.0
