swaroopsahoo4908/GTR70E-WYVERN/3D parts/assembly/fit_meshes/feather.stl

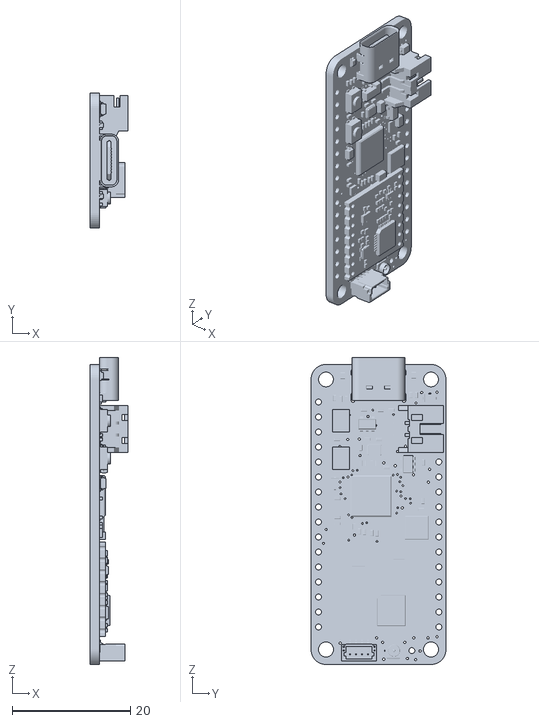
[picture p139: CAD file, 2026-11-10]
3D parts/assembly/fit_meshes/feather.stl
6.37 x 22.9 x 52.0
