swaroopsahoo4908/GTR70E-WYVERN/3D parts/assembly/fit_meshes/arm_button_6mm.stl

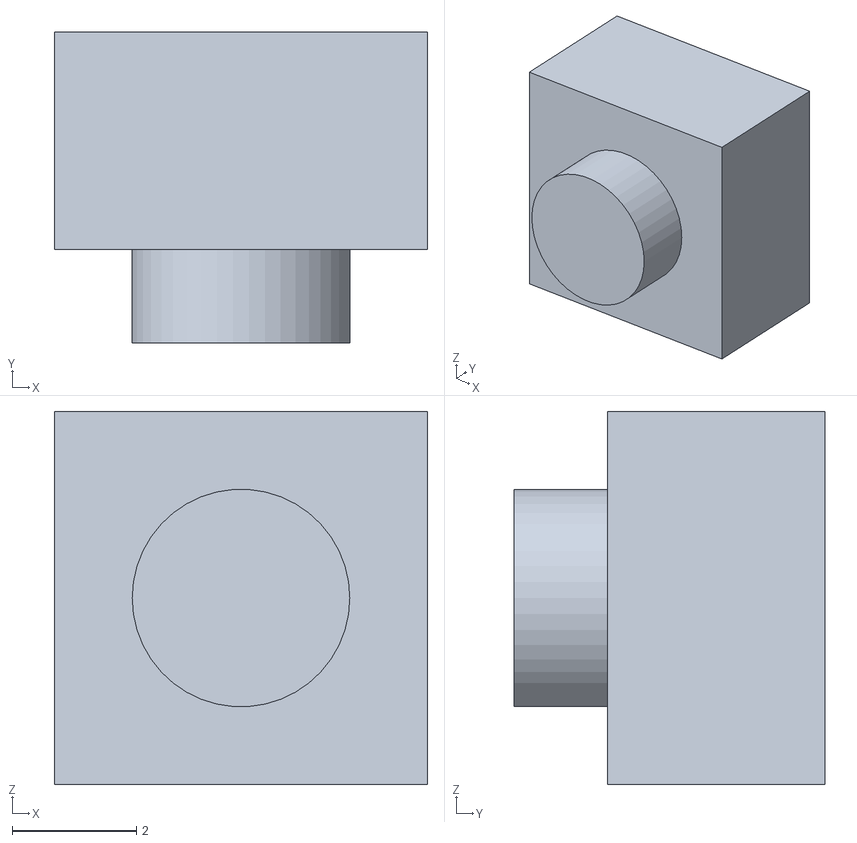
[picture p140: CAD file, 2026-11-10]
3D parts/assembly/fit_meshes/arm_button_6mm.stl
6.00 x 5.00 x 6.00
