swaroopsahoo4908/GTR70E-WYVERN/3D parts/assembly/fit_meshes/adafruit_MPM3610_buck_servo.stl

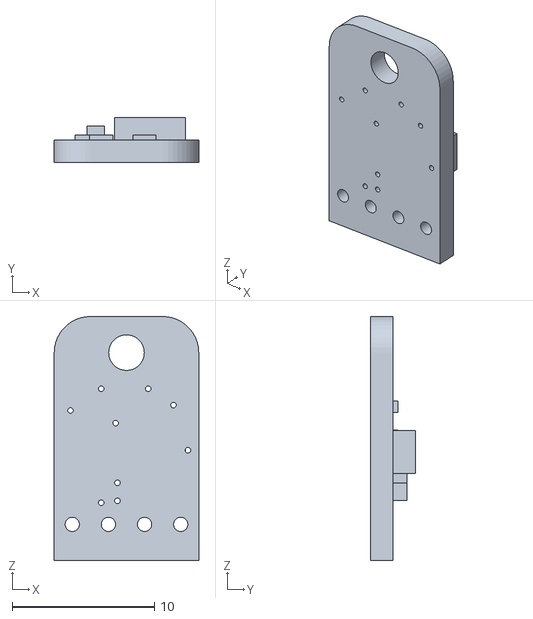
[picture p141: CAD file, 2026-11-10]
3D parts/assembly/fit_meshes/adafruit_MPM3610_buck_servo.stl
10.2 x 3.17 x 17.1
