swaroopsahoo4908/GTR70E-WYVERN/3D parts/assembly/fit_meshes/bno085.stl

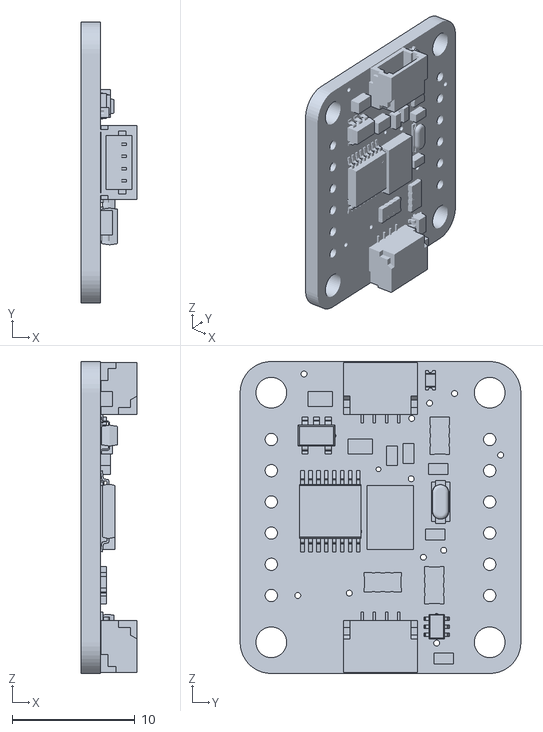
[picture p142: CAD file, 2026-11-10]
3D parts/assembly/fit_meshes/bno085.stl
4.53 x 22.9 x 25.4
