swaroopsahoo4908/GTR70E-WYVERN/Simulations/CFD/simscale/geometry/R1_part_stab_az45.stl

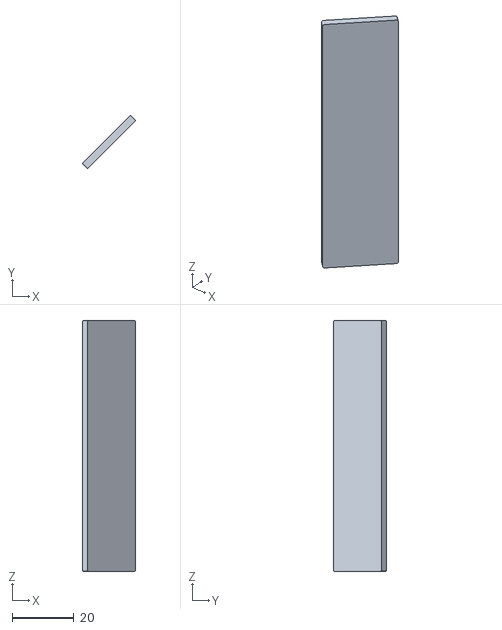
[picture p143: CAD file, 2026-10-18]
Simulations/CFD/simscale/geometry/R1_part_stab_az45.stl
17.3 x 17.3 x 81.0
