swaroopsahoo4908/GTR70E-WYVERN/(list of files, cad)

Other CAD files:
3D parts/control_fins/NACA0006/cfin_NACA0006_H45_PETGCF.step
Past Iterations/WYVERN-E KiCad/FC100/WYVERN-E_FC100.step
3D parts/control_fins/NACA0012/cfin_NACA0012_H35_PETGCF.step
3D parts/control_fins/NACA0012/cfin_NACA0012_H30_PETGCF.step
3D parts/control_fins/flat_plate/cfin_flat_plate_H45_PETGCF.step
3D parts/control_fins/flat_plate/cfin_flat_plate_H40_PETGCF.step
Simulations/CFD/simscale/geometry/A1_fluid.step
Simulations/CFD/simscale/geometry/R3_part_cfin_az0.stl
3D parts/flight/03_rb_floor_coupler_PCFR.step
Simulations/CFD/simscale/geometry/A5_fluid.step
3D parts/assembly/fit_meshes/stabilizer_0.stl
3D parts/assembly/fit_meshes/stabilizer_1.stl
3D parts/flight/05b_avionics_spine_PETGCF.step
3D parts/assembly/fit_meshes/control_fin_az270.stl
Simulations/CFD/simscale/geometry/A3_fluid.step
3D parts/assembly/fit_meshes/bme688.stl
Simulations/CFD/simscale/geometry/R3_part_cfin_az180.stl
3D parts/flight/04_control_tube_servo_ring_ASAAero.step
Simulations/CFD/simscale/geometry/R3_part_stab_az45.stl
3D parts/assembly/fit_meshes/stabilizer_3.stl
Simulations/CFD/simscale/geometry/R1_part_body.stl
Simulations/CFD/simscale/geometry/A6_fluid.step
3D parts/assembly/fit_meshes/servo_hub_az0.stl
3D parts/wind_tunnel/WTA_diffuser_100sq_to_8in_round_PETG.step
3D parts/assembly/fit_meshes/servo_hub_az270.stl
Simulations/CFD/simscale/geometry/A2_fluid.step
Simulations/CFD/simscale/geometry/R3_part_stab_az135.stl
3D parts/assembly/fit_meshes/servo_horn_az270.stl
Simulations/CFD/simscale/geometry/A2_solids.step
3D parts/assembly/fit_meshes/servo_horn_az0.stl
Simulations/CFD/simscale/geometry/R3_part_cfin_az270.stl
3D parts/assembly/fit_meshes/servo_horn_az180.stl
Simulations/CFD/simscale/geometry/R1_part_cfin_az90.stl
3D parts/assembly/fit_meshes/EMAX_ES9251II_az180.stl
Simulations/CFD/simscale/geometry/R2_part_cfin_az0.stl
3D parts/assembly/fit_meshes/servo_hub_az90.stl
Simulations/CFD/simscale/geometry/A7_fluid.step
Simulations/CFD/simscale/geometry/R2_fluid.step
3D parts/assembly/fit_meshes/rail_button_printed_lower.stl
Simulations/CFD/simscale/geometry/R3_part_stab_az225.stl
Simulations/CFD/simscale/geometry/R3_solids.step
Simulations/CFD/simscale/geometry/R1_fluid.step
Simulations/CFD/simscale/geometry/A1_part_fin_and_hub.stl
3D parts/assembly/fit_meshes/bmp388.stl
Simulations/CFD/simscale/geometry/A5_part_fin_and_hub.stl
3D parts/assembly/fit_meshes/control_fin_az0.stl
3D parts/assembly/fit_meshes/EMAX_ES9251II_az270.stl
Simulations/CFD/simscale/geometry/A3_part_fin_and_hub.stl
3D parts/assembly/fit_meshes/02_recovery_bay_tube_ASAAero.stl
3D parts/assembly/GTR70E_WYVERN_fin_assembly.stl
3D parts/assembly/fit_meshes/01_nose_tangent_ogive_150_ASAAero.stl
3D parts/assembly/fit_meshes/05_spine_deck_PETGCF.stl
3D parts/assembly/fit_meshes/07_motor_bay_tube_ASAAero.stl
3D parts/assembly/fit_meshes/08_plenum_bulkhead_PCFR.stl
3D parts/assembly/fit_meshes/09_motor_mount_tube_aft_ring_PCFR.stl
3D parts/assembly/fit_meshes/10_motor_retainer_cap_PCFR.stl
3D parts/assembly/fit_meshes/14_bypass_tube_PCFR.stl
3D parts/assembly/fit_meshes/AeroTech_F42-6T.stl
3D parts/assembly/fit_meshes/EMAX_ES9251II_az90.stl
3D parts/assembly/fit_meshes/KST_X08_Plus_az0.stl
3D parts/assembly/fit_meshes/KST_X08_Plus_az180.stl
3D parts/assembly/fit_meshes/KST_X08_Plus_az270.stl
3D parts/assembly/fit_meshes/KST_X08_Plus_az90.stl
3D parts/assembly/fit_meshes/M5_eyebolt.stl
3D parts/assembly/fit_meshes/adafruit_MPM3610_buck.stl
3D parts/assembly/fit_meshes/bypass_tube_3_8in_Al.stl
3D parts/assembly/fit_meshes/control_fin_az90.stl
3D parts/assembly/fit_meshes/gps.stl
3D parts/assembly/fit_meshes/lipo_2S_450.stl
3D parts/assembly/fit_meshes/microsd.stl
3D parts/assembly/fit_meshes/microsd_254.stl
3D parts/assembly/fit_meshes/oring_plenum.stl
3D parts/assembly/fit_meshes/oring_rb_floor.stl
3D parts/assembly/fit_meshes/perfboard_16x60.stl
3D parts/assembly/fit_meshes/piezo_12mm_lowprofile.stl
3D parts/assembly/fit_meshes/pololu_D24V10F5_buck.stl
3D parts/assembly/fit_meshes/rail_button_1010_lower.stl
3D parts/assembly/fit_meshes/rail_button_1010_upper.stl
3D parts/assembly/fit_meshes/rail_button_printed_upper.stl
3D parts/assembly/fit_meshes/rail_button_spacer_lower.stl
3D parts/assembly/fit_meshes/rail_button_spacer_upper.stl
3D parts/assembly/fit_meshes/screw_switch_standoff_M2.stl
3D parts/assembly/fit_meshes/servo_hub_az180.stl
3D parts/assembly/fit_meshes/stabilizer_2.stl
3D parts/control_fins/NACA0006/cfin_NACA0006_H20_PETGCF.stl
3D parts/control_fins/NACA0006/cfin_NACA0006_H25_PETGCF.stl
3D parts/control_fins/NACA0006/cfin_NACA0006_H30_PETGCF.stl
3D parts/control_fins/NACA0006/cfin_NACA0006_H35_PETGCF.stl
3D parts/control_fins/NACA0006/cfin_NACA0006_H40_PETGCF.stl
3D parts/control_fins/NACA0006/cfin_NACA0006_H45_PETGCF.stl
3D parts/control_fins/NACA0012/cfin_NACA0012_H20_PETGCF.stl
3D parts/control_fins/NACA0012/cfin_NACA0012_H25_PETGCF.stl
3D parts/control_fins/NACA0012/cfin_NACA0012_H30_PETGCF.stl
3D parts/control_fins/NACA0012/cfin_NACA0012_H35_PETGCF.stl
3D parts/control_fins/NACA0012/cfin_NACA0012_H40_PETGCF.stl
3D parts/control_fins/NACA0012/cfin_NACA0012_H45_PETGCF.stl
3D parts/control_fins/double_wedge/cfin_double_wedge_H20_PETGCF.stl
3D parts/control_fins/double_wedge/cfin_double_wedge_H25_PETGCF.stl
3D parts/control_fins/double_wedge/cfin_double_wedge_H30_PETGCF.stl
3D parts/control_fins/double_wedge/cfin_double_wedge_H35_PETGCF.stl
3D parts/control_fins/double_wedge/cfin_double_wedge_H40_PETGCF.stl
3D parts/control_fins/double_wedge/cfin_double_wedge_H45_PETGCF.stl
3D parts/control_fins/flat_plate/cfin_flat_plate_H20_PETGCF.stl
3D parts/control_fins/flat_plate/cfin_flat_plate_H25_PETGCF.stl
3D parts/control_fins/flat_plate/cfin_flat_plate_H30_PETGCF.stl
3D parts/control_fins/flat_plate/cfin_flat_plate_H35_PETGCF.stl
3D parts/control_fins/flat_plate/cfin_flat_plate_H40_PETGCF.stl
3D parts/control_fins/flat_plate/cfin_flat_plate_H45_PETGCF.stl
3D parts/flight/01_nose_tangent_ogive_150_ASAAero.stl
3D parts/flight/02_recovery_bay_tube_ASAAero.stl
3D parts/flight/03_rb_floor_coupler_PCFR.stl
3D parts/flight/04_control_tube_servo_ring_ASAAero.stl
3D parts/flight/05_spine_deck_PETGCF.stl
3D parts/flight/05b_avionics_spine_PETGCF.stl
3D parts/flight/06_servo_hub_PETGCF_x4.stl
3D parts/flight/07_motor_bay_tube_ASAAero.stl
3D parts/flight/08_plenum_bulkhead_PCFR.stl
3D parts/flight/09_motor_mount_tube_aft_ring_PCFR.stl
3D parts/flight/10_motor_retainer_cap_PCFR.stl
3D parts/flight/12_rect_fin_PETGCF_x4.stl
3D parts/flight/13_rail_button_1010_printed_PETGCF_x2.stl
3D parts/flight/14_bypass_tube_PCFR.stl
3D parts/flight/15_fin_zero_jig_PETG.stl
3D parts/wind_tunnel/WTA_calibration_pulley_bracket_PETG.stl
3D parts/wind_tunnel/WTA_calibration_pulley_wheel_PETG.stl
3D parts/wind_tunnel/WTA_diffuser_100sq_to_6in_round_PETG.stl
3D parts/wind_tunnel/WTA_fin_zero_jig_PETG.stl
3D parts/wind_tunnel/WTA_hub_gear40_m1_PETGCF.stl
3D parts/wind_tunnel/WTA_inclined_manometer_lid_PETG.stl
3D parts/wind_tunnel/WTA_inclined_manometer_ramp_PETG.stl
3D parts/wind_tunnel/WTA_reflection_plane_wall_panel_PETG.stl
3D parts/wind_tunnel/WTA_sensor_gear20_m1_PETGCF.stl
3D parts/wind_tunnel/WTA_servo_balance_cradle_PETG.stl
3D parts/wind_tunnel/WTB_slot_plug_x8_PETG.stl
3D parts/wind_tunnel/WTB_stabilizer_blade_span20_PETGCF_x4.stl
3D parts/wind_tunnel/WTB_stabilizer_blade_span30_PETGCF_x4.stl
3D parts/wind_tunnel/WTB_stabilizer_blade_span40_PETGCF_x4.stl
3D parts/wind_tunnel/WTB_stabilizer_tail_section_ASA.stl
3D parts/wind_tunnel/WT_adapter_228sq_to_200sq_x2_PETG.stl
3D parts/wind_tunnel/WT_diffuser_200sq_to_8in_round_PETG.stl
3D parts/wind_tunnel/WT_nose_fairing_ogive100_ASA.stl
3D parts/wind_tunnel/WT_strut_fairing_ASA.stl
3D parts/wind_tunnel/WT_tail_fairing_sting_socket_ASA.stl
Past Iterations/WYVERN-E-Old PCB/PCB/3D_PCB1_2026-08-09/3D_PCB1_2026-08-09.obj
Simulations/CFD/simscale/geometry/A1_fluid.stl
Simulations/CFD/simscale/geometry/A2_fluid.stl
Simulations/CFD/simscale/geometry/A2_part_fin_and_hub.stl
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
