swaroopsahoo4908/GTR70E-WYVERN/Flight Computer/wiring/W5_harness.csv

group | from | to | signal | wire | cut_length_mm | note
power | 2S LiPo XT30 | perfboard XT30 pigtail | BAT+ / BAT- | 16 AWG silicone pair | 60 | XT30 mated pair; the only removable power joint
power | XT30 pigtail (perfboard top) | 2810 VIN (wall cradle) | BAT+ | 22 AWG silicone, red | 50 | 2810 sits in the CT-wall cradle at +Y, above the perfboard
power | 2810 VOUT (wall cradle) | perfboard VSW bus | VSW | 22 AWG silicone, red | 50 | the VSW bus runs the length of the perfboard edge
power | 2810 GND (wall cradle) | perfboard GND star | GND | 22 AWG silicone, black | 50
power | perfboard VSW bus | MPM3610 VIN | VSW | on-board | 0 | EN unconnected (enabled by default; tie low to shut off)
power | MPM3610 5V | 1N5817 anode (on the perfboard) | 5V | on-board | 0 | Schottky so USB on the bench can never back-feed the buck (Pico datasheet's external-supply circuit)
power | 1N5817 cathode | Pico VSYS (pin 39) | 5V | 24 AWG silicone, red | 90 | +Y to +X face around the spine
power | perfboard GND star | Pico GND (pin 38) | GND | 24 AWG silicone, black | 90 | star point on the perfboard
power | perfboard VSW bus | MPM3610 #2 VIN (servo buck) | VSW | on-board | 0 | rev 3f: the ES9251 II is a 4.5-6 V servo
power | MPM3610 #2 5V | perfboard SRV bus | SRV | on-board | 0 | servo rail only; EN unconnected
power | perfboard SRV bus | 470 µF + 100 nF (underside) | SRV | on-board | 0 | servo rail bulk cap
power | perfboard divider 100k/47k + 100 nF | Pico GP26 (ADC0) | VBAT_SENSE | 28 AWG silicone, orange | 90 | VBAT x 47/147; 3.3 V max at the pin
servo | servo 0 A+ (az 0) red / brown | perfboard SRV / GND | SRV / GND | servo lead, shortened | 110 | solder; up the +X/+Y diagonal slot
servo | servo 1 A- (az 180) red / brown | perfboard SRV / GND | SRV / GND | servo lead, shortened | 130 | up the -X/-Y slot, round the spine foot
servo | servo 2 B+ (az 90) red / brown | perfboard SRV / GND | SRV / GND | servo lead, shortened | 100 | up the +Y slot
servo | servo 3 B- (az 270) red / brown | perfboard SRV / GND | SRV / GND | servo lead, shortened | 130
servo | servo 0 orange | Pico GP10 | PWM A+ | servo lead signal | 110 | 200 Hz, 1 µs
servo | servo 1 orange | Pico GP11 | PWM A- | servo lead signal | 130
servo | servo 2 orange | Pico GP12 | PWM B+ | servo lead signal | 110
servo | servo 3 orange | Pico GP13 | PWM B- | servo lead signal | 130
I2C0 | BNO085 STEMMA QT | Pico GP4 SDA / GP5 SCL / 3V3 / GND | SDA SCL 3V3 GND | STEMMA QT to male header 150 mm (4209) | 150 | header pins soldered into the Pico's holes; blue = SDA, yellow = SCL
I2C0 | BNO085 INT | Pico GP6 | INT | 28 AWG silicone | 60 | data-ready, active low
I2C0 | BNO085 RST | Pico GP7 | RST | 28 AWG silicone | 60
I2C1 | BMP388 STEMMA QT | Pico GP2 SDA / GP3 SCL / 3V3 / GND | SDA1 SCL1 3V3 GND | STEMMA QT to male header 150 mm (4209) | 150 | close the BMP388's ADDR jumper first (0x76)
I2C1 | BMP388 STEMMA QT (2nd port) | BME688 STEMMA QT | SDA1 SCL1 3V3 GND | STEMMA QT 100 mm (4210) | 100 | both on -Y; BME688 stays at 0x77
SPI0 | 4682 CLK / DI / DO / CS | Pico GP18 / GP19 / GP16 / GP17 | SCK MOSI MISO CS | 4 x 28 AWG silicone, twisted with GND | 110 | -Y top to +X; 3 V only, no level shifter needed
SPI0 | 4682 3V / GND | Pico 3V3 OUT / GND | 3V3 GND | 2 x 28 AWG | 110
arm | 6 mm tactile switch (wall cradle, -Y) | Pico GP14 / GND | BUTTON | 2 x 28 AWG silicone | 110 | internal pull-up; switch to GND
arm | 3 mm LED anode via 220 R (wall cradle) | Pico GP15 | LED | 28 AWG silicone | 110 | resistor on the LED leg, heat-shrunk; cathode to the button's GND
