swaroopsahoo4908/GTR70E-WYVERN/TVC ARCHIVED/Flight Computer/wiring/_All Files.md

---
updated_at: 2026-08-02
---
# wiring, All Files

*Auto-generated index, every file and subfolder linked for vault graph connectivity.*

---

## Files

- [[Projects/Skylight/WYVERN/GTR70E WYVERN/WYVERN Project/Flight Computer/wiring/WYVERN_E4_flight_harness.kicad_sch]]
- [[Projects/Skylight/WYVERN/GTR70E WYVERN/WYVERN Project/Flight Computer/wiring/WYVERN_E4_flight_wiring_connected.kicad_sch]]
- 
- [[Projects/Skylight/WYVERN/GTR70E WYVERN/WYVERN Project/Flight Computer/wiring/WYVERN_E4_tvc_balance_harness.kicad_sch]]
- [[Projects/Skylight/WYVERN/GTR70E WYVERN/WYVERN Project/Flight Computer/wiring/WYVERN_E4_tvc_balance_servo_harness.kicad_sch]]
- [[Projects/Skylight/WYVERN/GTR70E WYVERN/WYVERN Project/Flight Computer/wiring/WYVERN_E4_tvc_balance_solenoid_harness.kicad_sch]]
- [[Projects/Skylight/WYVERN/GTR70E WYVERN/WYVERN Project/Flight Computer/wiring/gen_connected_sch.py]]
- [[Projects/Skylight/WYVERN/GTR70E WYVERN/WYVERN Project/Flight Computer/wiring/gen_wiring4.py]]
- [[Projects/Skylight/WYVERN/GTR70E WYVERN/WYVERN Project/Flight Computer/wiring/render_preview.py]]
