swaroopsahoo4908/GTR70E-WYVERN/TVC ARCHIVED/Past Iterations/WYVERN-E 3.0/Wind Tunnel/modular-wind-tunnel-for-stem-education-model_files/Small Printers - Alternate Chamber/_All Files.md

---
updated_at: 2026-07-30
---
# Small Printers - Alternate Chamber — All Files

*Auto-generated index — every file in this folder linked for vault graph connectivity (re-index pass, 2026-07-30).*

---

## Linked Items (auto-added)

- [[Projects/Skylight/WYVERN/Past Iterations/WYVERN-E 3.0/Wind Tunnel/modular-wind-tunnel-for-stem-education-model_files/Small Printers - Alternate Chamber/1-bell-mouth-2pc-v9.stl]]
- [[Projects/Skylight/WYVERN/Past Iterations/WYVERN-E 3.0/Wind Tunnel/modular-wind-tunnel-for-stem-education-model_files/Small Printers - Alternate Chamber/2-honeycomb-hex-infill-core-2pc-v11.stl]]
- [[Projects/Skylight/WYVERN/Past Iterations/WYVERN-E 3.0/Wind Tunnel/modular-wind-tunnel-for-stem-education-model_files/Small Printers - Alternate Chamber/3-basic-duct-section-2pc-v9.stl]]
- [[Projects/Skylight/WYVERN/Past Iterations/WYVERN-E 3.0/Wind Tunnel/modular-wind-tunnel-for-stem-education-model_files/Small Printers - Alternate Chamber/4-smoke-strut-section-2pc-v8.stl]]
- [[Projects/Skylight/WYVERN/Past Iterations/WYVERN-E 3.0/Wind Tunnel/modular-wind-tunnel-for-stem-education-model_files/Small Printers - Alternate Chamber/5-6b-small-smoke-strut-section-v2.stl]]
- [[Projects/Skylight/WYVERN/Past Iterations/WYVERN-E 3.0/Wind Tunnel/modular-wind-tunnel-for-stem-education-model_files/Small Printers - Alternate Chamber/5a-contraction-cone-2pc-v5.stl]]
- [[Projects/Skylight/WYVERN/Past Iterations/WYVERN-E 3.0/Wind Tunnel/modular-wind-tunnel-for-stem-education-model_files/Small Printers - Alternate Chamber/5b-contraction-cone-2pc-v5.stl]]
- [[Projects/Skylight/WYVERN/Past Iterations/WYVERN-E 3.0/Wind Tunnel/modular-wind-tunnel-for-stem-education-model_files/Small Printers - Alternate Chamber/emt-cradle-small-chamber-2pc-v4.stl]]
- [[Projects/Skylight/WYVERN/Past Iterations/WYVERN-E 3.0/Wind Tunnel/modular-wind-tunnel-for-stem-education-model_files/Small Printers - Alternate Chamber/junction-ring-lg-2pc.stl]]
- [[Projects/Skylight/WYVERN/Past Iterations/WYVERN-E 3.0/Wind Tunnel/modular-wind-tunnel-for-stem-education-model_files/Small Printers - Alternate Chamber/junction-ring-med-1pc.stl]]
- [[Projects/Skylight/WYVERN/Past Iterations/WYVERN-E 3.0/Wind Tunnel/modular-wind-tunnel-for-stem-education-model_files/Small Printers - Alternate Chamber/junction-ring-sm-1pc.stl]]
