swaroopsahoo4908/GTR70E-WYVERN/Documentation/diagrams/D3_assembly_stages.png

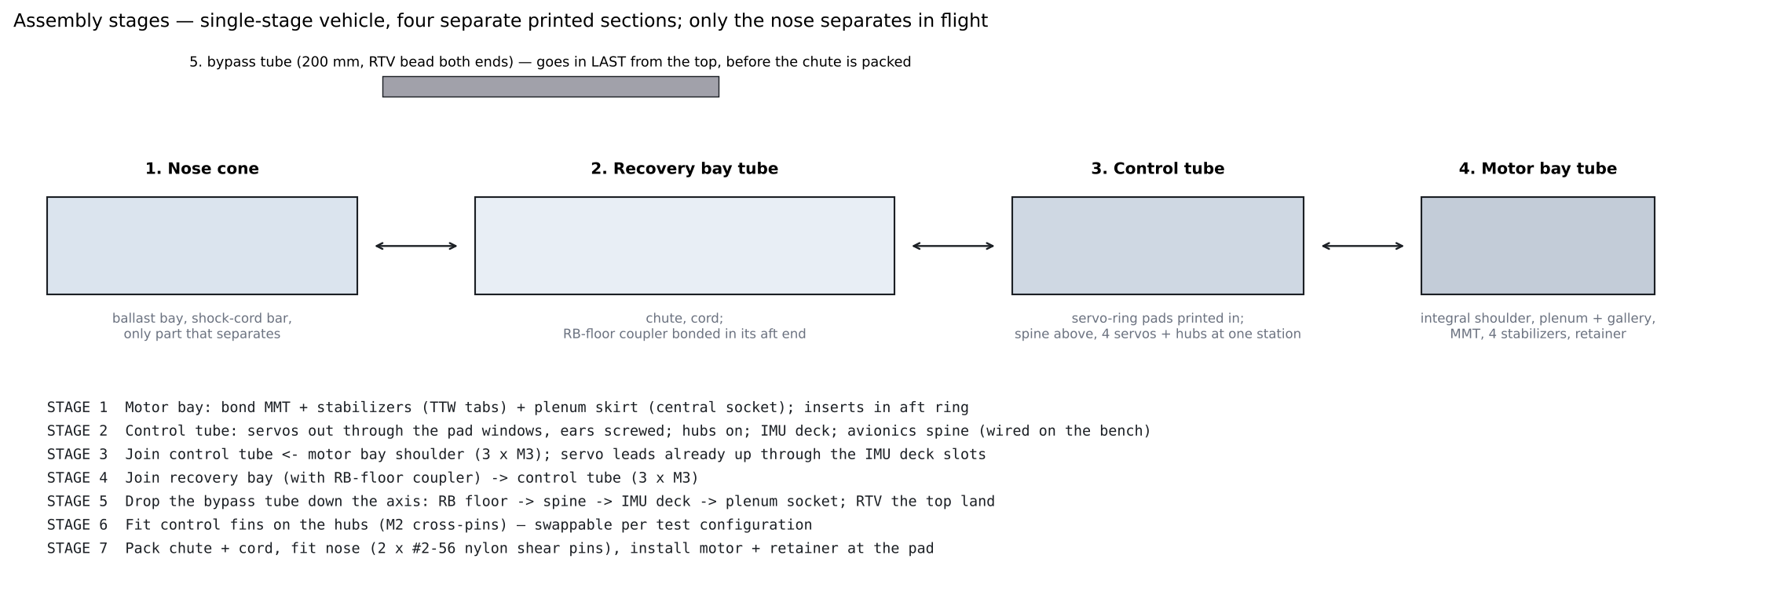
Documentation/diagrams/D3_assembly_stages.png
