swaroopsahoo4908/GTR70E-WYVERN/Flight Computer/wiring/W1_wiring.png

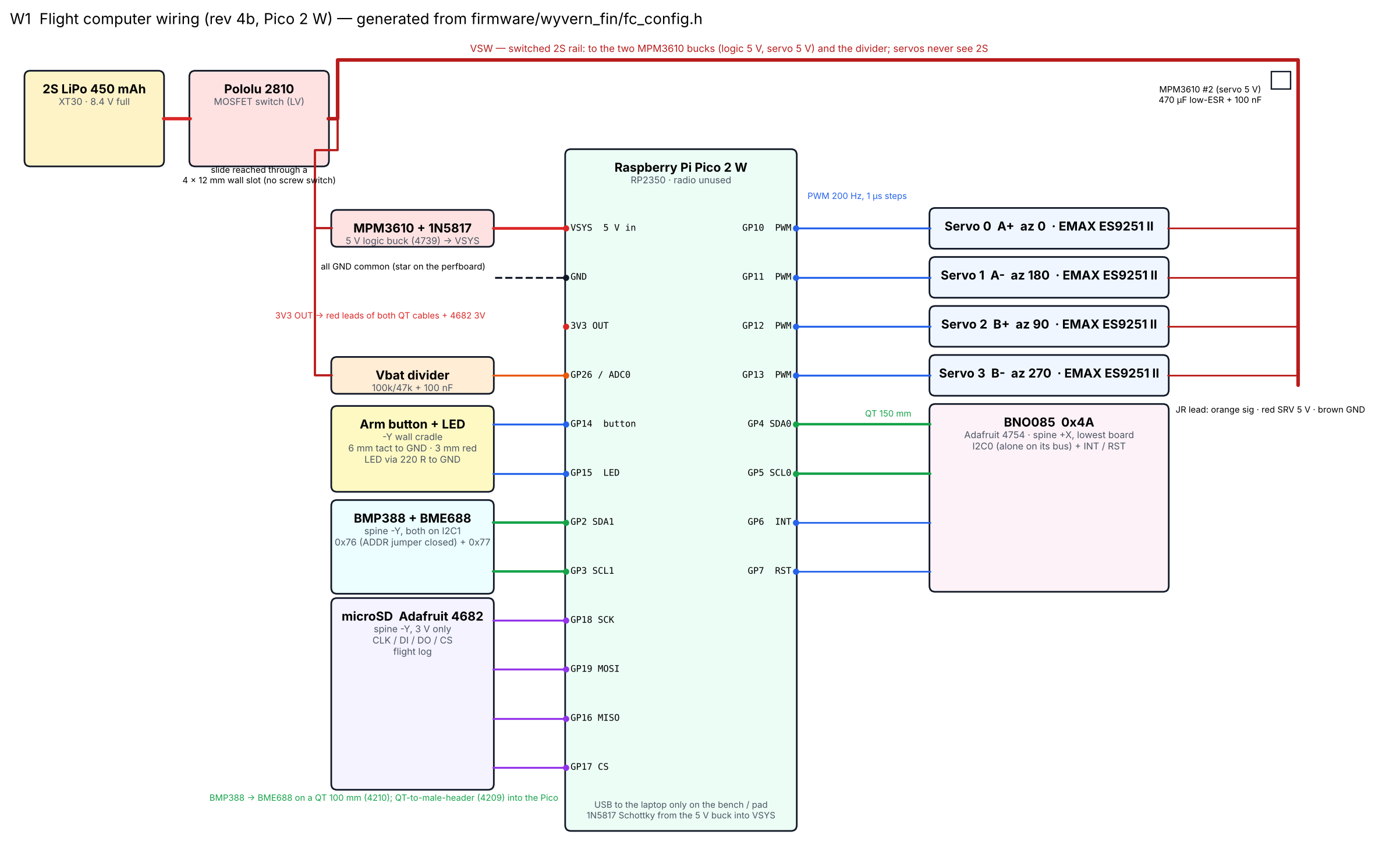
Flight Computer/wiring/W1_wiring.png
