swaroopsahoo4908/GTR70E-WYVERN/Flight Computer/wiring/W2_power_tree.png

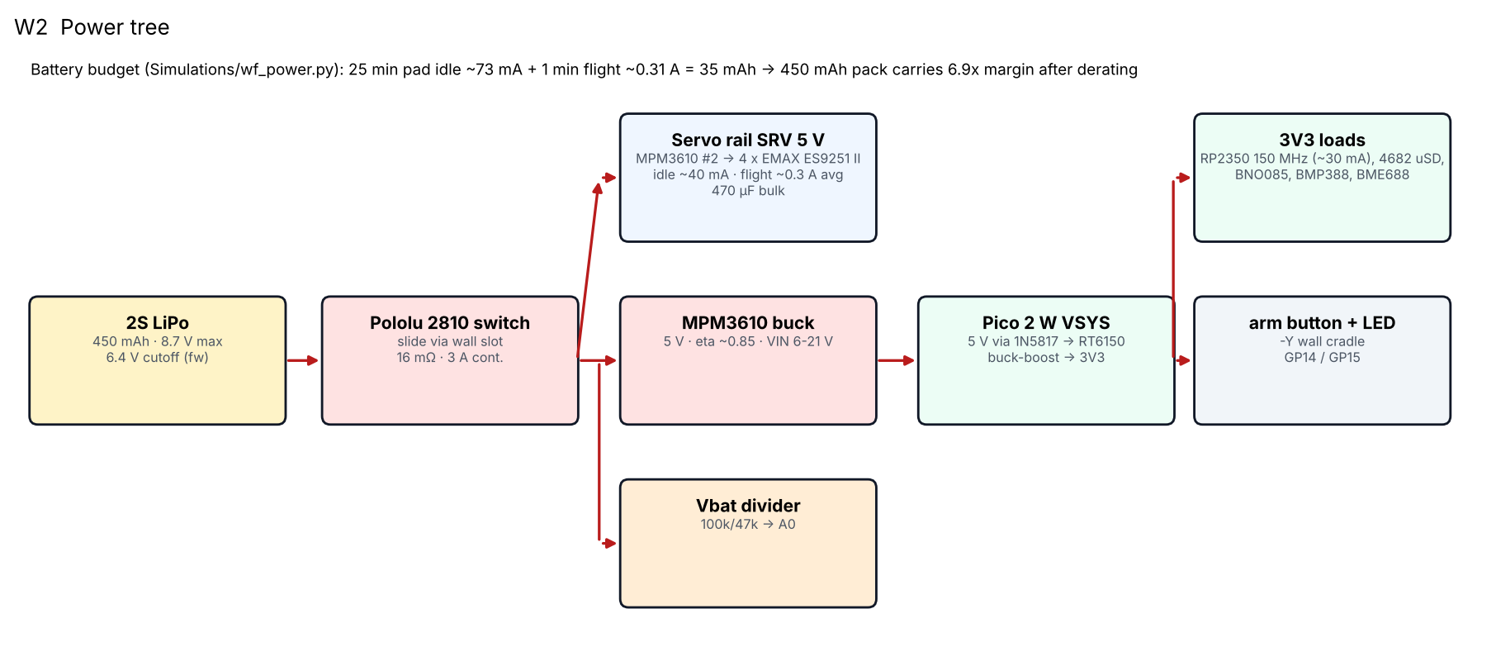
Flight Computer/wiring/W2_power_tree.png
