swaroopsahoo4908/GTR70E-WYVERN/Flight Computer/wiring/W3_system.png

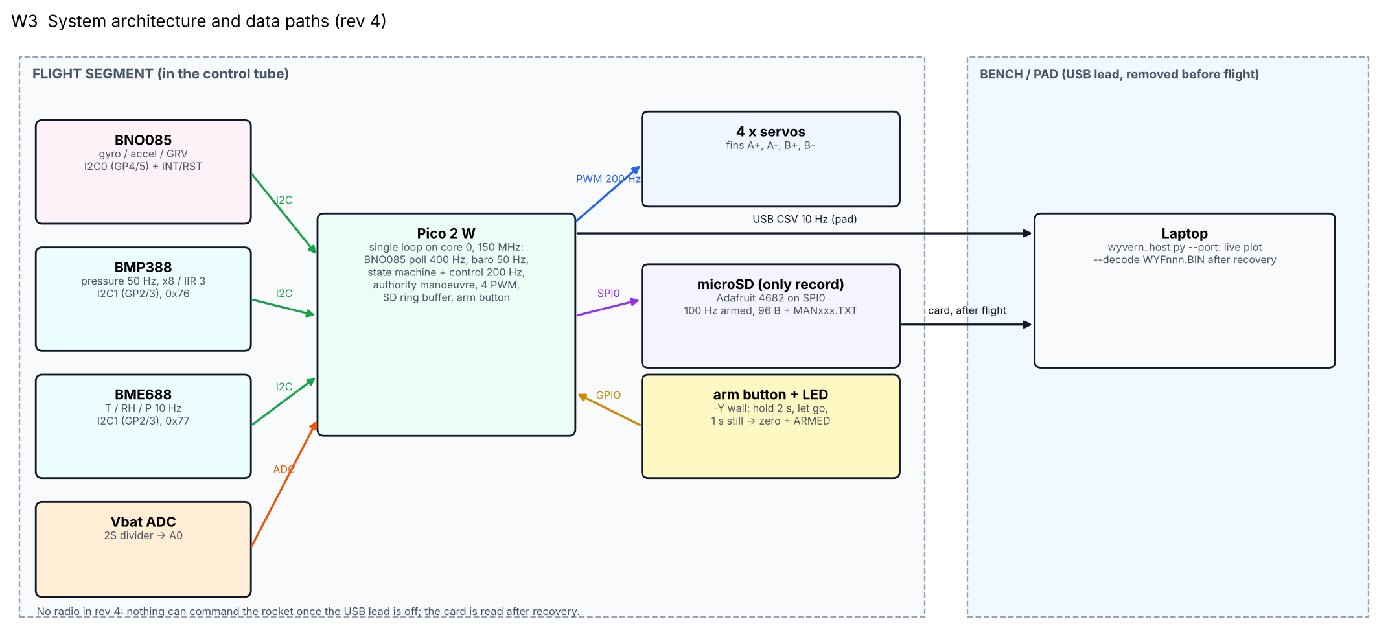
Flight Computer/wiring/W3_system.png
