swaroopsahoo4908/GTR70E-WYVERN/Flight Computer/wiring/W4_spine_perfboard.png

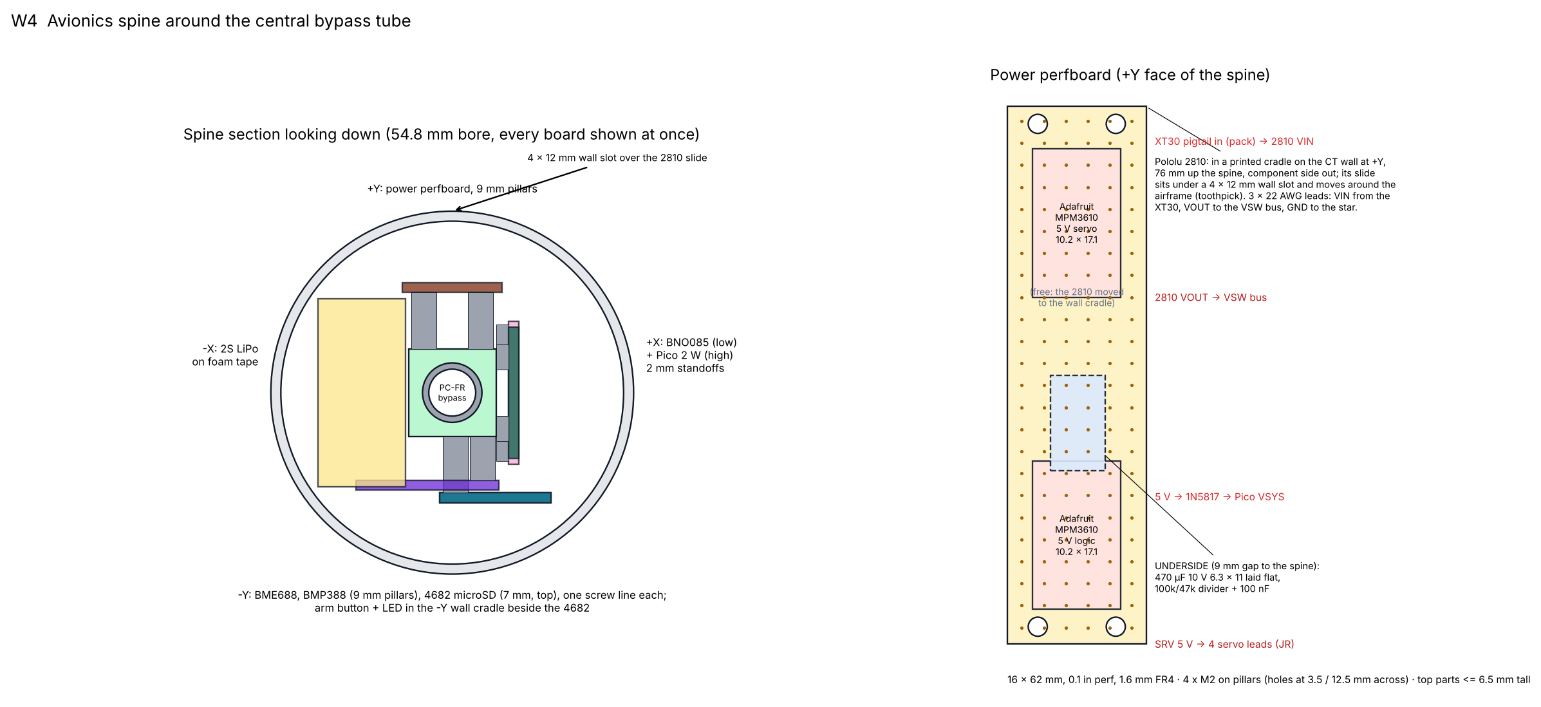
Flight Computer/wiring/W4_spine_perfboard.png
