swaroopsahoo4908/GTR70E-WYVERN/TVC ARCHIVED/Motor Test Stand/TVC Thrust-Vector Balance/_All Files.md

---
updated_at: 2026-08-02
---
# TVC Thrust-Vector Balance, All Files

*Auto-generated index, every file and subfolder linked for vault graph connectivity.*

---

## Files

- [[Projects/Skylight/WYVERN/GTR70E WYVERN/WYVERN Project/Motor Test Stand/TVC Thrust-Vector Balance/TVC_balance_base.step]]
- [[Projects/Skylight/WYVERN/GTR70E WYVERN/WYVERN Project/Motor Test Stand/TVC Thrust-Vector Balance/TVC_balance_base.stl]]
- [[Projects/Skylight/WYVERN/GTR70E WYVERN/WYVERN Project/Motor Test Stand/TVC Thrust-Vector Balance/TVC_balance_flexure_template.step]]
- [[Projects/Skylight/WYVERN/GTR70E WYVERN/WYVERN Project/Motor Test Stand/TVC Thrust-Vector Balance/TVC_balance_flexure_template.stl]]
- [[Projects/Skylight/WYVERN/GTR70E WYVERN/WYVERN Project/Motor Test Stand/TVC Thrust-Vector Balance/TVC_balance_thrust_block.step]]
- [[Projects/Skylight/WYVERN/GTR70E WYVERN/WYVERN Project/Motor Test Stand/TVC Thrust-Vector Balance/TVC_balance_thrust_block.stl]]
