swaroopsahoo4908/GTR70E-WYVERN/TVC ARCHIVED/Past Iterations/WYVERN-E 3.0/Motor Test Stand/_All Files.md

---
updated_at: 2026-07-30
---
# Motor Test Stand — All Files

*Auto-generated index — every file in this folder linked for vault graph connectivity (re-index pass, 2026-07-30).*

---

## Linked Items (auto-added)

- [[Projects/Skylight/WYVERN/Past Iterations/WYVERN-E 3.0/Motor Test Stand/README.md]]
- [[Projects/Skylight/WYVERN/Past Iterations/WYVERN-E 3.0/Motor Test Stand/TS_base_plate.step]]
- [[Projects/Skylight/WYVERN/Past Iterations/WYVERN-E 3.0/Motor Test Stand/TS_base_plate.stl]]
- [[Projects/Skylight/WYVERN/Past Iterations/WYVERN-E 3.0/Motor Test Stand/TS_loadcell_bracket.step]]
- [[Projects/Skylight/WYVERN/Past Iterations/WYVERN-E 3.0/Motor Test Stand/TS_loadcell_bracket.stl]]
- [[Projects/Skylight/WYVERN/Past Iterations/WYVERN-E 3.0/Motor Test Stand/TS_motor_tower.step]]
- [[Projects/Skylight/WYVERN/Past Iterations/WYVERN-E 3.0/Motor Test Stand/TS_motor_tower.stl]]
