swaroopsahoo4908/GTR70E-WYVERN/TVC ARCHIVED/Past Iterations/WYVERN-E 3.0/Wind Tunnel/modular-wind-tunnel-for-stem-education-model_files/Models and Model Bases - Test Section Floor/_All Files.md

---
updated_at: 2026-07-30
---
# Models and Model Bases - Test Section Floor — All Files

*Auto-generated index — every file in this folder linked for vault graph connectivity (re-index pass, 2026-07-30).*

---

## Linked Items (auto-added)

- [[Projects/Skylight/WYVERN/Past Iterations/WYVERN-E 3.0/Wind Tunnel/modular-wind-tunnel-for-stem-education-model_files/Models and Model Bases - Test Section Floor/model-3d-benchy.stl]]
- [[Projects/Skylight/WYVERN/Past Iterations/WYVERN-E 3.0/Wind Tunnel/modular-wind-tunnel-for-stem-education-model_files/Models and Model Bases - Test Section Floor/model-base-bburago-f1-car.stl]]
- [[Projects/Skylight/WYVERN/Past Iterations/WYVERN-E 3.0/Wind Tunnel/modular-wind-tunnel-for-stem-education-model_files/Models and Model Bases - Test Section Floor/model-base-chocks-for-die-cast-cars.stl]]
- [[Projects/Skylight/WYVERN/Past Iterations/WYVERN-E 3.0/Wind Tunnel/modular-wind-tunnel-for-stem-education-model_files/Models and Model Bases - Test Section Floor/model-base-chocks-for-matchbox-cars.stl]]
- [[Projects/Skylight/WYVERN/Past Iterations/WYVERN-E 3.0/Wind Tunnel/modular-wind-tunnel-for-stem-education-model_files/Models and Model Bases - Test Section Floor/model-base-emoji-bobbleheads.stl]]
- [[Projects/Skylight/WYVERN/Past Iterations/WYVERN-E 3.0/Wind Tunnel/modular-wind-tunnel-for-stem-education-model_files/Models and Model Bases - Test Section Floor/model-base-fischer-price-little-people.stl]]
- [[Projects/Skylight/WYVERN/Past Iterations/WYVERN-E 3.0/Wind Tunnel/modular-wind-tunnel-for-stem-education-model_files/Models and Model Bases - Test Section Floor/model-base-flush-floor-template.stl]]
- [[Projects/Skylight/WYVERN/Past Iterations/WYVERN-E 3.0/Wind Tunnel/modular-wind-tunnel-for-stem-education-model_files/Models and Model Bases - Test Section Floor/model-base-for-3udc-mounts-and-aero-kit-cards.stl]]
- [[Projects/Skylight/WYVERN/Past Iterations/WYVERN-E 3.0/Wind Tunnel/modular-wind-tunnel-for-stem-education-model_files/Models and Model Bases - Test Section Floor/model-base-for-mini-paper-airplanes.stl]]
- [[Projects/Skylight/WYVERN/Past Iterations/WYVERN-E 3.0/Wind Tunnel/modular-wind-tunnel-for-stem-education-model_files/Models and Model Bases - Test Section Floor/model-base-lego-duplo.stl]]
- [[Projects/Skylight/WYVERN/Past Iterations/WYVERN-E 3.0/Wind Tunnel/modular-wind-tunnel-for-stem-education-model_files/Models and Model Bases - Test Section Floor/model-base-lego-technic.stl]]
- [[Projects/Skylight/WYVERN/Past Iterations/WYVERN-E 3.0/Wind Tunnel/modular-wind-tunnel-for-stem-education-model_files/Models and Model Bases - Test Section Floor/model-base-lego.stl]]
- [[Projects/Skylight/WYVERN/Past Iterations/WYVERN-E 3.0/Wind Tunnel/modular-wind-tunnel-for-stem-education-model_files/Models and Model Bases - Test Section Floor/model-strut-for-3udc-base-and-nakozen-kit-cards.stl]]
- [[Projects/Skylight/WYVERN/Past Iterations/WYVERN-E 3.0/Wind Tunnel/modular-wind-tunnel-for-stem-education-model_files/Models and Model Bases - Test Section Floor/model-technic-axle-dimpled-sphere.stl]]
- [[Projects/Skylight/WYVERN/Past Iterations/WYVERN-E 3.0/Wind Tunnel/modular-wind-tunnel-for-stem-education-model_files/Models and Model Bases - Test Section Floor/model-technic-axle-smooth-sphere.stl]]
