swaroopsahoo4908/GTR70E-WYVERN/TVC ARCHIVED/Flight Computer/test_code/_All Files.md

---
updated_at: 2026-08-02
---
# test_code, All Files

*Auto-generated index, every file and subfolder linked for vault graph connectivity.*

---

## Files

- [[Projects/Skylight/WYVERN/GTR70E WYVERN/WYVERN Project/Flight Computer/test_code/README.md]]
- [[Projects/Skylight/WYVERN/GTR70E WYVERN/WYVERN Project/Flight Computer/test_code/host_monitor.py]]
- [[Projects/Skylight/WYVERN/GTR70E WYVERN/WYVERN Project/Flight Computer/test_code/selftest.py]]
- [[Projects/Skylight/WYVERN/GTR70E WYVERN/WYVERN Project/Flight Computer/test_code/t1_i2c_scan.ino]]
- [[Projects/Skylight/WYVERN/GTR70E WYVERN/WYVERN Project/Flight Computer/test_code/t2_imu_grv_deflection.ino]]
- [[Projects/Skylight/WYVERN/GTR70E WYVERN/WYVERN Project/Flight Computer/test_code/t3_servo_sweep.ino]]
- [[Projects/Skylight/WYVERN/GTR70E WYVERN/WYVERN Project/Flight Computer/test_code/t4_sensors_sdlog.ino]]
