swaroopsahoo4908/GTR70E-WYVERN/TVC ARCHIVED/Past Iterations/WYVERN-E 1.0/Simulations/results/_All Files.md

---
updated_at: 2026-07-30
---
# results — All Files

*Auto-generated index — every file in this folder linked for vault graph connectivity (re-index pass, 2026-07-30).*

---

## Linked Items (auto-added)

- [[Projects/Skylight/WYVERN/Past Iterations/WYVERN-E 1.0/Simulations/results/disp_1.npz]]
- [[Projects/Skylight/WYVERN/Past Iterations/WYVERN-E 1.0/Simulations/results/disp_2.npz]]
- [[Projects/Skylight/WYVERN/Past Iterations/WYVERN-E 1.0/Simulations/results/env_1.npy]]
- [[Projects/Skylight/WYVERN/Past Iterations/WYVERN-E 1.0/Simulations/results/env_2.npy]]
- [[Projects/Skylight/WYVERN/Past Iterations/WYVERN-E 1.0/Simulations/results/misses.npy]]
- [[Projects/Skylight/WYVERN/Past Iterations/WYVERN-E 1.0/Simulations/results/misses_1.npy]]
- [[Projects/Skylight/WYVERN/Past Iterations/WYVERN-E 1.0/Simulations/results/misses_2.npy]]
- [[Projects/Skylight/WYVERN/Past Iterations/WYVERN-E 1.0/Simulations/results/misses_3.npy]]
- [[Projects/Skylight/WYVERN/Past Iterations/WYVERN-E 1.0/Simulations/results/results_summary.json]]
- [[Projects/Skylight/WYVERN/Past Iterations/WYVERN-E 1.0/Simulations/results/traj.npz]]
