swaroopsahoo4908/GTR70E-WYVERN/TVC ARCHIVED/Past Iterations/WYVERN-E 3.0/Flight Computer/test_code/_All Files.md

---
updated_at: 2026-07-30
---
# test_code — All Files

*Auto-generated index — every file in this folder linked for vault graph connectivity (re-index pass, 2026-07-30).*

---

## Linked Items (auto-added)

- [[Projects/Skylight/WYVERN/Past Iterations/WYVERN-E 3.0/Flight Computer/test_code/README.md]]
- [[Projects/Skylight/WYVERN/Past Iterations/WYVERN-E 3.0/Flight Computer/test_code/camera_test.py]]
- [[Projects/Skylight/WYVERN/Past Iterations/WYVERN-E 3.0/Flight Computer/test_code/i2c_scan.py]]
- [[Projects/Skylight/WYVERN/Past Iterations/WYVERN-E 3.0/Flight Computer/test_code/launch_detect.py]]
- [[Projects/Skylight/WYVERN/Past Iterations/WYVERN-E 3.0/Flight Computer/test_code/microsd_test.py]]
- [[Projects/Skylight/WYVERN/Past Iterations/WYVERN-E 3.0/Flight Computer/test_code/preflight_selftest.py]]
- [[Projects/Skylight/WYVERN/Past Iterations/WYVERN-E 3.0/Flight Computer/test_code/requirements.txt]]
- [[Projects/Skylight/WYVERN/Past Iterations/WYVERN-E 3.0/Flight Computer/test_code/sensors_selftest.py]]
- [[Projects/Skylight/WYVERN/Past Iterations/WYVERN-E 3.0/Flight Computer/test_code/tvc_control_loop.py]]
- [[Projects/Skylight/WYVERN/Past Iterations/WYVERN-E 3.0/Flight Computer/test_code/tvc_servo_test.py]]
- [[Projects/Skylight/WYVERN/Past Iterations/WYVERN-E 3.0/Flight Computer/test_code/tvc_solenoid_test.py]]
