swaroopsahoo4908/GTR70E-WYVERN/TVC ARCHIVED/Past Iterations/WYVERN-E-Old PCB/Manual/TestPoint_PCB1_2026-08-10.xlsx

Sheet: Summary
Nets Total | 38
Has Testpoint Nets | 0
No Testpoint Nets | 38
Testpoint Coverage | 0%
Top Side Testpoints | 0
Bottom Side Testpoints | 0
Test Point Count | Testpoints Count
Net Count | Net Count

Sheet: Nets Count
Net Name | Quanatity
$1N368 | 0
$1N378 | 0
$1N435 | 0
$1N403 | 0
$1N360 | 0
$1N373 | 0
$1N387 | 0
$1N402 | 0
$1N410 | 0
$1N395 | 0
$1N404 | 0
$1N405 | 0
$1N413 | 0
$1N393 | 0
$1N409 | 0
$1N401 | 0
$1N379 | 0
$1N391 | 0
$1N400 | 0
$1N399 | 0
$1N398 | 0
$1N425 | 0
$1N384 | 0
$1N406 | 0
$1N388 | 0
$1N392 | 0
$1N370 | 0
$1N418 | 0
$1N371 | 0
$1N394 | 0
$1N436 | 0
$1N367 | 0
$1N380 | 0
$1N359 | 0
$1N357 | 0
$1N426 | 0
$1N433 | 0
$1N424 | 0

Sheet: Testpoints Count
Number | Net | Center X | Center Y | Layer | Hole Size
