swaroopsahoo4908/GTR70E-WYVERN/Documentation/Decisions_and_Risks.md

# Decisions and risks (fin-control revision)

## Decision log

| # | Decision | Why | Where it lives |
|---|---|---|---|
| D1 | TVC retired; all TVC-only material moved to `TVC ARCHIVED/` | project re-scope to fin control | `TVC ARCHIVED/README.md` |
| D2 | Servos above the motor, all four in ONE ring at the same station, ears bolted to pads in the tube wall, shafts radial (direct drive) | all fins at the same height (rev 2); equal arms for both pairs; no linkage slop | `wf_core.SERVO`, `gen_wyvern_fin.ct_tube()` |
| D3 | KST X08 Plus (16.8 mm tall, 9 g, HV, 4.85 kg·cm at 7.4 V) with bases 5.0 mm from the axis; the airframe OD (58 mm) is derived from that | rev 3 request: smaller tube, less mass | Design_Overview §2 |
| D4 | Ejection bypass: printed PC-FR tube on the centreline, 9.5 mm OD x 7.5 mm ID, 205 mm (rev 3e; was 3/8 in Al) + 10 mm full-bore gallery, RTV at both sockets | the largest tube that passes between servo bases 10 mm apart; 1.0 mm wall keeps the bore close to the old 7.75 mm, so the 0.3 g kick-out stays near 0.9 kN | `wf_bypass.py` |
| D5 | Motor: AeroTech Econojet F42-4T (29 x 83 mm single-use), 4 for $87.98 (rev 3d) | cheapest motor that fits the bay; no certification; with the rev 3d airframe it reaches 549 ft, under the 600 ft cap. The F67-6W still fits but overshoots (729 ft); the F67-9C does not fit (112 mm case); Estes F15 / E16 are too long and too weak | `wf_apogee_cap_trade.py`, Design_Overview §6 |
| D6 | 250 mm recovery bay + 214 g nose ballast (rev 3d; was 110 g) | the ballast sets the apogee under the cap and moves the CG forward: 169 mm control arm, 1.01 cal; 250 mm is the longest tube a 256 mm printer takes upright | Design_Overview §1c |
| D7 | Stabilizers 81 x 20 mm (rev 3d; rev 3b was 81 x 40), 45° interleaved | halving the span halves the vortex load that fights the control fins; with the extra ballast the margin stays at 1.01 cal and per-q authority doubles. 45° stays: in line reverses control | `wf_apogee_cap_trade.py`, Design_Overview §1c, §5 |
| D8 | Feather RP2040 RFM95 in flight and a second one as the ground station (rev 3c; the Pico 2 W ground station is retired) (superseded by D35 in rev 4) | LoRa range, single board; one radio build, one pin map, one frame header at both ends | Electronics_Telemetry §1 |
| D9 | Pololu 2810 in a printed wall cradle, slide flipped through a 4 x 12 mm slot (rev 3e; was a screw switch on CTRL) | one less bought part; slide travel is around the airframe, at right angles to boost and ejection loads | W1, W4, `ct_tube()` |
| D10 | Hinge at 45 % root chord | fin CP at 58-60 % (VLM) → self-centring if a servo fails | `vlm.py` |
| D11 | Tunnel Phase A: single-fin half-model on a reflection-plane panel in the stock 100 x 100 section | the main RQ ranks fins against each other; ~3 % blockage, higher speed, one fin per configuration | Wind_Tunnel_Adaptation §2 |
| D11b | Tunnel Phase B (deferred): full finset + removable stabilizer tail in a 200 x 200 x 750 section, drawn for an 8 in fan (re-size to the Phase A 6 in fan if it is built) | body carry-over, pair interaction and the stabilizer interference (SQ1) need the whole model | Wind_Tunnel_Adaptation §3 |
| D12 | Tunnel balance reads the two TAL221s with two owned HX711s (rev 3e; was three NAU7802s behind the PCA9548) (cells superseded by D45 in rev 4b) | at 1-6 g fin loads the HX711 already resolves under 1 mg after averaging; no mux, no I2C address clash, $0; the PCA9548 becomes a spare | Wind_Tunnel_Adaptation §4.1 |
| D14 | Avionics on a square spine around the bypass: Feather +X and sensors -Y on 4 mm standoffs, battery -X on rails, 16 mm power perfboard +Y | central tube owns the axis; standoffs clear the board corners | W4, `avionics_spine()` |
| D15 | One main RQ (section x height), SQ1 stabilizer impact, SQ2 sim → tunnel → flight | revision 2 request | Research_Plan |
| D16 | Full fit-check assembly with vendor STEP models (Adafruit, Pololu) and datasheet-built bought parts; interference, bore clearance, fin sweep and 256 mm print-bed checks | rev 3 request; it found five real clashes (hub flange vs bore, MMT ring vs plenum posts, retainer vs stabilizers, spine pillars vs Feather and LiPo, a 290 mm tube too long to print) | `gen_fit_assembly.py`, FIT_REPORT.md |
| D17 | BNO085 moved from the deck to the spine's +X face | the real board is 25.4 x 22.9 mm and cannot sit beside the tube in a 54.8 mm bore | Design_Overview §4 |
| D18 | Both tunnel phases kept | every printed tunnel part fits a 256 mm printer | Wind_Tunnel_Adaptation §7 |
| D19 | microSD is the only log; the LittleFS copy on the QSPI flash is gone | the 20 Hz downlink is already the second record, and it frees a core-1 write path | Electronics_Telemetry §5 |
| D20 | GPS removed (rev 3d, your call). Recovery relies on the simulator's drift prediction (rev 3e also dropped the buzzer) | saves 6 g, about 30 mA and $66 (two PA1010D + cells) | Electronics_Telemetry §1 |
| D21 | ADXL375 ±200 g axial channel for the vertical estimate (superseded by D37 in rev 4) | the F67-6W holds 11 to 12 g for 0.65 s, past the BNO085's 8 g range: q̄ and the gain schedule would read about 20 m/s low at burnout | `highg.h`, Electronics_Telemetry §5 |
| D22 | One I2C bus per core (Wire1: BNO085 + ADXL375 on core 0; Wire on TX/RX: BME688 on core 1) (superseded by D36 in rev 4) | rev 3 had the BNO and BME on one bus from two cores, which arduino-pico's Wire does not support | `fc_config.h` |
| D23 | Authority-demonstration manoeuvre in early coast: ±5° doublets per axis, then 1° attitude steps; results downlinked and written to the card | measures M_δ/I and closed-loop response in flight instead of inferring it; sized to the stability-dominated airframe (1° costs 2 to 4° of fin) | Electronics_Telemetry §6, `wf_flightsim.MAN` |
| D24 | Stabilizers stay 45° from the control fins | 45° gives the best margin and the most installed authority of 0 / 22.5 / 45°; in line reverses the control | Research_Plan SQ1, Design_Overview §5 |
| D25 | Apogee capped at 600 ft without losing authority: F42-4T + 214 g ballast + 20 mm stabilizers + H45 flight fins; active control now ends at q̄ < 15 Pa instead of climb rate < 15 m/s | your rev 3d request; peak and integrated authority held at the rev 3c values, per-q authority ×2.1, gust tilt 0.44° | Design_Overview §1c |
| D26 | Servo stays the KST X08 Plus at 58 mm (rev 3e) | the SPT4420LV (20 kg low profile) forces a 97 mm, 1.43 kg vehicle on a G74 with 12.7 m/s rail exit and about half the authority; the owned ES08MA II forces 78.5 mm and either breaks the 600 ft cap (G74) or loses authority (F67) | Design_Overview §1d |
| D27 | Recovery path printed (rev 3e): PC-FR bypass, printed cord anchor, cord tied (no eyebolt, quick links or swivel), friction-fit nose (no shear pins); printed 1010 rail buttons; no buzzer; owned 254 microSD; wire antenna on the ground Feather; motor test stand dropped | your call: fewer bought parts | Design_Overview §1d, BOM |
| D28 | Tunnel airspeed from a pitot tube and a printed 1:10 inclined water manometer, typed into the Pico (rev 3e; was SDP810-125Pa + RMRC pitot, both out of stock) | fan speed on a knob is not a measured q; the manometer reads ±0.7 % of q at 11 m/s for $20 of tube, against $36-49 for MS4525DO kits of doubtful origin; air density from the spare BME688 | Wind_Tunnel_Adaptation §4.2 |
| D29 | One tunnel controller: the owned Pico 2 W drives the spare KST (on the 2S LiPo) and reads the balance; the t2 Feather and the bench supply leave the tunnel | one USB cable, one CSV, servo current off the cell rail | `wt_balance_daq` v2.0 |
| D30 | Buy only from Amazon, SparkFun or Adafruit where an equivalent exists (rev 3e): MPM3610 for the D24V10F5, GemRed gauge, Amazon XT30 / screw kit / fan / mesh / acrylic. BBs, PETG spools, the bench supply, brass tube and the SDP810 removed; smoke and laser moved to an optional sheet | cost: flight $516.48, tunnel $154.79 (was $317.55). Specialty exceptions with no Amazon match at a sane price: KST X08 (Aloft, $45 vs $93-100 on Amazon), Pololu 2810, F42-4T (eRockets) | `WYVERN_BOM.xlsx` |
| D31 | Tunnel controller is an Adafruit Metro M4 Express on the Arduino IDE (rev 3f; was a Pico 2 W) | Sky's call; the SAMD51 runs the same bit-banged HX711 reads, Servo and BME688 code. Firmware v3.0 drops the Pico-only I2C pin calls and float `printf`; compiles on the SAMD core | `wt_balance_daq` v3.0, `WYVERN_BOM.xlsx` "Metro M4 Wiring" |
| D32 | Tunnel drive: 6 in EC inline fan (405 CFM, speed controller) on a shorter 100 sq -> 6 in transition (rev 3f; was the 8 in 750 CFM AC fan) | smaller unit and print (190 vs 250 mm, 7° diffuser instead of a steep one), EC speed holds better than AC; estimated ~12 m/s against ~16 m/s, still 12-46 mN fin loads. A BLDC with a 6 in prop on the same transition is the faster option, pending the motor's specs | `WYVERN_BOM.xlsx` "Drive Options" |
| D33 | Servos: EMAX ES9251 II on a dedicated 5 V MPM3610 rail (rev 3f; was the KST X08 Plus off 2S) | $57 for 8 instead of $225 for 5; same thickness and height, so the airframe diameter holds. Torque margin falls from ~40x to ~2x at the worst corner, gears are plastic | `wf_core.SERVO`, Design_Overview §1e |
| D34 | Nose ballast 233 g (rev 3f; was 214 g) | puts back the 20 g the lighter servos removed: apogee 176 m (578 ft) instead of 184 m (604 ft), margin 1.30 cal | Design_Overview §1e |
| D35 | Flight computer: Teensy 4.1 (SparkFun DEV-16771), no radio, no ground station (rev 4; was the Feather RP2040 RFM95 pair) (board superseded by D41 in rev 4b) | Sky's call. The card already holds every research number; one 600 MHz core with no cross-core hand-off; SDIO microSD on the board; drops a board, an antenna and the Part 15 question. Cost: no live data |
| D36 | Three I2C buses, one sensor each: BNO085 on Wire, BMP388 on Wire1, BME688 on Wire2 (rev 4) (superseded by D42 in rev 4b) | both barometers default to 0x77, so no solder jumper; the IMU never waits behind a baro read |
| D37 | No high-g accelerometer; thrust-curve model while the BNO085 is clipped (rev 4; ADXL375 dropped) | Sky's call. On the F42-4T the clip lasts ~0.2 s and costs ~1 m/s uncorrected; the model removes that bias. An F67-6W (11-12 g for 0.65 s) would need the ADXL375 back |
| D38 | BMP388 as the primary altimeter (50 Hz, normal mode, register-level driver); BME688 kept for temperature and humidity, so q̄ uses measured moist-air density | lower noise than the BME688's pressure channel, non-blocking reads; density from the pad air instead of ISA |
| D39 | Arming by a pushbutton through the -Y wall (hold 2 s, release, 1 s still → zero + ARMED) with a 3 mm LED beside it (rev 4) | Sky's call over auto-arm. No radio to arm with; recessed plunger cannot be bumped on the rail; arming refused unless SD, IMU, baro, battery and rail angle all pass |
| D40 | Nose ballast 239 g (rev 4; was 233 g) | puts back the 6 g the lighter avionics removed: liftoff 784.5 g, apogee 176 m (577 ft), margin 1.36 cal |
| D41 | Flight computer: Raspberry Pi Pico 2 W, radio never started, single loop on core 0; log on an Adafruit 4682 microSD on SPI0 (rev 4b; was the Teensy 4.1) | Sky's call. Same arduino-pico core as the rest of the project, about 30 mA instead of 100 mA, $21 for two boards + two breakouts instead of $63; SPI logging works with the same pre-allocated file and ring buffer |
| D42 | Two I2C buses: BNO085 alone on I2C0; BMP388 (ADDR jumper closed, 0x76) and BME688 (0x77) share I2C1 (rev 4b) | the RP2350 has two I2C blocks; the IMU keeps a bus to itself |
| D43 | Tunnel fin angle measured by an Adafruit AS5600 on a printed 40:20 (module 1) gear train off a tunnel-only hub, rubber-band preload, all on the balance cradle; DAQ v3.1 logs commanded and measured angle (rev 4b) | Sky's idea. The servo's plastic gear backlash and wind-up under hinge load would otherwise land in the C_N slope; the 2:1 step-up gives 0.044° per count at the fin |
| D44 | No Nomex blanket; nose ballast 253 g (rev 4b; was 239 g) | Sky's call. The 14 g it weighed moves into the nose: liftoff mass and apogee (176 m) hold, margin rises to 1.44 cal |
| D45 | Tunnel balance: two 1 kg bar cells with their own HX711 modules (ShangHJ kit, $9.99), replacing the 100 g TAL221s + SparkFun HX711s (rev 4b) | Sky's call: $29 cheaper and ten times stiffer; noise stays near 0.3 % of the smallest load, creep and hysteresis handled by bracketed tares and two-way sweeps (R24) |
| D46 | No digital angle gauge (rev 4b). Zero comes from printed V-groove jigs on the root LE/TE (15_fin_zero_jig on the body, WTA_fin_zero_jig on the panel); scale from the AS5600 gear train, which also maps each flight servo's µs per degree | every section is symmetric, so LE and TE sit on the chord line; the AS5600 measures angle better than the gauge's ±0.2° |
| D13 | ToF sensors stay unused; the TVC-era ToF ring math stays in the archived `MATH_DERIVATIONS.md` | not part of either design | — |

## Risk register

| Risk | Likelihood / impact | Mitigation |
|---|---|---|
| R1 Control-fin vortex on the stabilizers cancels most of the control moment (installed/isolated 0.47 pessimistic at H = 40) | medium / high | sized for the pessimistic bound; Phase B measures it before flight (SQ1); authority monitor aborts to neutral on a reversed sign |
| R2 Servo sign error after a rebuild | medium / catastrophic | bench SIGN CHECK every time the stack is touched; authority monitor as a backstop |
| R3 Ejection under-pressure (motor charge unknown) or a nose that is too loose / too tight without shear pins | medium / high | ground test at 0.30 g; tune the shoulder friction (sand or tape) until it separates at 0.30 g and survives handling |
| R4 Motor kick-out on ejection (about 1.6 kN at 0.5 g in the model) | low / high | 4 x M3 into PC-FR inserts; checked in the ground ejection test with a spent casing (no static burn in rev 3e) |
| R5 Real masses differ from the model → CG shift | high / medium | weigh, update COTS, re-run the cascade, re-ballast |
| R6 BNO085 clips at 8 g (the F42-4T sits above it for ~0.2 s, peak ~8.9 g) | certain / low | gyro-only attitude propagation from launch; while the axial reading is clipped the vertical channel uses the F42T thrust-curve model (rev 4, D37), flag bit 6 marks those samples; the baro fusion pulls h back after burnout |
| R7 Tunnel speed below 6 m/s → small signals | medium / medium | loads scale with V²; the 1 kg cells on the HX711s still resolve about 30:1 at 6 m/s after averaging; the manometer reads q to about ±2 % there |
| R8 Fin root boss / cross-pin cracking on landing | medium / low | print spares (STLs are generated); fins are the cheapest part |
| R9 2S HV pack charges to 8.7 V | low / low (closed in rev 3f: the servos sit on a 5 V buck) | charge to 8.40 V (LiPo mode) anyway |
| R11 ES9251 II real dimensions differ from the estimates (tab span and thickness, shaft position, horn; only case size, hole spacing and tab height are published) | likely / medium | caliper check, edit `wf_core.SERVO`, regenerate before printing the control tube |
| R12 Crowded spine: leads chafe on the bypass tube, board corners touch (rev 4b: the Pico, the 4682 and the button cradle pass the fit check after moving the LiPo 11 mm down) | medium / medium | 4.85 mm lead annulus, spiral wrap on the tube in the ring, fit-check the spine stack before wiring |
| R13 F67 ejection charge unknown; the bay is half the old volume so pressures run higher | medium / medium | ground test at 0.30 g; plenum and retainer sized for 0.5 g |
| R14 The bypass tube has only 0.25 mm to each servo base | medium / low | servos sit on their pads before the tube goes in; the printed tube end is chamfered; a light touch on a static aluminium case is harmless |
| R21 Printed PC-FR bypass tube (1.0 mm wall) cracks or leaks under the ejection pulse | low / medium | hoop stress about 5 MPa at 0.3 g against roughly 50 MPa for PC-FR; print it upright at 100 % with 3 perimeters' worth of wall; the ground ejection test is the proof |
| R22 The 2810 slide gets knocked on by handling, or the cradle glue lets go | low / medium | the slot is recessed 0.3 mm; check the LED state after loading on the rail; re-glue if the board moves |
| R16 Thrust-curve model off from the real motor during the clipped window | medium / low | error is ~0.17 m/s per 1 % thrust deviation over ~0.2 s, about 1 % of q̄ at max-q; the gain schedule is clamped and the baro corrects h and v after burnout |
| R17 In a 4 m/s or stronger wind, holding vertical saturates the pair late in coast (q below about 1.3 kPa) | likely / low | the airframe stays passively stable; the manoeuvre steps in the direction that relieves the fins and skips if they are past 14°; fly in light wind for the research flights |
| R18 SimScale Community runs are public | certain / low | nothing in the geometry is sensitive; keep proprietary work out of those projects |
| R19 Rail exit 15.0 m/s, at the usual 15 m/s guideline | low / medium | fins arm at rail exit and the airframe is 1.36 cal stable; an 8 ft rail (or a 1010 rail) would add margin |
| R20 The authority gain from the 20 mm stabilizers rests on the vortex-interference model | medium / medium | it is the pessimistic single-vortex model, so the real gain is more likely smaller than larger; the margin does not depend on it. Tunnel Phase B (20 / 30 / 40 mm blades) and SimScale R1 vs R2 measure it before flight |
| R23 Ballast material: the model puts 239 g at 30 mm from the tip, but steel shot fills to about 82 mm (centroid about 60 mm), which moves the CG about 9 mm aft (margin about 1.15 cal at liftoff instead of 1.30) | likely / medium | use the densest scrap on hand (lead weights best), weigh and knife-edge the nose, enter the measured centroid in `wf_core.COTS` and re-run the cascade; liftoff margin must stay ≥ 0.9 cal |
| R24 Load-cell creep and hysteresis bias the profile ranking (1 kg cells: a few tenths of a gram against 1-6 g loads) | medium / medium | tare before and after every sweep and remove the drift, sweep both directions (s then r) and average, randomised order, check-standard fin first and last each session (flag the session if its slope moves > 2 %) |
| R25 ES9251 II plastic gears strip on a hard landing | likely / low | three spare servos in the order; swap is two tab screws and the horn |
| R26 ES9251 II torque margin: about 2x at the worst corner (15° at max q, H45) | low / medium | the q-scheduled gains keep deflections small at high q (simulated peak 0.02 kg·cm); bench-check holding torque with a 10 g weight on the horn arm |
| R27 ES9251 II frame rate unknown (firmware drives 200 Hz) | medium / low | t2 bench test; if a servo buzzes or jitters, drop WYV_SERVO_HZ to 50 |
| R28 No telemetry: a flight that lands out of sight leaves no record until the rocket is found | medium / high | 6.3 m/s descent, 20 m predicted drift at apogee in 4 m/s wind; fly in good visibility with two spotters; the LED beacons at 1 Hz after landing |
| R29 The microSD card is the only record and could stall or fail | low / high | pre-allocated file + 32 kB ring buffer written only when the card is idle; arming refused without an open log; 30 min t3 soak with the flight card (0 dropped records) |
| R30 USB plugged in with the pack on back-feeds the logic buck | medium / medium | rev 4b: 1N5817 Schottky from the buck into VSYS (Pico datasheet circuit); USB and buck OR together |
| R31 Pico 2 W current draw is an estimate (~30 mA at 150 MHz, radio off) | low / low | 6.9x margin on the 26 min mission, about 4 h pad hold; measure on the bench |
| R32 Pico 2 W out of stock at Adafruit and SparkFun (2026-11-02) | medium / low | Amazon has it at $13.99; the plain Pico 2 is pin-compatible if the W is unobtainable (change the board in arduino-cli and LED handling only) |
| R33 Without a Nomex blanket the ejection gas can scorch or melt the rip-stop chute | medium / medium | the gas has to cross the plenum and run 200 mm up the printed bypass before it reaches the bay; check the chute after the ground ejection test, and add a wad of flame-resistant recovery wadding on top of the RB floor if it shows any marking |
| R34 Printed gear mesh adds backlash or skips under the preload | low / medium | module 1 teeth (easy to print in PETG-CF), 0.1 mm built-in clearance, one-flank preload; the g<deg> fit reports the rms residual every session, and a jump shows up as a step in deg_meas |
| R10 Altitude (176 m) on an F motor | — | NAR site dimension for F; check with the club RSO |
