swaroopsahoo4908/GTR70E-WYVERN/Past Iterations/WYVERN-E KiCad/FC70/WYVERN-E_FC70_schematic.pdf

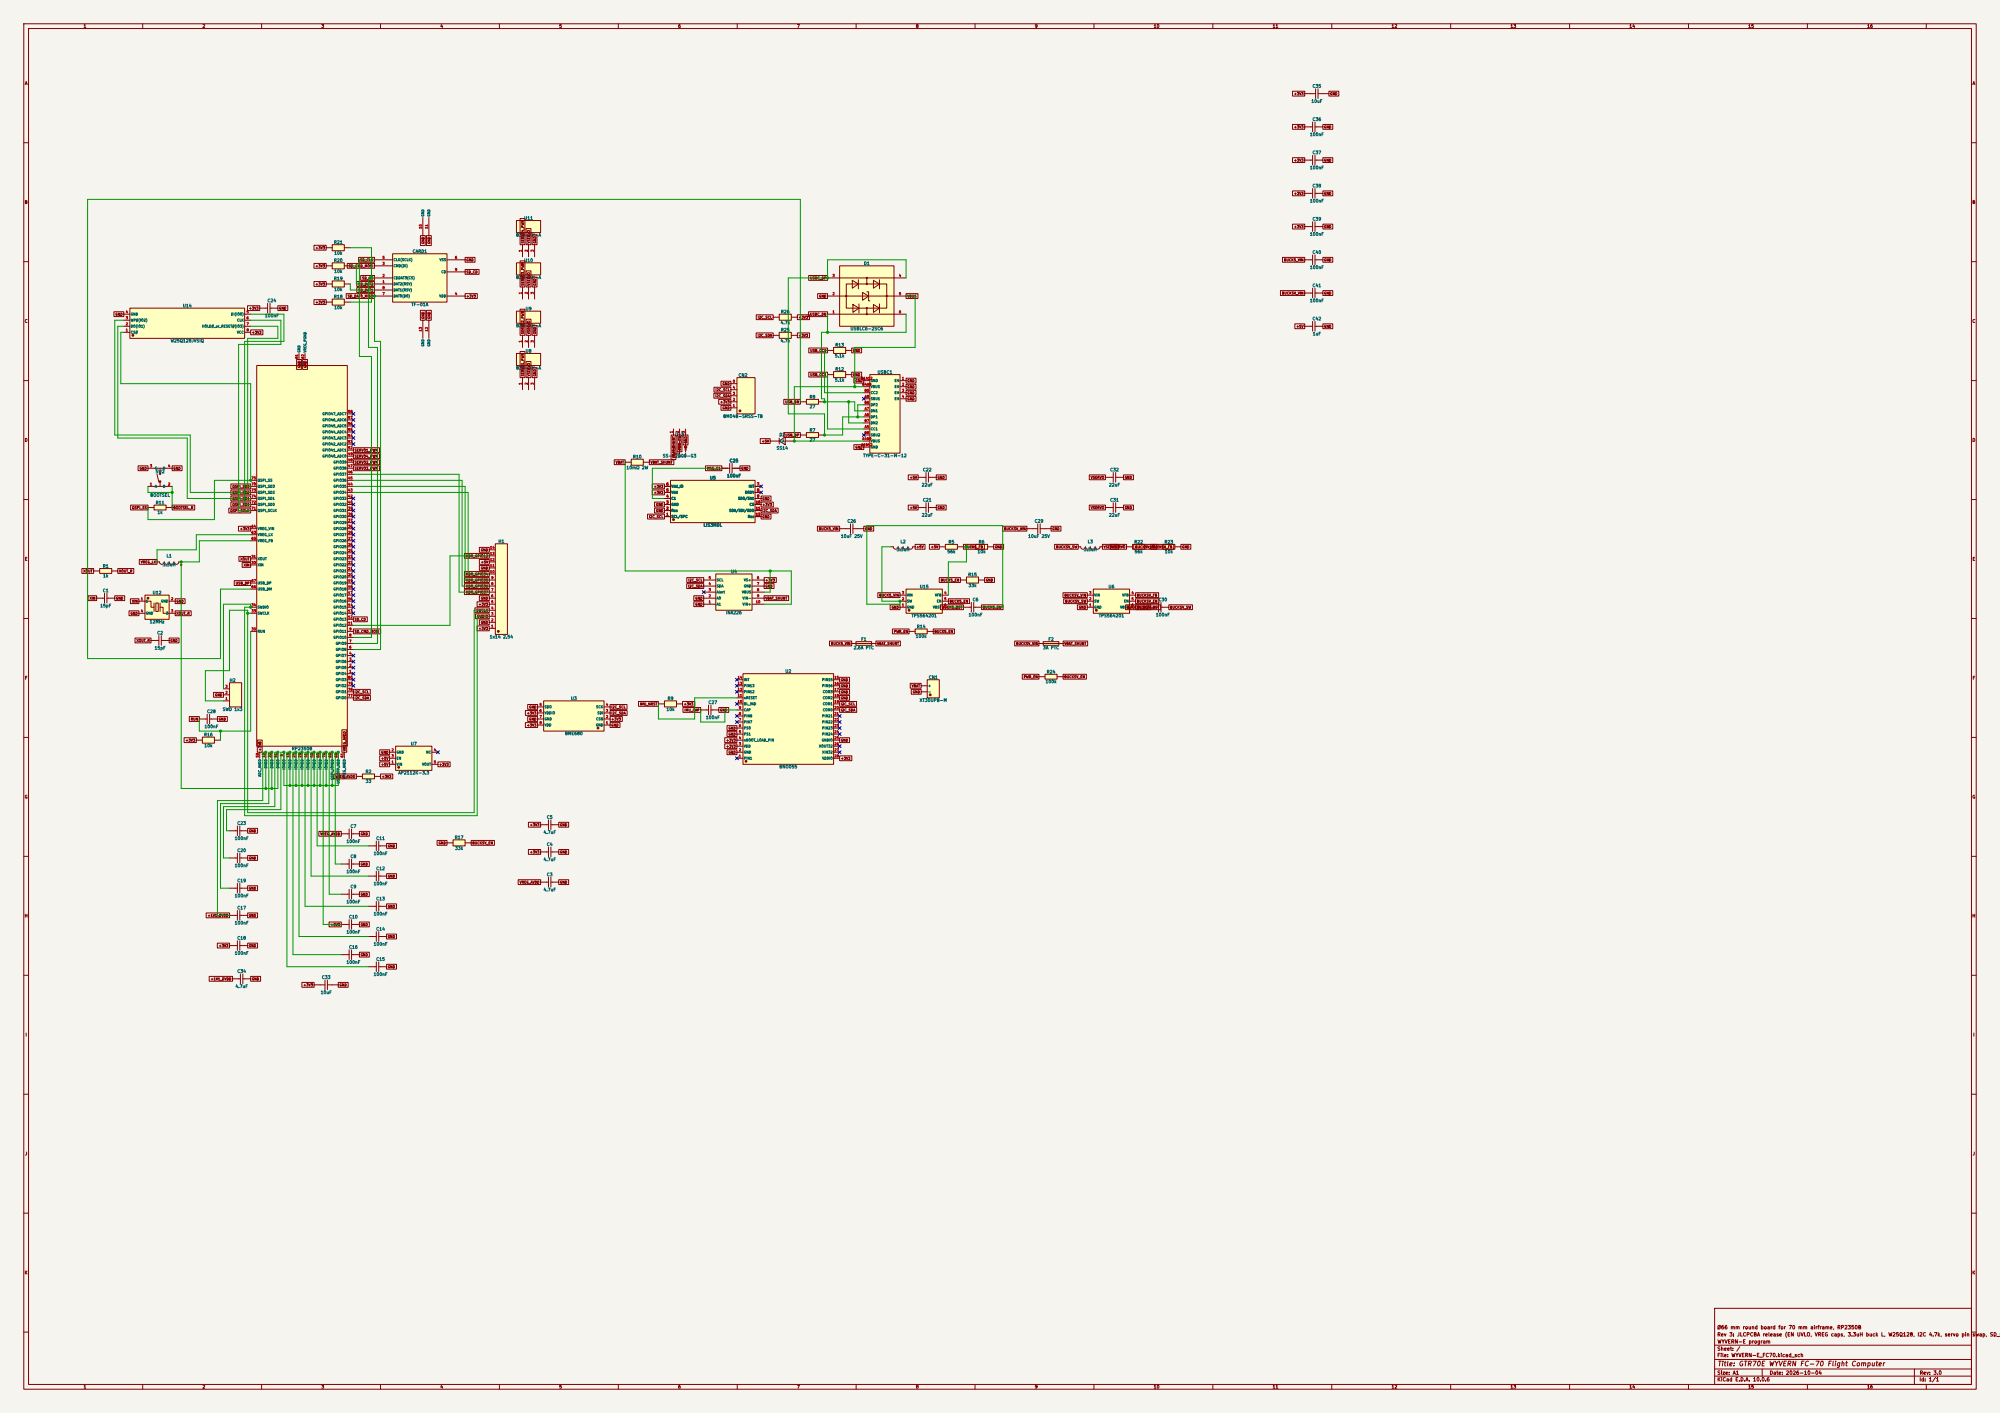
[picture p154: page 1]

SDA/SDI/SDO 11 Res 12 C25

SDA/SDI/SDO 11 Res 12 U5

5 GPIO8 6 GPIO9 7 GPIO10 8 GPIO11 9 DVDD 10 GPIO12 11 GPIO13 12 GPIO14 13 GPIO15 14 IOVDD 15 GPIO16 16 GPIO17 17 GPIO18 18 GPIO19 19 GPIO20 20 GPIO21 21 GPIO22 22 GPIO23 23 IOVDD 24 GPIO24 25 GPIO25 26 GPIO26 27 GPIO27 28 IOVDD 29

Ø66 mm round board for 70 mm airframe, RP2350B
WYVERN-E program
Sheet: /
File: WYVERN-E_FC70.kicad_sch
Title: GTR70E WYVERN FC-70 Flight Computer

Size: A1 | Rev: 3.0
KiCad E.D.A. 10.0.6 | Id: 1/1
