swaroopsahoo4908/GTR70E-WYVERN/Past Iterations/WYVERN-E KiCad/FC100/WYVERN-E_FC100_layers.pdf

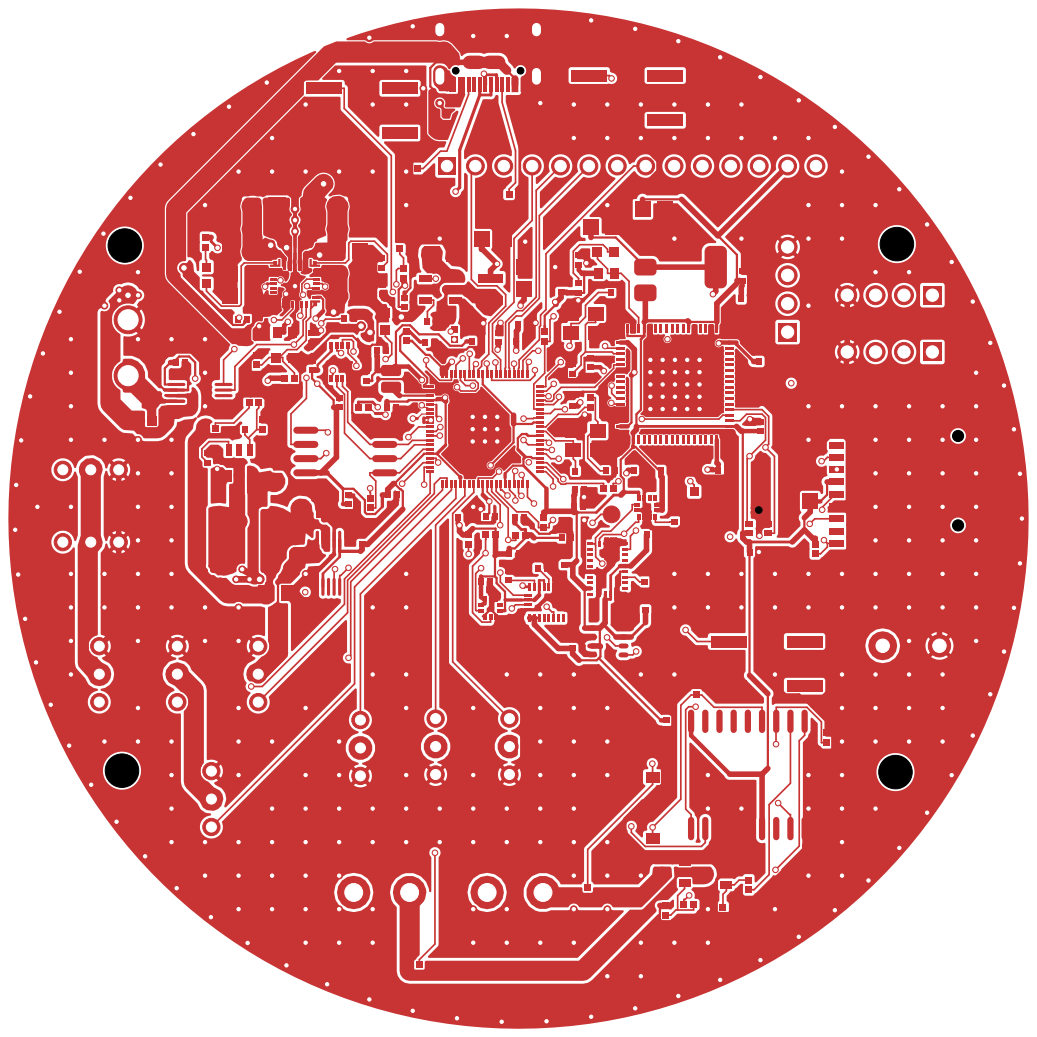
[picture p155: page 1]

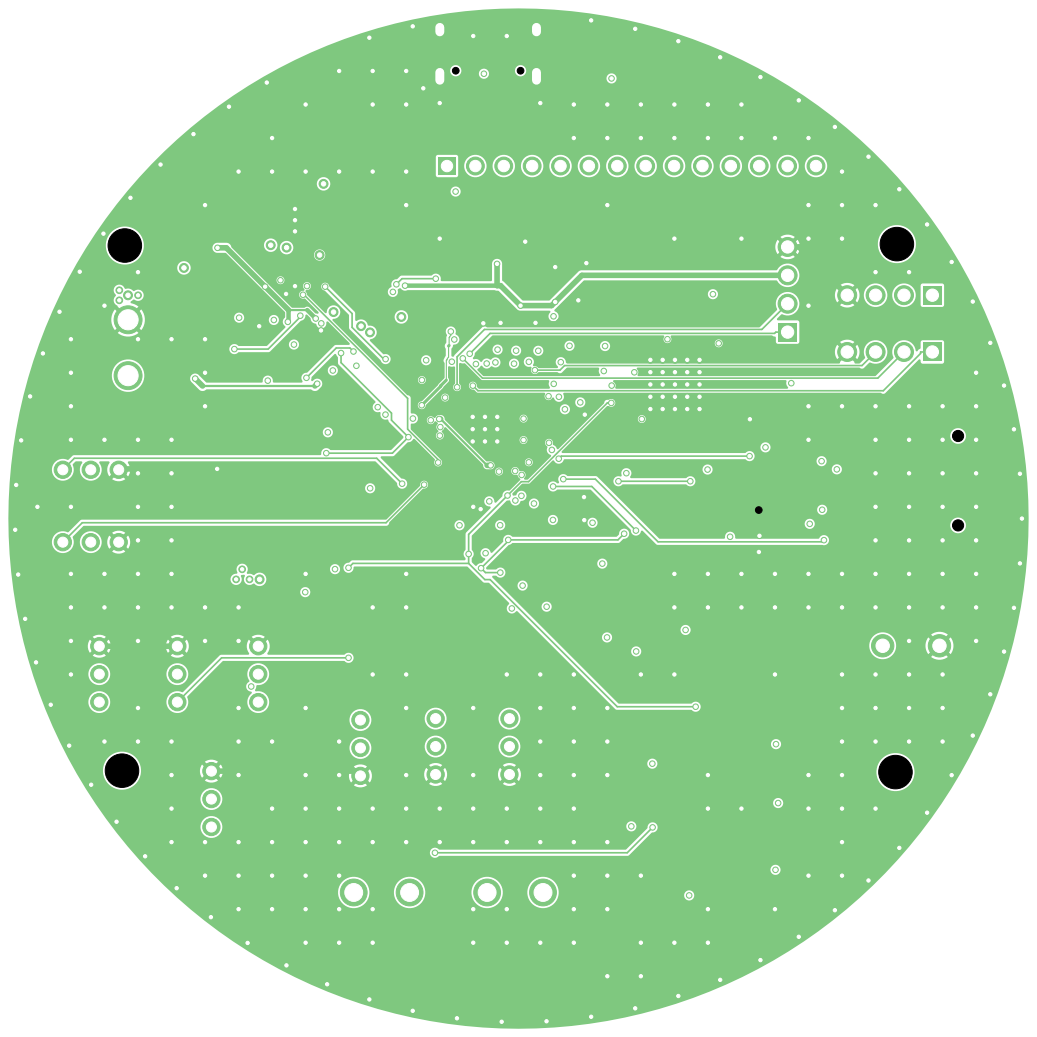
[picture p156: page 2]

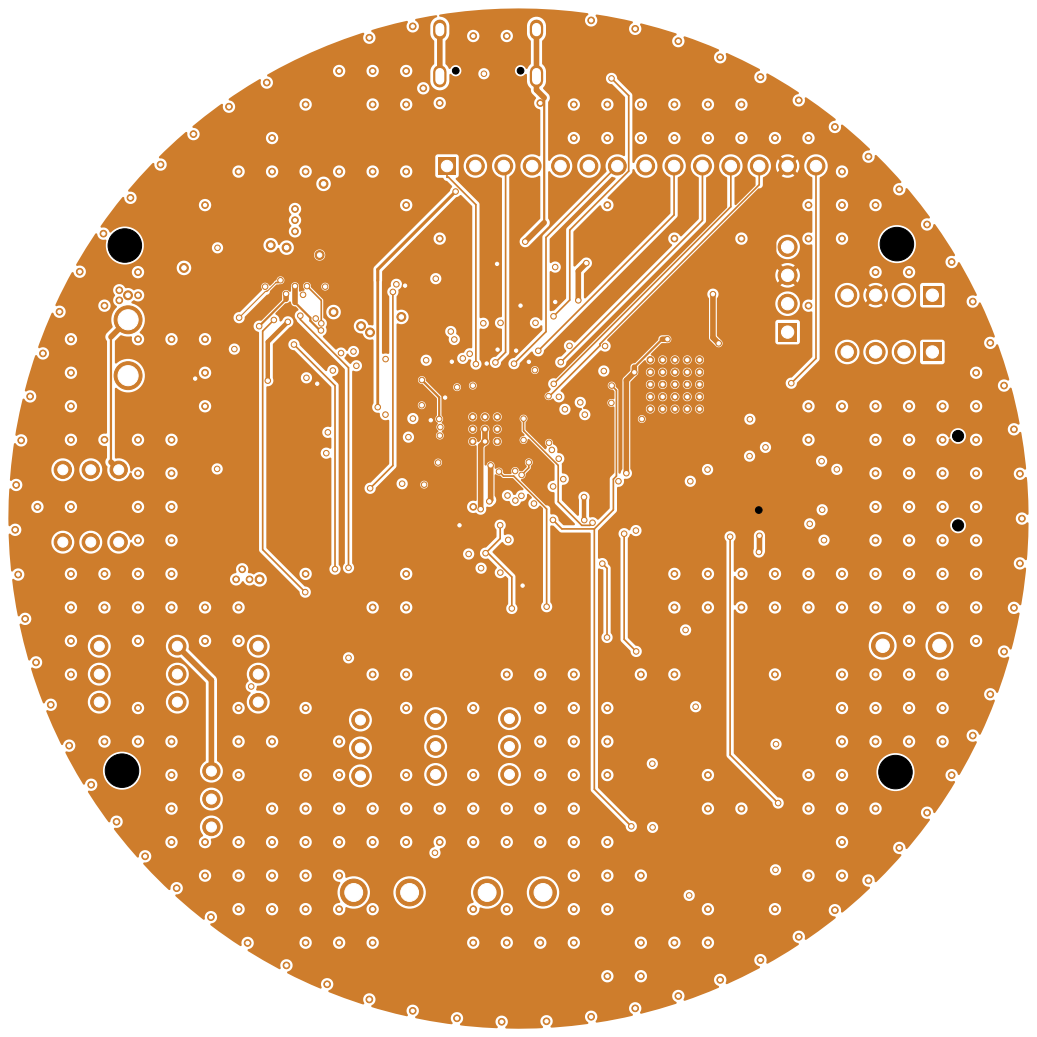
[picture p157: page 3]

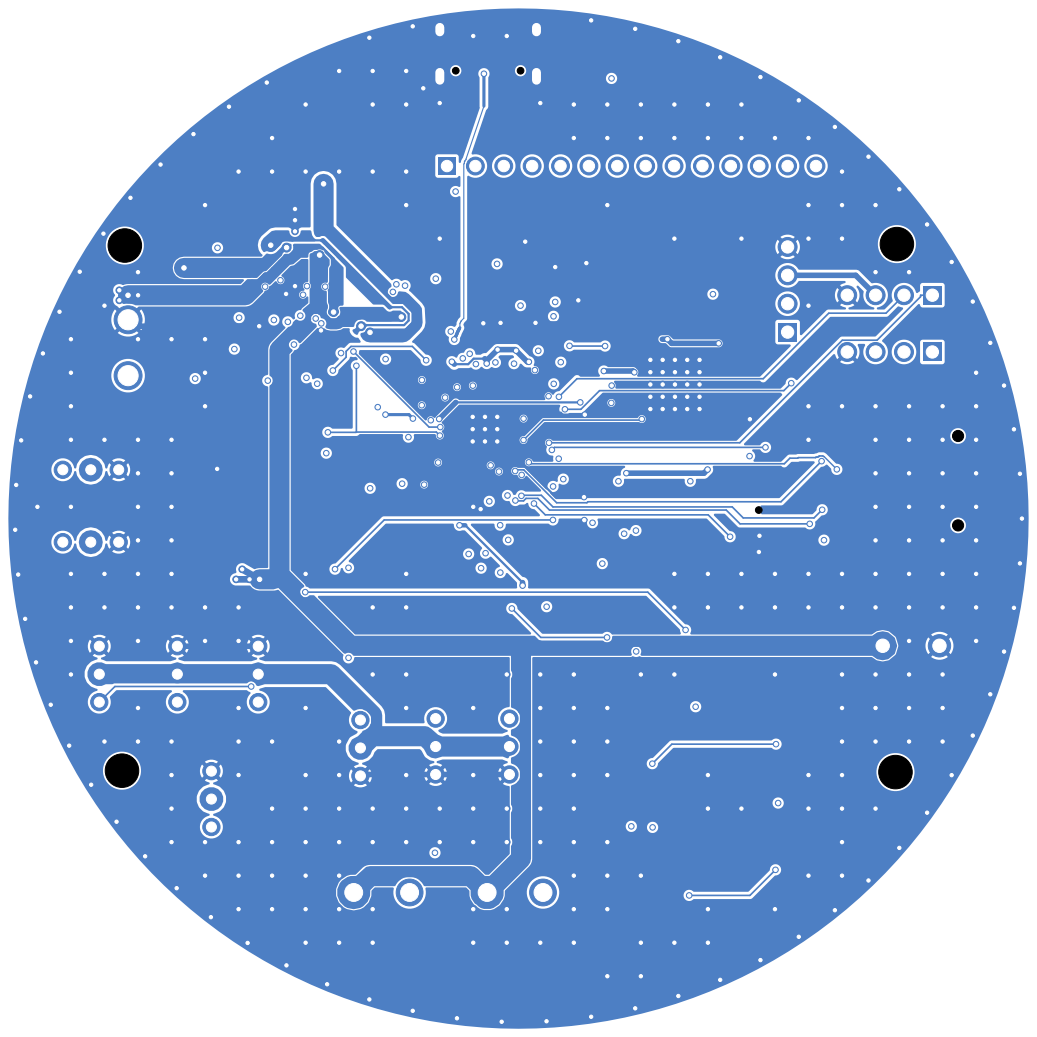
[picture p158: page 4]

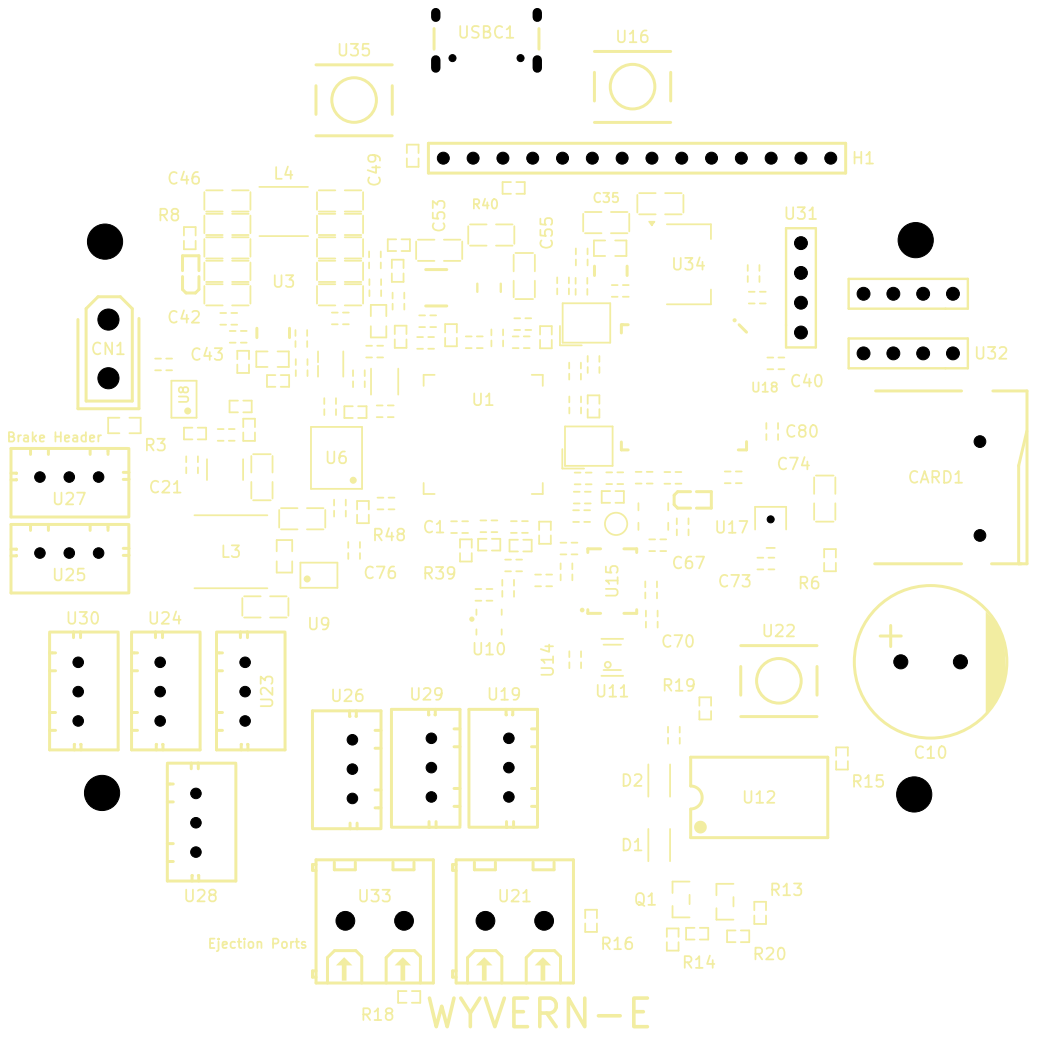
[picture p159: page 5]

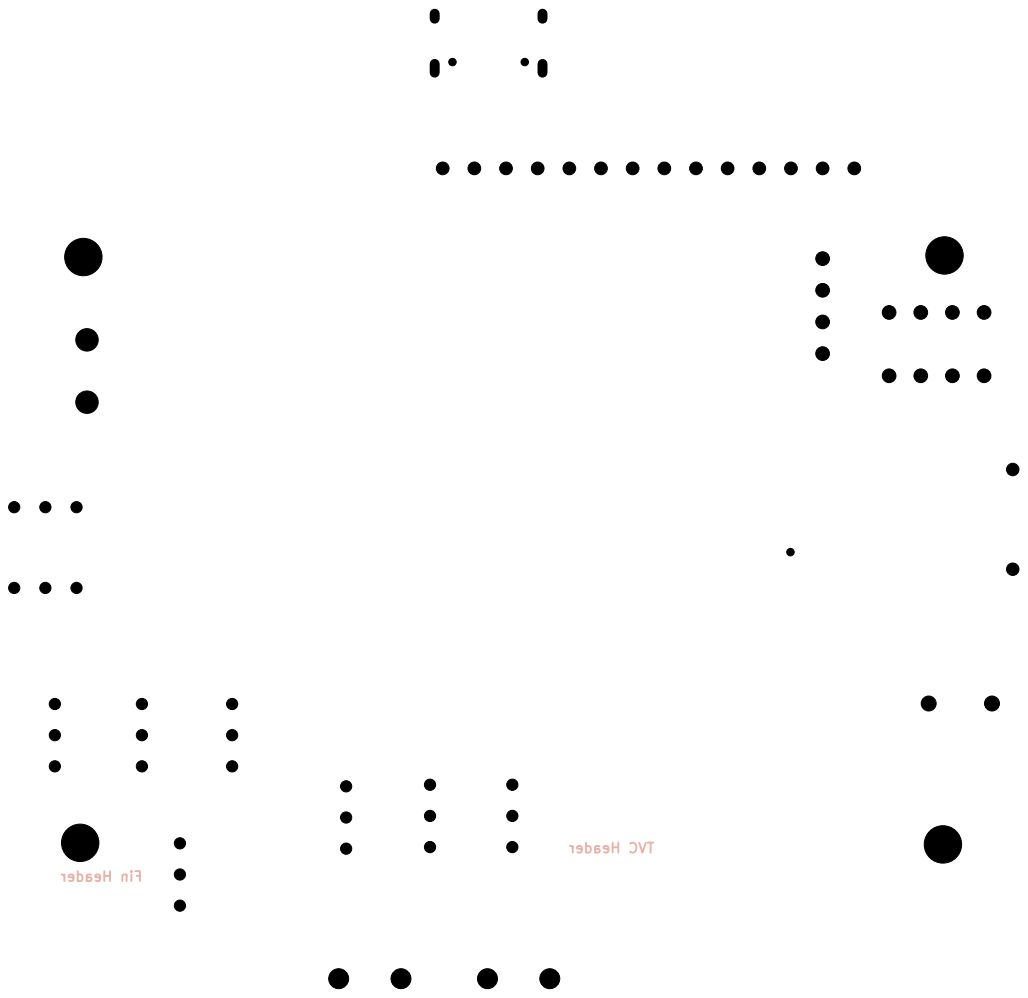
[picture p160: page 6]

Header Fin Header TVC

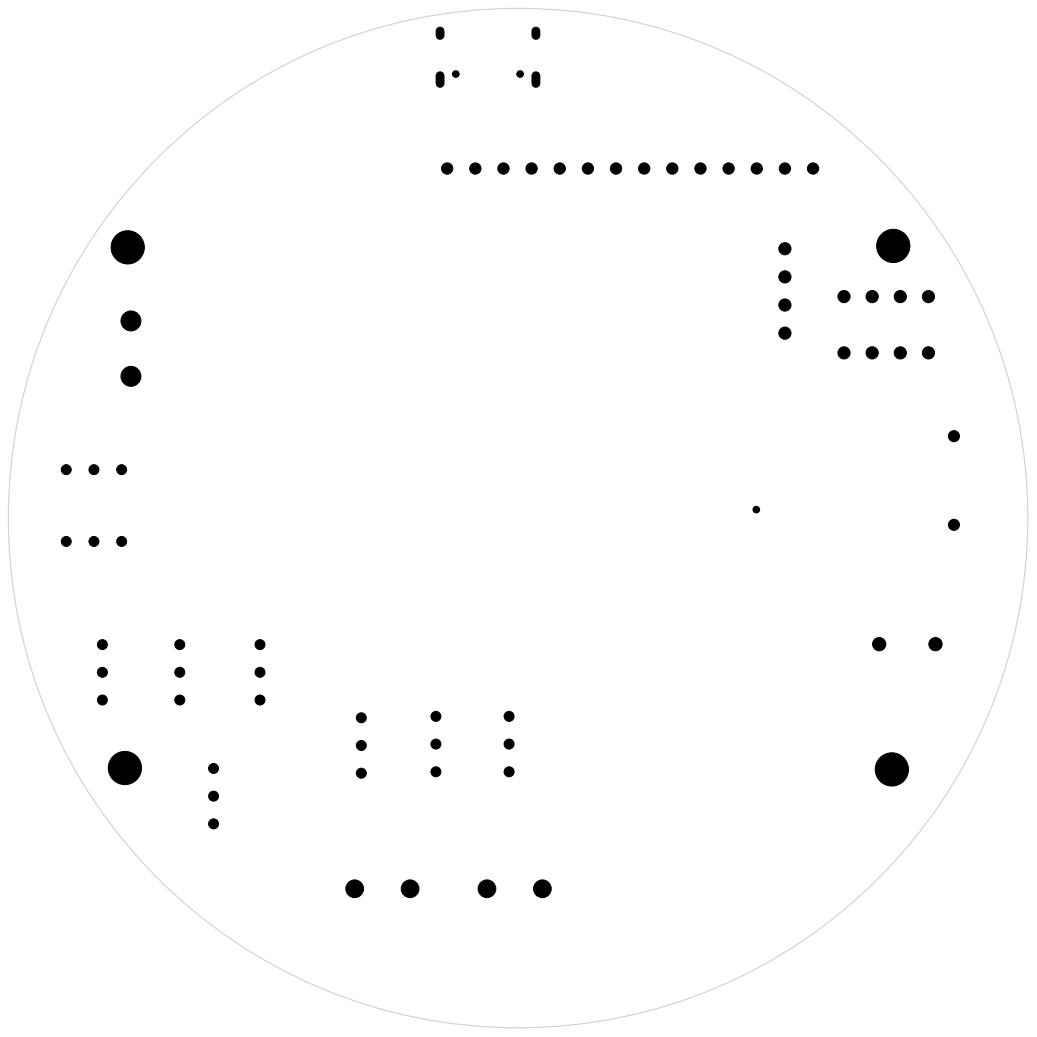
[picture p161: page 7]
