swaroopsahoo4908/GTR70E-WYVERN/TVC ARCHIVED/Past Iterations/WYVERN-E-Old PCB/SCH_Schematic1_2026-08-09.pdf

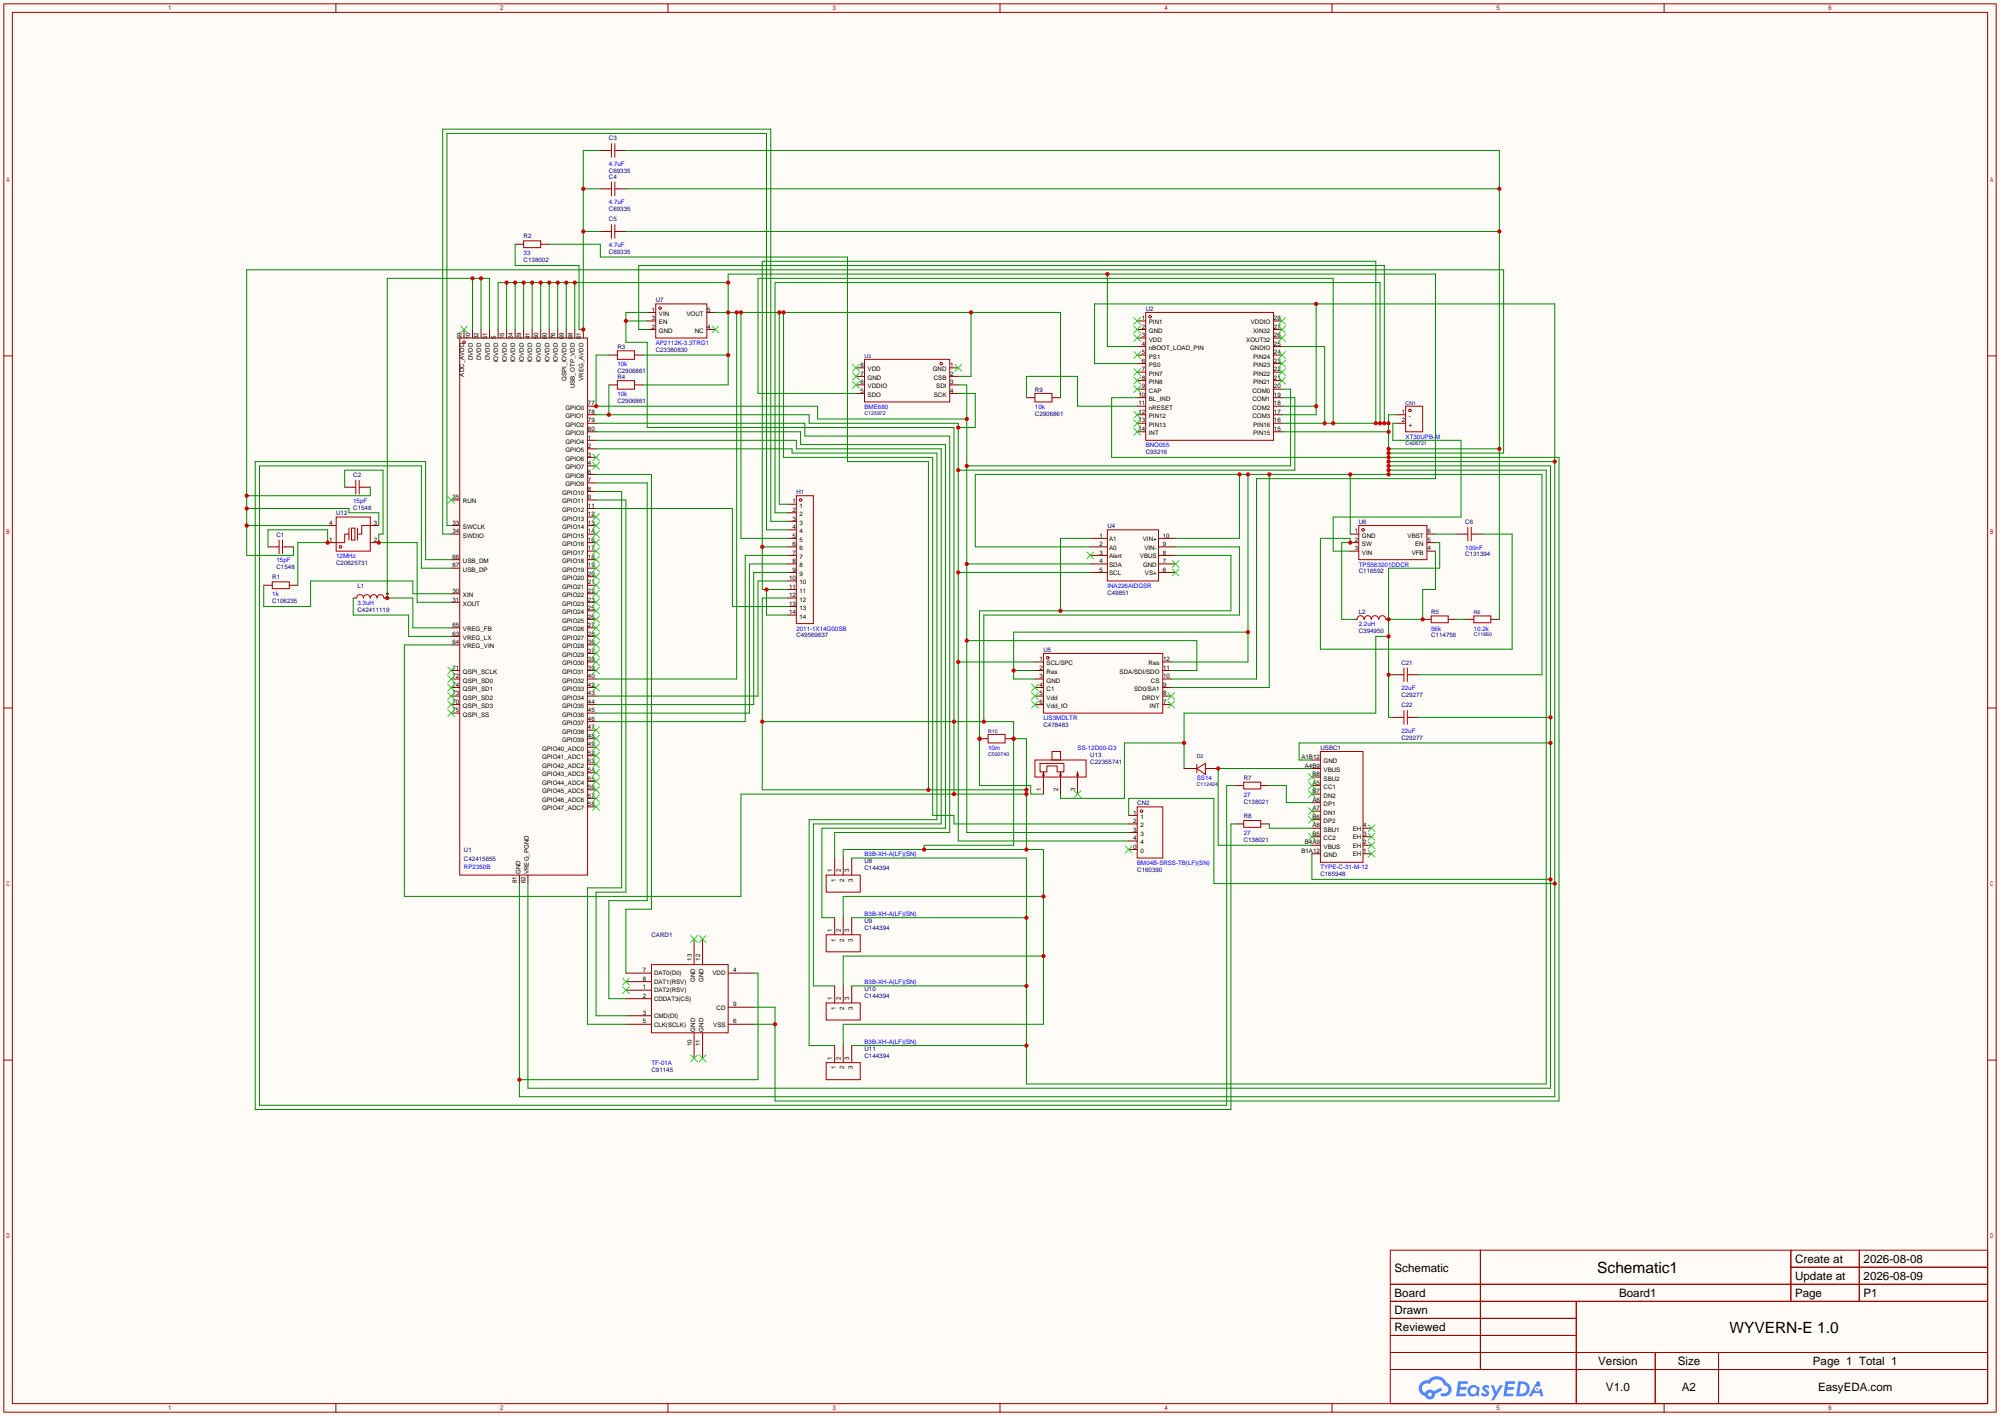
[picture p162: page 1]

CS 10 SDA/SDI/SDO 11 Res 12

Schematic | Schematic1 | Create at | 2026-08-08

Update at | 2026-08-09

Board | Board1 | Page | P1
Drawn | | WYVERN-E 1.0
Reviewed

Version | Size | Page 1 Total 1
V1.0 | A2 | EasyEDA.com
