swaroopsahoo4908/GTR70E-WYVERN/TVC ARCHIVED/Past Iterations/WYVERN-E KiCad/FC100/WYVERN-E_FC100_schematic.pdf

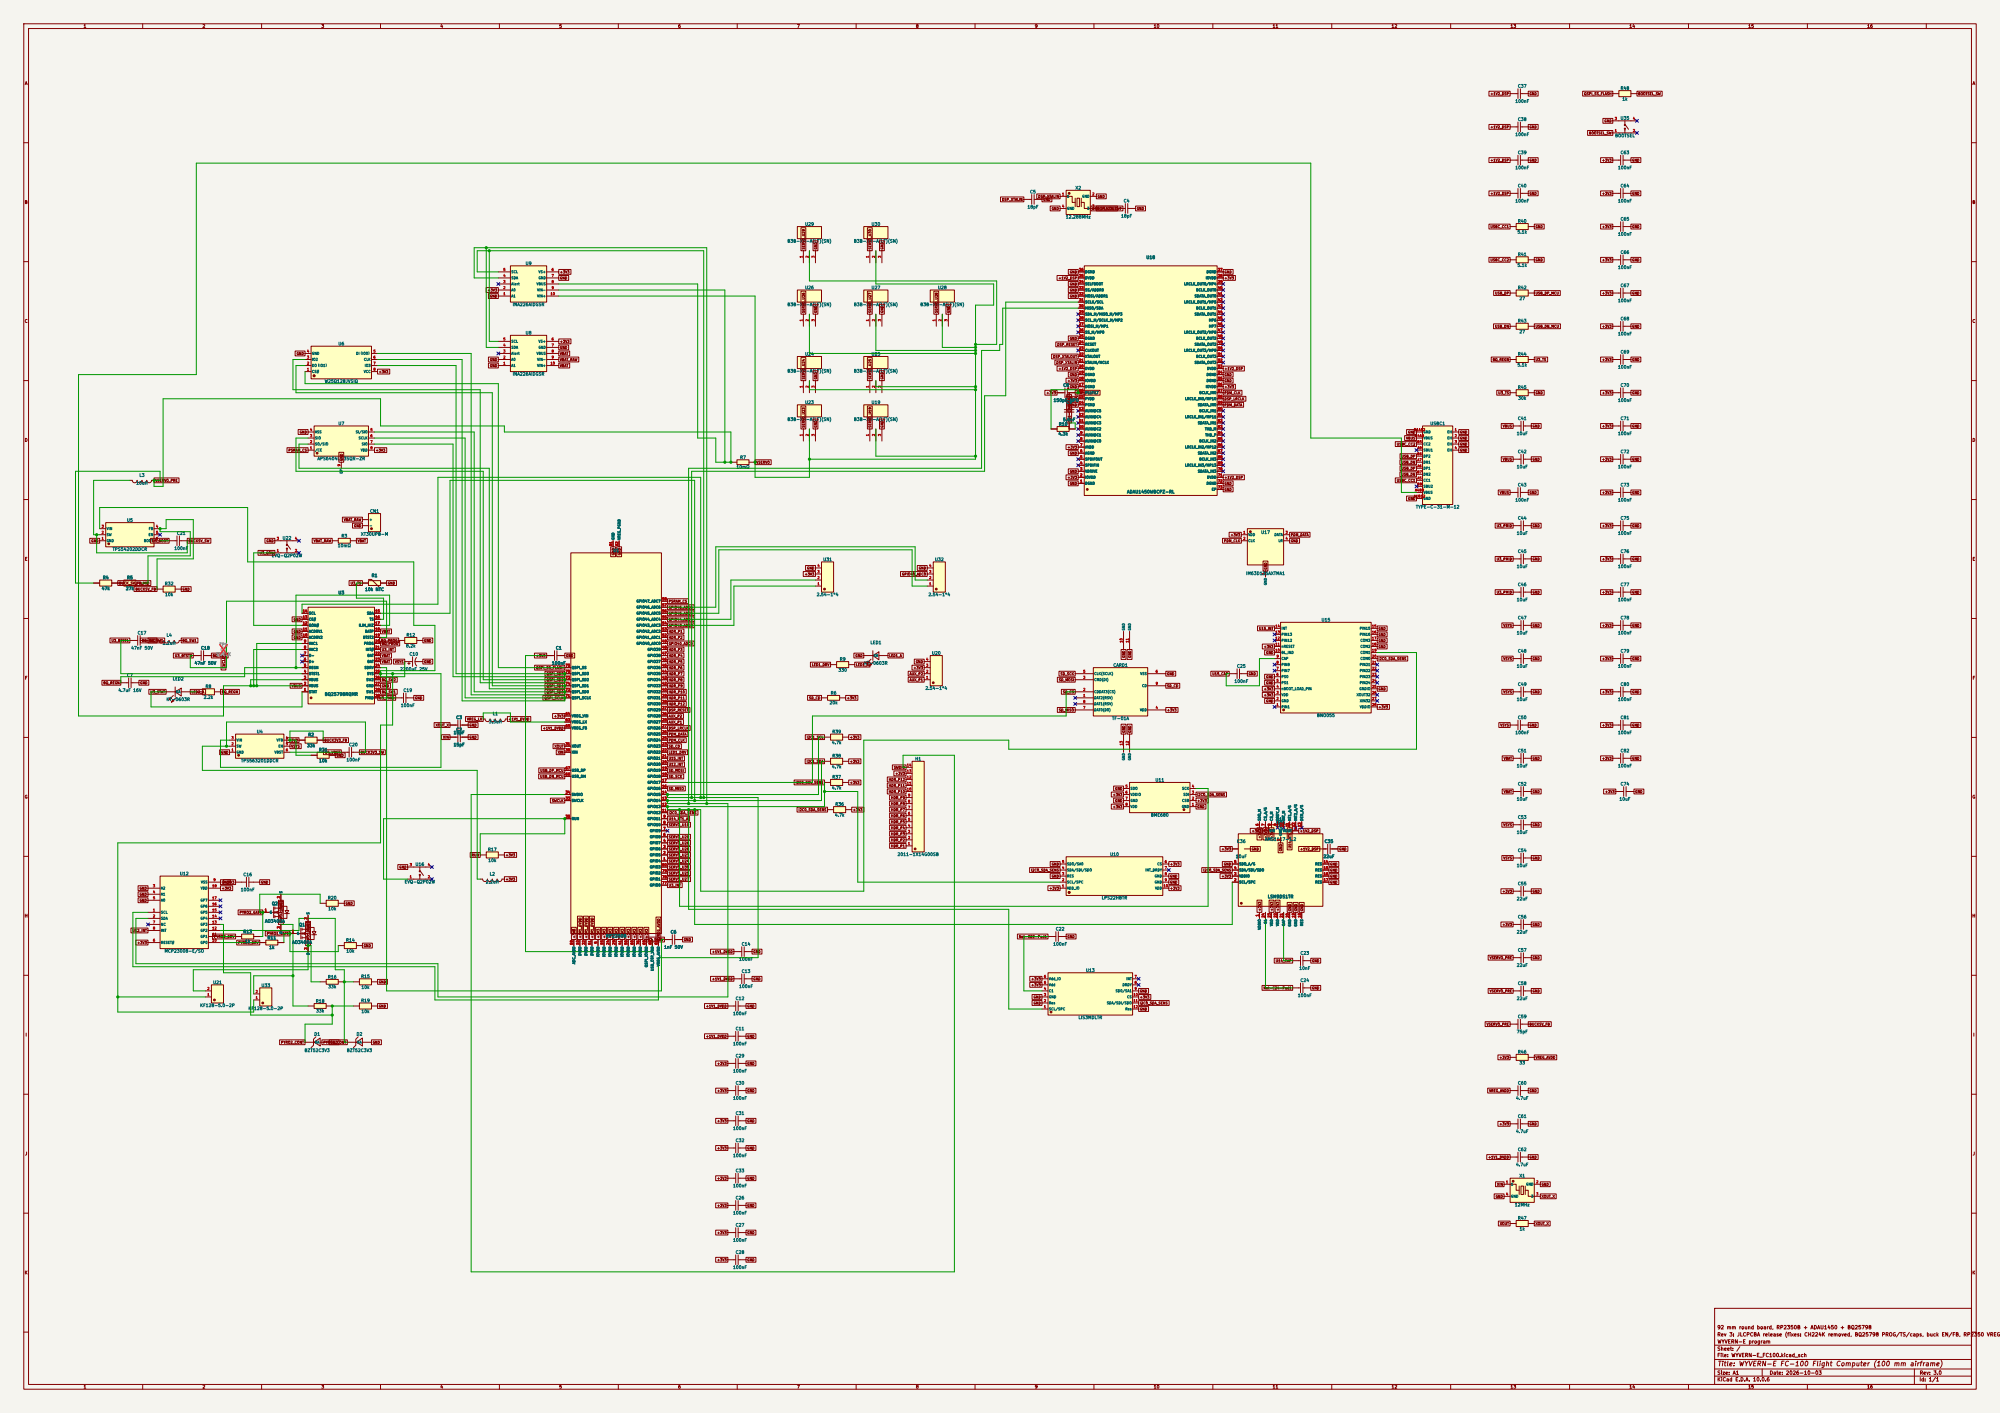
[picture p163: page 1]

GPIO46_ADC6 HDR_P2

AUX_P1 U15_INT HDR_P10 HDR_P1 HDR_P3 PDM_CLK LED1_DRV U12_INT SD_SCK | LED1_DRV QSPI_SS_FLASH

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

17 RES 18 GND 19 GND 20 CAP 21 VDD 22 VDD 23 C1 24

92 mm round board, RP2350B + ADAU1450 + BQ25798
Rev 3: JLCPCBA release (fixes: CH224K removed, BQ25798 PROG/TS/caps, buck EN/FB, RP2350 VREG/USB/XOSC/PSRAM CS, LEDs, INA226 addr)
WYVERN-E program
Sheet: /
File: WYVERN-E_FC100.kicad_sch
Title: WYVERN-E FC-100 Flight Computer (100 mm airframe)

Size: A1 | Rev: 3.0
KiCad E.D.A. 10.0.6 | Id: 1/1
