swaroopsahoo4908/GTR70E-WYVERN/TVC ARCHIVED/Past Iterations/WYVERN-E-Old PCB/3D_PCB1_2026-08-08/SCH_Schematic1_2026-08-08.pdf

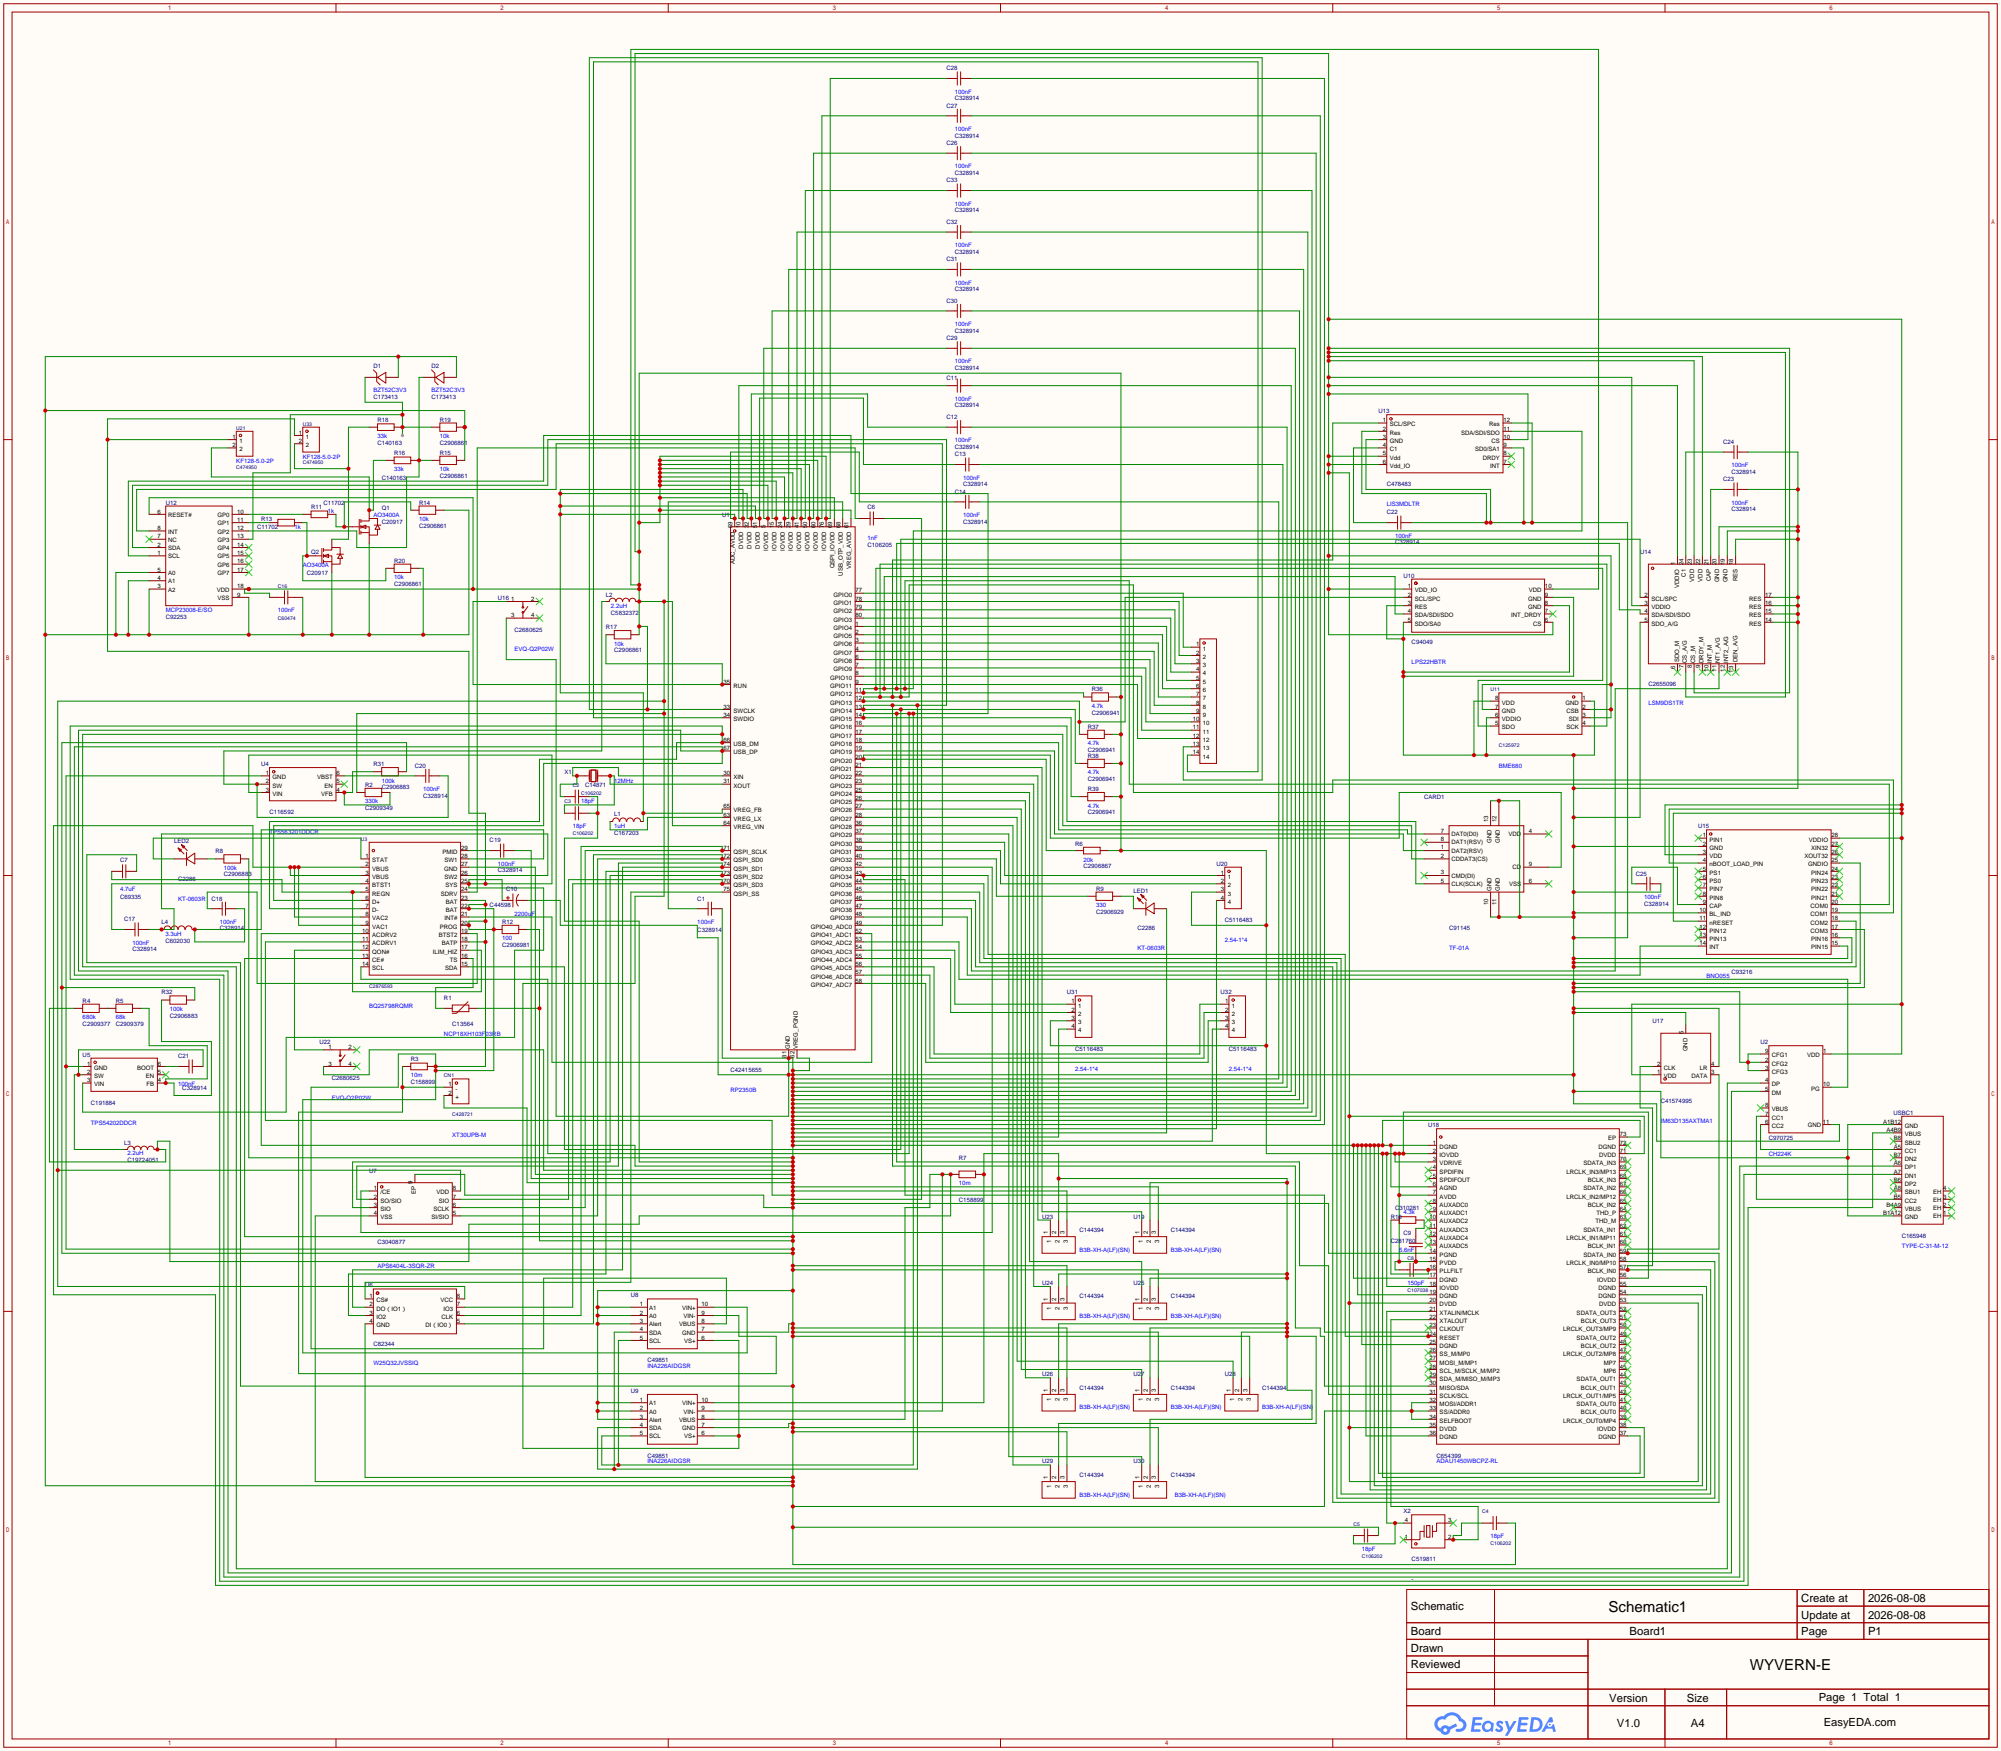
[picture p164: page 1]

TPS563201DDCR

Schematic | Schematic1 | Create at | 2026-08-08

Update at | 2026-08-08

Board | Board1 | Page | P1
Drawn | | WYVERN-E
Reviewed

Version | Size | Page 1 Total 1
V1.0 | A4 | EasyEDA.com
