swaroopsahoo4908/GTR70E-WYVERN/TVC ARCHIVED/Past Iterations/WYVERN-E 1.0/CAD:Models:PCB/XRIM117_PCB_Layouts_html.pdf

# XRIM-117 WYVERN 70mm PTD PDR-002 Rev A

PCB Layout Diagrams — CCM · ASAM-1 · ASAM-2 | Skylight Industries LLC | 62mm Circular, 2-Layer FR4, ENIG

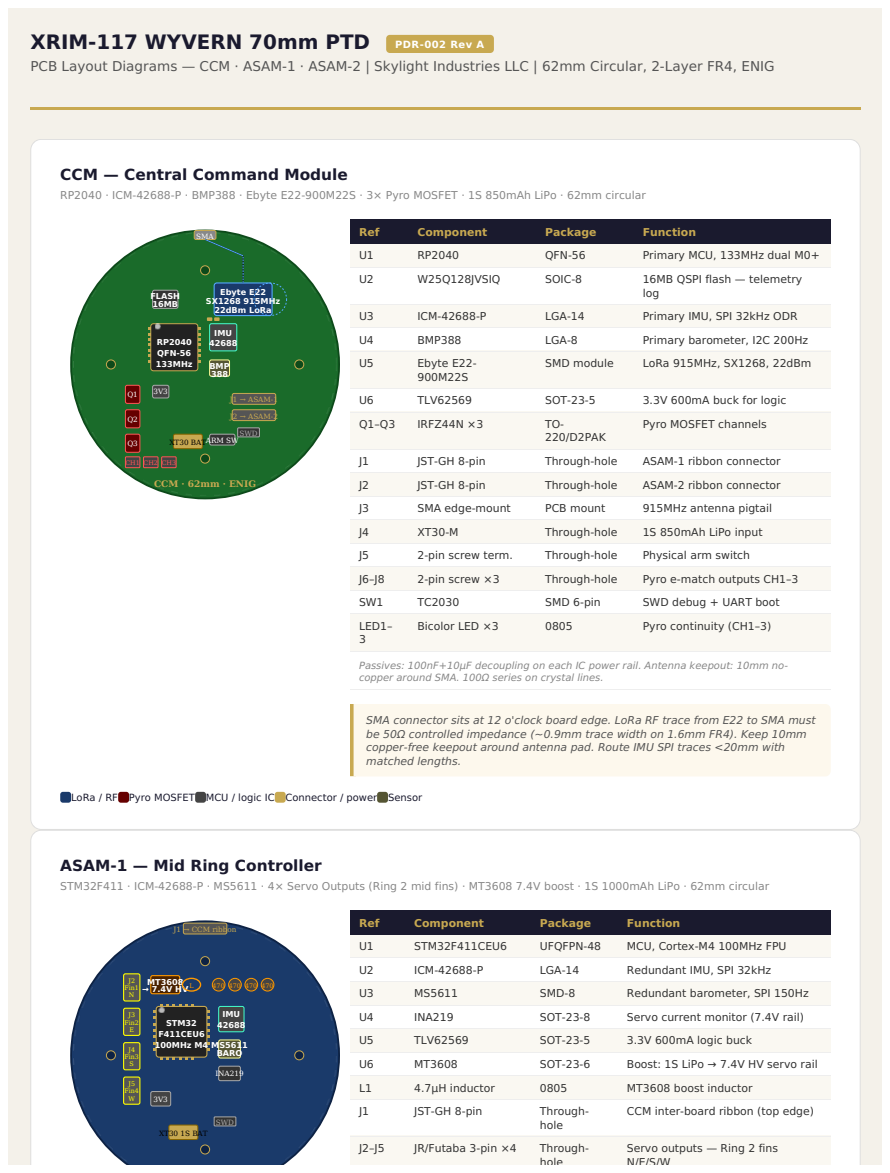
[picture p165: page 1]

CCM — Central Command Module
RP2040 · ICM-42688-P · BMP388 · Ebyte E22-900M22S · 3× Pyro MOSFET · 1S 850mAh LiPo · 62mm circular

Ref | Component | Package | Function
U1 | RP2040 | QFN-56 | Primary MCU, 133MHz dual M0+

Passives: 100nF+10μF decoupling on each IC power rail. Antenna keepout: 10mm no-
copper around SMA. 100Ω series on crystal lines.

SMA connector sits at 12 o'clock board edge. LoRa RF trace from E22 to SMA must
be 50Ω controlled impedance (~0.9mm trace width on 1.6mm FR4). Keep 10mm
copper-free keepout around antenna pad. Route IMU SPI traces <20mm with matched lengths.

LoRa / RF Pyro MOSFET MCU / logic IC Connector / power Sensor

ASAM-1 — Mid Ring Controller
STM32F411 · ICM-42688-P · MS5611 · 4× Servo Outputs (Ring 2 mid fins) · MT3608 7.4V boost · 1S 1000mAh LiPo · 62mm circular

U1 | STM32F411CEU6 | UFQFPN-48 | MCU, Cortex-M4 100MHz FPU

CCM inter-board ribbon (top edge)

Servo outputs — Ring 2 fins

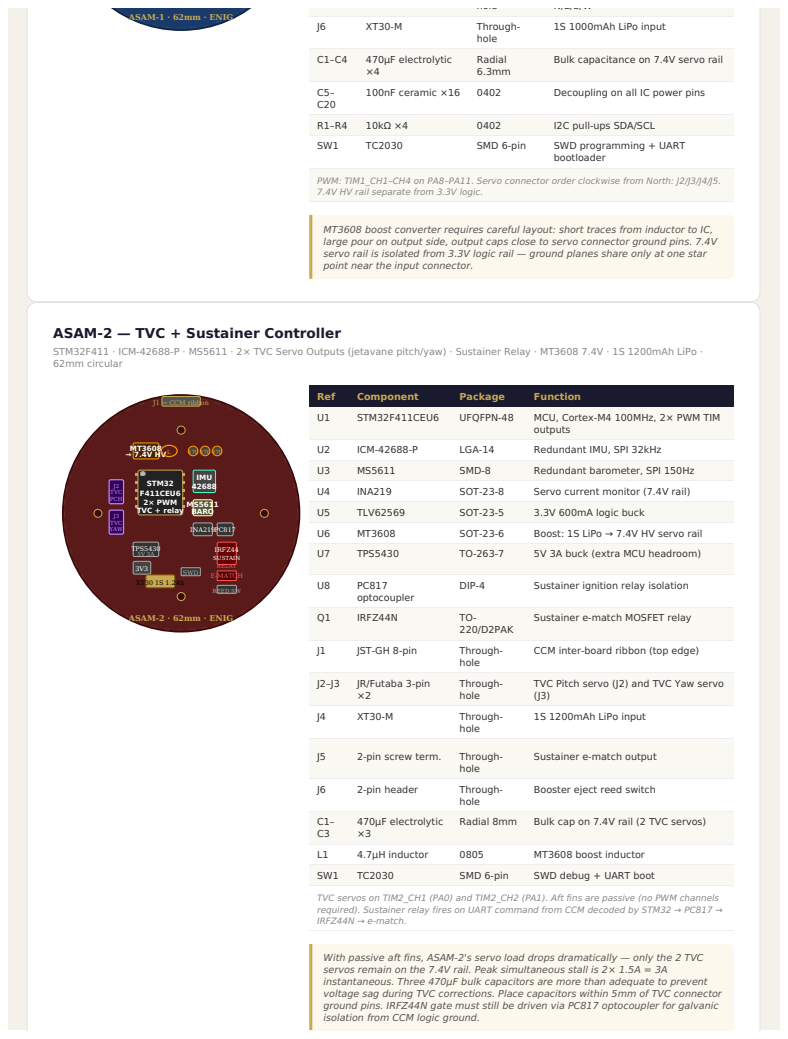
[picture p166: page 2]

Bulk capacitance on 7.4V servo rail

PWM: TIM1_CH1–CH4 on PA8–PA11. Servo connector order clockwise from North: J2/J3/J4/J5.
7.4V HV rail separate from 3.3V logic.

MT3608 boost converter requires careful layout: short traces from inductor to IC,
large pour on output side, output caps close to servo connector ground pins. 7.4V
servo rail is isolated from 3.3V logic rail — ground planes share only at one star
point near the input connector.

ASAM-2 — TVC + Sustainer Controller
STM32F411 · ICM-42688-P · MS5611 · 2× TVC Servo Outputs (jetavane pitch/yaw) · Sustainer Relay · MT3608 7.4V · 1S 1200mAh LiPo ·
62mm circular

Ref | Component | Package | Function
U1 | STM32F411CEU6 | UFQFPN-48 | MCU, Cortex-M4 100MHz, 2× PWM TIM outputs

Sustainer e-match MOSFET relay

CCM inter-board ribbon (top edge)

TVC Pitch servo (J2) and TVC Yaw servo
1S 1200mAh LiPo input

Booster eject reed switch

TVC servos on TIM2_CH1 (PA0) and TIM2_CH2 (PA1). Aft fins are passive (no PWM channels
required). Sustainer relay fires on UART command from CCM decoded by STM32 → PC817 →
IRFZ44N → e-match.

With passive aft fins, ASAM-2's servo load drops dramatically — only the 2 TVC
servos remain on the 7.4V rail. Peak simultaneous stall is 2× 1.5A = 3A
instantaneous. Three 470μF bulk capacitors are more than adequate to prevent
voltage sag during TVC corrections. Place capacitors within 5mm of TVC connector
ground pins. IRFZ44N gate must still be driven via PC817 optocoupler for galvanic
isolation from CCM logic ground.

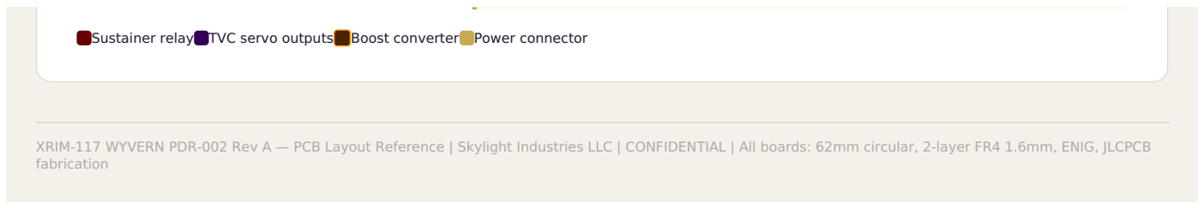
[picture p167: figure]
fabrication

Sustainer relay TVC servo outputs Boost converter Power connector

XRIM-117 WYVERN PDR-002 Rev A — PCB Layout Reference | Skylight Industries LLC | CONFIDENTIAL | All boards: 62mm circular, 2-layer FR4 1.6mm, ENIG, JLCPCB
