swaroopsahoo4908/GTR70E-WYVERN/TVC ARCHIVED/Past Iterations/WYVERN-E-Old PCB/PCB_PCB1_2026-08-08.pdf

C13 C12 C14 | C¹⁷ C¹⁸ | C¹⁹ | C²⁰

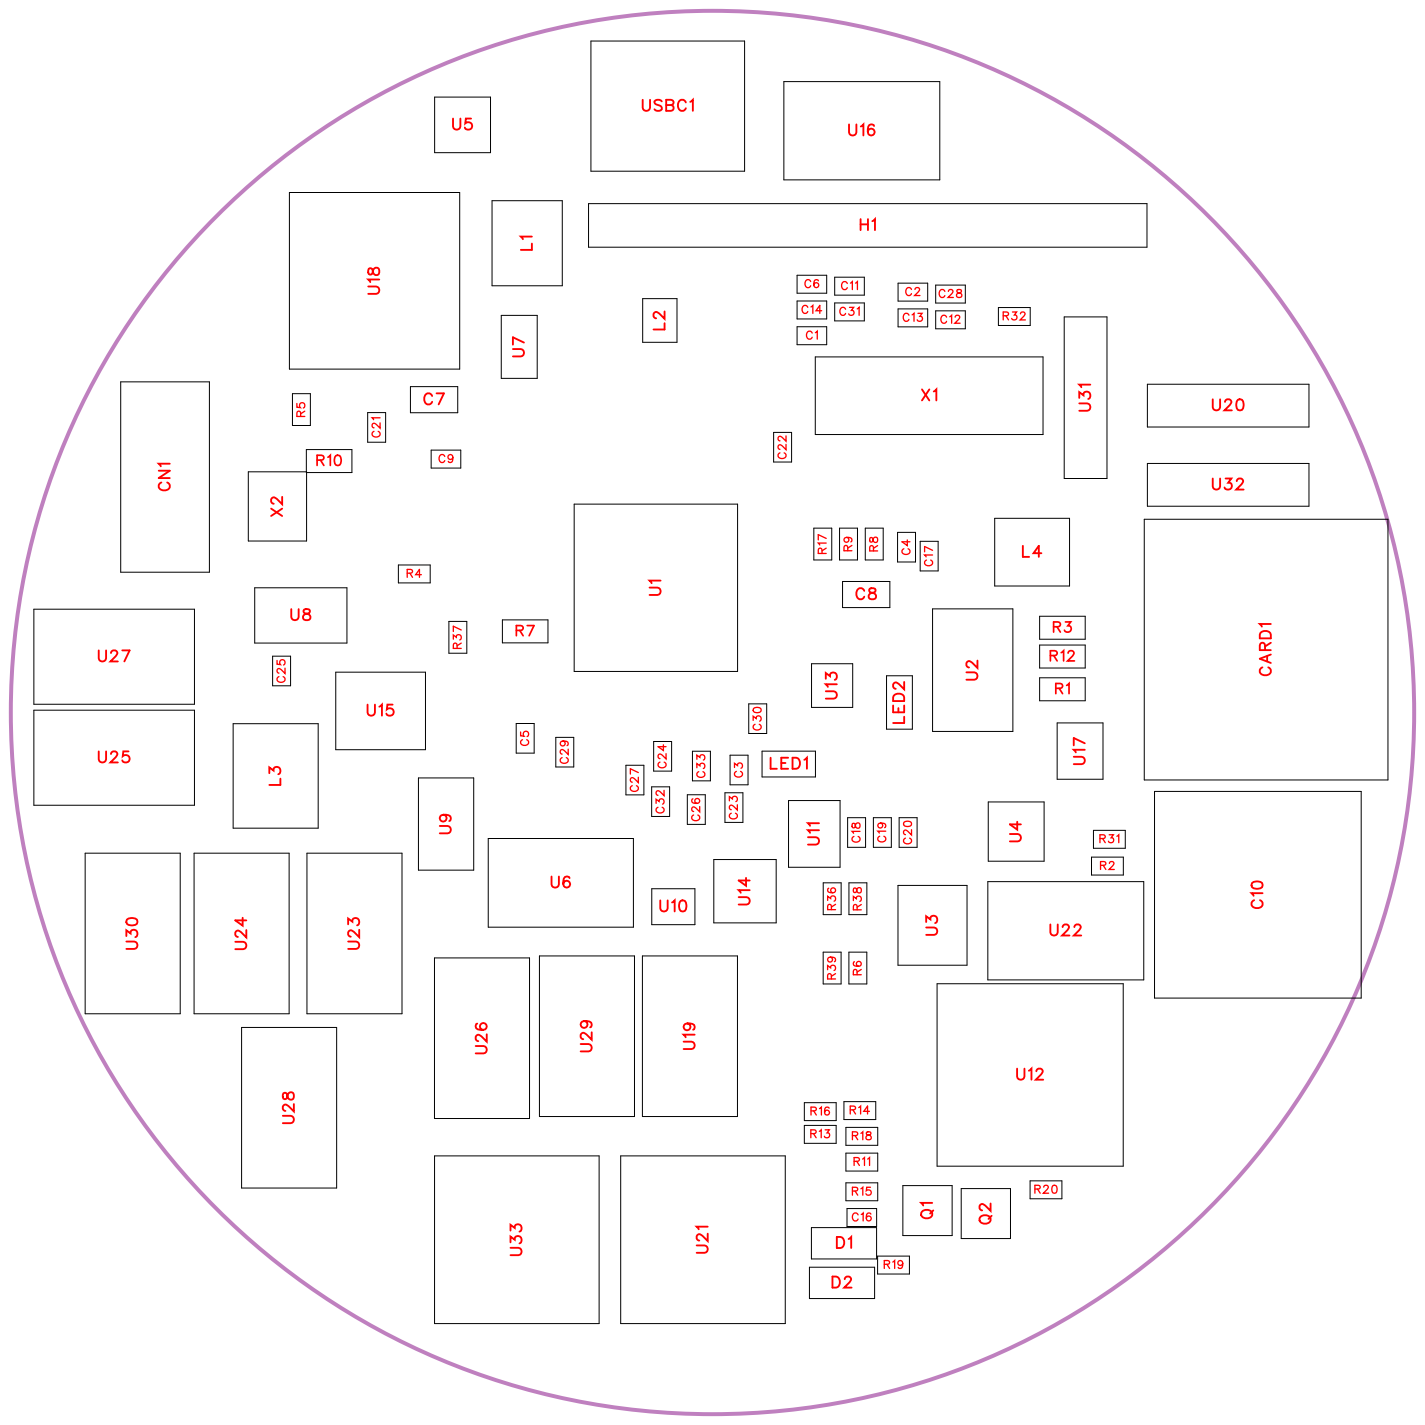
[picture p168: page 1]

No. | Quantity | Comment | Designator | Footprint | Value | Manufacturer Part | Manufacturer | Supplier Part | Supplier
1 | 22 | 100nF | C1,C11,C12,C13,C14,C17, C18,C19,C20,C21,C22,C23 ,C24,C25,C26,C27,C28,C2 9,C30,C31,C32,C33 | C0402 | 100nF | FN15X104K1 60PNG | PSA(信昌电 陶) | C328914 | LCSC
2 | 4 | 18pF | C2,C3,C4,C5 | C0402 | 18pF | CC0402JRN PO9BN180 | YAGEO(国巨 ) | C106202 | LCSC
3 | 1 | 1nF | C6 | C0402 | 1nF | CC0402KRX 7R9BB102 | YAGEO(国巨 ) | C106205 | LCSC
4 | 1 | 4.7uF | C7 | C0603 | 4.7uF | CL10A475KA 8NQNC | SAMSUNG( 三星) | C69335 | LCSC
5 | 1 | 150pF | C8 | C0603 | 150pF | CC0603JRN PO9BN151 | YAGEO(国巨 ) | C107038 | LCSC
6 | 1 | 5.6nF | C9 | C0402 | 5.6nF | CC0402KRX 7R9BB562 | YAGEO(国巨 ) | C281760 | LCSC
7 | 1 | 2200uF | C10 | CAP-TH_BD 13.0-P5.00-D 1.2-FD | 2200uF | KM228M025 J20RR0VH2 FP0 | Chengx(承兴 ) | C44598 | LCSC
8 | 1 | 100nF | C16 | C0402 | 100nF | CC0402KRX 7R7BB104 | YAGEO(国巨 ) | C60474 | LCSC
9 | 1 | TF-01A | CARD1 | TF-SMD_TF-01A | | TF-01A | 韩国韩荣 | C91145 | LCSC
10 | 1 | XT30UPB-M | CN1 | CONN-TH_X T30UPB-M | | XT30UPB-M | AMASS(艾迈 斯) | C428721 | LCSC
11 | 2 | BZT52C3V3 | D1,D2 | SOD-123_L2 .7-W1.6-LS3. 7-RD | | BZT52C3V3 | MDD(辰达半 导体) | C173413 | LCSC
12 | 1 | 2011-1X14G 00SB | H1 | HDR-TH_14 P-P2.54-V-M _4 | | 2011-1X14G 00SB | WingTAT(格 林柏) | C49569637 | LCSC
13 | 1 | 1uH | L1 | IND-SMD_L4 .4-W4.2 | 1uH | FXL0420-1R 0-M | cjiang(长江微 电) | C167203 | LCSC
14 | 1 | 2.2uH | L2 | IND-SMD_L2 .5-W2.0_MH CHL2520 | 2.2uH | FTC252012S 2R2MBCA | cjiang(长江微 电) | C5832372 | LCSC
15 | 1 | 2.2uH | L3 | IND-SMD_L5 .5-W5.2_NB MC0530N | 2.2uH | CY0530AT12 5DS-2R2MC Y | Sumida(胜美 达) | C19724051 | LCSC
16 | 1 | 3.3uH | L4 | IND-SMD_L4 .0-W4.0 | 3.3uH | FHD4020S-3 R3MT | cjiang(长江微 电) | C602030 | LCSC
17 | 2 | KT-0603R | LED1,LED2 | LED-SMD_L 1.6-W0.8-R-RD | | KT-0603R | KENTO | C2286 | LCSC
18 | 2 | AO3400A | Q1,Q2 | SOT-23-3_L2 .9-W1.3-P1.9 0-LS2.4-BR | | AO3400A | AOS | C20917 | LCSC
19 | 1 | NCP18XH10 3F03RB | R1 | R0603 | | NCP18XH10 3F03RB | muRata(村田 ) | C13564 | LCSC

20 | 1 | 330k | R2 | R0402 | 330k | FRC0402F33 03TS | FOJAN(富捷 ) | C2909349 | LCSC
21 | 2 | 10m | R3,R7 | R0603 | 10m | RTT03R010F TP | RALEC(旺诠 ) | C158899 | LCSC
22 | 1 | 680k | R4 | R0402 | 680k | FRC0402F68 03TS | FOJAN(富捷 ) | C2909377 | LCSC
23 | 1 | 68k | R5 | R0402 | 68k | FRC0402F68 02TS | FOJAN(富捷 ) | C2909379 | LCSC
24 | 1 | 20k | R6 | R0402 | 20k | FRC0402F20 02TS | FOJAN(富捷 ) | C2906867 | LCSC
25 | 3 | 100k | R8,R31,R32 | R0402 | 100k | FRC0402J10 4 TS | FOJAN(富捷 ) | C2906883 | LCSC
26 | 1 | 330 | R9 | R0402 | 330 | FRC0402J33 1 TS | FOJAN(富捷 ) | C2906929 | LCSC
27 | 1 | 4.3k | R10 | R0603 | 4.3k | RS-03K4301 FT | FH(风华 ) | C310281 | LCSC
28 | 2 | 1k | R11,R13 | R0402 | 1k | 0402WGF10 01TCE | UNI-ROYAL( 厚声 ) | C11702 | LCSC
29 | 1 | 100 | R12 | R0603 | 100 | FRC0603F10 00TS | FOJAN(富捷 ) | C2906981 | LCSC
30 | 5 | 10k | R14,R15,R17,R19,R20 | R0402 | 10k | FRC0402F10 02TS | FOJAN(富捷 ) | C2906861 | LCSC
31 | 2 | 33k | R16,R18 | R0402 | 33k | RC-02K3302 FT | FH(风华 ) | C140163 | LCSC
32 | 4 | 4.7k | R36,R37,R38,R39 | R0402 | 4.7k | FRC0402J47 2 TS | FOJAN(富捷 ) | C2906941 | LCSC
33 | 1 | RP2350B | U1 | QFN-80_L10. 0-W10.0-P0. 40-TL-EP3.4 | | RP2350B | Raspberry Pi(树莓派 ) | C42415655 | LCSC
34 | 1 | CH224K | U2 | ESSOP-10_L 4.9-W3.9-P1. 0-LS6.0-TL-E P | | CH224K | WCH(南京沁 恒) | C970725 | LCSC
35 | 1 | BQ25798RQ MR | U3 | QFN-29_L4.0 -W4.0-P0.40-TL-BQ25792 RQMR | | BQ25798RQ MR | TI(德州仪器 ) | C2876593 | LCSC
36 | 1 | TPS563201D DCR | U4 | SOT-23-6_L2 .9-W1.6-P0.9 5-LS2.8-BR | | TPS563201D DCR | TI(德州仪器 ) | C116592 | LCSC
37 | 1 | TPS54202D DCR | U5 | SOT-23-6_L2 .9-W1.6-P0.9 5-LS2.8-BL | | TPS54202D DCR | TI(德州仪器 ) | C191884 | LCSC
38 | 1 | W25Q32JVS SIQ | U6 | SOIC-8_L5.3 -W5.3-P1.27-LS8.0-BL | | W25Q32JVS SIQ | Winbond( 华 邦 ) | C82344 | LCSC
39 | 1 | APS6404L-3 SQR-ZR | U7 | USON-8_L3. 0-W2.0-P0.5 0-BL-EP | | APS6404L-3 SQR-ZR | Apmemory | C3040877 | LCSC

40 | 2 | INA226AIDG SR | U8,U9 | MSOP-10_L3 .0-W3.0-P0.5 0-LS5.0-BL | | INA226AIDG SR | TI(德州仪器 ) | C49851 | LCSC
41 | 1 | LPS22HBTR | U10 | HLGA-10L_L PS22HBTR | | LPS22HBTR | ST(意法半导 体) | C94049 | LCSC
42 | 1 | BME680 | U11 | LGA-8_L3.0-W3.0-P0.80-TR | | BME680 | Bosch(博世 ) | C125972 | LCSC
43 | 1 | MCP23008-E /SO | U12 | SOIC-18_L1 1.6-W7.5-P1. 27-LS10.3-B L | | MCP23008-E /SO | MICROCHIP( ) 美国微芯 | C92253 | LCSC
44 | 1 | LIS3MDLTR | U13 | LGA-12_L2.0 -W2.0-P0.50-BL | | LIS3MDLTR | ST(意法半导 体) | C478483 | LCSC
45 | 1 | LSM9DS1TR | U14 | LGA-24_L3.5 -W3.0-P0.43-TL | | LSM9DS1TR | ST(意法半导 体) | C2655096 | LCSC
46 | 1 | BNO055 | U15 | LGA-28_L5.2 -W3.8-P0.50-BL | | BNO055 | Bosch(博世 ) | C93216 | LCSC
47 | 2 | EVQ-Q2P02 W | U16,U22 | SW-SMD_4P -L6.5-W6.0-P 4.00-LS6.6-T L | | EVQ-Q2P02 W | PANASONIC (松下) | C2680625 | LCSC
48 | 1 | IM63D135AX TMA1 | U17 | MIC-SMD_5 P-L3.5-W2.7 _IM66D130A XTMA1 | | IM63D135AX TMA1 | Infineon(英飞 凌) | C41574995 | LCSC
49 | 1 | ADAU1450W BCPZ-RL | U18 | LFCSP-72_L 10.0-W9.8-P 0.50-LS10.2-TL-EP5.5 | | ADAU1450W BCPZ-RL | ADI(亚德诺 ) | C654399 | LCSC
50 | 9 | B3B-XH-A(L F)(SN) | U19,U23,U24,U25,U26,U27 ,U28,U29,U30 | CONN-TH_3 P-P2.50_A25 01WV2-3P | | B3B-XH-A(L F)(SN) | JST | C144394 | LCSC
51 | 3 | 2.54-1*4 | U20,U31,U32 | HDR-TH_4P-P2.54-V-M-1 | | 2.54-1*4 | ZHOURI( 洲 ) 日 | C5116483 | LCSC
52 | 2 | KF128-5.0-2 P | U21,U33 | CONN-TH_P 5.00_KF128-5.0-2P | | KF128-5.0-2 P | KEFA(科发 ) | C474950 | LCSC
53 | 1 | TYPE-C-31-M-12 | USBC1 | USB-C_SMD -TYPE-C-31-M-12_1 | | TYPE-C-31-M-12 | 韩国韩荣 | C165948 | LCSC
54 | 1 | 12MHz | X1 | HC-49S_L11. 4-W4.8 | 12MHz | X49SM12MS D2SC | YXC(扬兴晶 振) | C14871 | LCSC
55 | 1 | - | X2 | CRYSTAL-S MD_4P-L3.2-W2.5-BL | - NX3225GA-1 | 2.288MHz-S TD-CRG-2 | NDK | C519811 | LCSC

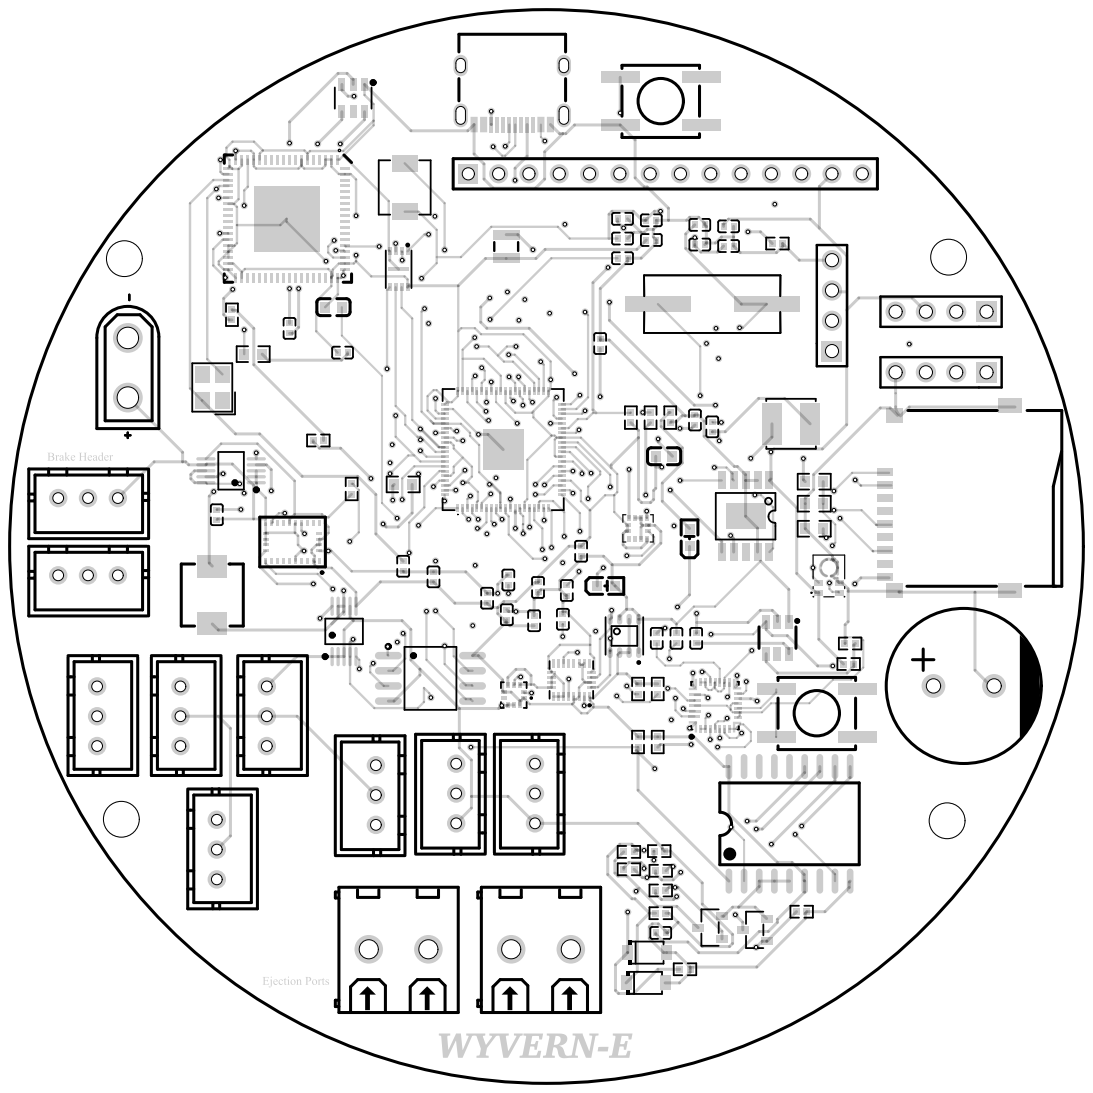
[picture p169: page 6]

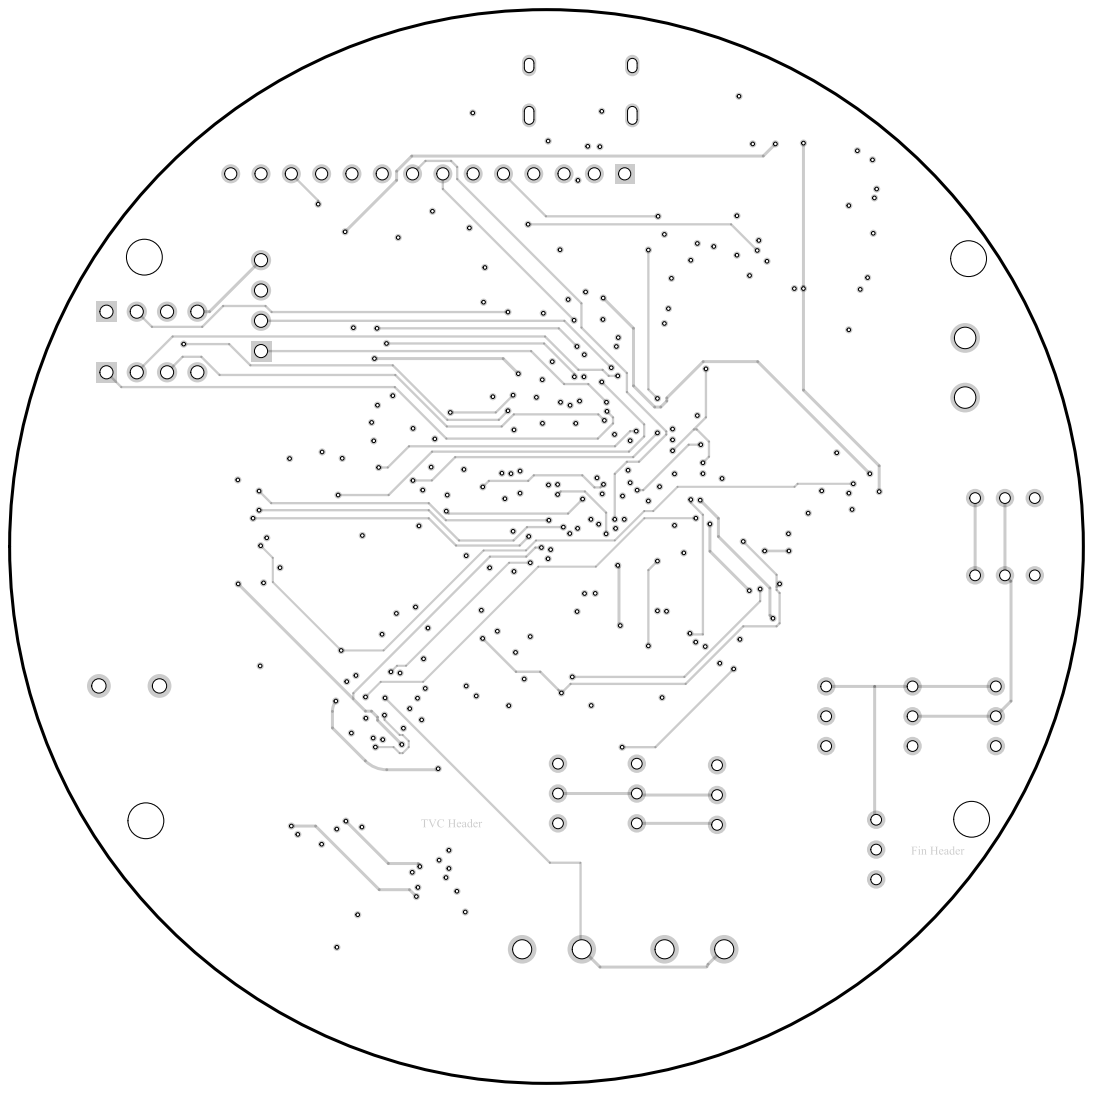
[picture p170: page 7]

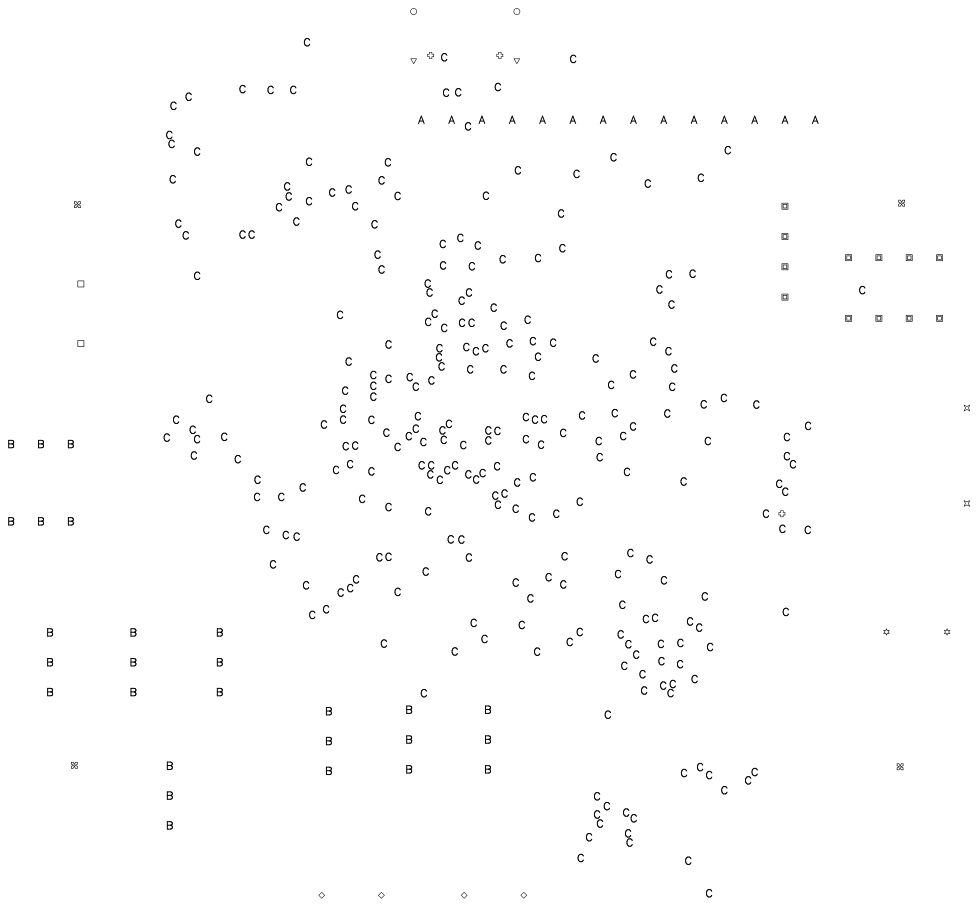
[picture p171: page 8]
