swaroopsahoo4908/GTR70E-WYVERN/TVC ARCHIVED/Past Iterations/WYVERN-E 1.0/CAD:Models:PCB/WYVERN_Engineering_Analysis.pdf

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

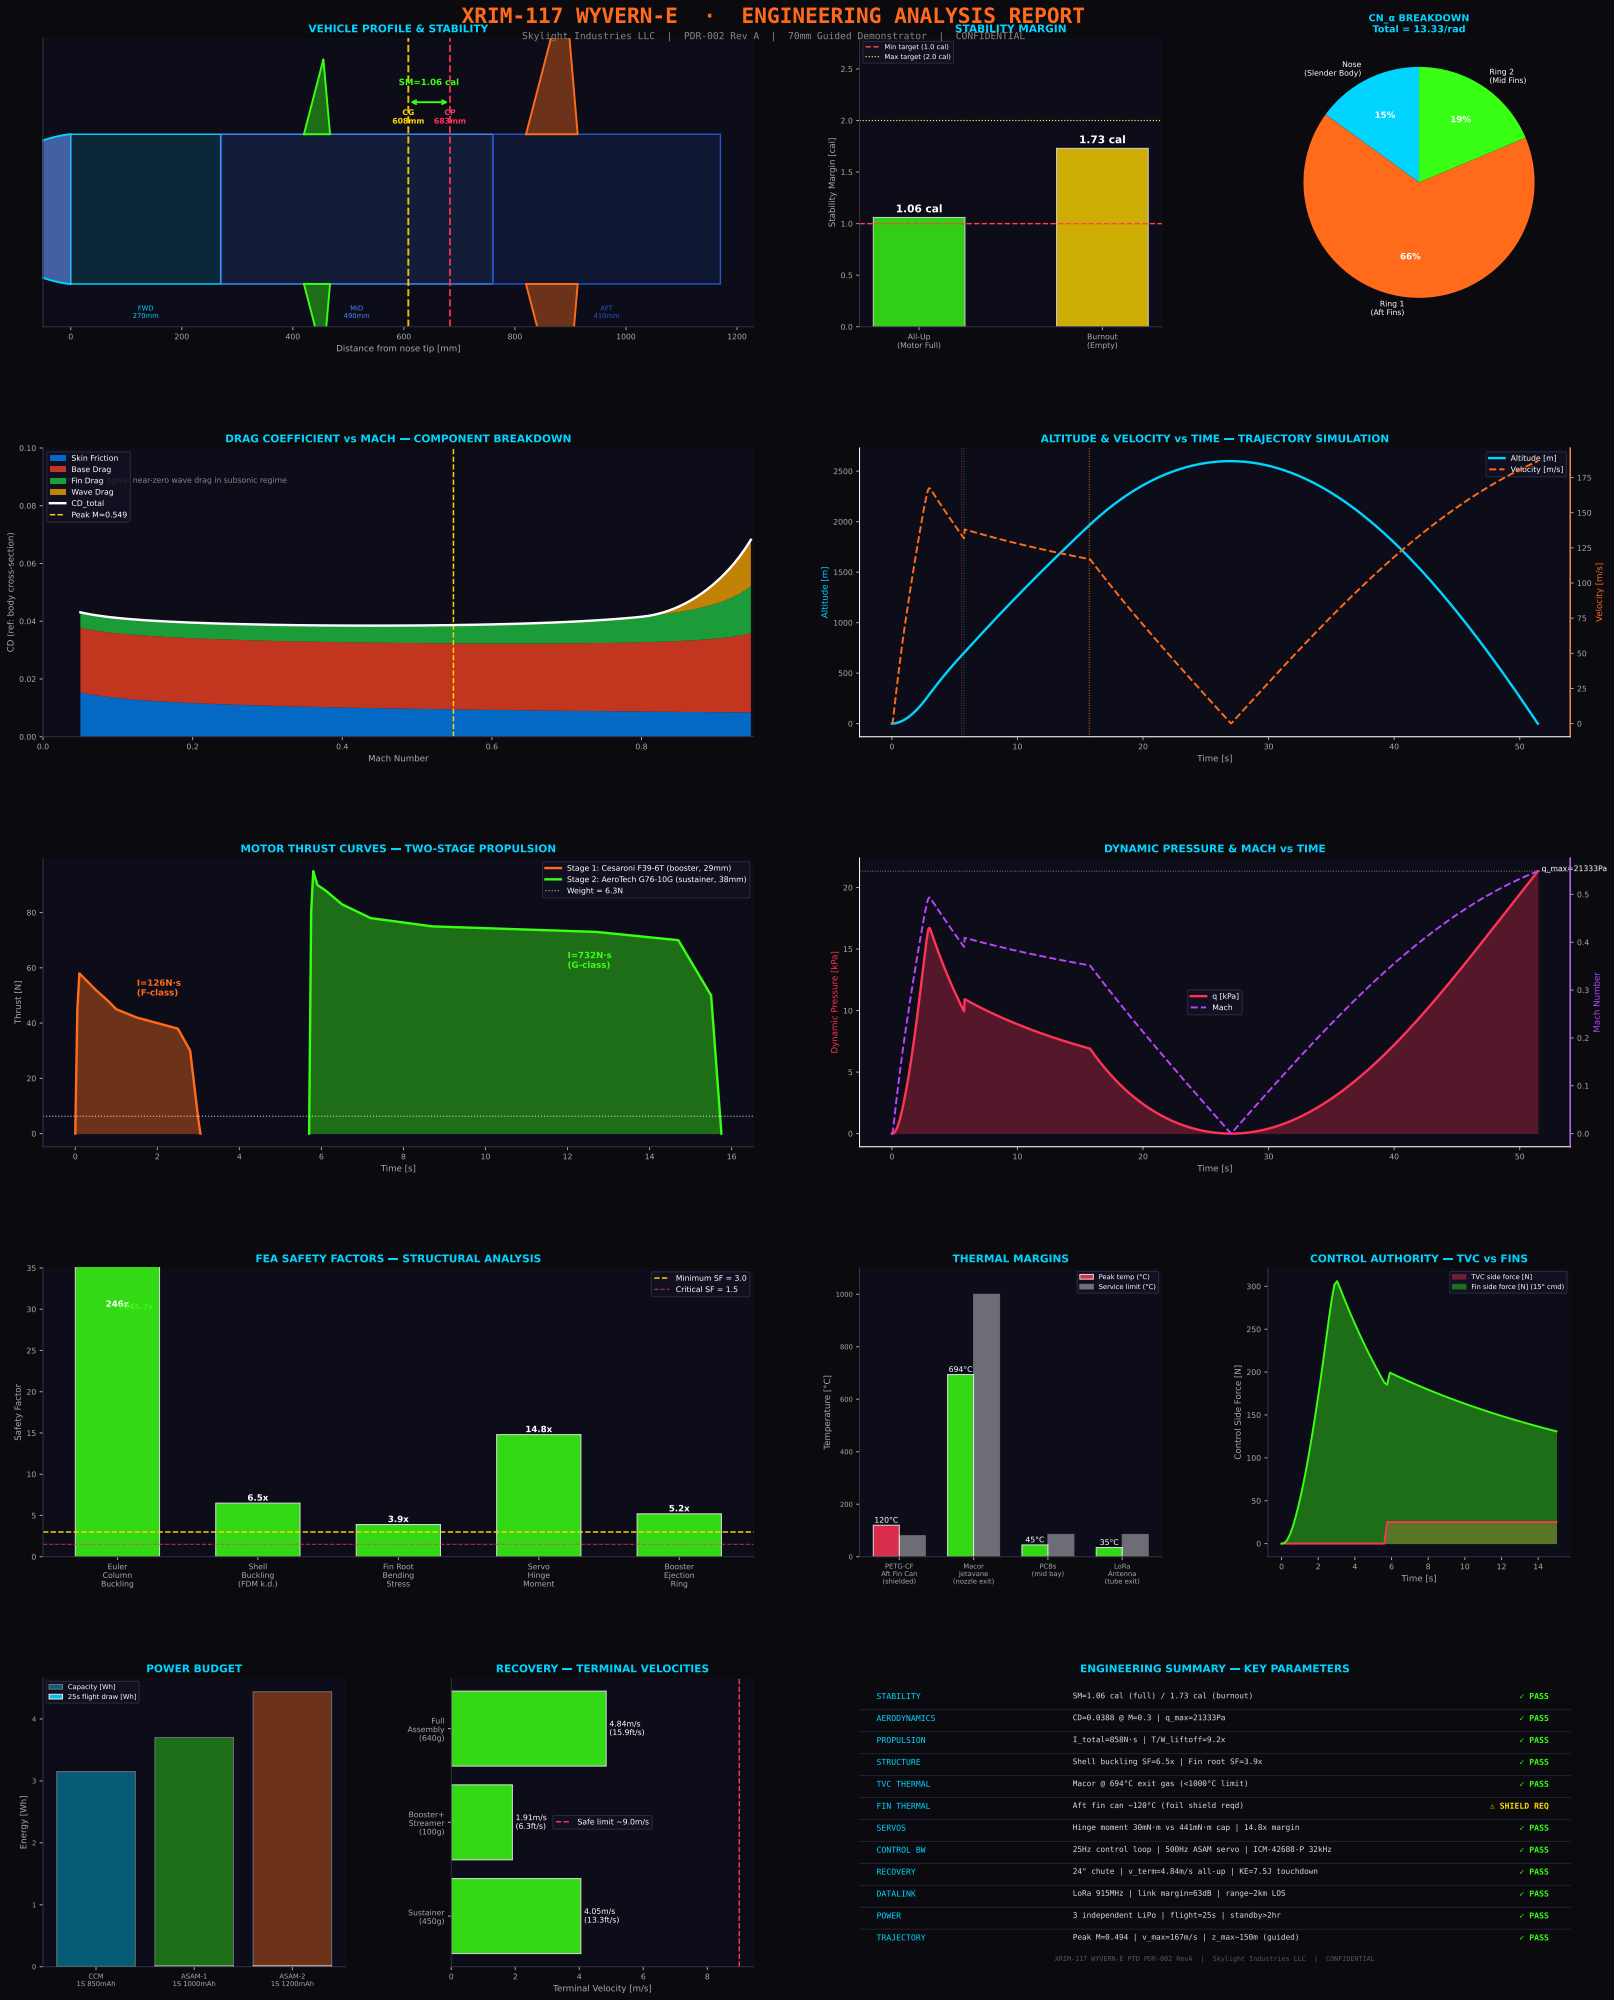
[picture p180: page 1]
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
