swaroopsahoo4908/GTR70E-WYVERN/TVC ARCHIVED/Past Iterations/WYVERN-E KiCad/FC70/WYVERN-E_FC70_layers.pdf

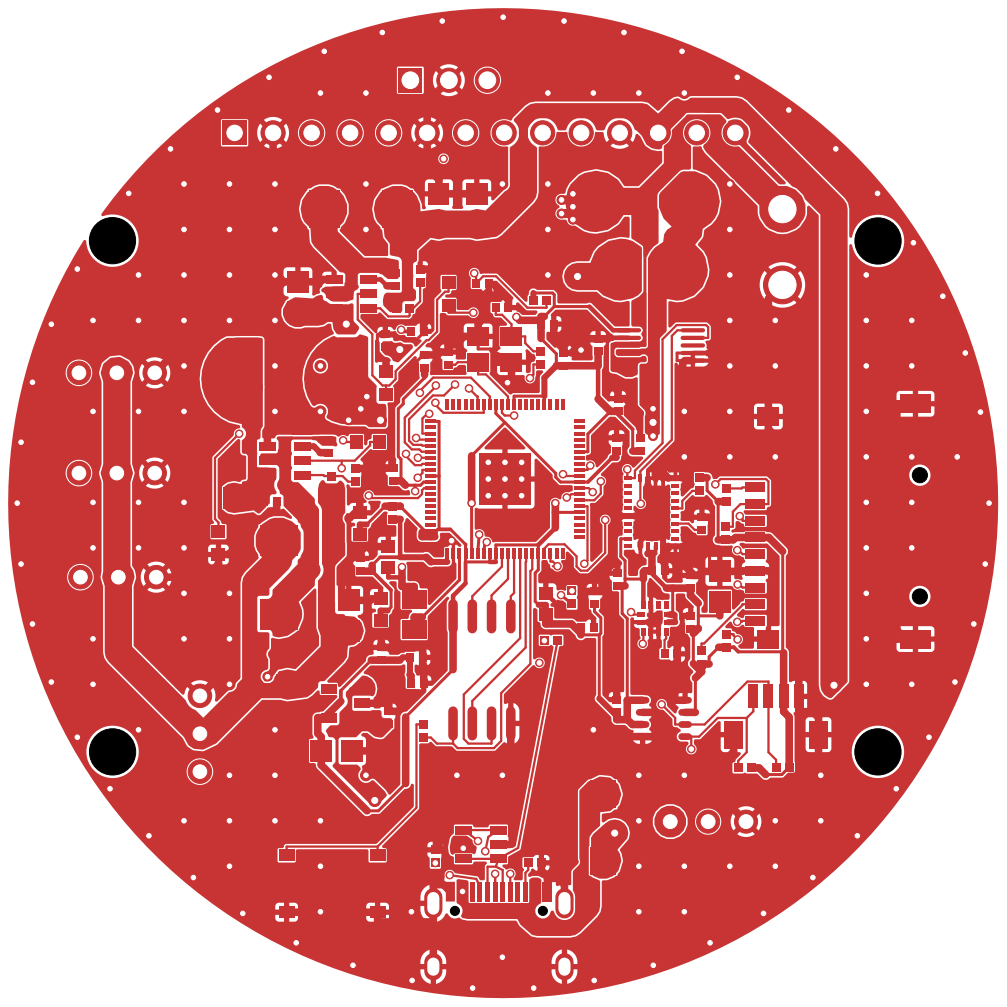
[picture p181: page 1]

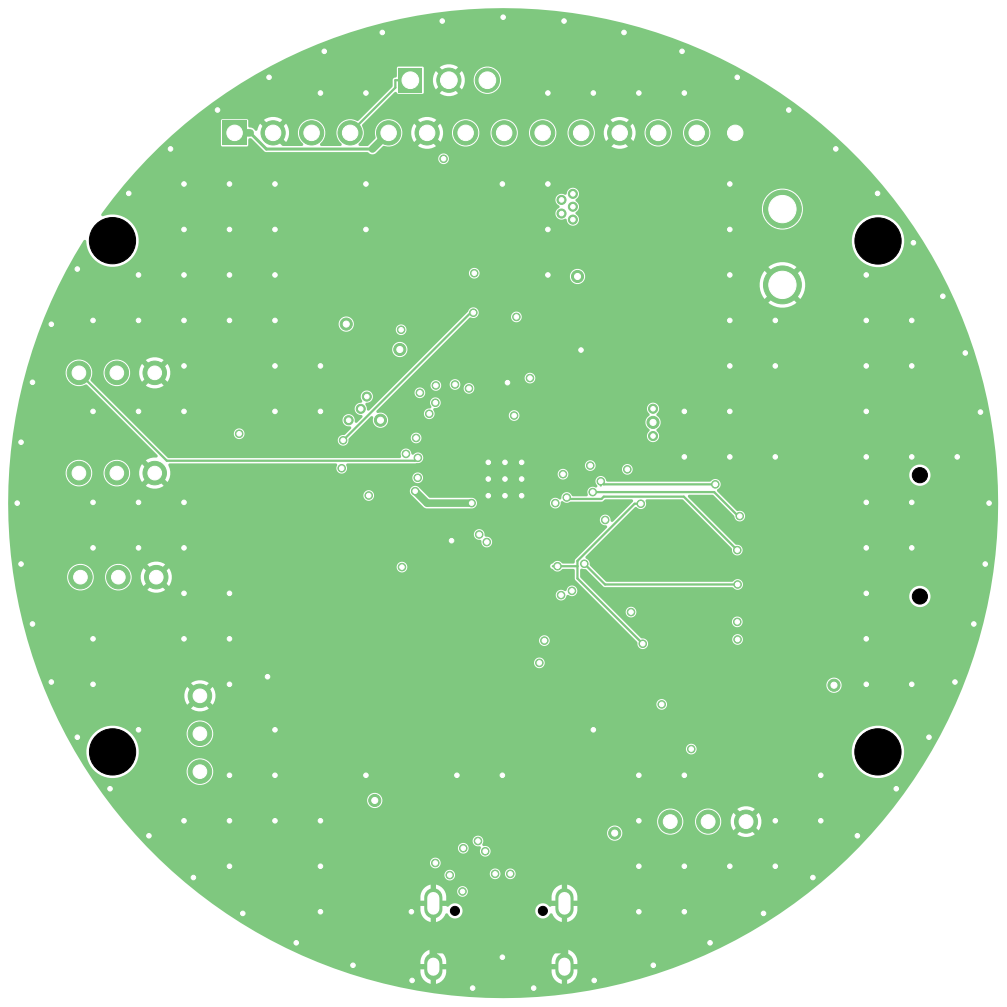
[picture p182: page 2]

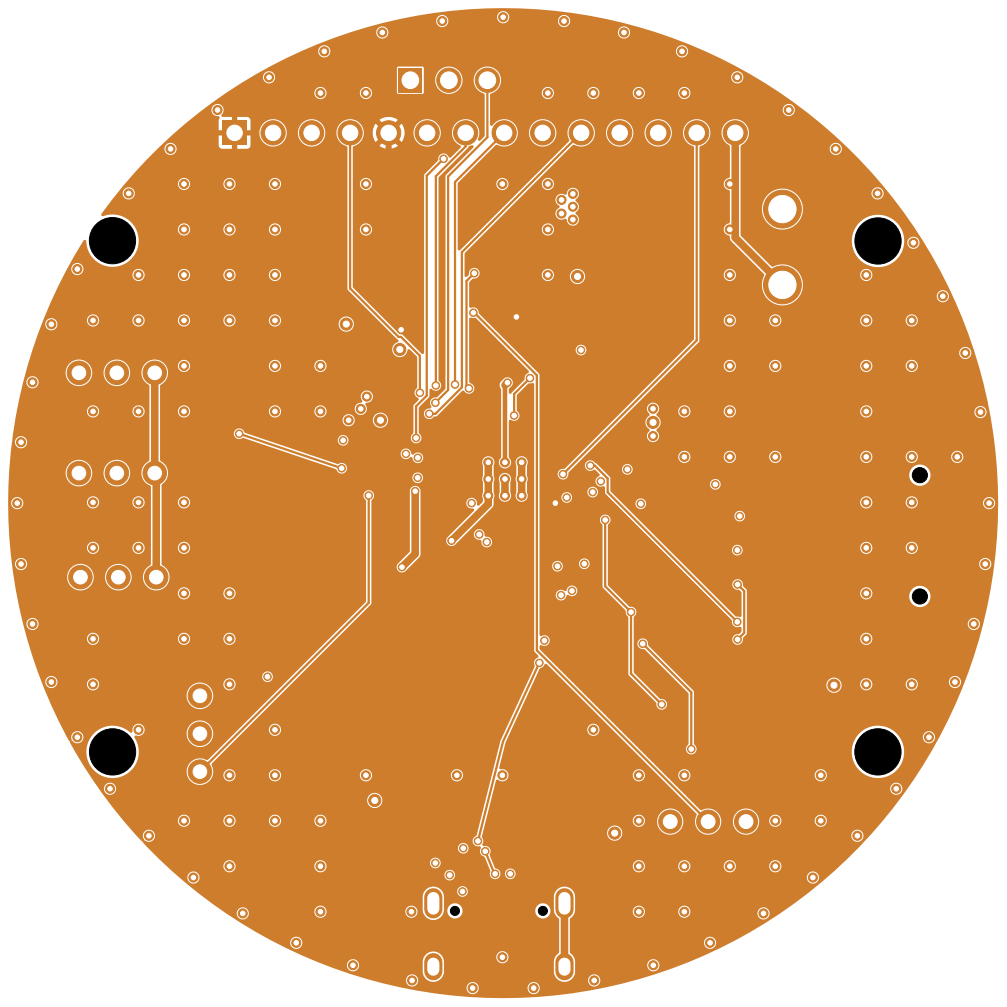
[picture p183: page 3]

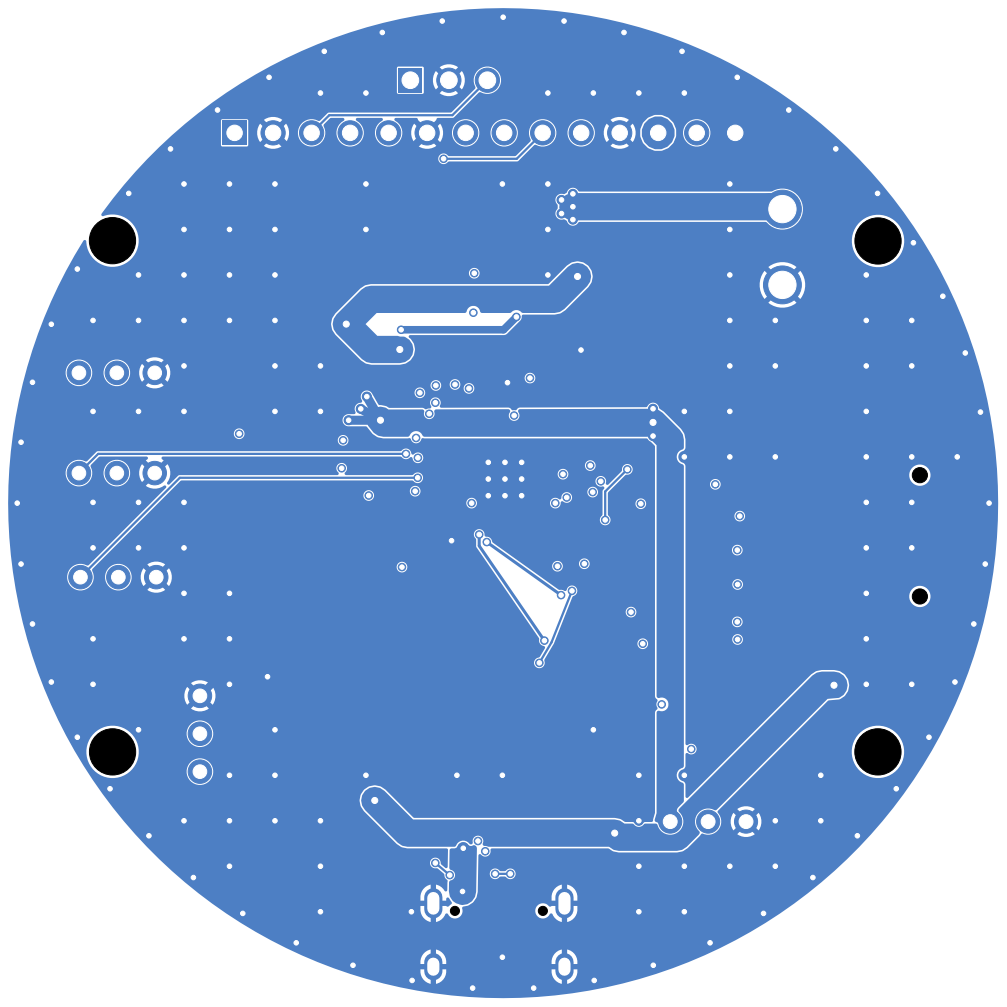
[picture p184: page 4]

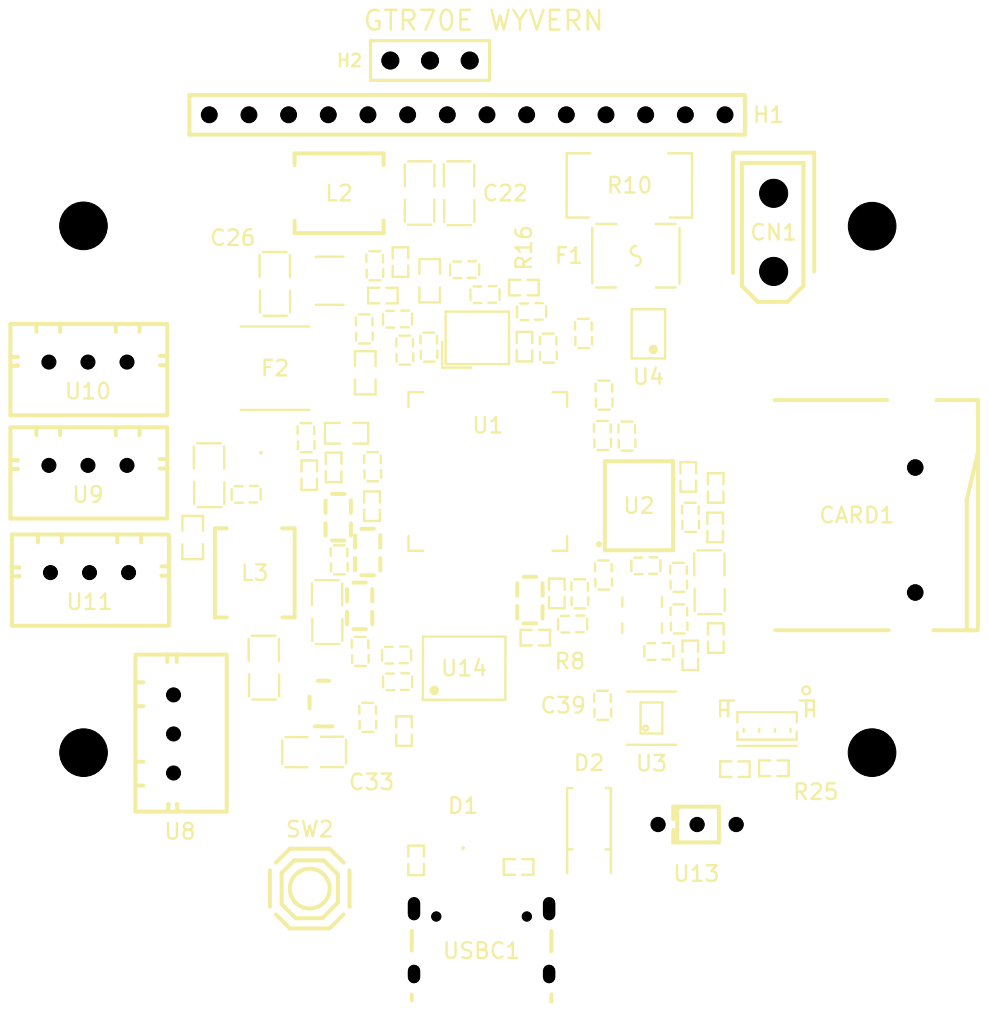
[picture p185: page 5]

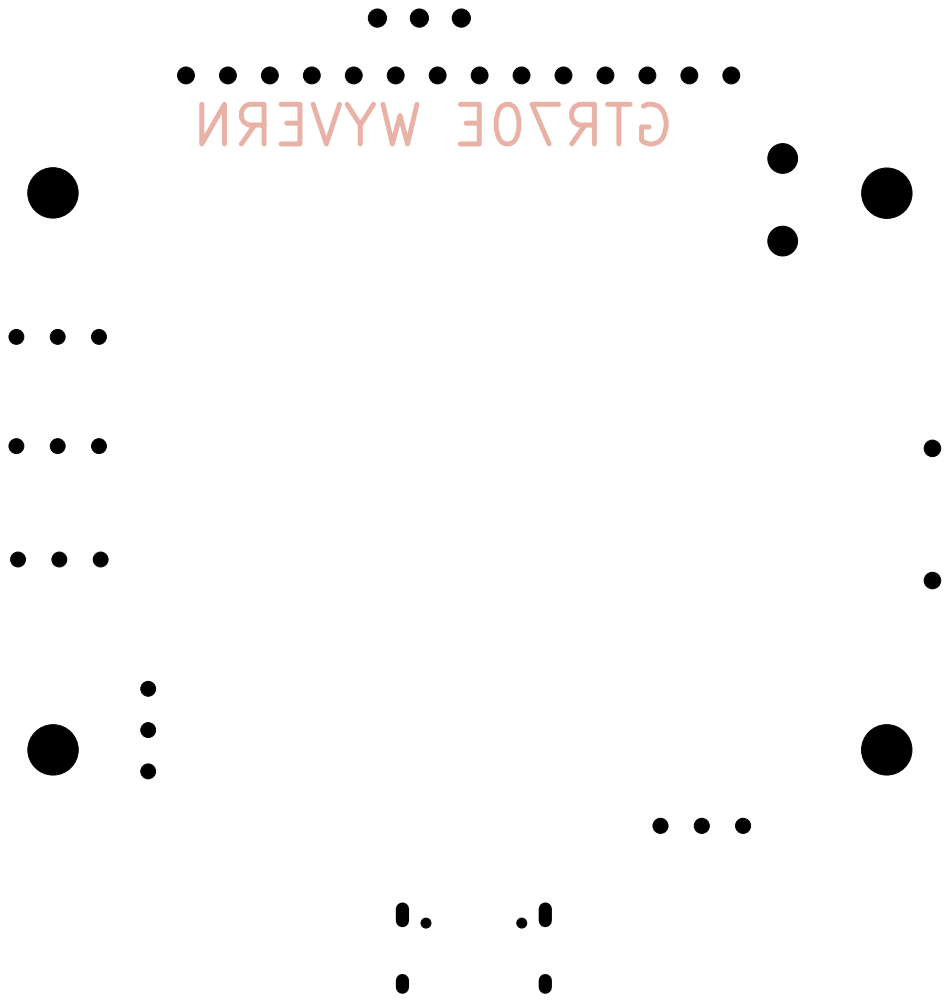
[picture p186: page 6]

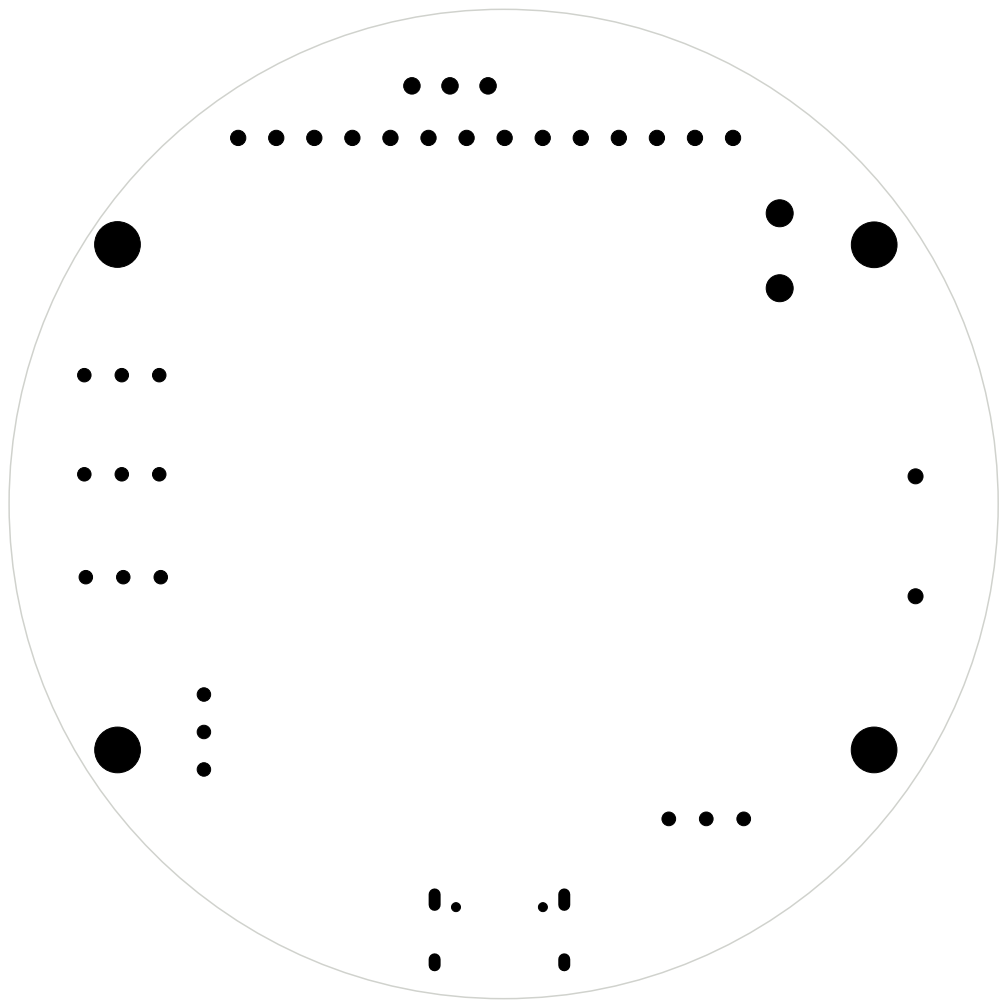
[picture p187: page 7]
