swaroopsahoo4908/GTR70E-WYVERN/TVC ARCHIVED/Past Iterations/WYVERN-E-Old PCB/PCB/PCB_PCB1_2026-08-12.pdf

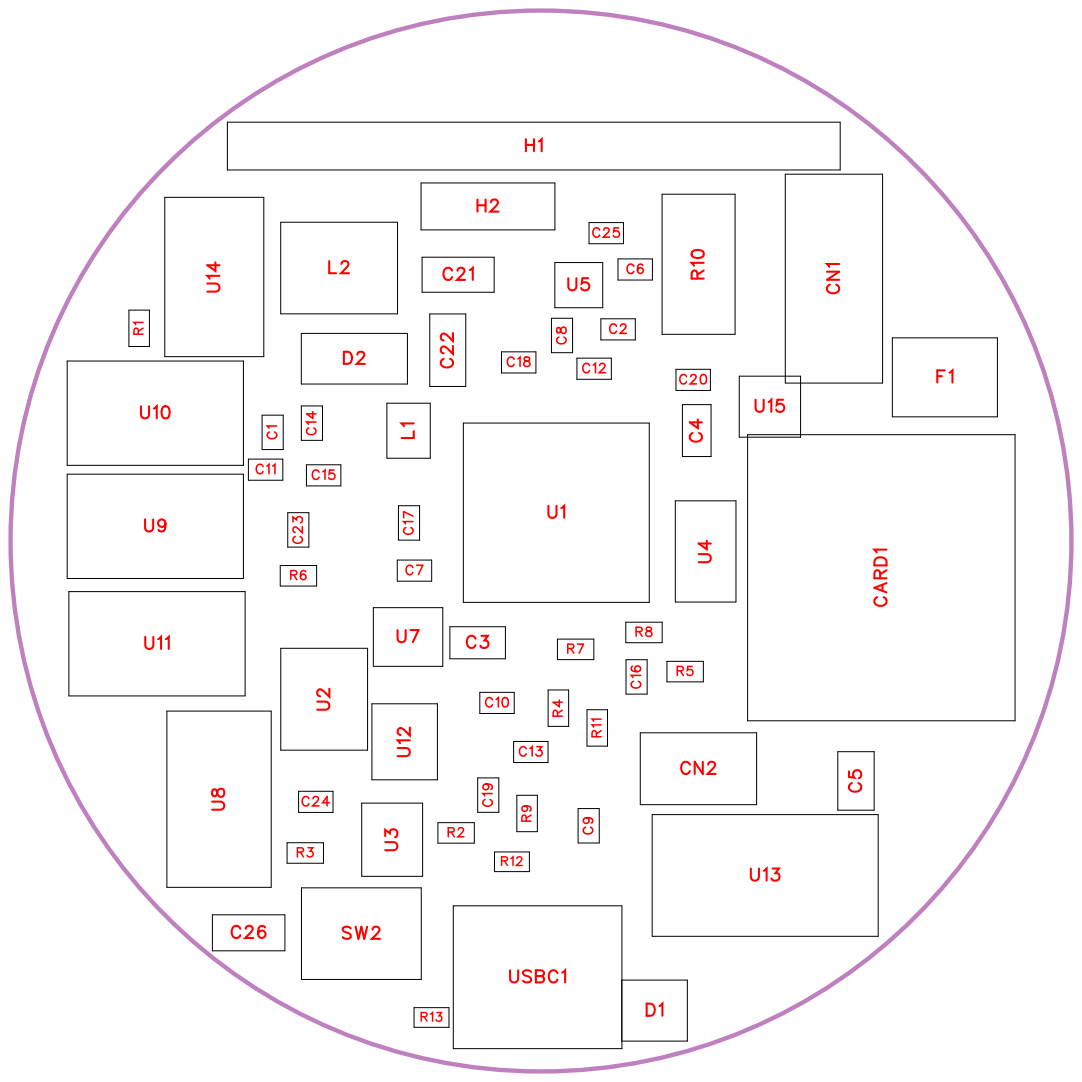
[picture p188: page 1]

No. | Quantity | Comment | Designator | Footprint | Value | Manufacturer Part | Manufacturer | Supplier Part | Supplier
1 | 2 | 15pF | C1,C2 | C0402 | 15pF | 0402CG150J 500NT | FH(风华) | C1548 | LCSC
2 | 3 | 4.7uF | C3,C4,C5 | C0603 | 4.7uF | CL10A475KA 8NQNC | SAMSUNG( 三星) | C69335 | LCSC
3 | 18 | 100nF | C6,C7,C8,C9,C10,C11,C12, C13,C14,C15,C16,C17,C18 ,C19,C20,C23,C24,C25 | C0402 | 100nF | CC0402KRX 7R9BB104 | YAGEO(国巨 ) | C131394 | LCSC
4 | 2 | 22uF | C21,C22 | C0805 | 22uF | CL21A226M PQNNNE | SAMSUNG( 三星) | C29277 | LCSC
5 | 1 | 10uF | C26 | C0805 | 10uF | CL21B106K OQNNNE | SAMSUNG( 三星) | C95841 | LCSC
6 | 1 | TF-01A | CARD1 | TF-SMD_TF-01A | | TF-01A | 韩国韩荣 | C91145 | LCSC
7 | 1 | XT30UPB-M | CN1 | CONN-TH_X T30UPB-M | | XT30UPB-M | AMASS(艾迈 斯) | C428721 | LCSC
8 | 1 | BM04B-SRS S-TB(LF)(SN ) | CN2 | CONN-SMD_ BM04B-SRS S-TB | | BM04B-SRS S-TB(LF)(SN ) | JST | C160390 | LCSC
9 | 1 | USBLC6-2S C6 | D1 | SOT-23-6_L2 .9-W1.6-P0.9 5-LS2.8-BL | | USBLC6-2S C6 | ST(意法半导 体) | C7519 | LCSC
10 | 1 | SS14 | D2 | SMA_L4.4-W 2.6-LS5.0-R D | | SS14 | 晶导微电子 | C112424 | LCSC
11 | 1 | SMD1812P2 60TF/16 | F1 | F1812 | | SMD1812P2 60TF/16 | PTTC(聚鼎) | C438899 | LCSC
12 | 1 | 2011-1X14G 00SB | H1 | HDR-TH_14 P-P2.54-V-M _4 | | 2011-1X14G 00SB | WingTAT(格 林柏) | C49569637 | LCSC
13 | 1 | 2.54-1*3P针 | H2 | HDR-TH_3P-P2.54-V-M-1 | | 2.54-1*3P针 | BOOMELE( 博穆精密) | C49257 | LCSC
14 | 1 | 3.3uH | L1 | IND-SMD_L2 .0-W1.6_AO TA-B201610 S3R3-101-T | 3.3uH | AOTA-B2016 10S3R3-101-T | ABRACON | C42411119 | LCSC
15 | 1 | 2.2uH | L2 | IND-SMD_L5 .7-W5.1 | 2.2uH | CKST0503-2. 2uH/M | CENKER(岑 科) | C3002617 | LCSC
16 | 2 | 1k | R1,R11 | R0402 | 1k | RC0402FR-0 71KL | YAGEO(国巨 ) | C106235 | LCSC
17 | 1 | 33 | R2 | R0402 | 33 | RC0402FR-0 733RL | YAGEO(国巨 ) | C138002 | LCSC
18 | 3 | 10k | R3,R4,R9 | R0402 | 10k | FRC0402F10 02TS | FOJAN(富捷) | C2906861 | LCSC
19 | 1 | 56k | R5 | R0402 | 56k | RC0402FR-0 756KL | YAGEO(国巨 ) | C114756 | LCSC
20 | 1 | 10.2k | R6 | R0402 | 10.2k | 0402WGF10 22TCE | UNI-ROYAL( 厚声) | C11660 | LCSC

21 | 2 | 27 | R7,R8 | R0402 | 27 | RC0402FR-0 727RL | YAGEO(国巨 ) | C138021 | LCSC
22 | 1 | 10m | R10 | R2512 | 10m | LR2512DS-3 W-10mR-1% | Milliohm(毫欧 ) | C500740 | LCSC
23 | 2 | 5.1k | R12,R13 | R0402 | 5.1k | FRC0402J51 2 TS | FOJAN(富捷 ) | C2906948 | LCSC
24 | 1 | TS-1187A-B-A-B | SW2 | SW-SMD_4P -L5.1-W5.1-P 3.70-LS6.5-T L_H1.5 | | TS-1187A-B-A-B | XKB Connect ion(中国星坤 ) | C318884 | LCSC
25 | 1 | RP2350B | U1 | QFN-80_L10. 0-W10.0-P0. 40-TL-EP3.4 | | RP2350B | Raspberry Pi(树莓派 ) | C42415655 | LCSC
26 | 1 | BNO055 | U2 | LGA-28_L5.2 -W3.8-P0.50-BL | | BNO055 | Bosch(博世 ) | C93216 | LCSC
27 | 1 | BME680 | U3 | LGA-8_L3.0-W3.0-P0.80-TR | | BME680 | Bosch(博世 ) | C125972 | LCSC
28 | 1 | INA226AIDG SR | U4 | MSOP-10_L3 .0-W3.0-P0.5 0-LS5.0-BL | | INA226AIDG SR | TI(德州仪器 ) | C49851 | LCSC
29 | 1 | LIS3MDLTR | U5 | LGA-12_L2.0 -W2.0-P0.50-BL | | LIS3MDLTR | ST(意法半导 体) | C478483 | LCSC
30 | 1 | AP2112K-3.3 TRG1 | U7 | SOT-23-5_L2 .9-W1.6-P0.9 5-LS2.8-BR | | AP2112K-3.3 TRG1 | TECH PUBLI C(台舟 ) | C23380830 | LCSC
31 | 4 | B3B-XH-A(L F)(SN) | U8,U9,U10,U11 | CONN-TH_3 P-P2.50_A25 01WV2-3P | | B3B-XH-A(L F)(SN) | JST | C144394 | LCSC
32 | 1 | 12MHz | U12 | CRYSTAL-S MD_4P-L3.2-W2.5-BL | 12MHz | ABM8-272-T 3 | ABRACON | C20625731 | LCSC
33 | 1 | SS-12D10G5 | U13 | SW-TH_SS-1 2D10L9 | | SS-12D10G5 | XKB Connect ion(中国星坤 ) | C2884744 | LCSC
34 | 1 | W25Q32JVS SIQ | U14 | SOIC-8_L5.3 -W5.3-P1.27-LS8.0-BL | | W25Q32JVS SIQ | Winbond( 华 ) 邦 | C179173 | LCSC
35 | 1 | TPS564201D DCR | U15 | SOT-23-6_L2 .9-W1.6-P0.9 5-LS2.8-BL | | TPS564201D DCR | TI(德州仪器 ) | C464812 | LCSC
36 | 1 | TYPE-C-31-M-12 | USBC1 | USB-C_SMD -TYPE-C-31-M-12_1 | | TYPE-C-31-M-12 | 韩国韩荣 | C165948 | LCSC

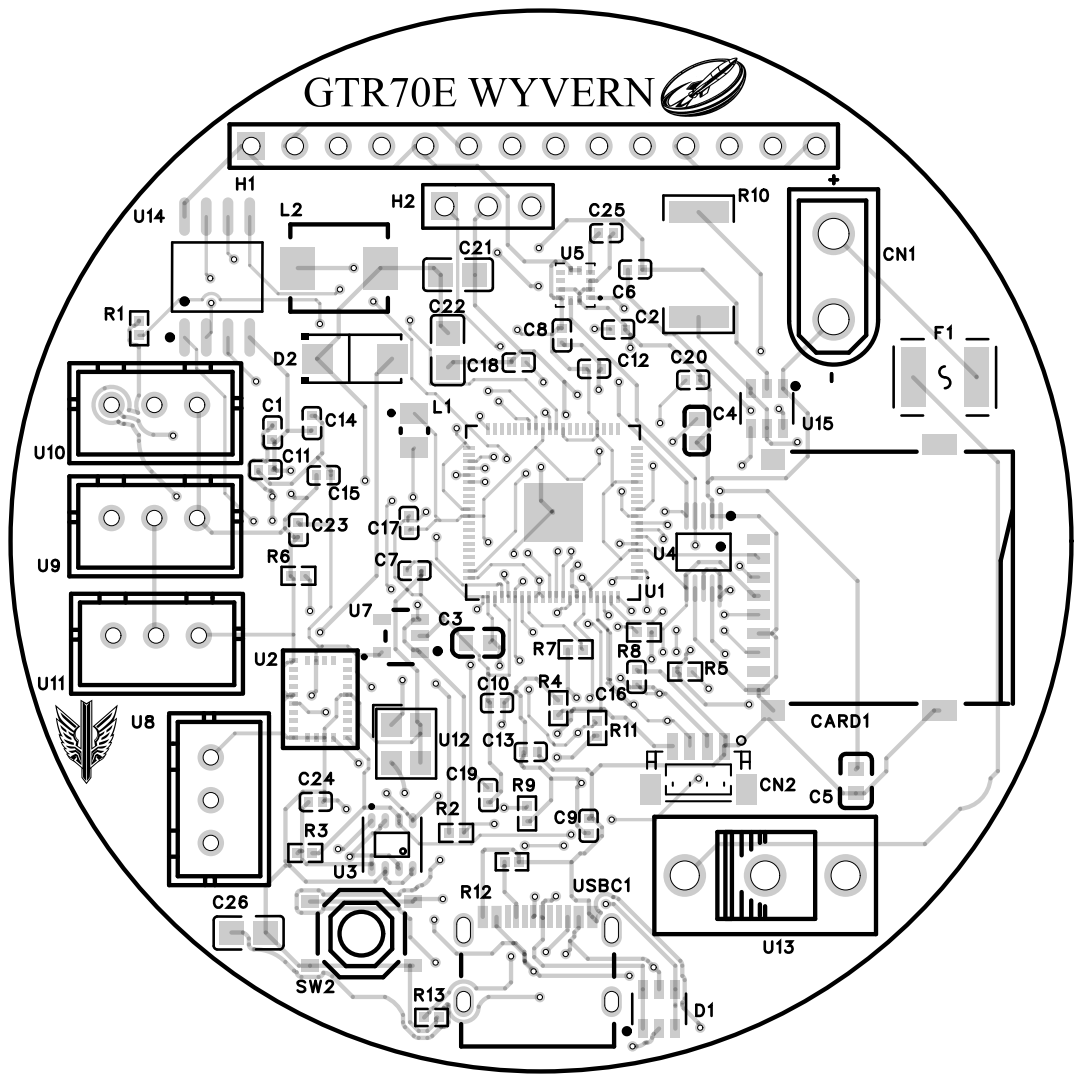
[picture p189: page 5]

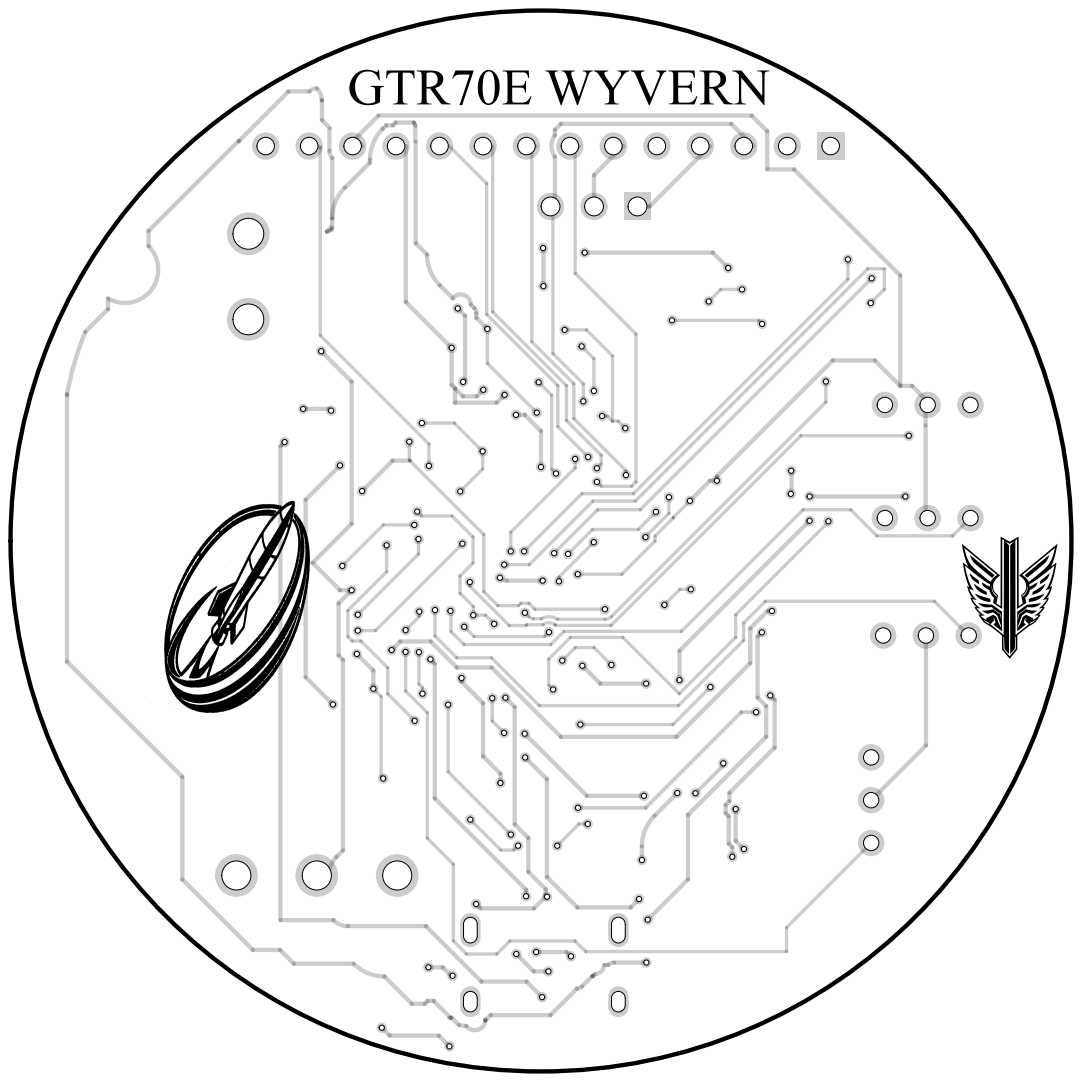
[picture p190: page 6]

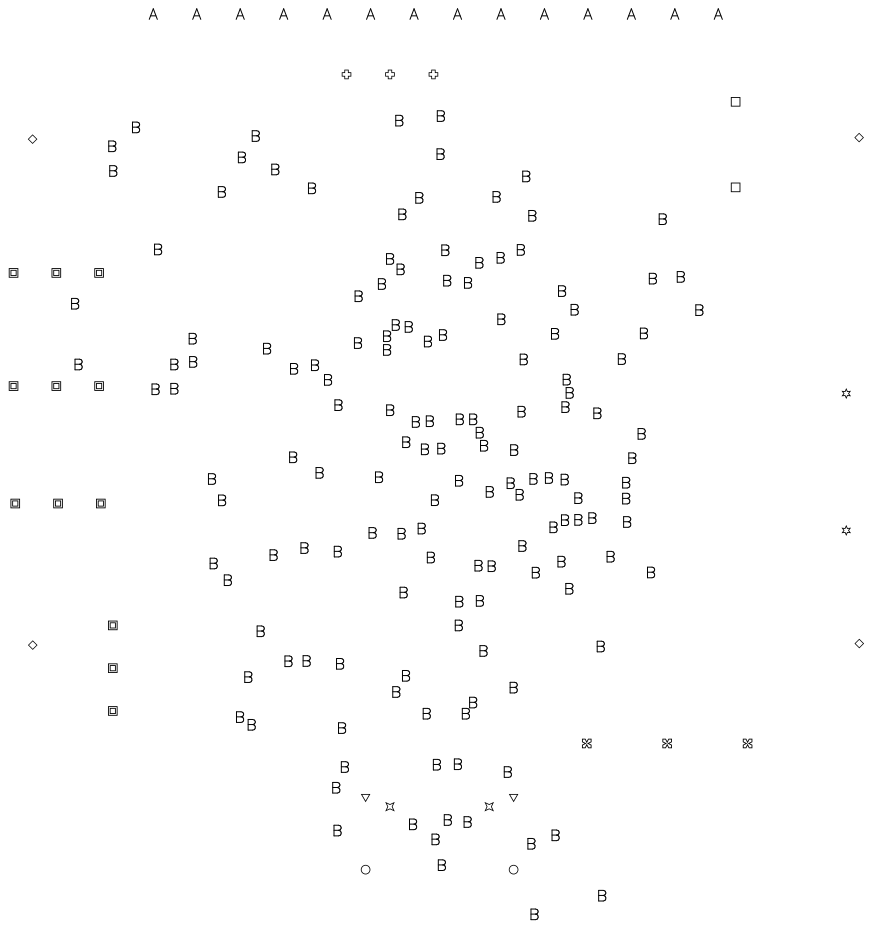
[picture p191: page 7]
