swaroopsahoo4908/GTR70E-WYVERN/(list of files, drawings)

Other design files:
TVC ARCHIVED/Past Iterations/WYVERN-E 1.0/CAD:Models:PCB/XRIM117_EasyEDA_v3/ASAM1_Mid_Ring_Controller.json
TVC ARCHIVED/Past Iterations/WYVERN-E 1.0/CAD:Models:PCB/XRIM117_EasyEDA_v3/ASAM1_Mid_Ring_Controller_wrapped.json
TVC ARCHIVED/Past Iterations/WYVERN-E 1.0/CAD:Models:PCB/XRIM117_EasyEDA_v3/ASAM2_TVC_Sustainer_Controller.json
TVC ARCHIVED/Past Iterations/WYVERN-E 1.0/CAD:Models:PCB/XRIM117_EasyEDA_v3/ASAM2_TVC_Sustainer_Controller_wrapped.json
TVC ARCHIVED/Past Iterations/WYVERN-E 1.0/CAD:Models:PCB/XRIM117_EasyEDA_v3/CCM_Central_Command_Module.json
TVC ARCHIVED/Past Iterations/WYVERN-E 1.0/CAD:Models:PCB/XRIM117_EasyEDA_v3/CCM_Central_Command_Module_wrapped.json
TVC ARCHIVED/Past Iterations/WYVERN-E-Old PCB/Autorouter_PCB1_2026-8-8.dsn
TVC ARCHIVED/Past Iterations/WYVERN-E-Old PCB/Autorouter_PCB1_2026-8-9.dsn
TVC ARCHIVED/Past Iterations/WYVERN-E-Old PCB/Autorouter_PCB1_2026-8-11.dsn
TVC ARCHIVED/Past Iterations/WYVERN-E-Old PCB/Autorouter_PCB1_2026-8-12 (1).dsn
TVC ARCHIVED/Past Iterations/WYVERN-E-Old PCB/Autorouter_PCB1_2026-8-12 (2).dsn
TVC ARCHIVED/Past Iterations/WYVERN-E-Old PCB/Autorouter_PCB1_2026-8-12.dsn
TVC ARCHIVED/Past Iterations/WYVERN-E-Old PCB/Manual/Autorouter_PCB1_2026-8-10.dsn
TVC ARCHIVED/Past Iterations/WYVERN-E-Old PCB/PCB/Autorouter_PCB1_2026-8-12.dsn
