swaroopsahoo4908/GTR70E-WYVERN/TVC ARCHIVED/Past Iterations/WYVERN-E 1.0/CAD:Models:PCB/XRIM117E_KiCAD_RevC/SDM_KiCAD_RevC/SDM_Solenoid_Drive_Module.kicad_pcb

## KiCad design TVC ARCHIVED/Past Iterations/WYVERN-E 1.0/CAD:Models:PCB/XRIM117E_KiCAD_RevC/SDM_KiCAD_RevC/SDM_Solenoid_Drive_Module.kicad_pcb (2026-10-18, an earlier design)

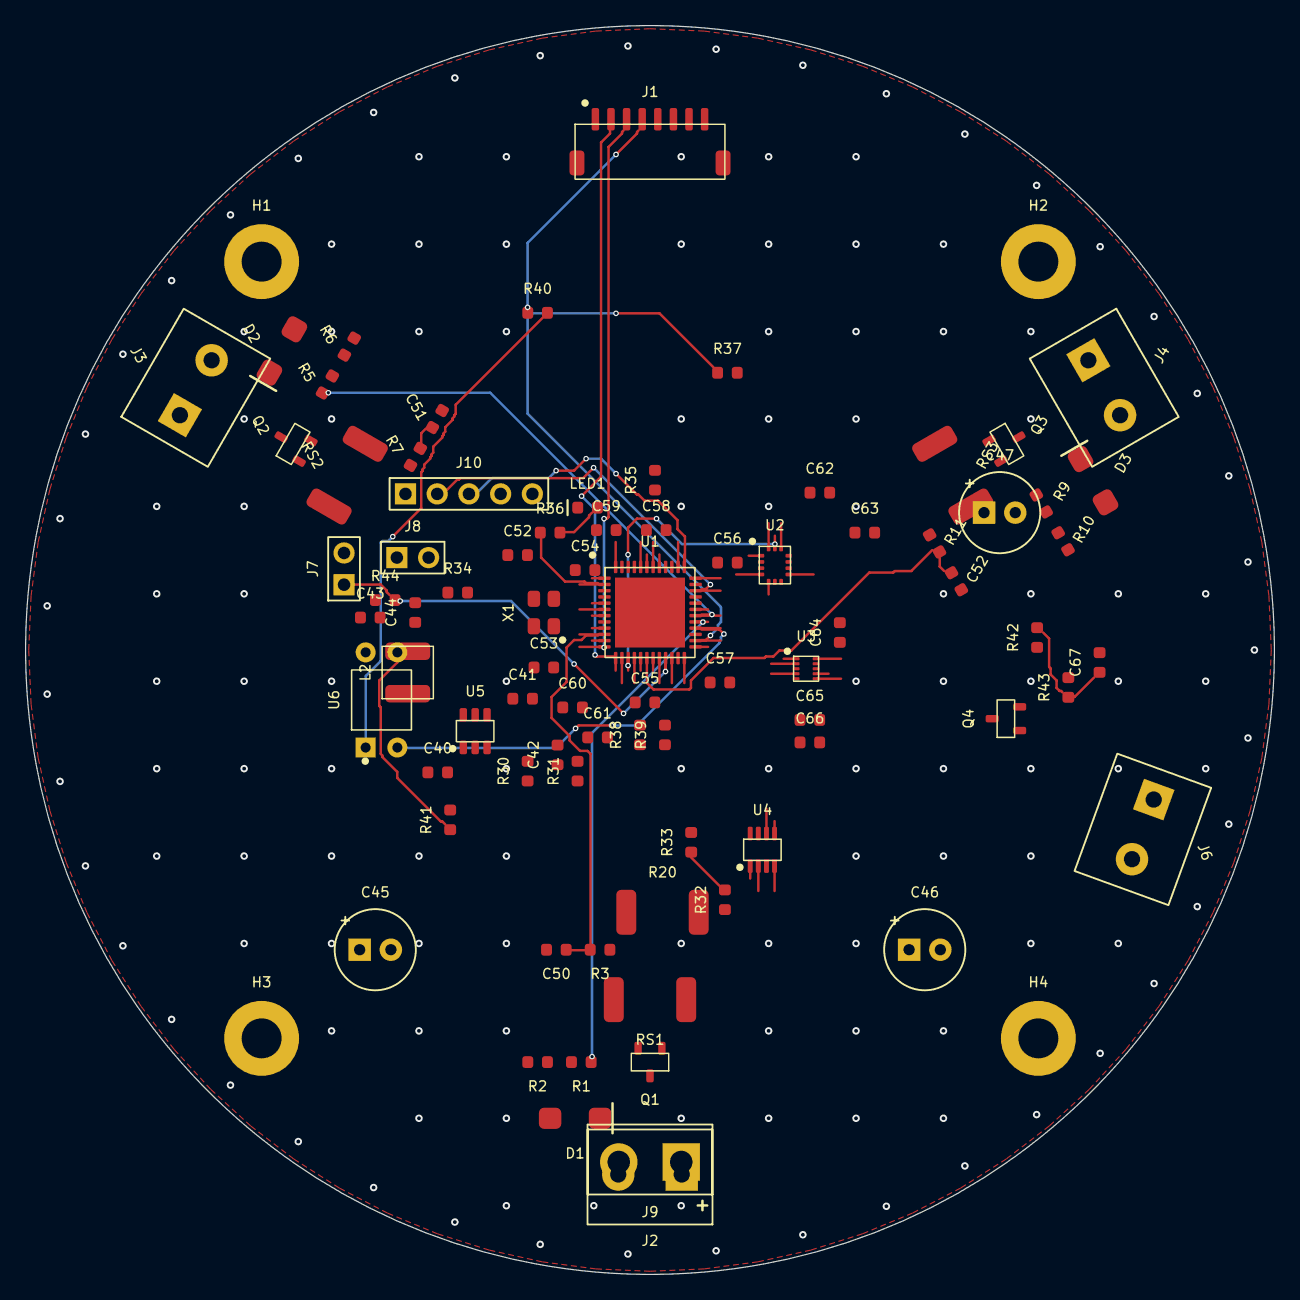
[picture p192: board SDM_Solenoid_Drive_Module.kicad_pcb from above]

Board: 2 copper layers, 100.0 x 100.0 mm, 84 parts (0 on the bottom side), 50 nets.

Parts:
C40, C50, C51, C52, C54, C56, C57, C58, C60, C62, C65, C66: 100nF; C_0603
C41, C42: 10uF 25V; C_0603
C43, C44: 22uF; C_0603
C45, C46, C47: 470uF; CP_Radial_D6.3mm_P2.50mm
C52#2, C53: 18pF; C_0603
C55: 4.7uF; C_0603
C59: 10uF; C_0603
C61: 1uF; C_0603
C63: 2.2uF; C_0603
C64, C67: 10nF; C_0603
D1, D2, D3: SS34; D_SMA
H1, H2, H3, H4: M3; MountingHole_M3
J1: to CCM; JST_GH_SM08B-GHS-TB
J2: SOL1; TerminalBlock_2P_5.08mm
J3: SOL2; TerminalBlock_2P_5.08mm
J4: SOL3; TerminalBlock_2P_5.08mm
J6: SUSTAIN; TerminalBlock_2P_5.08mm
J7: REED; PinHeader_1x02_P2.54mm
J8: BOOT0; PinHeader_1x02_P2.54mm
J9: XT30 2S; XT30_Male_Vertical
J10: SWD; PinHeader_1x05_P2.54mm
L2: 10uH; L_4x4mm
LED1: STAT; LED_0603
Q1, Q2, Q3, Q4: AO3400A; SOT-23
R1, R5, R9: 100R; R_0603
R2, R6, R10, R32, R37, R41, R42: 100k; R_0603
R3, R7, R11, R36: 1k; R_0603
R20: 10m 2512; R_2512_Shunt
R30: 45.3k; R_0603
R31, R34, R35, R44: 10k; R_0603
R33, R43: 27k; R_0603
R38, R39: 4.7k; R_0603
R40: 330R; R_0603
RS1, RS2, RS3: 20m 2512; R_2512_Shunt
U1: STM32F411CEU6; UFQFPN-48_7x7mm_P0.5mm
U2: ICM-42688-P; ICM-42688-P_LGA-14_2.5x3mm
U3: BMP388; BMP388_LGA-10_2x2mm
U4: INA219; SOT-23-8
U5: TPS54202; SOT-23-6
U6: PC817; PC817_DIP-4
X1: 8MHz; Crystal_3225_4Pin

Connections:
+3V3: C43.1, C44.1, C56.1, C57.1, C58.1, C59.1, C60.1, C61.1, C62.1, C63.1, C64.1, C65.1, C66.1, J8.2, J10.1, L2.2, R30.1, R38.1, R39.1, R44.1, U1.1, U1.9, U1.24, U1.36, U1.48, U2.5, U2.8, U3.1, U3.6, U3.10, U4.4
ARM_IN: J1.4, R37.1, R40.1, U1.26
ARM_IN_R: R40.2, U6.1
BMP_INT: U1.41, U3.7
BOOT0: J8.1, R34.1, U1.44
BUCK_BOOT: C40.1, U5.6
BUCK_FB: R30.2, R31.1, U5.4
BUCK_SW: C40.2, L2.1, U5.2
GND: C41.2, C42.2, C43.2, C44.2, C45.2, C46.2, C47.2, C50.2, C51.2, C52.2, C52#2.2, C53.2, C54.2, C55.2, C56.2, C57.2, C58.2, C59.2, C60.2, C61.2, C62.2, C63.2, C64.2, C65.2, C66.2, C67.2, J1.1, J1.7, J1.8, J1.MP1, J1.MP2, J7.2, J9.2, J10.5, LED1.1, Q4.2, R2.2, R6.2, R10.2, R31.2, R33.2, R34.2, R35.2, R37.2, R41.2, R43.2, RS1.2, RS2.2, RS3.2, U1.8, U1.23, U1.35, U1.47, U1.49, U2.6, U2.7, U2.9, U3.3, U3.5, U3.8, U3.9, U4.3, U4.7, U4.8, U5.1, X1.2, X1.4
I2C1_SCL: R39.2, U1.42, U3.2, U4.5
I2C1_SDA: R38.2, U1.43, U3.4, U4.6
IMU_CS: U1.25, U2.12
IMU_INT1: U1.38, U2.4
LED_R: LED1.2, R36.2
LED_STATUS: R36.1, U1.2
NRST: C54.1, J10.4, U1.7
PB2_STRAP: R35.1, U1.20
REED: J7.1, R44.2, U1.21
SOL1_D: D1.1, J2.2, Q1.3
SOL1_G: Q1.1, R1.2, R2.1
SOL1_PWM: R1.1, U1.29
SOL1_SH: Q1.2, R3.1, RS1.1
SOL1_SNS: C50.1, R3.2, U1.10
SOL2_D: D2.1, J3.2, Q2.3
SOL2_G: Q2.1, R5.2, R6.1
SOL2_PWM: R5.1, U1.30
SOL2_SH: Q2.2, R7.1, RS2.1
SOL2_SNS: C51.1, R7.2, U1.11
SOL3_D: D3.1, J4.2, Q3.3
SOL3_G: Q3.1, R9.2, R10.1
SOL3_PWM: R9.1, U1.31
SOL3_SH: Q3.2, R11.1, RS3.1
SOL3_SNS: C52.1, R11.2, U1.18
SPI1_MISO: U1.16, U2.1
SPI1_MOSI: U1.17, U2.14
SPI1_SCK: U1.15, U2.13
SUS_CONT: C67.1, R42.2, R43.1, U1.14
SUS_D: J6.2, Q4.3, R42.1
SUS_FIRE: U1.28, U6.2
SUS_GATE: Q4.1, R41.1, U6.3
SWCLK: J10.3, U1.37
SWDIO: J10.2, U1.34
UART_RX: J1.2, U1.13
UART_TX: J1.3, U1.12
VBAT2S: C41.1, C42.1, J6.1, J9.1, R20.1, R32.1, U4.1, U5.3, U6.4
VBAT_SENSE: R32.2, R33.1, U1.19
VCAP: C55.1, U1.22
V_SOL: C45.1, C46.1, C47.1, D1.2, D2.2, D3.2, J2.1, J3.1, J4.1, R20.2, U4.2
XIN: C52#2.1, U1.5, X1.1
XOUT: C53.1, U1.6, X1.3
