swaroopsahoo4908/GTR70E-WYVERN/TVC ARCHIVED/Past Iterations/WYVERN-E 1.0/_OLD FILES/PCB/FCM_KiCAD/WYVERN_E2_FCM.kicad_pcb

## KiCad design TVC ARCHIVED/Past Iterations/WYVERN-E 1.0/_OLD FILES/PCB/FCM_KiCAD/WYVERN_E2_FCM.kicad_pcb (2026-10-18, an earlier design)

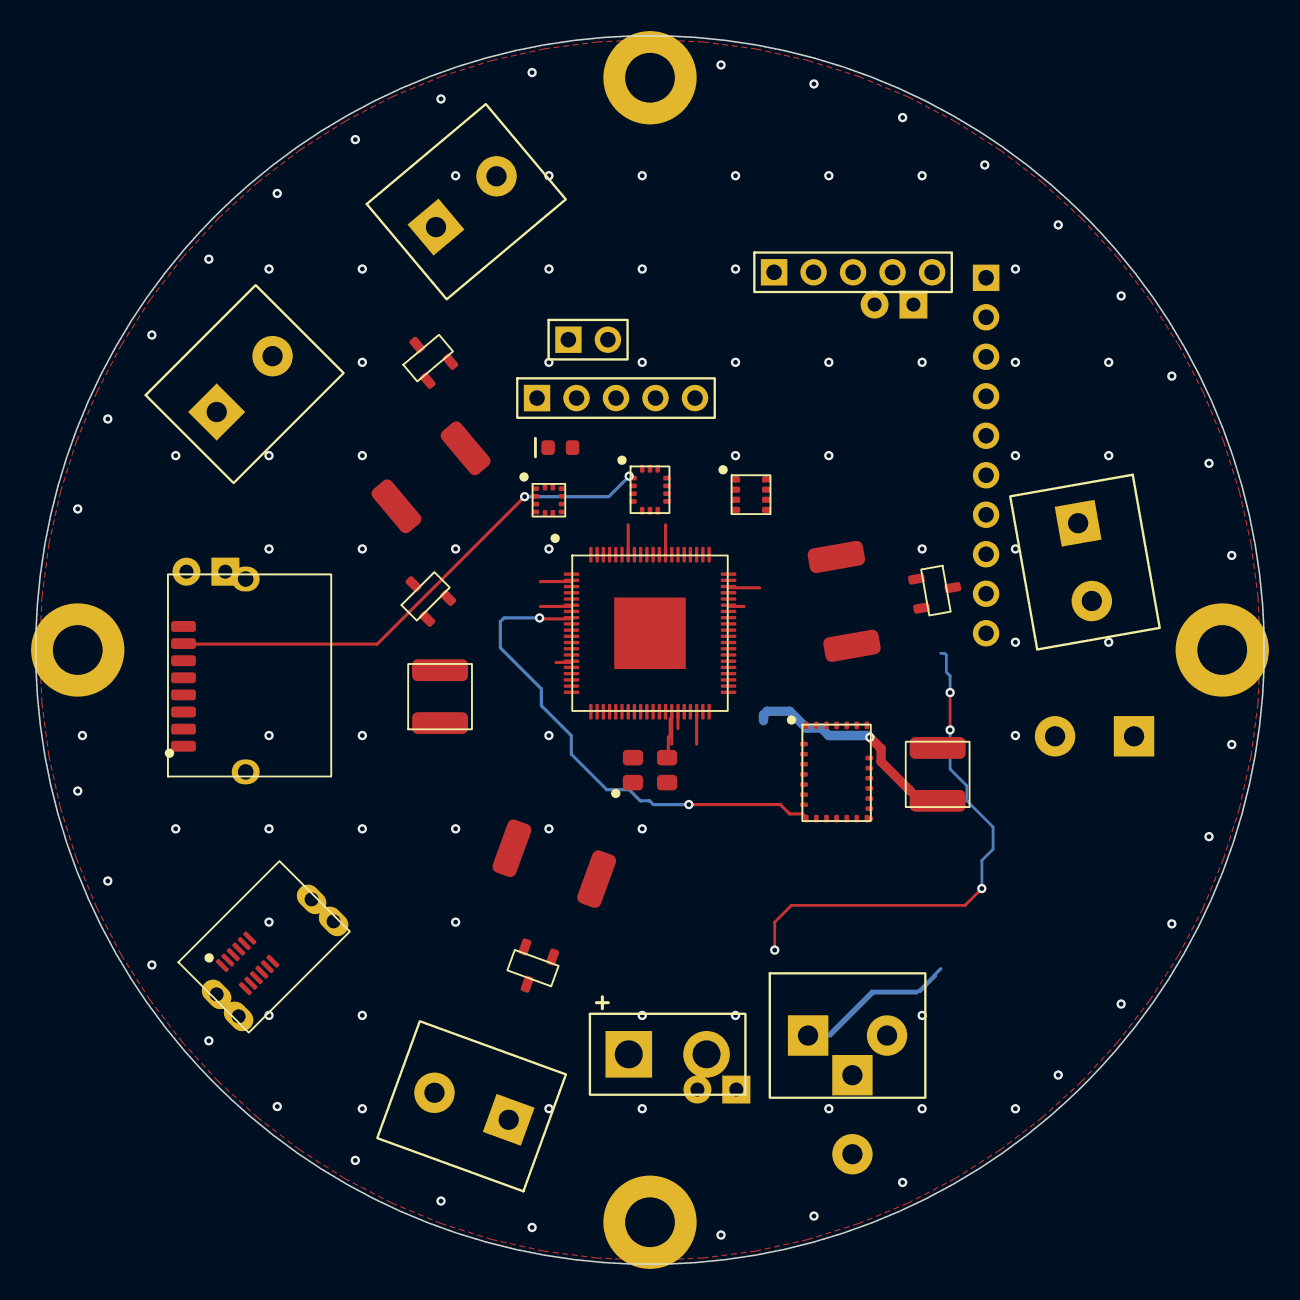
[picture p193: board WYVERN_E2_FCM.kicad_pcb from above]

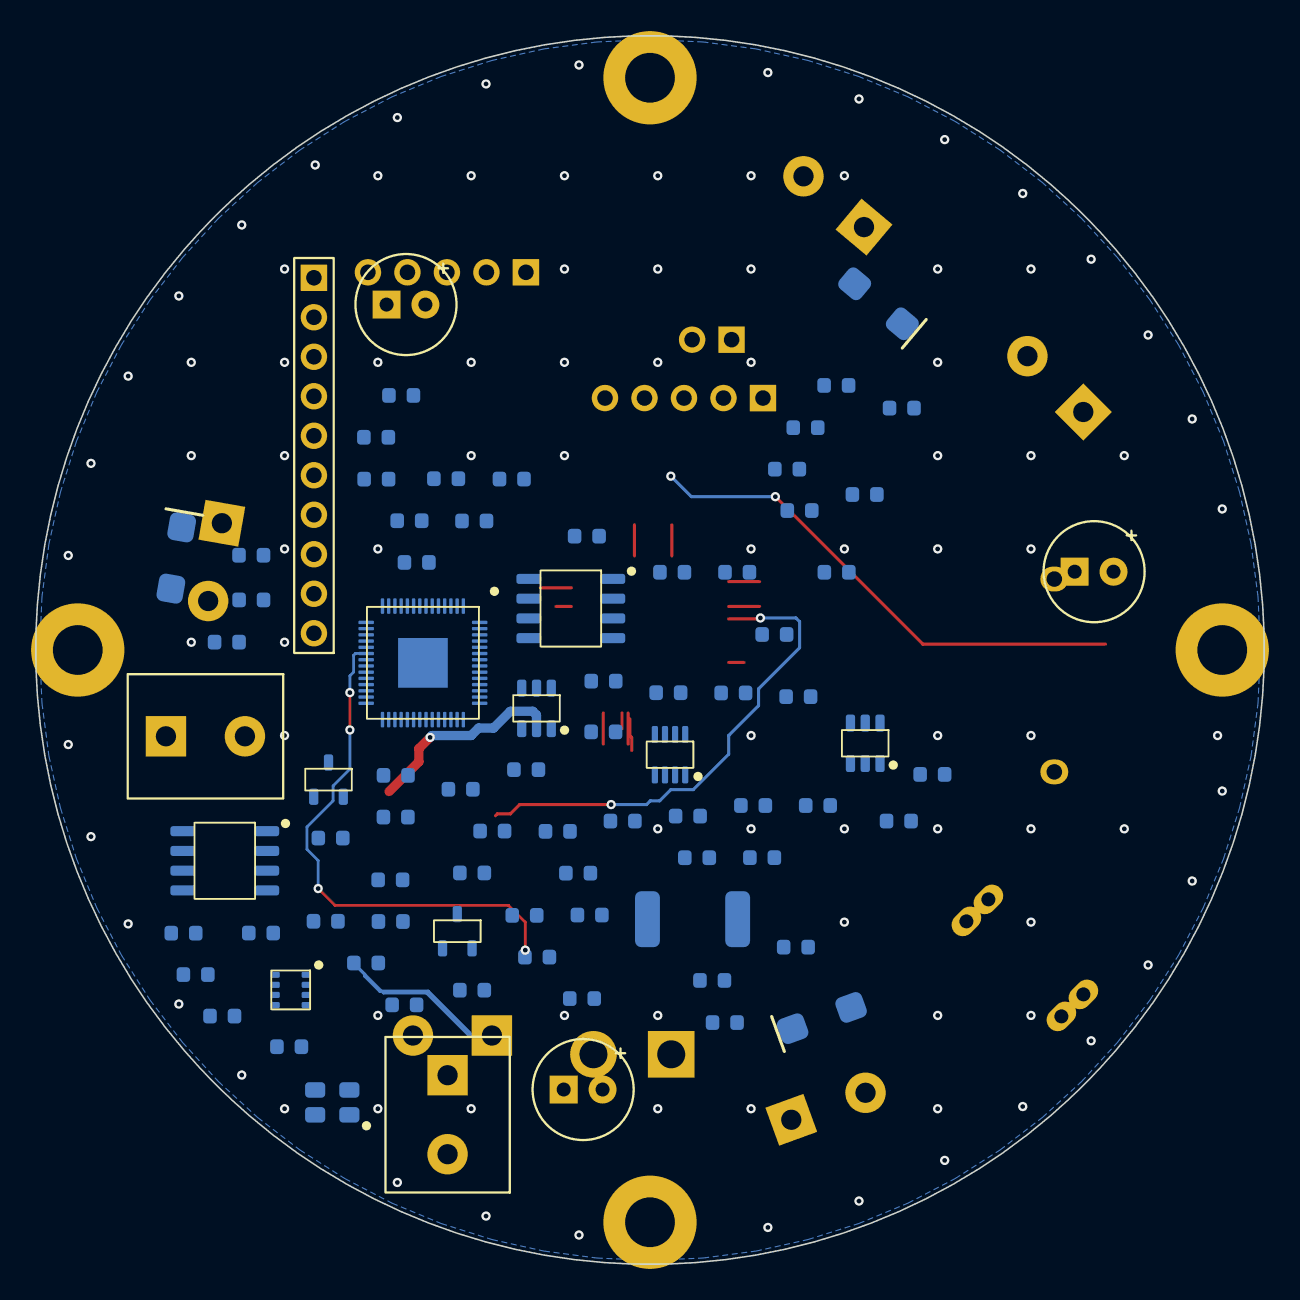
[picture p194: board WYVERN_E2_FCM.kicad_pcb from below]

Board: 4 copper layers, 79.0 x 79.0 mm, 113 parts (82 on the bottom side), 81 nets.

Parts:
C1, C2, C71, C72: 18pF; C_0603
C3, C10, C11, C12, C13, C14, C15, C16, C17, C20, C40, C41, C42, C70, C74, C75, C76, C77, C78, C79, C80: 100nF; C_0603
C30, C31, C32: 470uF; CP_Radial_D6.3mm_P2.50mm
C50, C73: 1uF; C_0603
D1, D2, D3: SS34; D_SMA
H1, H2, H3, H4: M3; MountingHole_M3
J1: SWD; PinHeader_1x05_P2.54mm
J2: USB-C; USB-C_Receptacle_2.0
J3: microSD; microSD_Push_Molex
J4: BNO055; PinHeader_1x10_P2.54mm
J5: VIBE; TerminalBlock_2P_5.08mm
J6: 12V NiCd; XT30_Male_Vertical
J7: SOL1; TerminalBlock_2P_5.08mm
J8: SOL2; TerminalBlock_2P_5.08mm
J9: SOL3; TerminalBlock_2P_5.08mm
J11: 2ND IGN; TerminalBlock_2P_5.08mm
J12: REED; PinHeader_1x02_P2.54mm
J14: DROGUE PYRO; TerminalBlock_2P_5.08mm
J15: MAIN PYRO; TerminalBlock_2P_5.08mm
J16: DEPLOY SWD; PinHeader_1x05_P2.54mm
L1, L2: 10uH; L_4x4mm
LED1: STAT; LED_0603
Q1, Q2, Q3, Q4, Q5, Q6: AO3400A; SOT-23
R1, R9, R11, R44, R60: 10k; R_0603
R2, R3: 5.1k; R_0603
R4, R5, R61, R62: 4.7k; R_0603
R6: 1M; R_0603
R7: 10m; R_2512_Shunt
R8: 45.3k; R_0603
R10: 73.2k; R_0603
R12, R21, R25, R29, R40, R41, R45, R46, R47, R49: 100k; R_0603
R13, R42, R48, R50: 18k; R_0603
R20, R24, R28: 100R; R_0603
R22, R26, R30, R43: 1k; R_0603
RS1, RS2, RS3: 20m; R_2512_Shunt
U1: RP2350B; QFN-80-1EP_10x10mm_P0.4mm
U2, U11: W25Q32JV; SOIC-8_3.9x4.9mm_P1.27mm
U4: ICM-42688-P; ICM-42688-P_LGA-14_2.5x3mm
U5, U12: BMP280; BME280_LGA-8_2.5x2.5mm
U6: LIS3MDL; LIS3MDL_LGA-12_2x2mm
U7: INA219; SOT-23-8
U8: TPS54202_3V3; SOT-23-6
U9: TPS54202_5V; SOT-23-6
U10: RP2040; QFN-56-1EP_7x7mm_P0.4mm
U13: BNO055; BNO055_LGA-28_3.8x5.2mm
X1, X2: 12MHz; Crystal_3225_4Pin

Connections:
+1V1: C50.1, C73.1, U1.18, U1.20, U1.60, U10.23, U10.45, U10.50
+3V3: C3.1, C10.1, C11.1, C12.1, C13.1, C14.1, C15.1, C16.1, C17.1, C20.1, C70.1, C74.1, C75.1, C76.1, C77.1, C78.1, C79.1, C80.1, J1.1, J3.4, J4.1, J4.2, J16.1, L1.2, R1.1, R4.1, R5.1, R8.1, R44.1, R60.1, R61.1, R62.1, U1.1, U1.11, U1.19, U1.21, U1.31, U1.39, U1.40, U1.41, U1.51, U1.61, U1.69, U1.70, U1.71, U1.78, U1.79, U1.80, U2.8, U4.5, U4.8, U5.1, U5.4, U5.6, U6.1, U6.5, U6.12, U7.4, U10.1, U10.10, U10.22, U10.33, U10.42, U10.43, U10.44, U10.48, U10.49, U11.8, U12.1, U12.4, U12.6, U13.1, U13.5, U13.13, U13.19, U13.26
+5V: L2.2, R10.1
BK3_FB: R8.2, R9.1, U8.4
BK3_SW: L1.1, U8.2
BK5_FB: R10.2, R11.1, U9.4
BK5_SW: L2.1, U9.2
BNO_INT: J4.7, U1.56
BNO_O_INT: U1.8, U13.8
CC1: J2.3, R2.1
CC2: J2.4, R3.1
DEP_ARM: U1.6, U10.7
DEP_I2C_SCL: R62.2, U10.12, U12.7
DEP_I2C_SDA: R61.2, U10.11, U12.3
DEP_QSPI_SCLK: U10.52, U11.6
DEP_QSPI_SD0: U10.53, U11.5
DEP_QSPI_SD1: U10.55, U11.2
DEP_QSPI_SD2: U10.54, U11.3
DEP_QSPI_SD3: U10.51, U11.7
DEP_QSPI_SS: U10.56, U11.1
DEP_RUN: J16.4, R60.2, U10.26
DEP_STATUS: U1.7, U10.9
DEP_SWCLK: J16.3, U10.24
DEP_SWD: J16.2, U10.25
DEP_UART_RX: U1.5, U10.3
DEP_UART_TX: U1.4, U10.2
DEP_XIN: C71.1, U10.20, X2.1
DEP_XOUT: C72.1, U10.21, X2.3
GND: C1.2, C2.2, C3.2, C10.2, C11.2, C12.2, C13.2, C14.2, C15.2, C16.2, C17.2, C20.2, C30.2, C31.2, C32.2, C40.2, C41.2, C42.2, C50.2, C70.2, C71.2, C72.2, C73.2, C74.2, C75.2, C76.2, C77.2, C78.2, C79.2, C80.2, J1.5, J2.2, J3.6, J4.3, J4.8, J4.9, J4.10, J5.2, J6.2, J12.2, J16.5, LED1.1, Q4.2, Q5.2, Q6.2, R2.2, R3.2, R6.2, R9.2, R11.2, R13.2, R21.2, R25.2, R29.2, R40.2, R42.2, R45.2, R46.2, R48.2, R50.2, RS1.2, RS2.2, RS3.2, U1.81, U2.4, U4.6, U4.7, U4.9, U5.2, U5.5, U5.8, U6.2, U6.3, U6.4, U6.8, U6.9, U6.10, U6.11, U7.3, U7.7, U7.8, U8.1, U9.1, U10.19, U10.57, U11.4, U12.2, U12.5, U12.8, U13.2, U13.3, U13.4, U13.9, U13.10, U13.11, U13.12, U13.14, U13.15, U13.16, U13.17, U13.18, U13.20, U13.21, U13.22, U13.23, U13.24, U13.25, U13.27, U13.28, X1.2, X1.4, X2.2, X2.4
I2C0_SCL: J4.5, R5.2, U1.47, U5.7, U6.6, U7.5, U13.6
I2C0_SDA: J4.4, R4.2, U1.46, U5.3, U6.7, U7.6, U13.7
IMU_CS: U1.17, U4.12
IMU_INT1: U1.55, U4.4
LED_R: LED1.2, R43.2
PYRO_DROG_CONT: R47.2, R48.1, U10.39
PYRO_DROG_D: J14.2, Q5.3, R47.1
PYRO_DROG_GATE: Q5.1, R45.1, U10.5
PYRO_IGN_CONT: R41.2, R42.1, U10.38
PYRO_IGN_D: J11.2, Q4.3, R41.1
PYRO_IGN_GATE: Q4.1, R40.1, U10.4
PYRO_MAIN_CONT: R49.2, R50.1, U10.40
PYRO_MAIN_D: J15.2, Q6.3, R49.1
PYRO_MAIN_GATE: Q6.1, R46.1, U10.6
QSPI_SCLK: U1.73, U2.6
QSPI_SD0: U1.74, U2.5
QSPI_SD1: U1.76, U2.2
QSPI_SD2: U1.75, U2.3
QSPI_SD3: U1.72, U2.7
QSPI_SS: U1.77, U2.1
REED: J12.1, R44.2, U1.57
RUN: J1.4, J4.6, R1.2, U1.32
SD_CS: J3.2, U1.23
SOL1_D: D1.1, J7.2, Q1.3
SOL1_G: Q1.1, R20.2, R21.1
SOL1_PWM: R20.1, U1.48
SOL1_SH: Q1.2, R22.1, RS1.1
SOL1_SNS: C40.1, R22.2, U1.59
SOL2_D: D2.1, J8.2, Q2.3
SOL2_G: Q2.1, R24.2, R25.1
SOL2_PWM: R24.1, U1.49
SOL2_SH: Q2.2, R26.1, RS2.1
SOL2_SNS: C41.1, R26.2, U1.62
SOL3_D: D3.1, J9.2, Q3.3
SOL3_G: Q3.1, R28.2, R29.1
SOL3_PWM: R28.1, U1.50
SOL3_SH: Q3.2, R30.1, RS3.1
SOL3_SNS: C42.1, R30.2, U1.63
SPI1_MISO: J3.7, U1.15, U4.1
SPI1_MOSI: J3.3, U1.14, U4.14
SPI1_SCK: J3.5, U1.13, U4.13
STATUS_LED: R43.1, U1.54
SWCLK: J1.3, U1.35
SWDIO: J1.2, U1.36
USB_DM: J2.6, U1.38
USB_DP: J2.5, U1.37
VBAT12: J6.1, J11.1, J14.1, J15.1, R7.1, R12.1, U7.1, U8.3, U9.3
VBAT_SENSE: R12.2, R13.1, U1.64
VIBE_SNS: J5.1, R6.1, U1.68
V_SOL: C30.1, C31.1, C32.1, D1.2, D2.2, D3.2, J7.1, J8.1, J9.1, R7.2, U7.2
XIN: C1.1, U1.33, X1.1
XOUT: C2.1, U1.34, X1.3
