swaroopsahoo4908/GTR70E-WYVERN/TVC ARCHIVED/Past Iterations/WYVERN-E 1.0/CAD:Models:PCB/XRIM117E_KiCAD_RevC/CCM_KiCAD_RevC/CCM_Central_Command_Module.kicad_pcb

## KiCad design TVC ARCHIVED/Past Iterations/WYVERN-E 1.0/CAD:Models:PCB/XRIM117E_KiCAD_RevC/CCM_KiCAD_RevC/CCM_Central_Command_Module.kicad_pcb (2026-10-18, an earlier design)

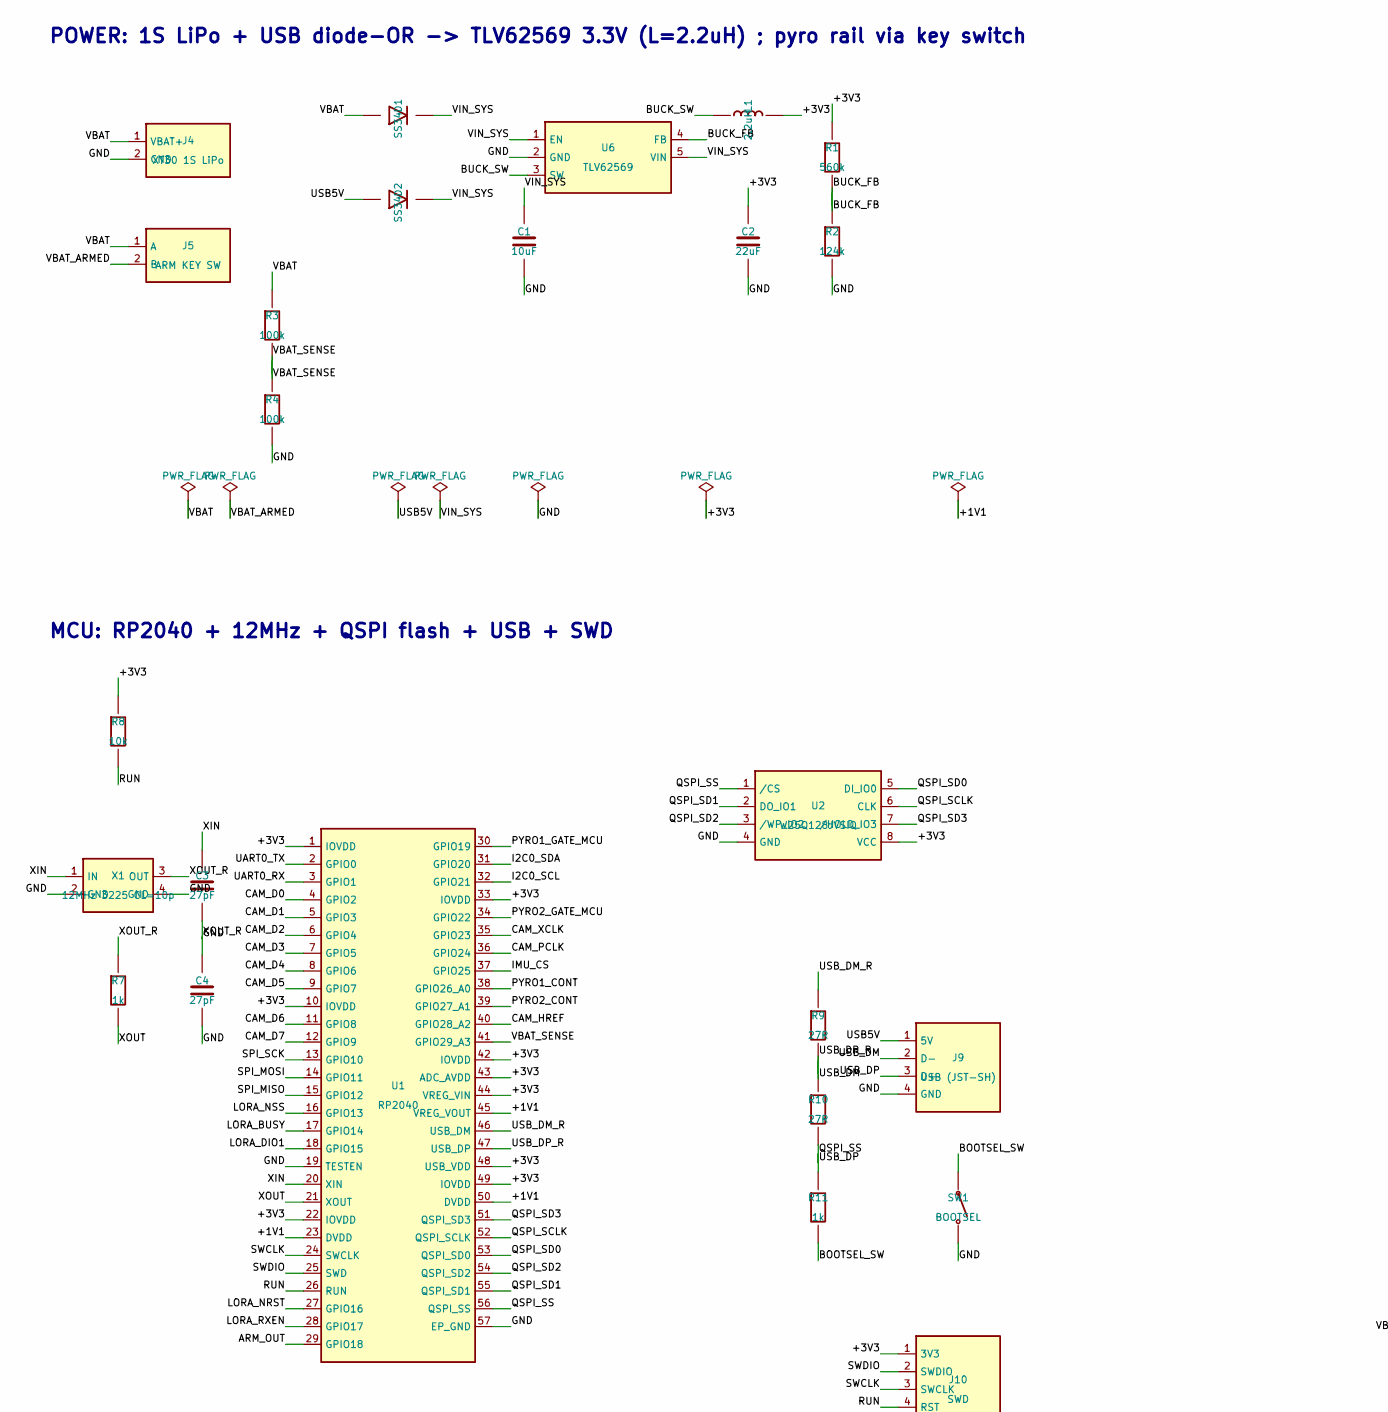
[picture p195: schematic CCM_Central_Command_Module.kicad_sch, XRIM-117E CCM - Central Command Module (PDR-003 Rev C, 127m…, part in row 1, column 1]

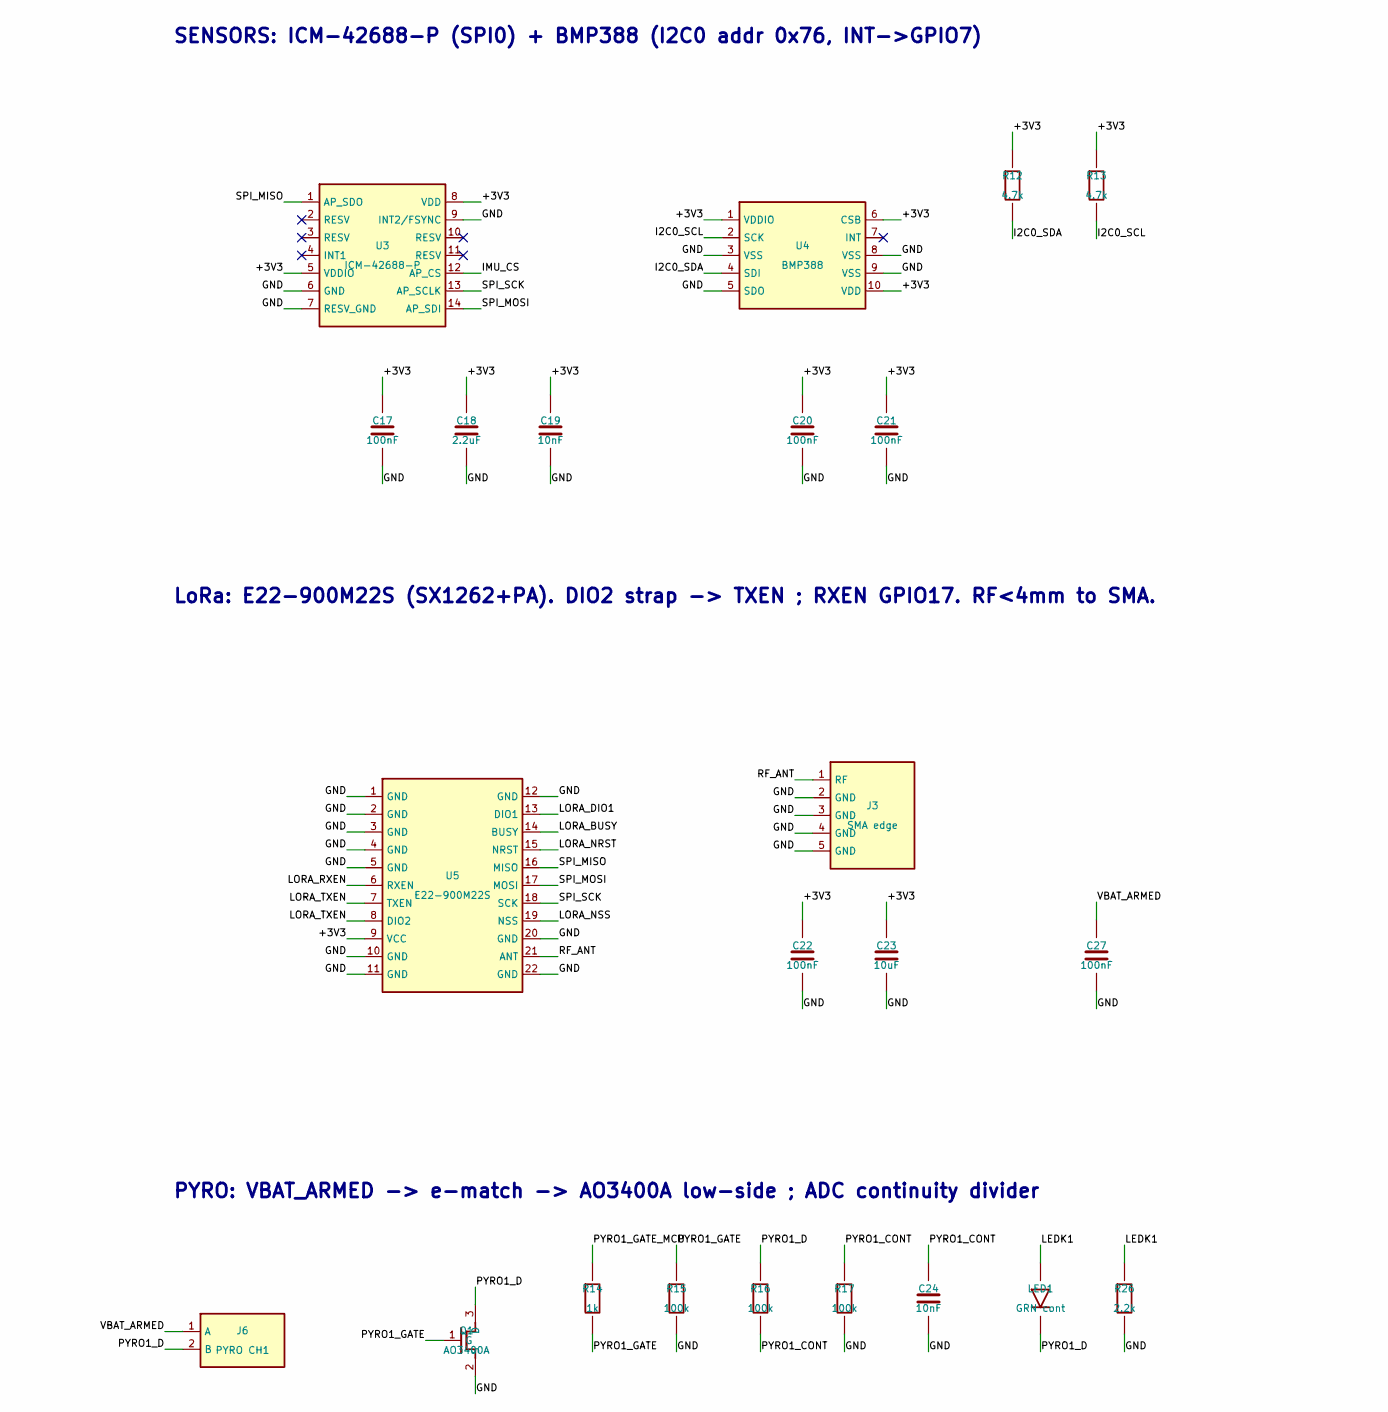
[picture p196: schematic CCM_Central_Command_Module.kicad_sch, XRIM-117E CCM - Central Command Module (PDR-003 Rev C, 127m…, part in row 1, column 2]

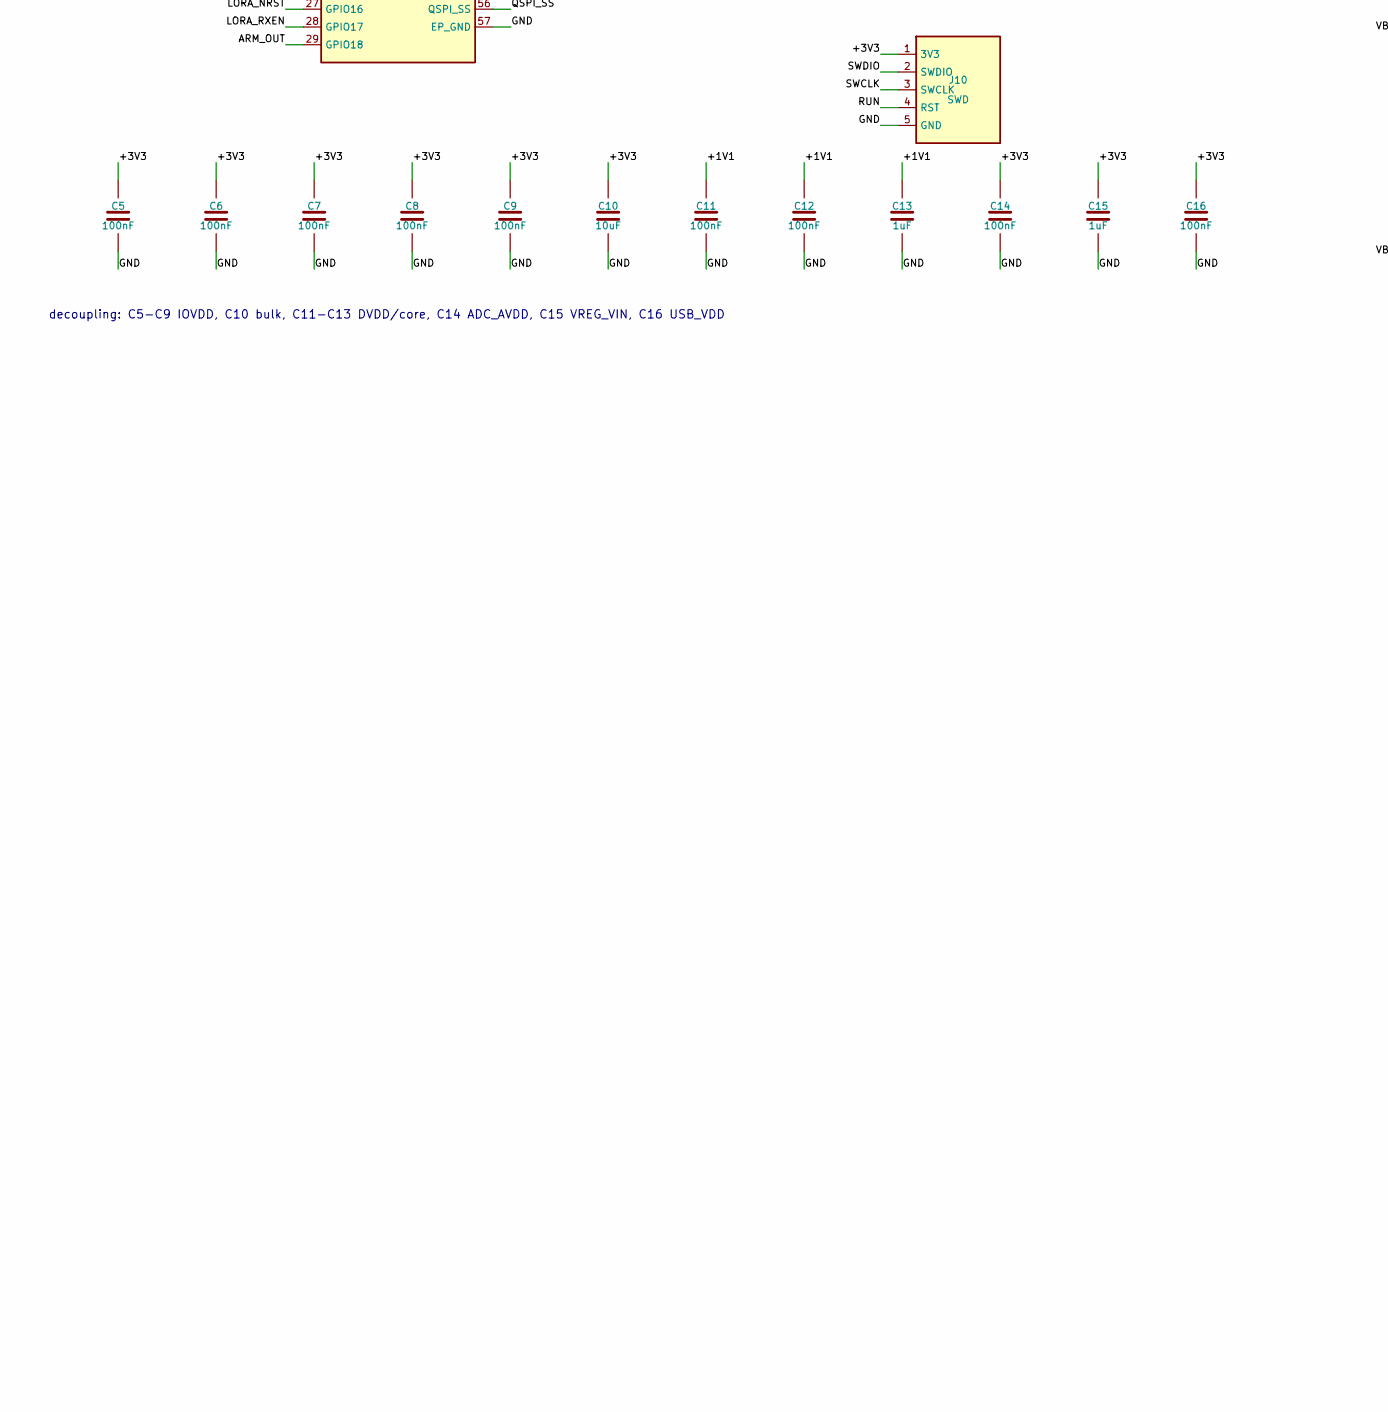
[picture p197: schematic CCM_Central_Command_Module.kicad_sch, XRIM-117E CCM - Central Command Module (PDR-003 Rev C, 127m…, part in row 2, column 1]

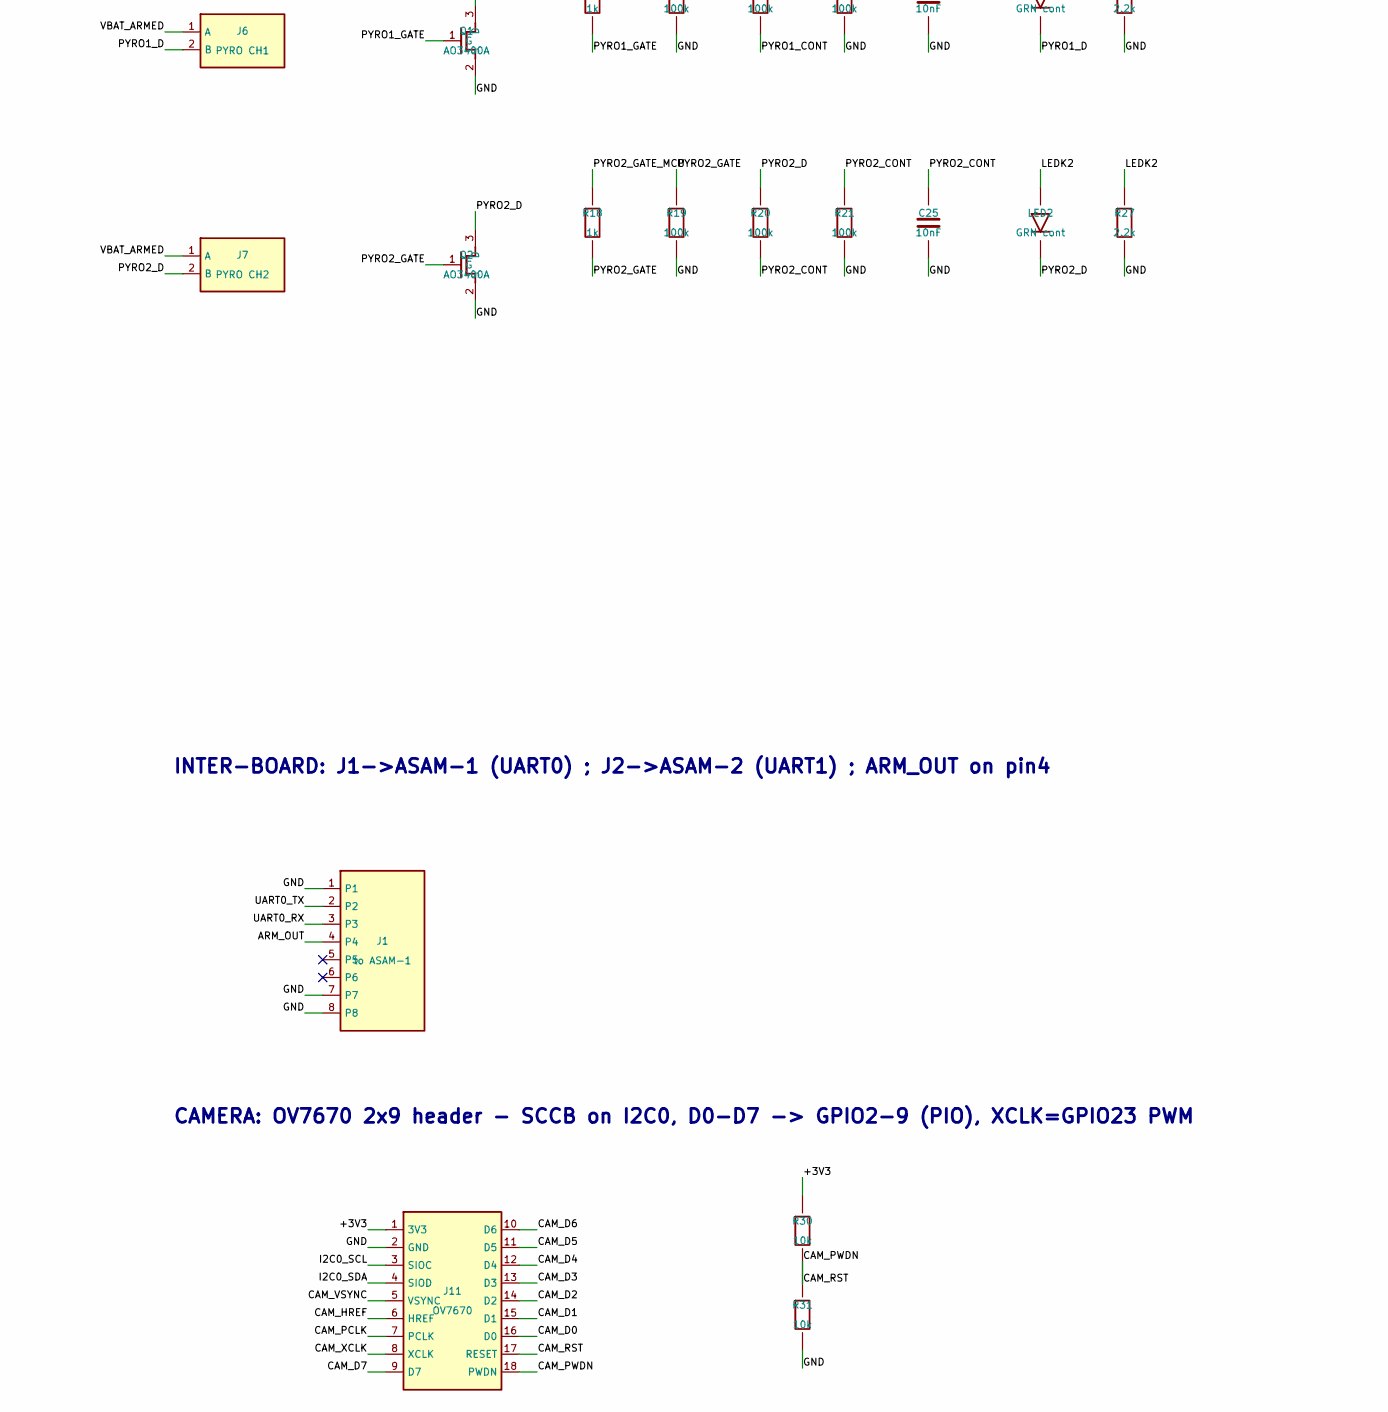
[picture p198: schematic CCM_Central_Command_Module.kicad_sch, XRIM-117E CCM - Central Command Module (PDR-003 Rev C, 127m…, part in row 2, column 2]

Parts:
C1, C10, C23: 10uF
C2: 22uF
C3, C4: 27pF
C5, C6, C7, C8, C9, C11, C12, C14, C16, C17, C20, C21, C22, C27: 100nF
C13, C15: 1uF
C18: 2.2uF
C19, C24, C25: 10nF
D1, D2: SS34; D_SMA
J1: to ASAM-1
J3: SMA edge
J4: XT30 1S LiPo
J5: ARM KEY SW
J6: PYRO CH1
J7: PYRO CH2
J9: USB (JST-SH)
J10: SWD
J11: OV7670
L1: 2.2uH; L_4x4mm
LED1, LED2: GRN cont
Q1, Q2: AO3400A
R1: 560k
R2: 124k
R3, R4, R15, R16, R17, R19, R20, R21: 100k
R7, R11, R14, R18: 1k
R8, R30, R31: 10k
R9, R10: 27R
R12, R13: 4.7k
R26, R27: 2.2k
SW1: BOOTSEL
U1: RP2040
U2: W25Q128JVSIQ
U3: ICM-42688-P
U4: BMP388
U5: E22-900M22S
U6: TLV62569
X1: 12MHz 3225 CL=10p

Connections:
+1V1: C11.1, C12.1, C13.1, U1.23 (DVDD), U1.45 (VREG_VOUT), U1.50 (DVDD)
+3V3: C2.1, C5.1, C6.1, C7.1, C8.1, C9.1, C10.1, C14.1, C15.1, C16.1, C17.1, C18.1, C19.1, C20.1, C21.1, C22.1, C23.1, J10.1 (3V3), J11.1 (3V3), L1.2, R1.1, R8.1, R12.1, R13.1, R30.1, U1.1 (IOVDD), U1.10 (IOVDD), U1.22 (IOVDD), U1.33 (IOVDD), U1.42 (IOVDD), U1.43 (ADC_AVDD), U1.44 (VREG_VIN), U1.48 (USB_VDD), U1.49 (IOVDD), U2.8 (VCC), U3.5 (VDDIO), U3.8 (VDD), U4.1 (VDDIO), U4.6 (CSB), U4.10 (VDD), U5.9 (VCC)
ARM_OUT: J1.4, U1.29 (GPIO18)
BOOTSEL_SW: R11.2, SW1.1
BUCK_FB: R1.2, R2.1, U6.4 (FB)
BUCK_SW: L1.1, U6.3 (SW)
CAM_D0: J11.16 (D0), U1.4 (GPIO2)
CAM_D1: J11.15 (D1), U1.5 (GPIO3)
CAM_D2: J11.14 (D2), U1.6 (GPIO4)
CAM_D3: J11.13 (D3), U1.7 (GPIO5)
CAM_D4: J11.12 (D4), U1.8 (GPIO6)
CAM_D5: J11.11 (D5), U1.9 (GPIO7)
CAM_D6: J11.10 (D6), U1.11 (GPIO8)
CAM_D7: J11.9 (D7), U1.12 (GPIO9)
CAM_HREF: J11.6 (HREF), U1.40 (GPIO28_A2)
CAM_PCLK: J11.7 (PCLK), U1.36 (GPIO24)
CAM_PWDN: J11.18 (PWDN), R31.1
CAM_RST: J11.17 (RESET), R30.2
CAM_VSYNC: J11.5 (VSYNC)
CAM_XCLK: J11.8 (XCLK), U1.35 (GPIO23)
I2C0_SCL: J11.3 (SIOC), R13.2, U1.32 (GPIO21), U4.2 (SCK)
I2C0_SDA: J11.4 (SIOD), R12.2, U1.31 (GPIO20), U4.4 (SDI)
IMU_CS: U1.37 (GPIO25), U3.12 (AP_CS)
LEDK1: LED1.1, R26.1
LEDK2: LED2.1, R27.1
LORA_BUSY: U1.17 (GPIO14), U5.14 (BUSY)
LORA_DIO1: U1.18 (GPIO15), U5.13 (DIO1)
LORA_NRST: U1.27 (GPIO16), U5.15 (NRST)
LORA_NSS: U1.16 (GPIO13), U5.19 (NSS)
LORA_RXEN: U1.28 (GPIO17), U5.6 (RXEN)
LORA_TXEN: U5.7 (TXEN), U5.8 (DIO2)
PYRO1_CONT: C24.1, R16.2, R17.1, U1.38 (GPIO26_A0)
PYRO1_D: J6.2 (B), LED1.2, Q1.3 (D), R16.1
PYRO1_GATE: Q1.1 (G), R14.2, R15.1
PYRO1_GATE_MCU: R14.1, U1.30 (GPIO19)
PYRO2_CONT: C25.1, R20.2, R21.1, U1.39 (GPIO27_A1)
PYRO2_D: J7.2 (B), LED2.2, Q2.3 (D), R20.1
PYRO2_GATE: Q2.1 (G), R18.2, R19.1
PYRO2_GATE_MCU: R18.1, U1.34 (GPIO22)
QSPI_SCLK: U1.52 (QSPI_SCLK), U2.6 (CLK)
QSPI_SD0: U1.53 (QSPI_SD0), U2.5 (DI_IO0)
QSPI_SD1: U1.55 (QSPI_SD1), U2.2 (DO_IO1)
QSPI_SD2: U1.54 (QSPI_SD2), U2.3 (/WP_IO2)
QSPI_SD3: U1.51 (QSPI_SD3), U2.7 (/HOLD_IO3)
RF_ANT: J3.1 (RF), U5.21 (ANT)
RUN: J10.4 (RST), R8.2, U1.26 (RUN)
SPI_MISO: U1.15 (GPIO12), U3.1 (AP_SDO), U5.16 (MISO)
SPI_MOSI: U1.14 (GPIO11), U3.14 (AP_SDI), U5.17 (MOSI)
SPI_SCK: U1.13 (GPIO10), U3.13 (AP_SCLK), U5.18 (SCK)
SWCLK: J10.3 (SWCLK), U1.24 (SWCLK)
SWDIO: J10.2 (SWDIO), U1.25 (SWD)
UART0_RX: J1.3, U1.3 (GPIO1)
UART0_TX: J1.2, U1.2 (GPIO0)
USB5V: D2.1, J9.1 (5V)
USB_DM: J9.2 (D-), R9.2
USB_DM_R: R9.1, U1.46 (USB_DM)
USB_DP_R: R10.1, U1.47 (USB_DP)
VBAT: D1.1, J4.1 (VBAT+), J5.1 (A), R3.1
VBAT_ARMED: C27.1, J5.2 (B), J6.1 (A), J7.1 (A)
VBAT_SENSE: R3.2, R4.1, U1.41 (GPIO29_A3)
VIN_SYS: C1.1, D1.2, D2.2, U6.1 (EN), U6.5 (VIN)
XIN: C3.1, U1.20 (XIN), X1.1 (IN)
XOUT: R7.2, U1.21 (XOUT)

Notes on the sheet:
POWER: 1S LiPo + USB diode-OR -> TLV62569 3.3V (L=2.2uH) ; pyro rail via key switch
MCU: RP2040 + 12MHz + QSPI flash + USB + SWD
decoupling: C5-C9 IOVDD, C10 bulk, C11-C13 DVDD/core, C14 ADC_AVDD, C15 VREG_VIN, C16 USB_VDD
SENSORS: ICM-42688-P (SPI0) + BMP388 (I2C0 addr 0x76, INT->GPIO7)
LoRa: E22-900M22S (SX1262+PA). DIO2 strap -> TXEN ; RXEN GPIO17. RF<4mm to SMA.
PYRO: VBAT_ARMED -> e-match -> AO3400A low-side ; ADC continuity divider
INTER-BOARD: J1->ASAM-1 (UART0) ; J2->ASAM-2 (UART1) ; ARM_OUT on pin4
CAMERA: OV7670 2x9 header - SCCB on I2C0, D0-D7 -> GPIO2-9 (PIO), XCLK=GPIO23 PWM

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
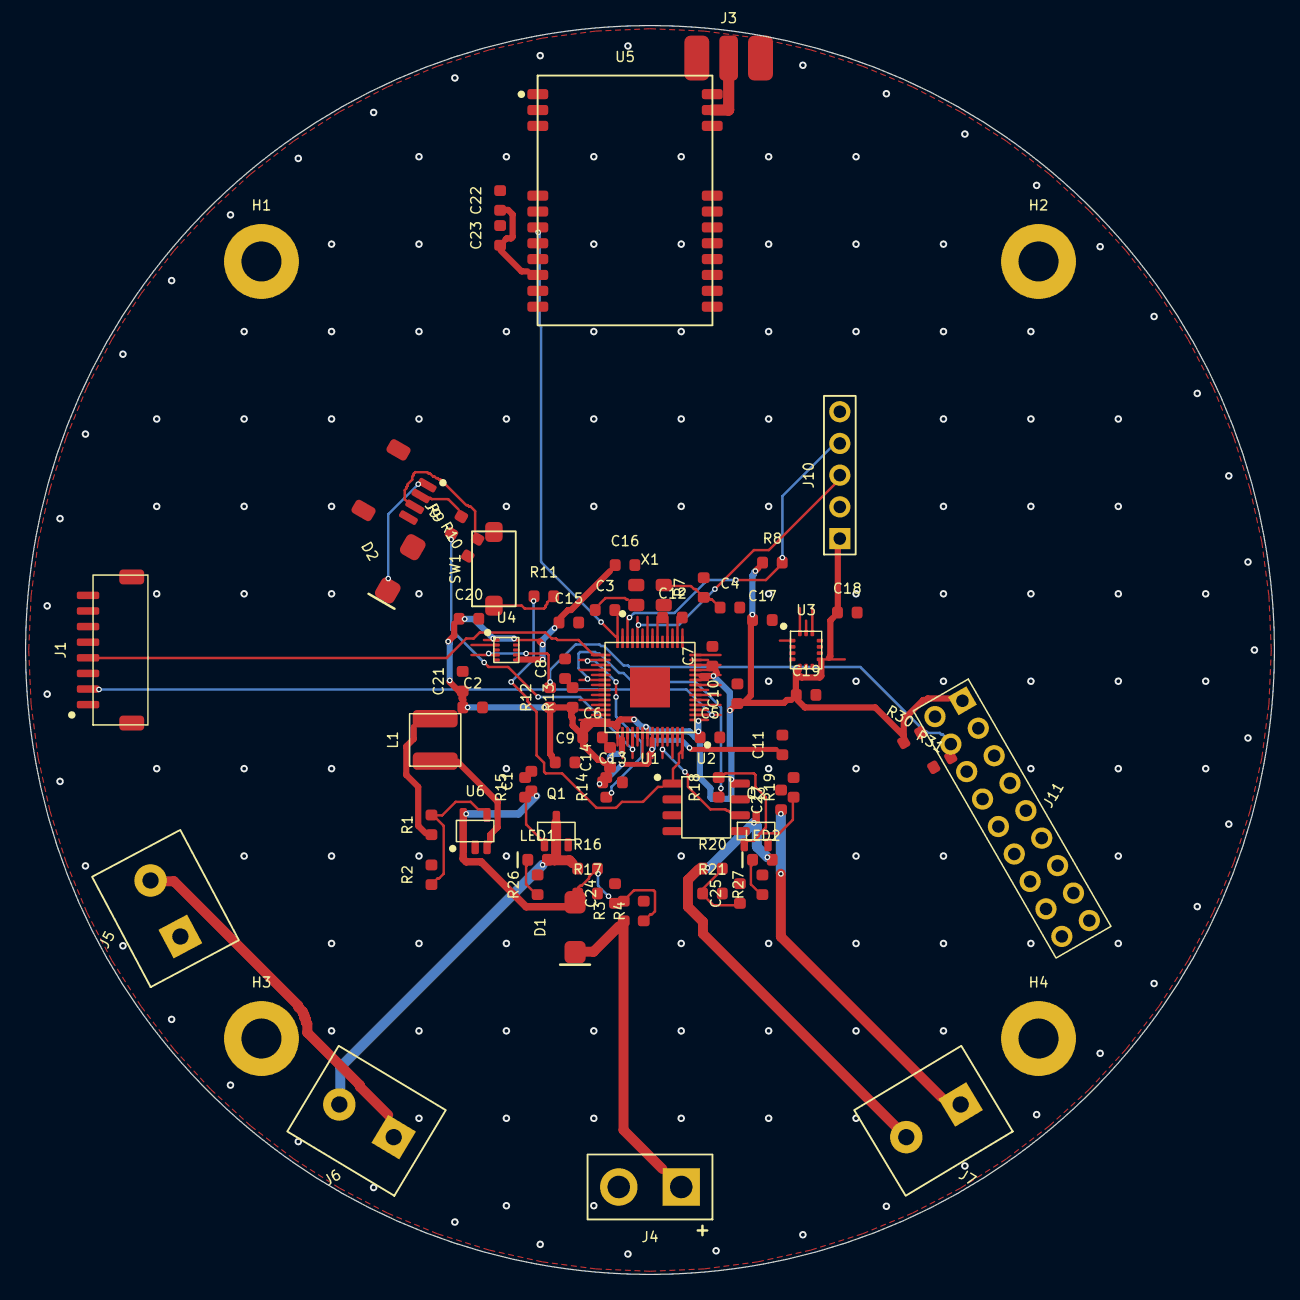
[picture p199: board TVC ARCHIVED/Past Iterations/WYVERN-E 1.0/CAD:Models:PCB/XRIM117E_KiC… from above]

Board: 2 copper layers, 100.0 x 100.0 mm, 77 parts (0 on the bottom side), 66 nets.

Other parts of the board:
H1, H2, H3, H4: M3; MountingHole_M3
