swaroopsahoo4908/GTR70E-WYVERN/TVC ARCHIVED/Past Iterations/WYVERN-E 1.0/CAD:Models:PCB/CCM_KiCAD/CCM_Central_Command_Module.kicad_pcb

## KiCad design TVC ARCHIVED/Past Iterations/WYVERN-E 1.0/CAD:Models:PCB/CCM_KiCAD/CCM_Central_Command_Module.kicad_pcb (2026-10-18, an earlier design)

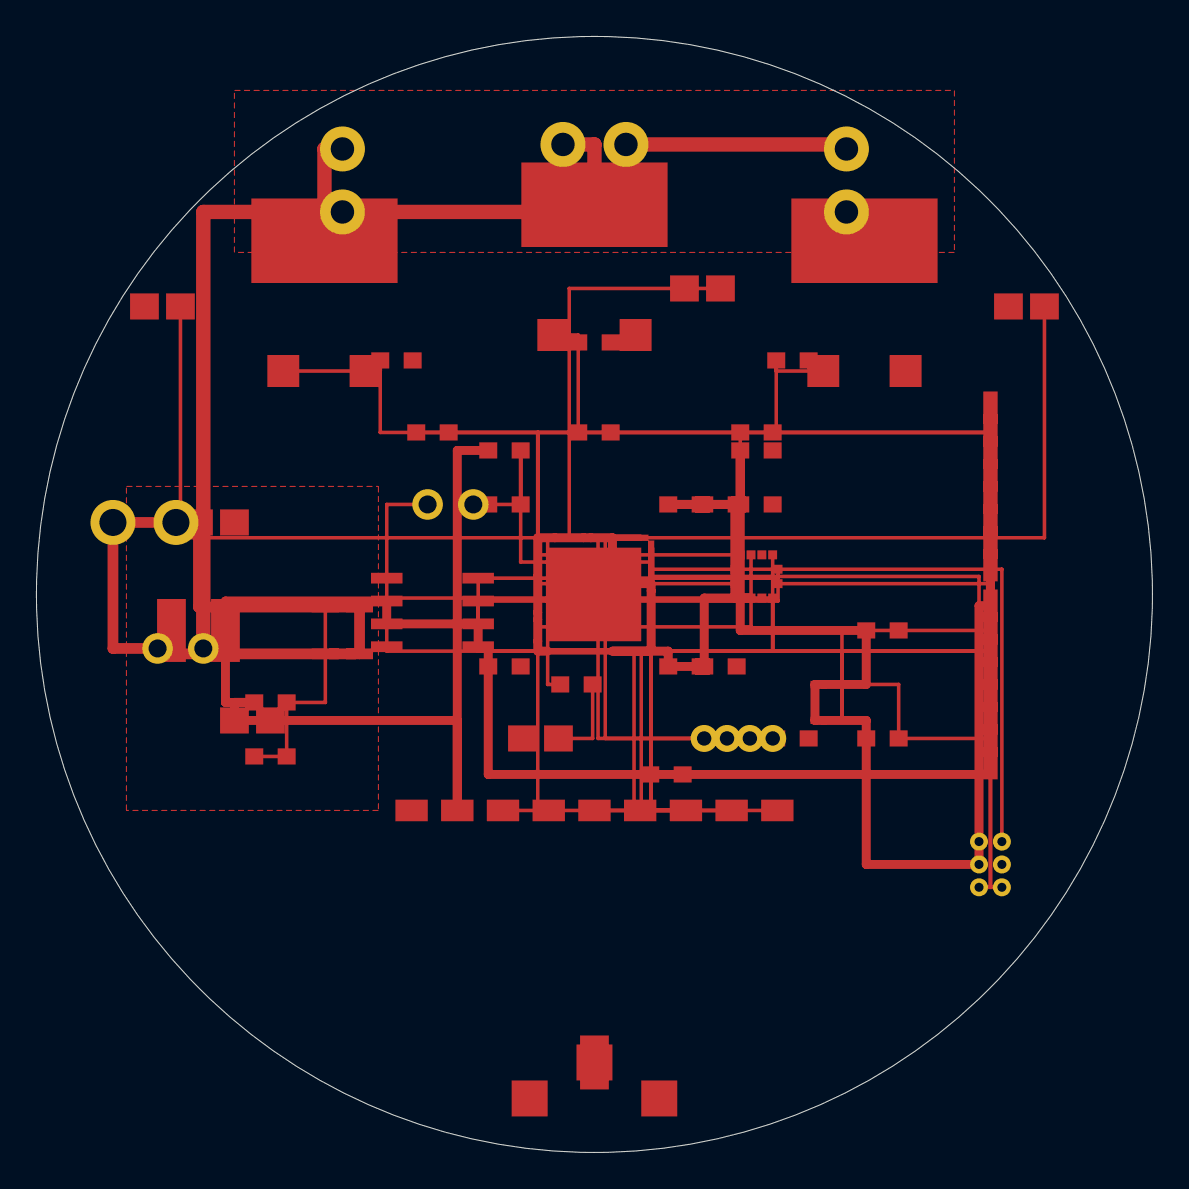
[picture p200: board TVC ARCHIVED/Past Iterations/WYVERN-E 1.0/CAD:Models:PCB/CCM_KiCAD/CC… from above]

Board: 2 copper layers, 62.0 x 62.0 mm, 49 parts (0 on the bottom side), 45 nets.

Parts:
C1: 47uF 10V; C_0805_2012Metric
C2: 22uF 6.3V; C_0805_2012Metric
C10, C12, C13, C14, C15, C20, C21, C30, C31: 100nF; C_0402_1005Metric
C11: 10uF; C_0402_1005Metric
J1, J2: JST-GH-8; JST_GH_SM08B-GHS-TB_1x08-1MP_P1.25mm_Horizontal
J3: SMA_Edge; SMA_Molex_0732511150_Horizontal
J4: XT30-M; PinHeader_1x02_P2.54mm_Vertical
J5: SW_2pin; PinHeader_1x02_P2.54mm_Vertical
J6, J7, J8: Screw_2; TerminalBlock_bornier-2_P3.5mm
J9: USB_TP; PinHeader_1x04_P1.27mm_Vertical
L1: 2.2uH; L_1210_3225Metric
LED1, LED2, LED3: Cont LED; LED_0805_2012Metric
LED4: Status; LED_0805_2012Metric
Q1, Q2, Q3: IRFZ44N; TO-263-3_TabEP
R1, R23, R24, R25: 10k; R_0402_1005Metric
R10, R11: 4.7k; R_0402_1005Metric
R20, R21, R22: 100R; R_0402_1005Metric
R26: 453k; R_0402_1005Metric
R27: 100k; R_0402_1005Metric
R28: 330R; R_0402_1005Metric
SW1: TC2030-SWD; TC2030-IDC-FP_2x03_P1.27mm_Vertical
SW_BOOT: SW_2pin; PinHeader_1x02_P2.54mm_Vertical
U1: RP2040; QFN-56-1EP_7x7mm_P0.4mm
U2: W25Q128; SOIC-8_3.9x4.9mm_P1.27mm
U3: ICM-42688-P; InvenSense_ICM-42688-P_LGA-14
U4: BMP388; Bosch_LGA-8_2x2.5mm
U5: E22-900M22S; Ebyte_E22-900M22S
U6: TLV62569; SOT-23-5

Connections:
+3V3: C2.1, C10.1, C11.1, C13.1, C14.1, C15.1, C20.1, C21.1, C30.1, J1.1, J2.1, L1.2, R1.1, R10.1, R11.1, R26.1, SW1.3, U1.1, U1.10, U1.22, U1.23, U1.33, U1.36, U1.37, U1.41, U1.47, U1.52, U1.53, U1.56, U2.3, U2.7, U2.8, U3.1, U3.2, U3.12, U4.1, U4.2, U4.7, U5.8
BUCK_SW: L1.1, U6.1
FB_3V3: R26.2, R27.1, U6.5
FLASH_CS: SW_BOOT.1, U1.8, U2.1
GND: C1.2, C2.2, C10.2, C11.2, C12.2, C13.2, C14.2, C15.2, C20.2, C21.2, C30.2, C31.2, J1.2, J2.2, J3.2, J3.3, J4.2, J9.1, LED1.K, LED2.K, LED3.K, LED4.K, Q1.2, Q2.2, Q3.2, R23.2, R24.2, R25.2, R27.2, SW1.4, SW_BOOT.2, U1.9, U1.19, U1.20, U1.21, U1.27, U1.28, U1.29, U1.30, U1.31, U1.32, U1.43, U1.49, U1.50, U1.55, U1.EP, U2.4, U3.3, U3.8, U3.11, U4.3, U4.6, U4.8, U5.9, U6.2
I2C0_SCL: J1.6, J2.6, R11.2, U1.12, U4.4
I2C0_SDA: J1.5, J2.5, R10.2, U1.11, U4.5
IMU_CS: U1.7, U3.7
IMU_INT1: U1.54, U3.9
IMU_INT2: U1.48, U3.10
LED_MCU: R28.1, U1.42
LED_STATUS: LED4.A, R28.2
LORA_BUSY: U1.17, U5.5
LORA_CS: U1.16, U5.4
LORA_IRQ: U1.18, U5.6
LORA_MISO: U1.15, U5.3
LORA_MOSI: U1.14, U5.2
LORA_NRST: U1.51, U5.7
LORA_SCK: U1.13, U5.1
NRST: C12.1, R1.2, U1.26
PYRO1_CONT: LED1.A, U1.40
PYRO1_D: J6.2, Q1.EP
PYRO1_GATE: J1.8, Q1.1, R20.2, R23.1
PYRO1_MCU: R20.1, U1.46
PYRO2_CONT: LED2.A, U1.39
PYRO2_D: J7.2, Q2.EP
PYRO2_GATE: J2.8, Q2.1, R21.2, R24.1
PYRO2_MCU: R21.1, U1.45
PYRO3_CONT: LED3.A, U1.38
PYRO3_D: J8.2, Q3.EP
PYRO3_GATE: Q3.1, R22.2, R25.1
PYRO3_MCU: R22.1, U1.44
RF_ANT: J3.1, U5.10
SPI0_MISO: U1.6, U2.2, U3.4
SPI0_MOSI: U1.5, U2.5, U3.6
SPI0_SCK: J1.7, J2.7, U1.4, U2.6, U3.5
SWCLK: SW1.1, U1.24
SWDIO: SW1.2, U1.25
UART0_RX: J1.4, J2.4, SW1.6, U1.3
UART0_TX: J1.3, J2.3, SW1.5, U1.2
USB5V: C31.1, J9.4
USB_DM: J9.2, U1.34
USB_DP: J9.3, U1.35
VBAT: C1.1, J4.1, J5.1, U6.3, U6.4
VBAT_ARMED: J5.2, J6.1, J7.1, J8.1
