swaroopsahoo4908/GTR70E-WYVERN/TVC ARCHIVED/Past Iterations/WYVERN-E KiCad/FC70/WYVERN-E_FC70.kicad_pcb

## KiCad design TVC ARCHIVED/Past Iterations/WYVERN-E KiCad/FC70/WYVERN-E_FC70.kicad_pcb (2026-10-18, an earlier design)

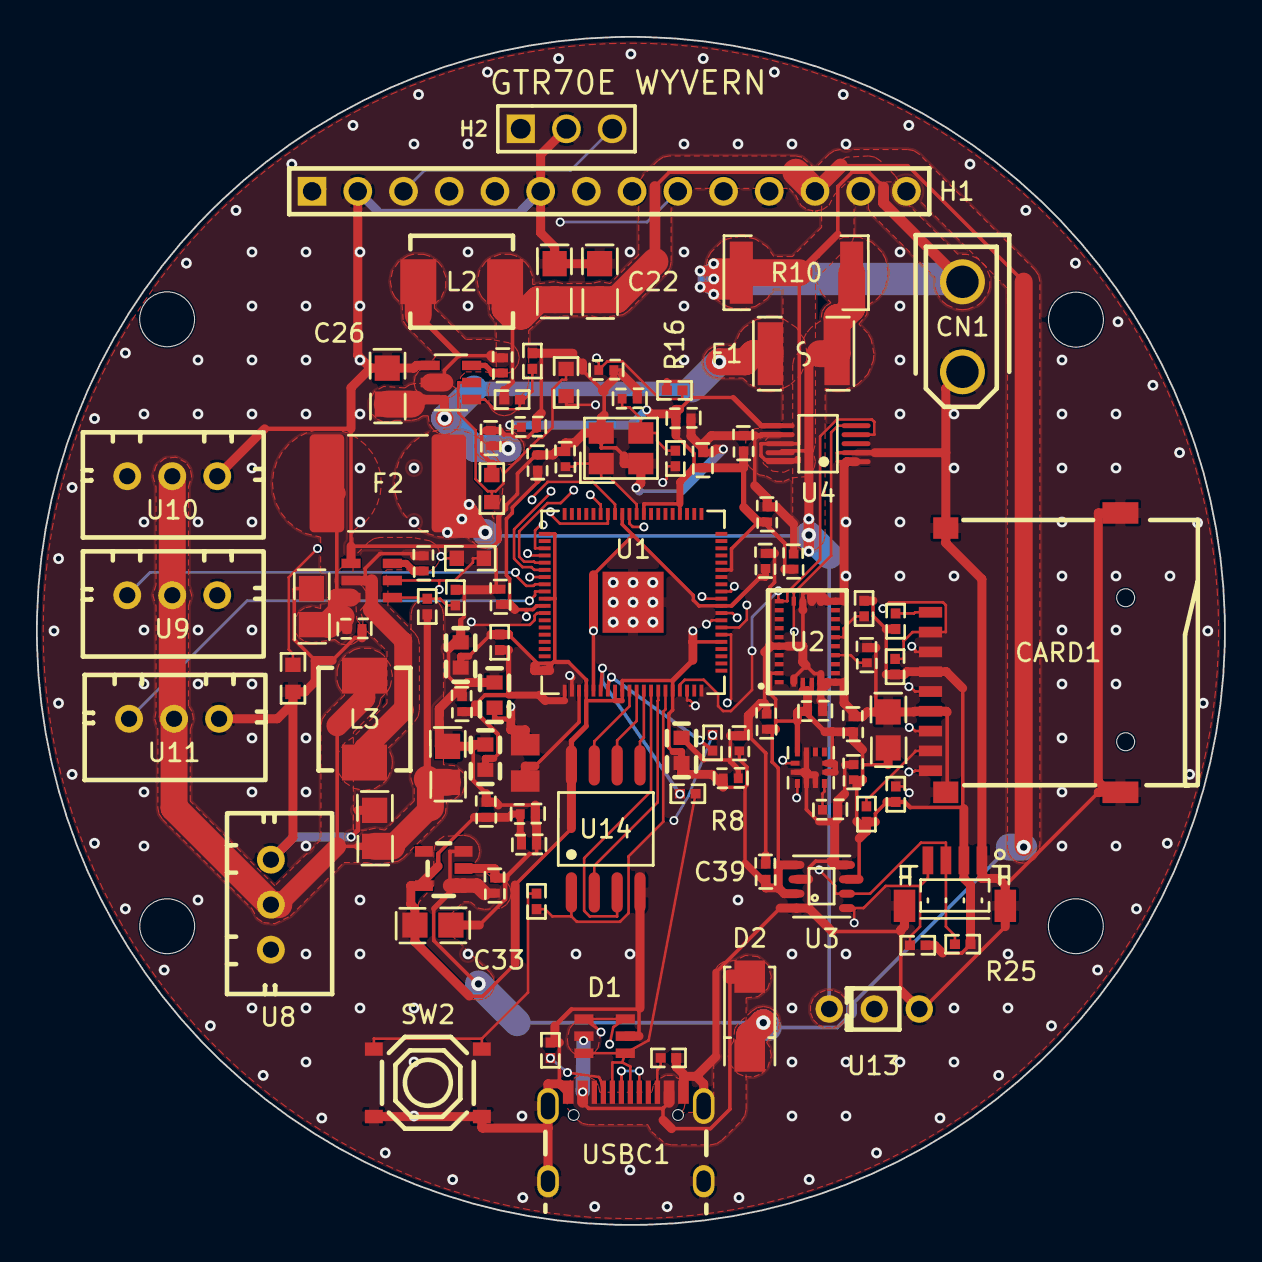
[picture p201: board WYVERN-E_FC70.kicad_pcb from above]

Board: 4 copper layers, 66.0 x 66.0 mm, 99 parts (0 on the bottom side), 61 nets.

Parts:
C1, C2: 15pF; C0402
C3, C4, C5, C34: 4.7uF; C0603
C6, C7, C8, C9, C10, C11, C12, C13, C14, C15, C16, C17, C18, C19, C20, C23, C24, C25, C27, C28, C30, C36, C37, C38, C39, C40, C41: 100nF; C0402
C21: 22uF; C0805_v2
C22, C31, C32: 22uF; C0805
C26, C29: 10uF 25V; C0805
C33, C35: 10uF; C0805
C42: 1uF; C0402
CARD1: TF-01A; TF-SMD_TF-01A
CN1: XT30UPB-M; CONN-TH_XT30UPB-M
CN2: BM04B-SRSS-TB; CONN-SMD_BM04B-SRSS-TB
D1: USBLC6-2SC6; SOT-23-6_L2.9-W1.6-P0.95-LS2.8-BL
D2: SS14; SMA_L4.4-W2.6-LS5.0-RD
F1: 2.6A PTC; F1812
F2: 3A PTC; Fuse_2920_7451Metric
H1: 1x14 2.54; HDR-TH_14P-P2.54-V-M_4
H2: SWD 1x3; HDR-TH_3P-P2.54-V-M-1
L1: 3.3uH; IND-SMD_L2.0-W1.6_AOTA-B201610S3R3-101-T
L2, L3: 3.3uH; IND-SMD_L5.7-W5.1
MH1, MH2, MH3, MH4: MountingHole
R1, R11: 1k; R0402
R2: 33; R0402
R5, R22: 56k; R0402
R6, R9, R16, R18, R19, R20, R21, R23: 10k; R0402
R7, R8: 27; R0402
R10: 10mΩ 2W; R2512
R12, R13: 5.1k; R0402
R14, R24: 100k; R0603
R15, R17: 33k; R0603
R25, R26: 4.7k; R0402
SW2: BOOTSEL; SW-SMD_4P-L5.1-W5.1-P3.70-LS6.5-TL_H1.5
U1: RP2350B; QFN-80_L10.0-W10.0-P0.40-TL-EP3.4
U2: BNO055; LGA-28_L5.2-W3.8-P0.50-BL
U3: BME680; LGA-8_L3.0-W3.0-P0.80-TR
U4: INA226; MSOP-10_L3.0-W3.0-P0.50-LS5.0-BL
U5: LIS3MDL; LGA-12_L2.0-W2.0-P0.50-BL
U6: TPS564201; SOT-23-6_L2.9-W1.6-P0.95-LS2.8-BL
U7: AP2112K-3.3; SOT-23-5_L2.9-W1.6-P0.95-LS2.8-BR
U8, U9, U10, U11: B3B-XH-A; CONN-TH_3P-P2.50_A2501WV2-3P
U12: 12MHz; CRYSTAL-SMD_4P-L3.2-W2.5-BL
U13: SS-12D00-G3; SW-TH_3P-L8.8-W3.9-P2.50_SS12D00G3
U14: W25Q128JVSIQ; SOIC-8_L5.3-W5.3-P1.27-LS8.0-BL
U15: TPS564201; SOT-23-6_L2.9-W1.6-P0.95-LS2.8-BL_v2
USBC1: TYPE-C-31-M-12; USB-C_SMD-TYPE-C-31-M-12_1

Connections:
+1V1_DVDD: C17.1, C19.1, C20.1, C34.1, L1.2, U1.10, U1.32, U1.51, U1.65
+3V3: C4.1, C5.1, C8.1, C9.1, C10.1, C11.1, C12.1, C13.1, C14.1, C15.1, C16.1, C18.1, C23.1, C24.1, C33.1, C35.1, C36.1, C37.1, C38.1, C39.1, CARD1.4, CN2.2, H1.1, H1.5, R2.2, R9.2, R16.1, R18.1, R19.1, R20.1, R21.1, R25.2, R26.2, U1.5, U1.15, U1.24, U1.29, U1.41, U1.50, U1.59, U1.60, U1.64, U1.68, U1.69, U1.76, U2.3, U2.4, U2.28, U3.2, U3.6, U3.8, U4.6, U5.5, U5.6, U5.10, U7.5, U14.8
+5V: C21.1, C22.1, C42.1, D2.1, H1.12, L2.2, R5.1, U7.1, U7.3
BOOTSEL_R: R11.2, SW2.1, SW2.2
BUCK5_BST: C6.1, U15.6
BUCK5_EN: R14.2, R15.1, U15.5
BUCK5_FB: R5.2, R6.1, U15.4
BUCK5_SW: C6.2, L2.1, U15.2
BUCK5_VIN: C26.1, C40.1, F1.1, U15.3
BUCKSV_BST: C30.1, U6.6
BUCKSV_EN: R17.2, R24.2, U6.5
BUCKSV_FB: R22.2, R23.1, U6.4
BUCKSV_SW: C30.2, L3.1, U6.2
BUCKSV_VIN: C29.1, C41.1, F2.1, U6.3
GND: C1.2, C2.2, C3.2, C4.2, C5.2, C7.2, C8.2, C9.2, C10.2, C11.2, C12.2, C13.2, C14.2, C15.2, C16.2, C17.2, C18.2, C19.2, C20.2, C21.2, C22.2, C23.2, C24.2, C25.2, C26.2, C27.2, C28.2, C29.2, C31.2, C32.2, C33.2, C34.2, C35.2, C36.2, C37.2, C38.2, C39.2, C40.2, C41.2, C42.2, CARD1.6, CARD1.10, CARD1.11, CARD1.12, CARD1.13, CN1.1, CN2.0, CN2.1, D1.2, H1.2, H1.6, H1.11, H1.14, H2.2, R6.2, R12.2, R13.2, R15.2, R17.1, R23.2, SW2.3, SW2.4, U1.62, U1.81, U2.2, U2.5, U2.6, U2.15, U2.16, U2.17, U2.18, U2.25, U3.1, U3.5, U3.7, U4.1, U4.2, U4.7, U5.2, U5.3, U5.9, U5.12, U6.1, U7.2, U8.3, U9.3, U10.3, U11.3, U12.2, U12.4, U13.3, U14.4, U15.1, USBC1.1, USBC1.2, USBC1.3, USBC1.4, USBC1.A1B12, USBC1.B1A12
HDR_GPIO12: H1.13, U1.11
HDR_GPIO34: H1.10, U1.43
HDR_GPIO35: H1.9, U1.44
HDR_GPIO36: H1.8, U1.45
HDR_GPIO37: H1.7, U1.46
I2C_SCL: CN2.4, R26.1, U1.78, U2.19, U3.4, U4.5, U5.1
I2C_SDA: CN2.3, R25.1, U1.77, U2.20, U3.3, U4.4, U5.11
IMU_CAP: C27.1, U2.9
IMU_NRST: R9.1, U2.11
MAG_C1: C25.1, U5.4
PWR_EN: R14.1, R24.1, U13.2
QSPI_SCLK: U1.71, U14.6
QSPI_SD0: U1.72, U14.5
QSPI_SD1: U1.74, U14.2
QSPI_SD2: U1.73, U14.3
QSPI_SD3: U1.70, U14.7
QSPI_SS: R11.1, U1.75, U14.1
RUN: C28.1, R16.2, U1.35
SD_CD: CARD1.9, U1.12
SD_CLK: CARD1.5, U1.8
SD_CMD_MOSI: CARD1.3, U1.9
SD_CS: CARD1.2, R21.2, U1.7
SD_DAT0_MISO: CARD1.7, R18.2, U1.6
SD_DAT1: CARD1.8, R19.2
SD_DAT2: CARD1.1, R20.2
SERVO1_PWM: U1.52, U8.1
SERVO2_PWM: U1.48, U9.1
SERVO3_PWM: U1.47, U10.1
SERVO4_PWM: U1.49, U11.1
SWCLK: H1.4, H2.1, U1.33
SWDIO: H1.3, H2.3, U1.34
USBC_DN: D1.1, D1.6, R8.2, USBC1.A7, USBC1.B7
USBC_DP: D1.3, D1.4, R7.2, USBC1.A6, USBC1.B6
USB_CC1: R12.1, USBC1.A5
USB_CC2: R13.1, USBC1.B5
USB_DN: R8.1, U1.66
USB_DP: R7.1, U1.67
VBAT: CN1.2, R10.1, U4.8, U4.10
VBAT_SHUNT: F1.2, F2.2, R10.2, U4.9, U13.1
VBUS: D1.5, D2.2, USBC1.A4B9, USBC1.B4A9
VREG_AVDD: C3.1, C7.1, R2.1, U1.61
VREG_LX: L1.1, U1.63
VSERVO: C31.1, C32.1, L3.2, R22.1, U8.2, U9.2, U10.2, U11.2
XIN: C1.1, U1.30, U12.1
XOUT: R1.1, U1.31
XOUT_R: C2.1, R1.2, U12.3
