swaroopsahoo4908/GTR70E-WYVERN/Past Iterations/WYVERN-E KiCad/FC100/WYVERN-E_FC100.kicad_pcb

## KiCad design Past Iterations/WYVERN-E KiCad/FC100/WYVERN-E_FC100.kicad_pcb (2026-10-14)

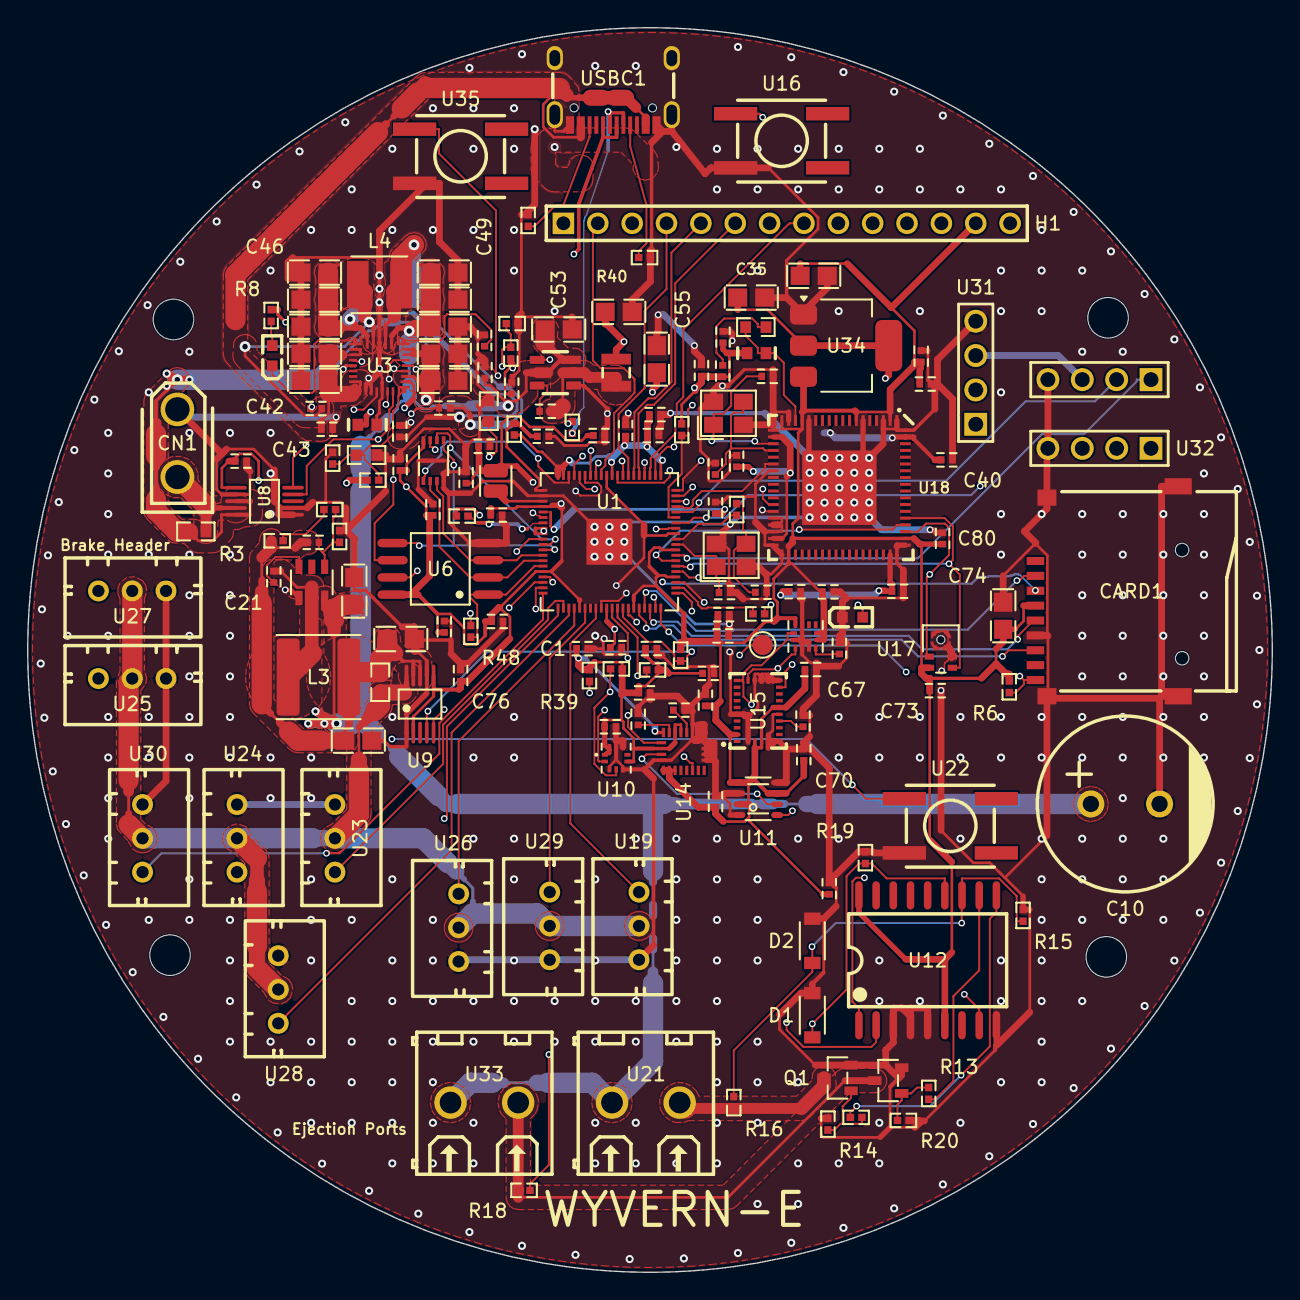
[picture p202: board WYVERN-E_FC100.kicad_pcb from above]

Board: 4 copper layers, 92.0 x 92.0 mm, 170 parts (0 on the bottom side), 114 nets.

Parts:
C1, C11, C12, C13, C14, C16, C19, C20, C21, C22, C24, C25, C26, C27, C28, C29, C30, C31, C32, C33, C37, C38, C39, C40, C43, C50, C63, C64, C65, C66, C67, C68, C69, C70, C71, C72, C73, C75, C76, C77, C78, C79, C80, C81, C82: 100nF; C0402
C2, C3: 15pF; C0402
C4, C5: 18pF; C0402
C6: 1nF 50V; C0402
C7: 4.7uF 16V; C0603
C8: 150pF NP0; C0603
C9: 5.6nF; C0402
C10: 2200uF 25V; CAP-TH_BD13.0-P5.00-D1.2-FD
C17, C18: 47nF 50V; C0402
C23: 10nF; C0402
C35, C55, C56, C57, C58: 22uF; C0805
C36, C41, C42, C44, C45, C46, C47, C48, C49, C51, C52, C53, C54, C74: 10uF; C0805
C59: 75pF; C0402
C60, C61, C62: 4.7uF; C0402
CARD1: TF-01A; TF-SMD_TF-01A
CN1: XT30UPB-M; CONN-TH_XT30UPB-M
D1, D2: BZT52C3V3; SOD-123_L2.7-W1.6-LS3.7-RD
H1: 2011-1X14G00SB; HDR-TH_14P-P2.54-V-M_4
L1: 3.3uH; L_Wuerth_PMFI-201610
L2: 2.2uH; IND-SMD_L2.5-W2.0_MHCHL2520
L3: 10uH; L_Sunlord_SWPA6045S
L4: 2.2uH; IND-SMD_L4.0-W4.0
LED1, LED2: KT-0603R; LED-SMD_L1.6-W0.8-R-RD
MH1, MH2, MH3, MH4: MountingHole
Q1, Q2: AO3400A; SOT-23-3_L2.9-W1.3-P1.90-LS2.4-BR
R1: 10k NTC; R0603
R2, R16, R18: 33k; R0402
R3, R7: 10mΩ; R0603
R4: 47k; R0402
R5: 27k; R0402
R6: 20k; R0402
R8: 2.2k; R0402
R9: 330; R0402
R10: 4.3k; R0603
R11, R13, R47, R48: 1k; R0402
R12: 8.2k; R0603
R14, R15, R17, R19, R20, R31, R32: 10k; R0402
R36, R37, R38, R39: 4.7k; R0402
R40, R41, R44: 5.1k; R0402
R42, R43: 27; R0402
R45: 30k; R0402
R46: 33; R0402
TP1: SWCLK; TestPoint_Pad_D1.5mm
U1: RP2350B; QFN-80_L10.0-W10.0-P0.40-TL-EP3.4
U3: BQ25798RQMR; QFN-29_L4.0-W4.0-P0.40-TL-BQ25792RQMR
U4: TPS563201DDCR; SOT-23-6_L2.9-W1.6-P0.95-LS2.8-BR
U5: TPS54202DDCR; SOT-23-6_L2.9-W1.6-P0.95-LS2.8-BL
U6: W25Q128JVSIQ; SOIC-8_L5.3-W5.3-P1.27-LS8.0-BL
U7: APS6404L-3SQR-ZR; USON-8_L3.0-W2.0-P0.50-BL-EP
U8, U9: INA226AIDGSR; MSOP-10_L3.0-W3.0-P0.50-LS5.0-BL
U10: LPS22HBTR; HLGA-10L_LPS22HBTR
U11: BME680; LGA-8_L3.0-W3.0-P0.80-TR
U12: MCP23008-E/SO; SOIC-18_L11.6-W7.5-P1.27-LS10.3-BL
U13: LIS3MDLTR; LGA-12_L2.0-W2.0-P0.50-BL
U14: LSM9DS1TR; LGA-24_L3.5-W3.0-P0.43-TL
U15: BNO055; LGA-28_L5.2-W3.8-P0.50-BL
U16, U22: EVQ-Q2P02W; SW-SMD_4P-L6.5-W6.0-P4.00-LS6.6-TL
U17: IM63D135AXTMA1; MIC-SMD_5P-L3.5-W2.7_IM66D130AXTMA1
U18: ADAU1450WBCPZ-RL; LFCSP-72_L10.0-W9.8-P0.50-LS10.2-TL-EP5.5
U19, U23, U24, U25, U26, U27, U28, U29, U30: B3B-XH-A(LF)(SN); CONN-TH_3P-P2.50_A2501WV2-3P
U20, U31, U32: 2.54-1*4; HDR-TH_4P-P2.54-V-M-1
U21, U33: KF128-5.0-2P; CONN-TH_P5.00_KF128-5.0-2P
U34: AMS1117-1.2; SOT-223-3_TabPin2
U35: BOOTSEL; SW-SMD_4P-L6.5-W6.0-P4.00-LS6.6-TL
USBC1: TYPE-C-31-M-12; USB-C_SMD-TYPE-C-31-M-12_1
X1: 12MHz; CRYSTAL-SMD_4P-L3.2-W2.5-BL
X2: 12.288MHz; CRYSTAL-SMD_4P-L3.2-W2.5-BL

Connections:
+1V1_DVDD: C11.1, C12.1, C13.1, C14.1, C62.1, L1.2, U1.10, U1.32, U1.51, U1.65
+1V2_DSP: C35.1, C37.1, C38.1, C39.1, C40.1, U18.20, U18.35, U18.53, U18.71, U34.2
+3V3: C1.1, C8.1, C9.1, C16.1, C26.1, C27.1, C28.1, C29.1, C30.1, C31.1, C32.1, C33.1, C36.1, C55.1, C56.1, C61.1, C63.1, C64.1, C65.1, C66.1, C67.1, C68.1, C69.1, C70.1, C71.1, C72.1, C73.1, C74.1, C75.1, C76.1, C77.1, C78.1, C79.1, C80.1, C81.1, C82.1, CARD1.4, H1.13, L2.2, R2.1, R6.2, R17.2, R36.2, R37.2, R38.2, R39.2, R46.1, U1.5, U1.15, U1.24, U1.29, U1.41, U1.50, U1.59, U1.60, U1.64, U1.68, U1.69, U1.76, U6.8, U7.8, U8.6, U9.2, U9.6, U10.1, U10.6, U10.10, U11.2, U11.6, U11.8, U12.6, U12.18, U13.5, U13.6, U13.10, U14.1, U14.3, U14.6, U14.7, U14.8, U14.22, U14.23, U15.3, U15.4, U15.11, U15.28, U17.1, U18.2, U18.7, U18.15, U18.18, U18.38, U18.56, U20.3, U31.3, U34.3
AUX_P1: U1.28, U20.1
AUX_P2: U1.36, U20.2
BOOTSEL_SW: R48.2, U35.1
BQ_PROG: R12.1, U3.20
BQ_REGN: C7.1, R8.2, R44.1, U3.5, U3.17
BQ_SW1: C17.2, L4.2, U3.28
BQ_SW2: C18.2, L4.1, U3.26
BUCK3V3_FB: R2.2, R31.1, U4.4
BUCK3V3_SW: C20.2, L2.1, U4.2
BUCKSV_FB: C59.2, R5.2, R32.1, U5.4
BUCKSV_SW: C21.2, L3.1, U5.2
BUCK_SV_FB_MID: R4.2, R5.1
DSP_LRCLK: U1.27, U18.58
DSP_PLLFILT: C8.2, R10.1, U18.16
DSP_RESET: U1.37, U18.24
DSP_XTALIN: C5.1, U18.21, X2.1
DSP_XTALOUT: C4.1, U18.22, X2.3
GND: C1.2, C2.2, C3.2, C4.2, C5.2, C6.2, C7.2, C10.2, C11.2, C12.2, C13.2, C14.2, C16.2, C19.2, C22.2, C23.2, C24.2, C25.2, C26.2, C27.2, C28.2, C29.2, C30.2, C31.2, C32.2, C33.2, C35.2, C36.2, C37.2, C38.2, C39.2, C40.2, C41.2, C42.2, C43.2, C44.2, C45.2, C46.2, C47.2, C48.2, C49.2, C50.2, C51.2, C52.2, C53.2, C54.2, C55.2, C56.2, C57.2, C58.2, C60.2, C61.2, C62.2, C63.2, C64.2, C65.2, C66.2, C67.2, C68.2, C69.2, C70.2, C71.2, C72.2, C73.2, C74.2, C75.2, C76.2, C77.2, C78.2, C79.2, C80.2, C81.2, C82.2, CARD1.6, CARD1.10, CARD1.11, CARD1.12, CARD1.13, CN1.1, D1.2, D2.2, LED1.2, Q1.2, Q2.2, R1.2, R12.2, R14.2, R15.2, R19.2, R20.2, R31.2, R32.2, R40.2, R41.2, R45.2, U1.62, U1.81, U3.10, U3.11, U3.13, U3.27, U4.1, U5.1, U6.4, U7.4, U7.9, U8.1, U8.2, U8.7, U9.1, U9.7, U10.3, U10.5, U10.8, U10.9, U11.1, U11.5, U11.7, U12.3, U12.4, U12.5, U12.9, U13.2, U13.3, U13.9, U13.12, U14.5, U14.14, U14.15, U14.16, U14.17, U14.18, U14.19, U14.20, U15.2, U15.5, U15.6, U15.10, U15.15, U15.16, U15.17, U15.18, U15.25, U16.3, U17.4, U17.5, U18.1, U18.3, U18.6, U18.14, U18.17, U18.19, U18.25, U18.32, U18.33, U18.34, U18.36, U18.37, U18.54, U18.55, U18.72, U18.73, U19.3, U20.4, U22.3, U23.3, U24.3, U25.3, U26.3, U27.3, U28.3, U29.3, U30.3, U31.4, U32.4, U34.1, U35.3, USBC1.1, USBC1.2, USBC1.3, USBC1.4, USBC1.A1B12, USBC1.B1A12, X1.2, X1.4, X2.2, X2.4
GPIO40_ADC0: U1.49, U32.3
GPIO43_ADC3: U1.54, U31.1
GPIO44_ADC4: U1.55, U31.2
GPIO45_ADC5: U1.56, U32.1
GPIO46_ADC6: U1.57, U32.2
HDR_P1: H1.1, U1.53
HDR_P2: H1.2, U1.52
HDR_P3: H1.3, U1.48
HDR_P4: H1.4, U1.47
HDR_P5: H1.5, U1.46
HDR_P6: H1.6, U1.45
HDR_P7: H1.7, U1.44
HDR_P8: H1.8, U1.43
HDR_P9: H1.9, U1.42
HDR_P10: H1.10, U1.40
HDR_P11: H1.11, U1.39
HDR_P12: H1.12, U1.38
I2C0_SCL_SENS: R37.1, U1.12, U10.2, U11.4, U13.1, U14.2, U15.19
I2C0_SDA_SENS: R36.1, U1.11, U10.4, U11.3, U13.11, U14.4, U15.20
I2C1_SCL: R39.1, U1.14, U3.14, U8.5, U9.5, U12.1, U18.31
I2C1_SDA: R38.1, U1.13, U3.15, U8.4, U9.4, U12.2, U18.30
LED1_A: LED1.1, R9.2
LED1_DRV: R9.1, U1.22
LED2_A: LED2.1, R8.1
Net-C9-Pad2: C9.2, R10.2
Net-C22-Pad1: C22.1, U13.4
Net-C24-Pad1: C24.1, U14.24
PDM_CLK: U1.25, U17.2, U18.57
PDM_DATA: U1.26, U17.3, U18.59
PSRAM_CS: U1.58, U7.1
PYRO1_CONT: D2.1, R15.1, R16.2, U12.12
PYRO1_DRV: R11.1, U12.10
PYRO1_GATE: Q1.1, R11.2, R14.1
PYRO1_OUT: Q1.3, R16.1, U21.2
PYRO2_CONT: D1.1, R18.2, R19.1, U12.13
PYRO2_DRV: R13.1, U12.11
PYRO2_GATE: Q2.1, R13.2, R20.1
PYRO2_OUT: Q2.3, R18.1, U33.2
QSPI_SCLK: U1.71, U6.6, U7.6
QSPI_SD0: U1.72, U6.5, U7.5
QSPI_SD1: U1.74, U6.2, U7.2
QSPI_SD2: U1.73, U6.3, U7.3
QSPI_SD3: U1.70, U6.7, U7.7
QSPI_SS_FLASH: R48.1, U1.75, U6.1
RUN: R17.1, U1.35, U16.1
SD_CD: CARD1.9, R6.1, U1.23
SD_CS: CARD1.2, U1.17
SD_MISO: CARD1.7, U1.16
SD_MOSI: CARD1.3, U1.19
SD_SCK: CARD1.5, U1.18
SERVO_U19: U1.8, U19.1
SERVO_U23: U1.2, U23.1
SERVO_U24: U1.1, U24.1
SERVO_U25: U1.79, U25.1
SERVO_U26: U1.4, U26.1
SERVO_U27: U1.78, U27.1
SERVO_U28: U1.3, U28.1
SERVO_U29: U1.6, U29.1
SERVO_U30: U1.80, U30.1
SWCLK: TP1.1, U1.33
SWDIO: H1.14, U1.34
U3_BTST1: C17.1, U3.4
U3_BTST2: C18.1, U3.19
U3_INT: U1.77, U3.21
U3_PMID: C19.1, C44.1, C45.1, C46.1, U3.29
U3_QON: U3.12, U22.1
U3_SDRV: C6.1, U3.24
U3_STAT: LED2.2, U3.1
U3_TS: R1.1, R44.2, R45.1, U3.16
U4_VBST: C20.1, U4.6
U5_BOOT: C21.1, U5.6
U12_INT: U1.20, U12.8
U14_CAP: C23.1, U14.21
U14_NT1_A: U1.9, U14.11
U15_CAP: C25.1, U15.9
U15_INT: U1.21, U15.14
USBC_CC1: R40.1, USBC1.A5
USBC_CC2: R41.1, USBC1.B5
USB_DN: R43.1, USBC1.A7, USBC1.B7
USB_DN_MCU: R43.2, U1.66
USB_DP: R42.1, USBC1.A6, USBC1.B6
USB_DP_MCU: R42.2, U1.67
VBAT: C51.1, C52.1, R3.1, U3.18, U3.22, U3.23, U8.8, U8.10
VBAT_RAW: CN1.2, R3.2, U8.9
VBUS: C41.1, C42.1, C43.1, U3.2, U3.3, U3.8, U3.9, USBC1.A4B9, USBC1.B4A9
VREG_AVDD: C60.1, R46.2, U1.61
VREG_LX: L1.1, U1.63
VSERVO: R7.1, U9.10, U19.2, U23.2, U24.2, U25.2, U26.2, U27.2, U28.2, U29.2, U30.2
VSERVO_PRE: C57.1, C58.1, C59.1, L3.2, R4.1, R7.2, U9.8, U9.9
VSYS: C10.1, C47.1, C48.1, C49.1, C50.1, C53.1, C54.1, U3.25, U4.3, U4.5, U5.3, U21.1, U33.1
XIN: C2.1, U1.30, X1.1
XOUT: R47.1, U1.31
XOUT_X: C3.1, R47.2, X1.3
