swaroopsahoo4908/GTR70E-WYVERN/Past Iterations/WYVERN-E KiCad/firmware/fc70_pins/fc70_board.h

#pragma once
// WYVERN-E FC-70 rev 3 -- RP2350B GPIO map, GENERATED from the KiCad netlist (do not hand-edit).
// Board: Generic RP2350 (arduino-pico). Net names match the schematic.

#define FC70_I2C_SDA             0
#define FC70_I2C_SCL             1
#define FC70_SD_DAT0_MISO        8
#define FC70_SD_CS               9
#define FC70_SD_CLK             10
#define FC70_SD_CMD_MOSI        11
#define FC70_HDR_GPIO12         12
#define FC70_SD_CD              13
#define FC70_HDR_GPIO34         34
#define FC70_HDR_GPIO35         35
#define FC70_HDR_GPIO36         36
#define FC70_HDR_GPIO37         37
#define FC70_SERVO3_PWM         38
#define FC70_SERVO2_PWM         39
#define FC70_SERVO4_PWM         40
#define FC70_SERVO1_PWM         41
